ArvidJoung/Plasma_Generator/4_Transformer/20190302_190649.jpg

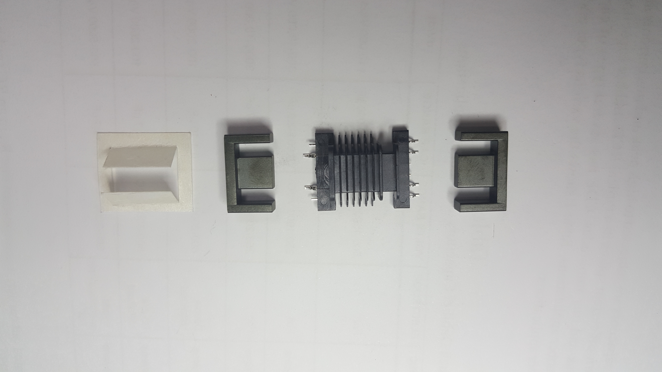
4_Transformer/20190302_190649.jpg
