ArvidJoung/Plasma_Generator/2_Micro_Plasma_Dispenser/0_DOC/20190724_ME Data/mpd_image-v2/asm-total-4.jpg

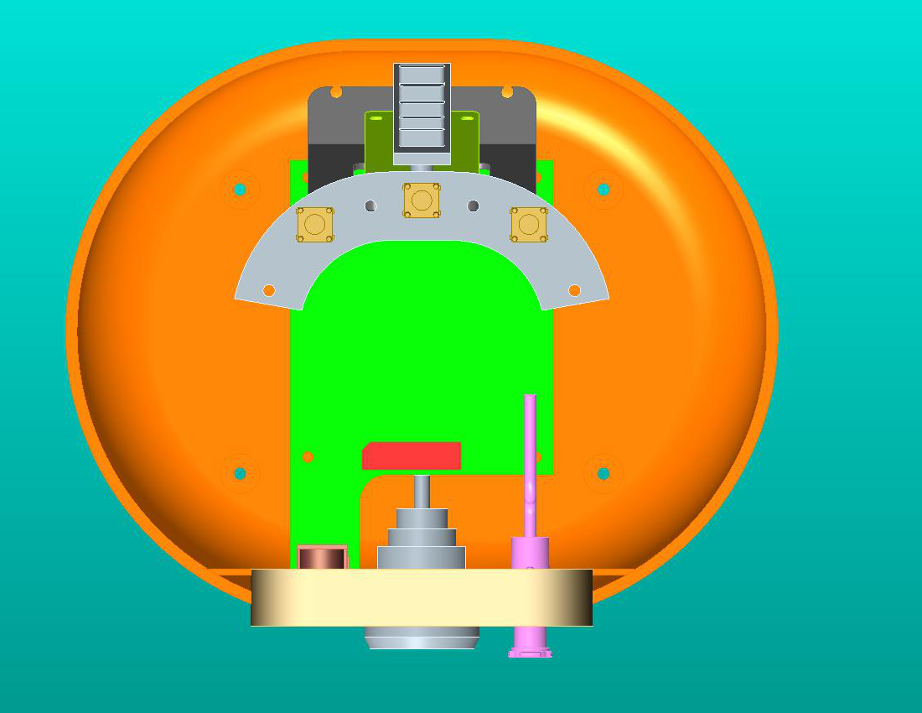
2_Micro_Plasma_Dispenser/0_DOC/20190724_ME Data/mpd_image-v2/asm-total-4.jpg
