ArvidJoung/Plasma_Generator/1_Plasma_Pipette/0_Block Diagram/Plasma_Pipette_Insulation Diagram.pptx

## 전기 절연도

USB 커넥터

+5V

충전 IC

배터리

+3.7V

+3.7V

전원 IC

+3.3V

CPU

Boost IC

+8V

신호발생부

+3.3V 70KHz Pulse

+8V 70KHz Pulse

트랜스

10kVpp

절연 케이스

전극부
