ArvidJoung/Plasma_Generator/1_Plasma_Pipette/4_Review data/ME Data/20180430/spec.pdf

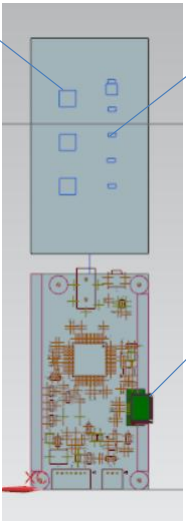
[picture p8: figure]

Dc power 위치 부탁 드립니다

마이크로 usb 위치는 맞나요?

태크 버튼

Led 5개

배터리 사이즈는 어느것으로 하는지요?

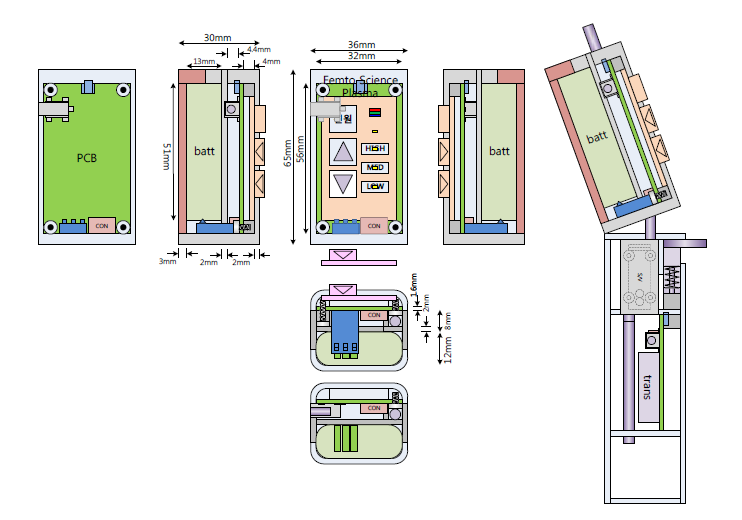
[picture p9: figure]

현 부품 배치 ?
