ArvidJoung/Plasma_Generator/0_DOC/20180206_Femto 요청자료/20180112_meeting agenda.pdf

협의 사항

M/E | Schematic V2.0으로 진행시 M/E part 반영 가능 여부 - Volume / Power key / Plasma key / Reset key
| M/E 구조에 따른 V2.0 수정 요청 사항 여부 - PCB size 및 외곽 모양 - 부품 높이
| Battery 형상 및 CON type 협의 - Battery size : L x W x H - Battery 용량 : size에 맞춰 결정해야 함 - Battery current : 1A 이상 - 사용품 사용시 사용품에 맞춰 CON 결정해야 함
H/W | RS-232 CON type 변경 여부 - D-Sub 9-pin : PCB size가 커짐 - USB Data line : RS-232 통신용 젠더 제작이 필요함
| 양산시 필요한 기능 - H/W version 관리 - D/L나 board test를 위한 Test Pin
F/W | RS-232 Control를 위한 Command list 필요
