ArvidJoung/Plasma_Generator/0_DOC/20180206_Femto 요청자료/Plasma_Gen_PCB 배치도_V2.0_20180107.pdf

## Top

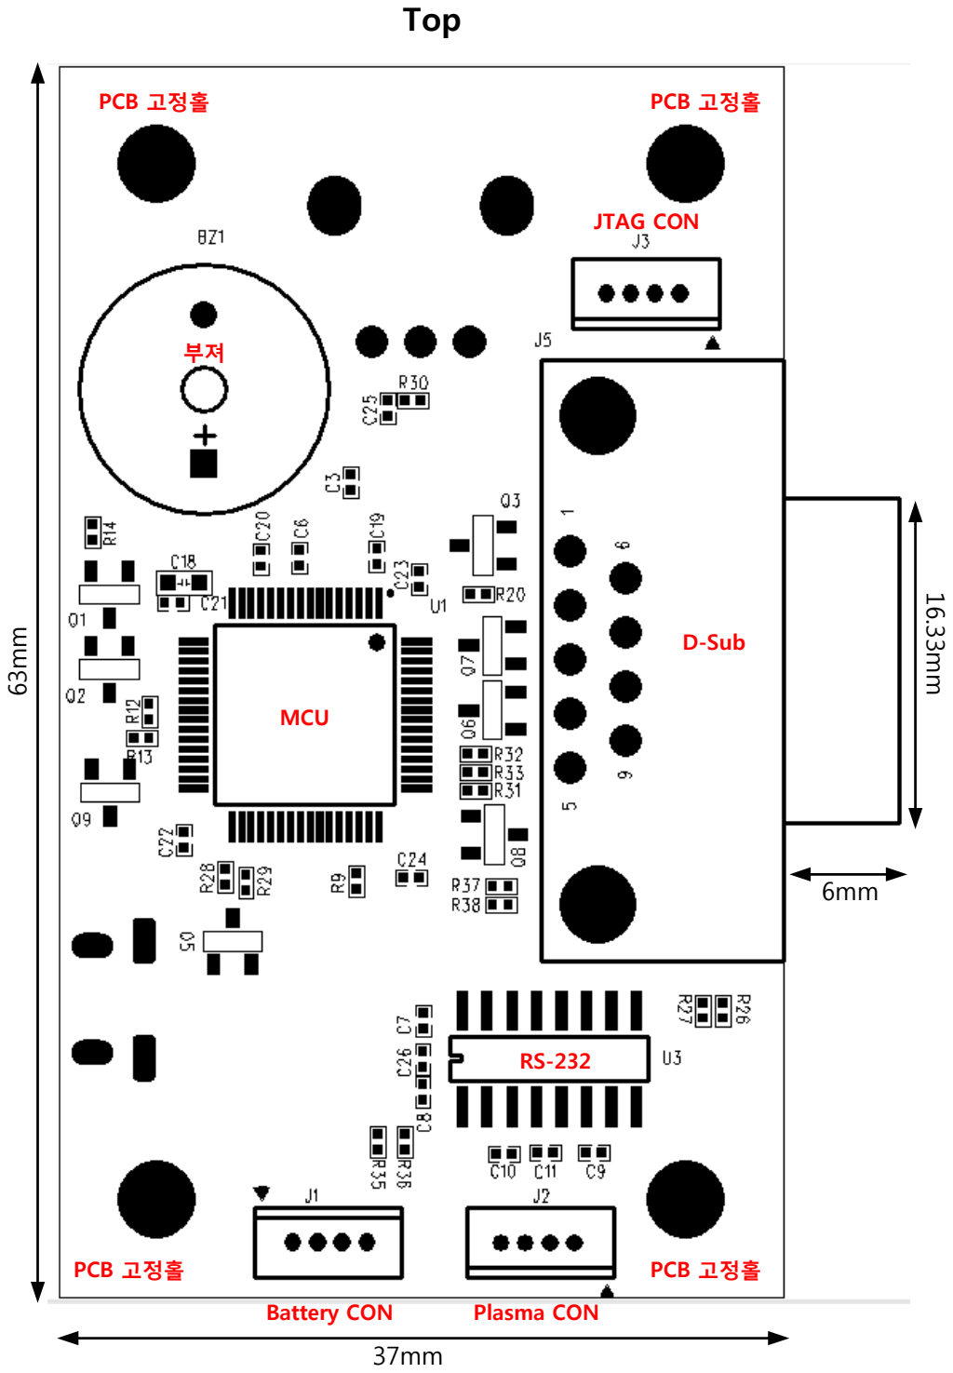
[picture p16: page 1]

MCU

부져

RS-232

D-Sub

Battery CON | Plasma CON

JTAG CON

PCB 고정홀 | PCB 고정홀
PCB 고정홀 | PCB 고정홀

37mm

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
## Bottom

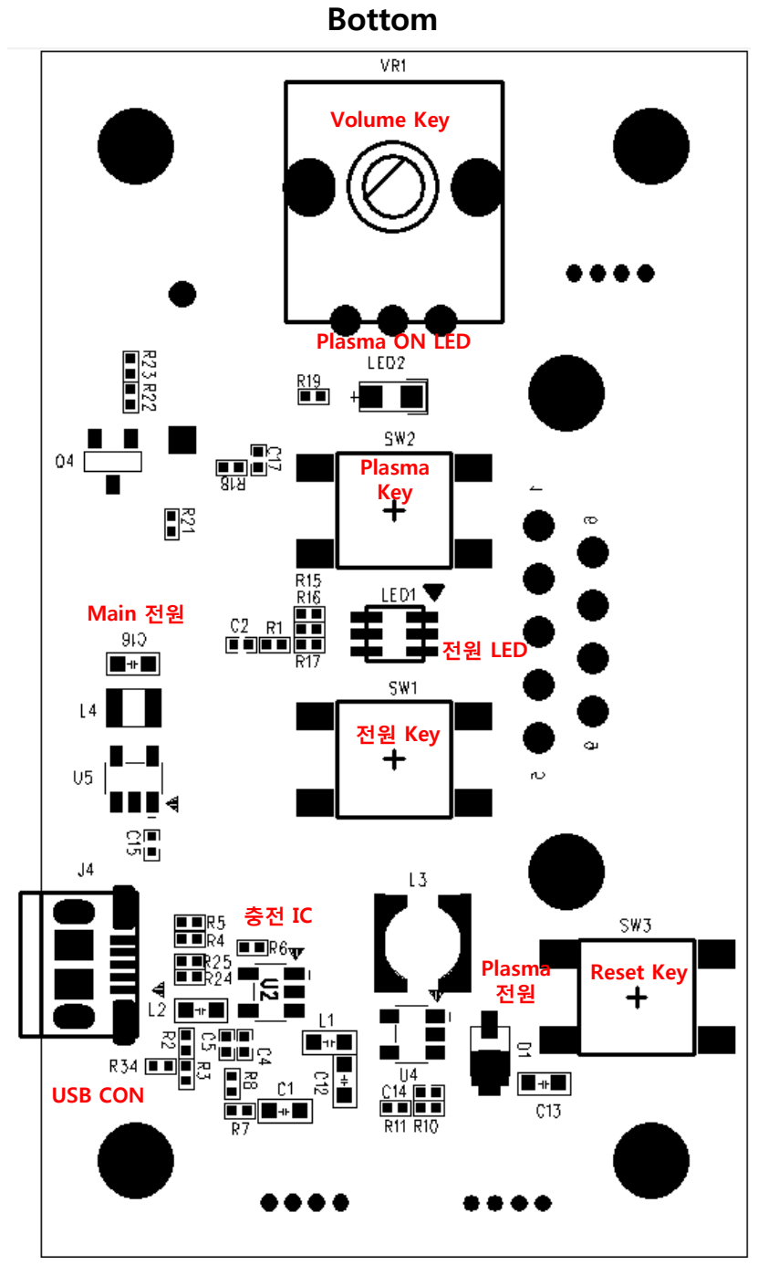
[picture p17: page 2]

Reset Key

전원 Key

전원 LED

Plasma
Key

Plasma ON LED

Volume Key

Main 전원

충전 IC

USB CON

Plasma
전원
