ArvidJoung/Plasma_Generator/0_DOC/20180206_Femto 요청자료/Plasma_Gen_부품 높이_20180111.pdf

# PCB 부품 높이 및 PCB 배치면

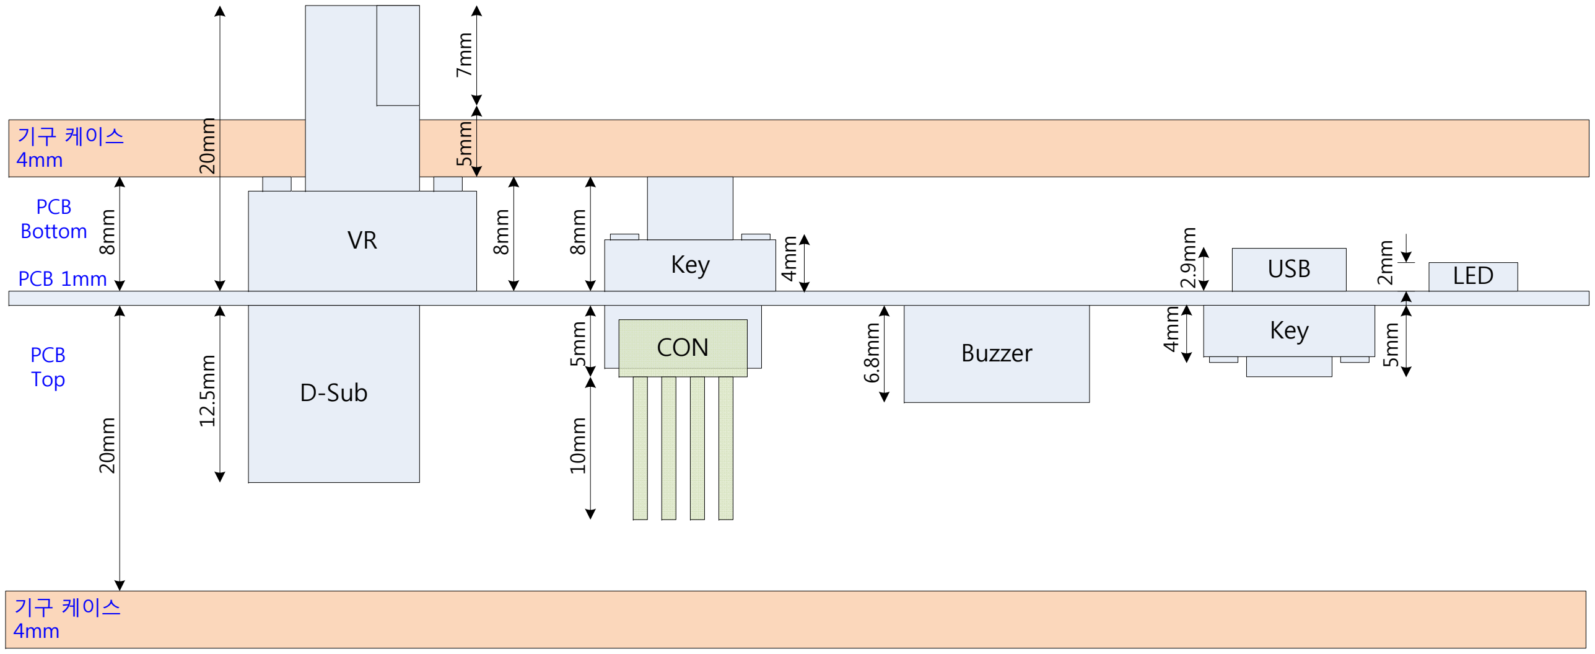
[picture p18: figure]
기구 케이스 4mm; D-Sub; USB; Key; CON; PCB 1mm; Buzzer; 2mm LED; PCB Bottom; PCB Top
