ArvidJoung/Plasma_Generator/0_Proto_type/4_Firmware/Source/doc/Plasma_Gen_배치도_20171207.pdf

## PCB 부품 높이 및 PCB 배치면

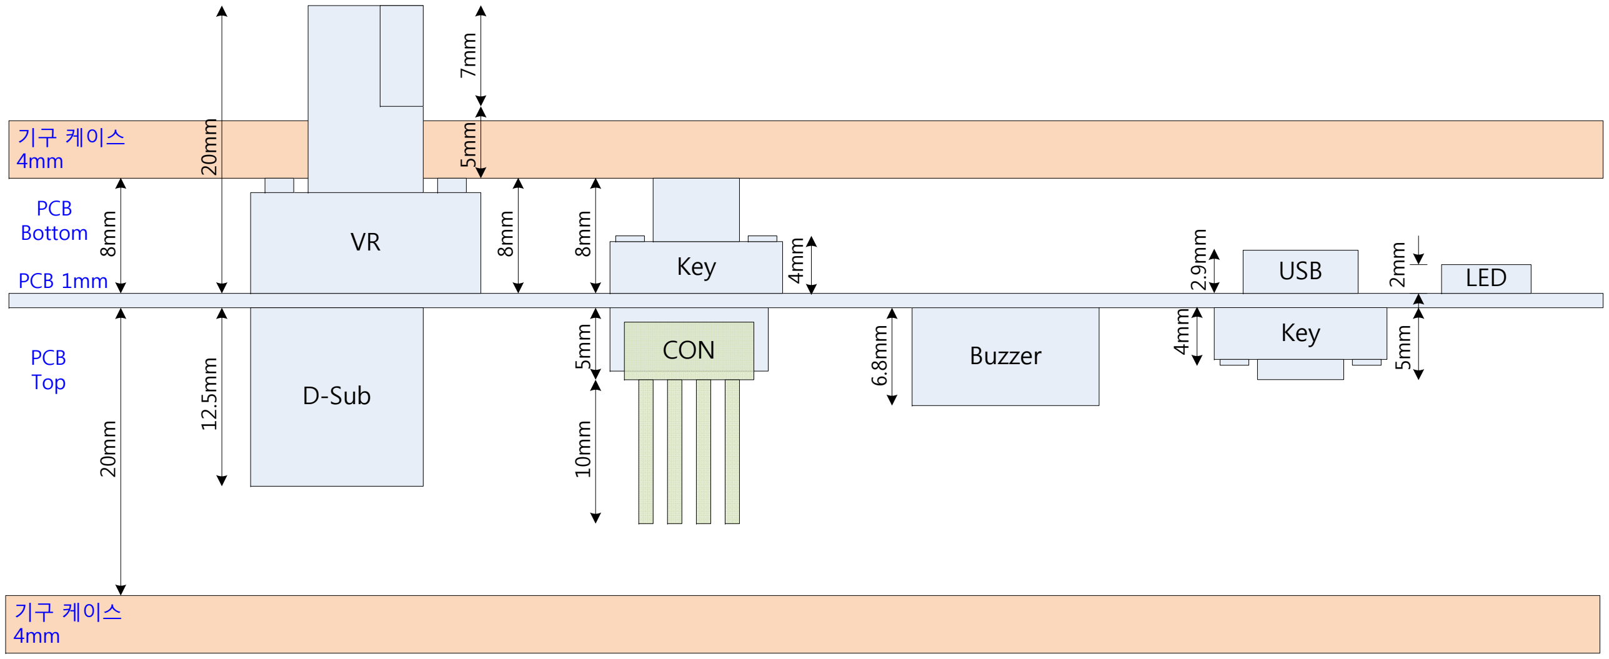
[picture p19: figure]
기구 케이스 4mm; D-Sub; USB; Key; CON; PCB 1mm; Buzzer; 2mm LED; PCB Bottom; PCB Top

## Top

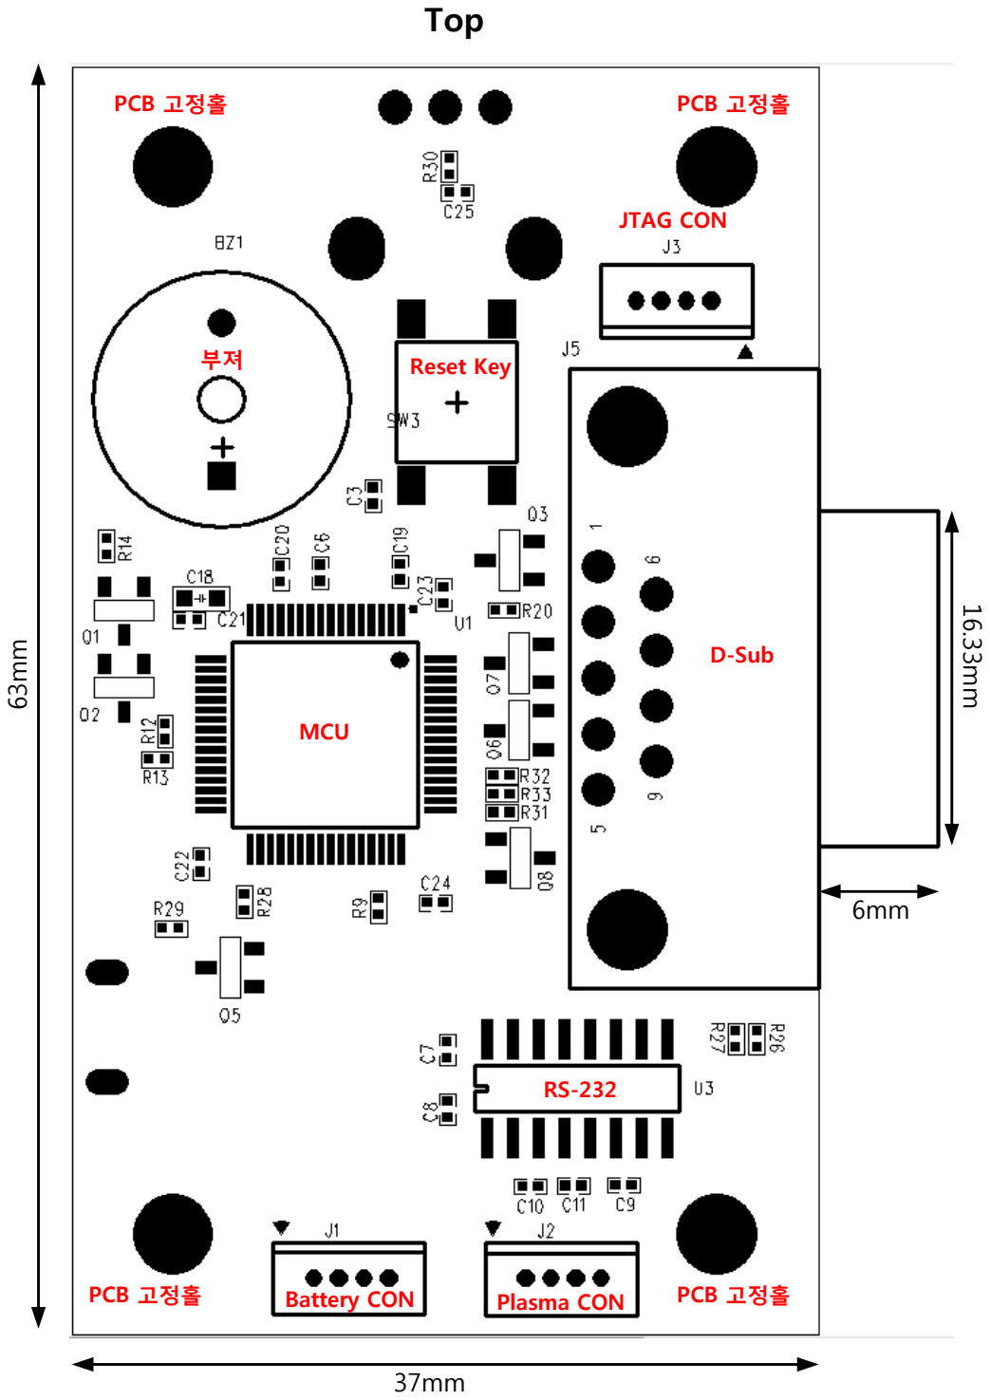
[picture p20: page 2]

MCU

부져

RS-232

D-Sub

Battery CON | Plasma CON

JTAG CON

Reset Key

PCB 고정홀 | PCB 고정홀
PCB 고정홀 | PCB 고정홀

37mm

63mm

6mm

16.33mm

## Bottom

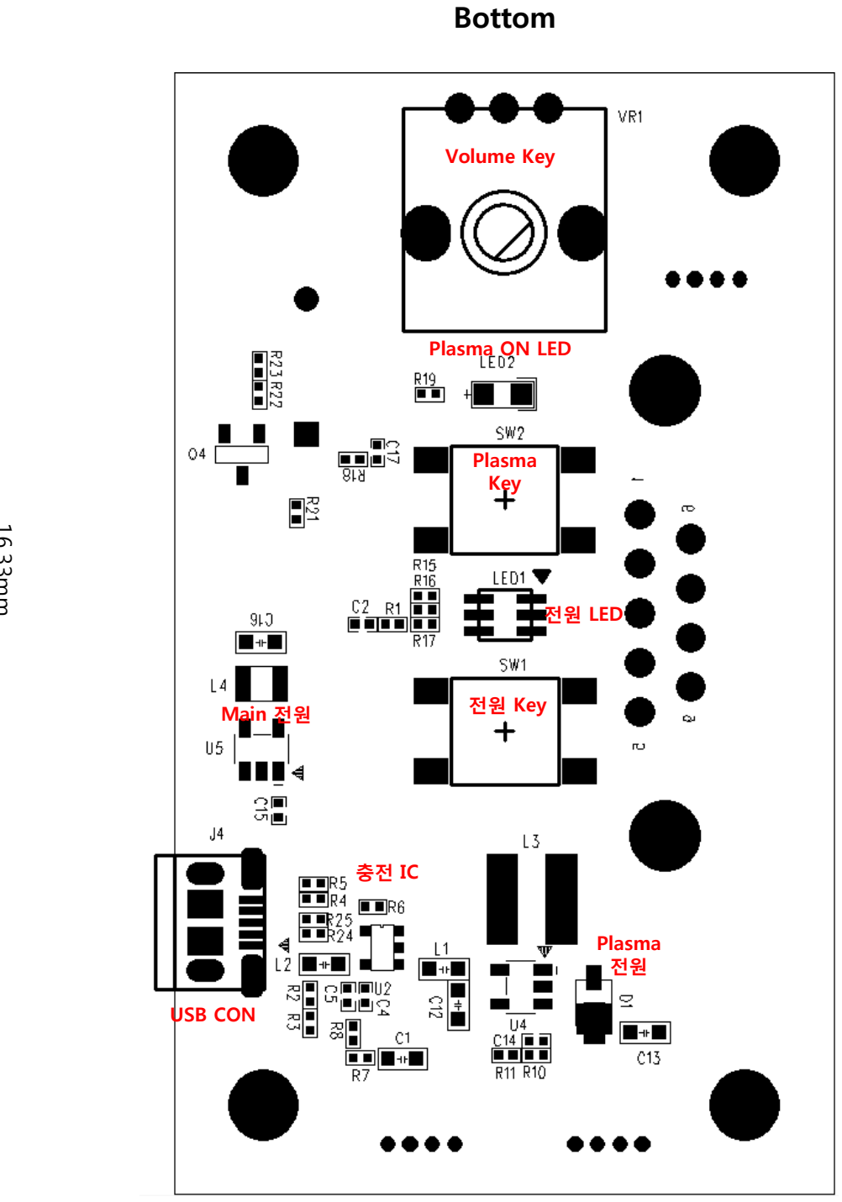
[picture p21: page 3]

전원 Key

전원 LED

Plasma
Key

Plasma ON LED

Volume Key

Main 전원

충전 IC

USB CON

Plasma
전원
