ArvidJoung/Plasma_Generator/2_Micro_Plasma_Dispenser/0_Design data/20190114/MPD design-0114 (디자인 2차 3D 프린팅).pptx

Design proposal
2019.01.14
MPD design

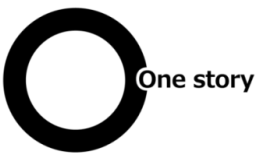
[picture p22: figure]

## Slide 2

MPD design - Q

## Slide 3

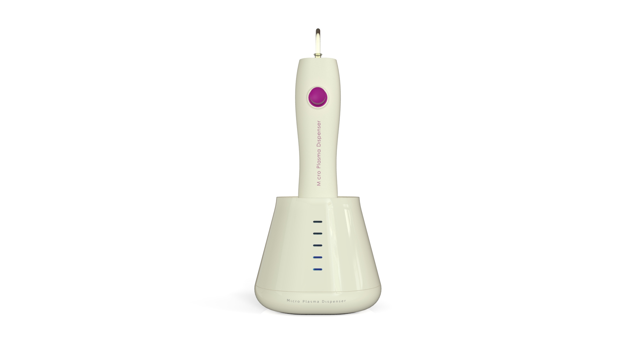
[picture p23: figure]

## Slide 4

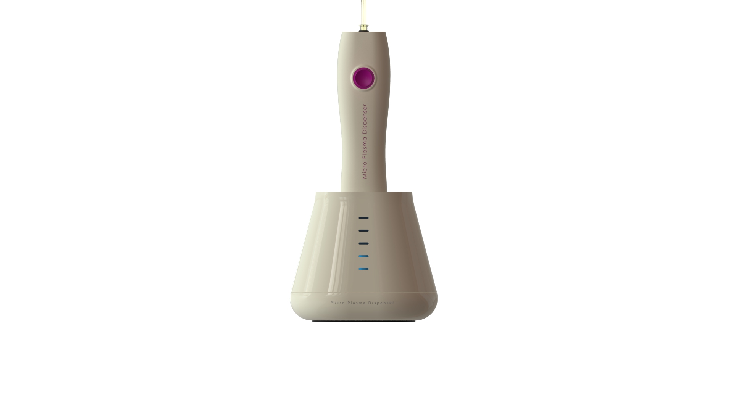
[picture p24: figure]

## Slide 5

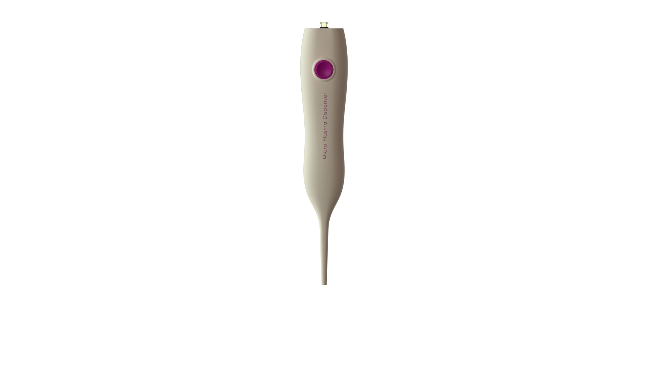
[picture p25: figure]

## Slide 6

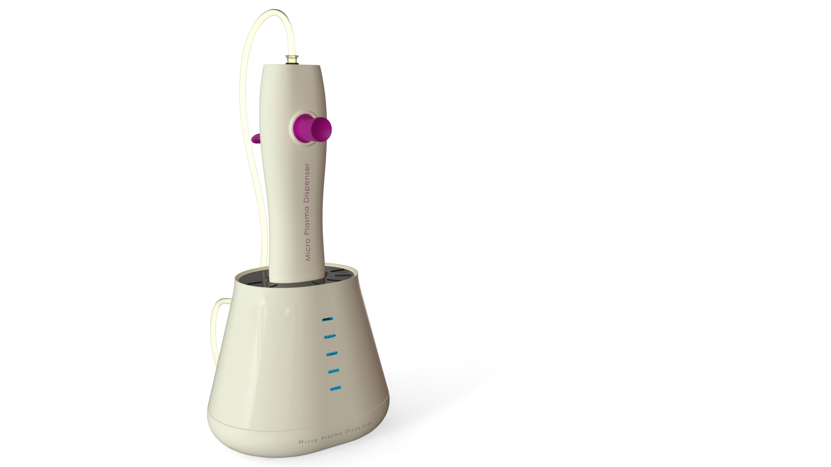
[picture p26: figure]

## Slide 7

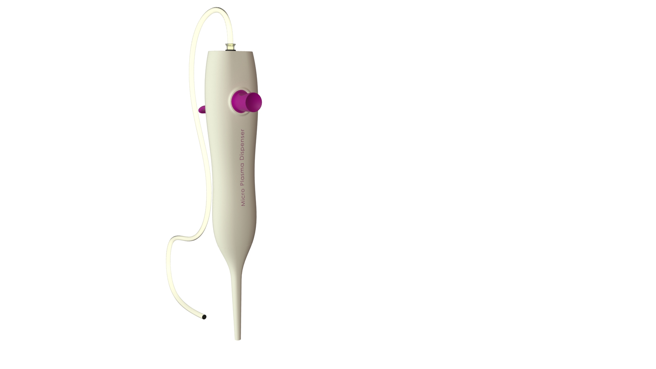
[picture p27: figure]

## Slide 8

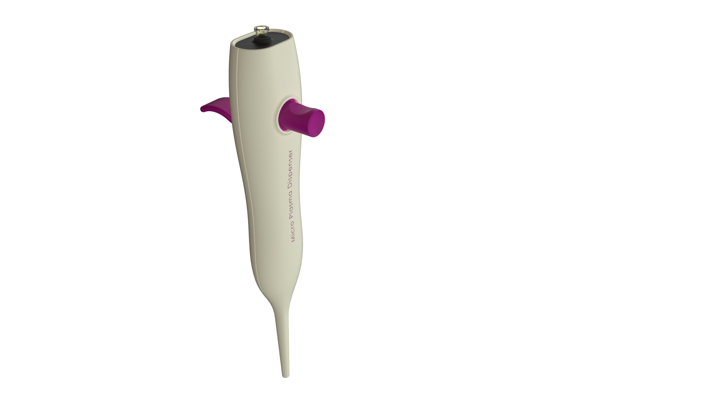
[picture p28: figure]

## Slide 9

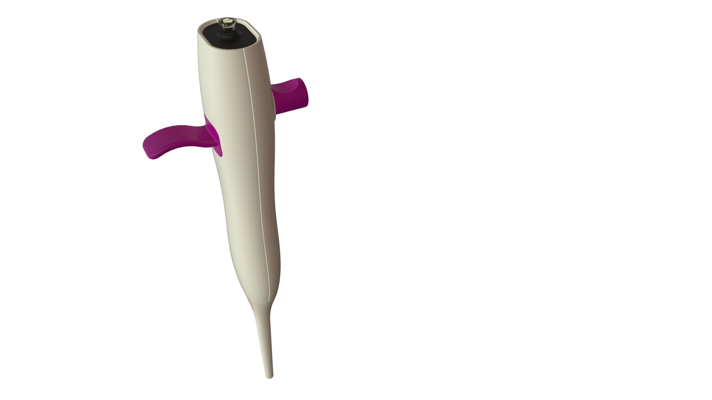
[picture p29: figure]

## Slide 10

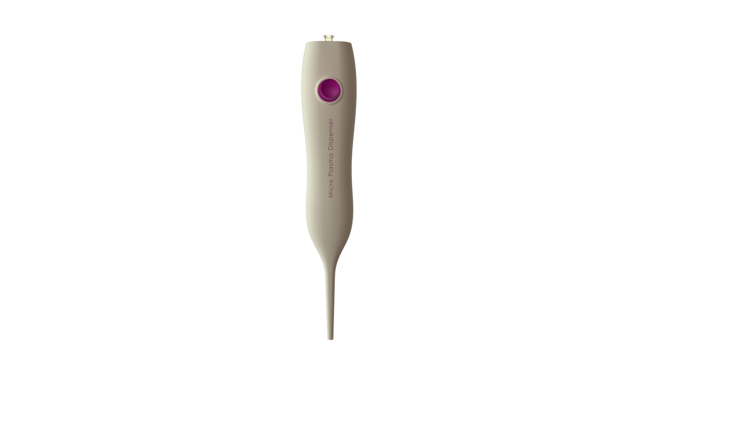
[picture p30: figure]

## Slide 11

T H A N K Y O U
