ArvidJoung/Plasma_Generator/0_Proto_type/4_Firmware/Source/doc/문서1.docx

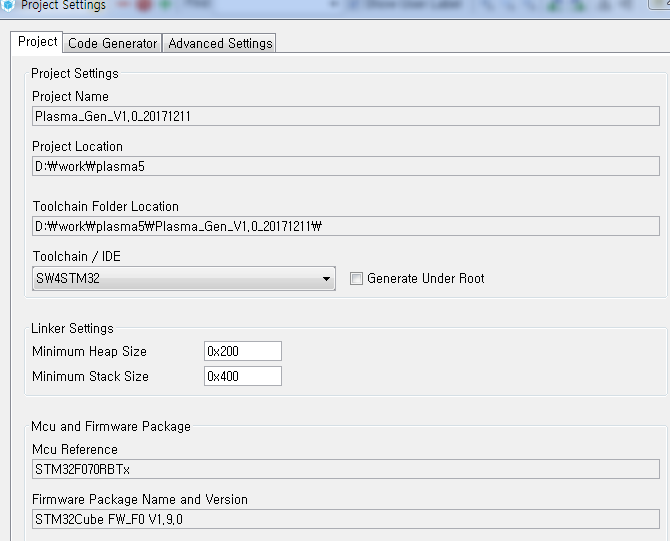
[picture p31: figure]
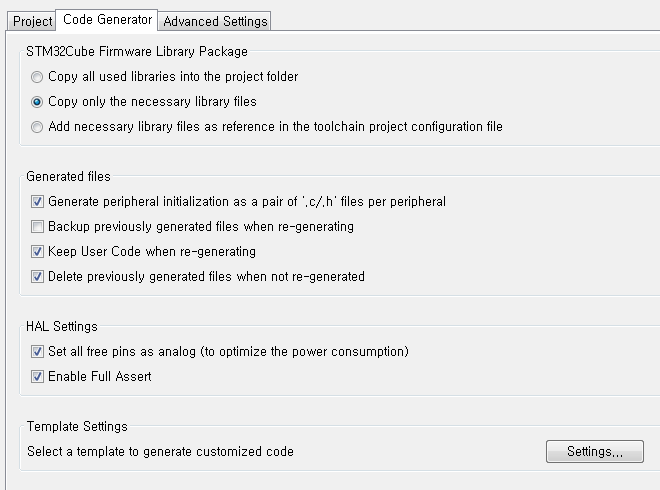
[picture p32: figure]
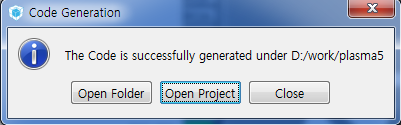
[picture p33: figure]
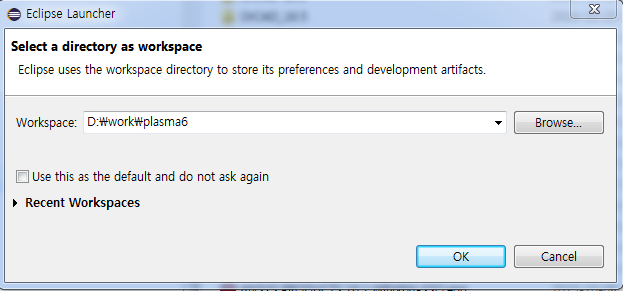
[picture p34: figure]
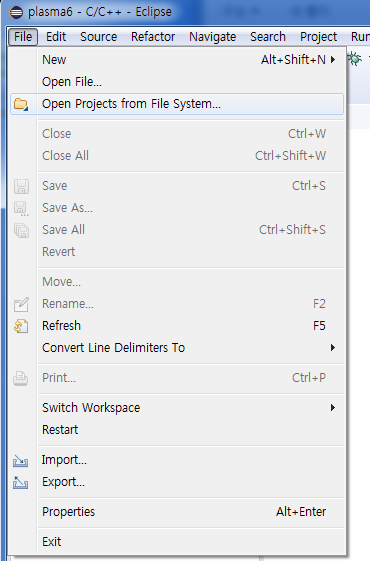
[picture p35: figure]
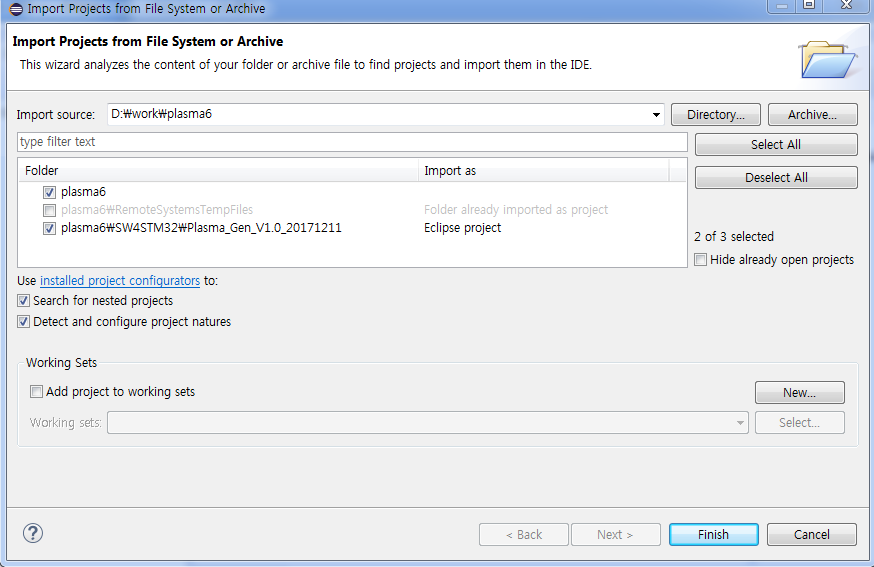
[picture p36: figure]
