ArvidJoung/Plasma_Generator/1_Plasma_Pipette/1_Schematic/V2.0/ME/20180725_Trans PCB 확장/ay_total_plasma.pdf

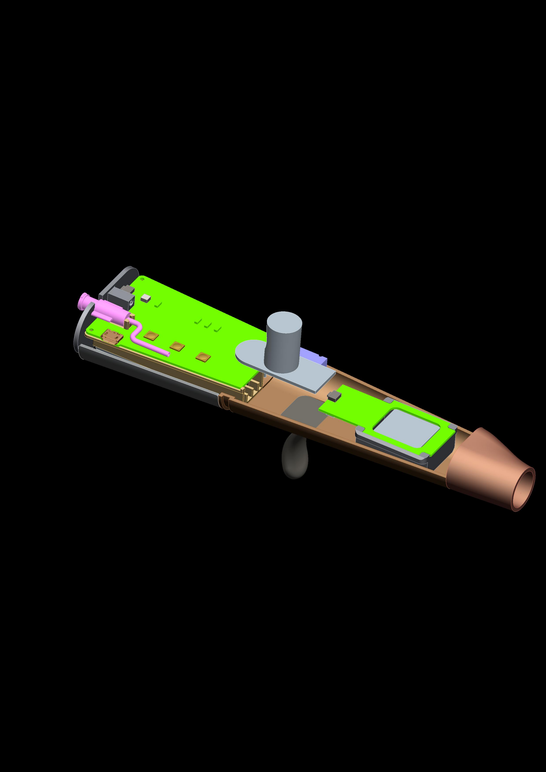
[picture p37: page 1]
