ArvidJoung/Plasma_Generator/0_DOC/0_Femto Data/사업자등록증 _동탄.pdf

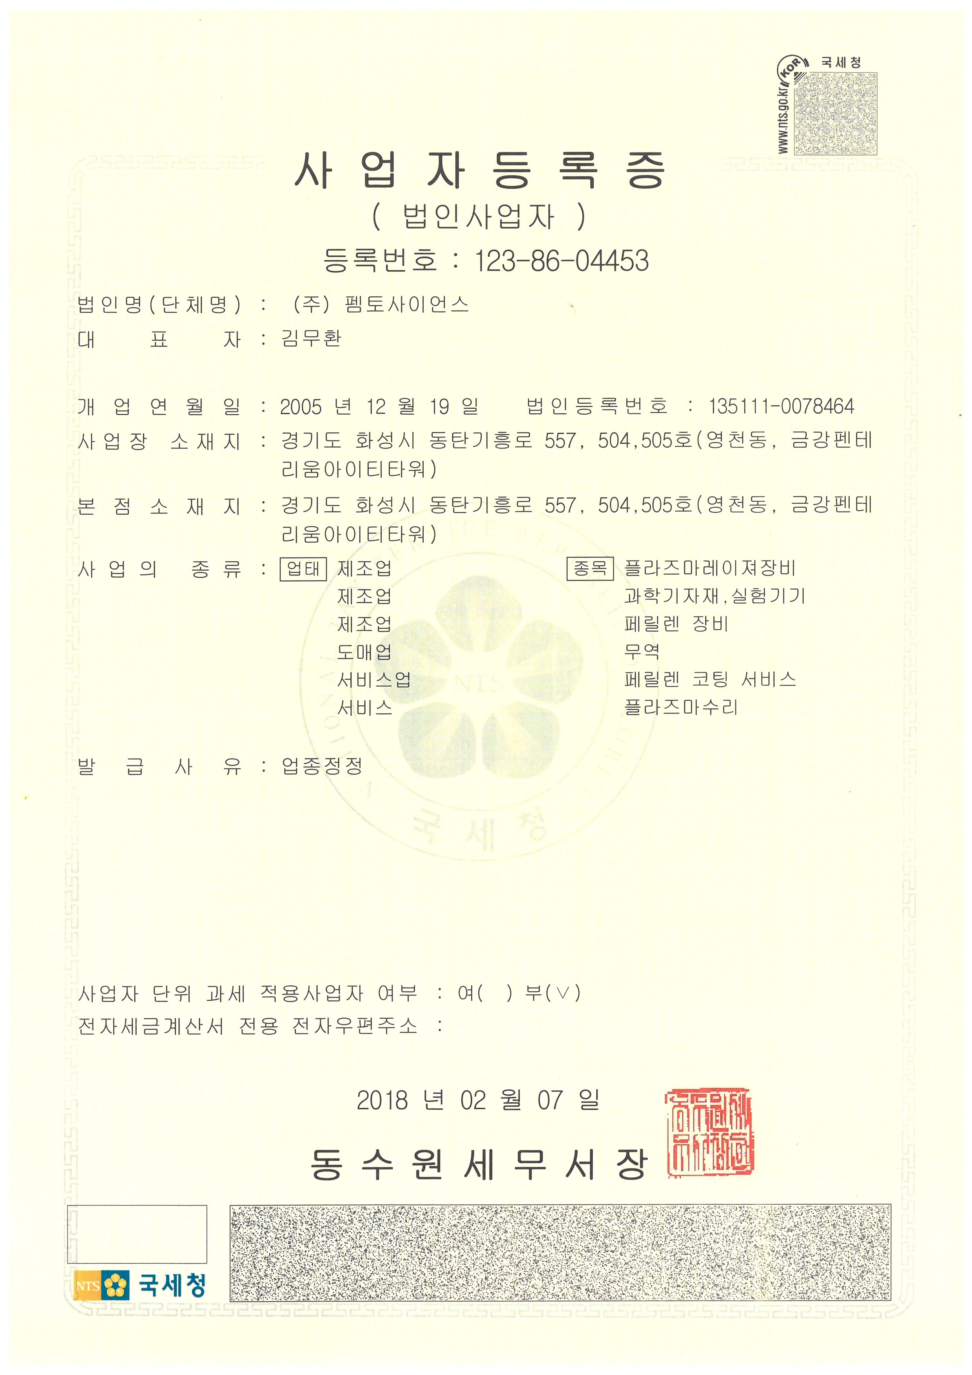
[picture p38: page 1]
