ArvidJoung/Plasma_Generator/1_Plasma_Pipette/1_Schematic/V2.0/ME/20180730_Battery 2D/Pipette Battery 도면 수정.png

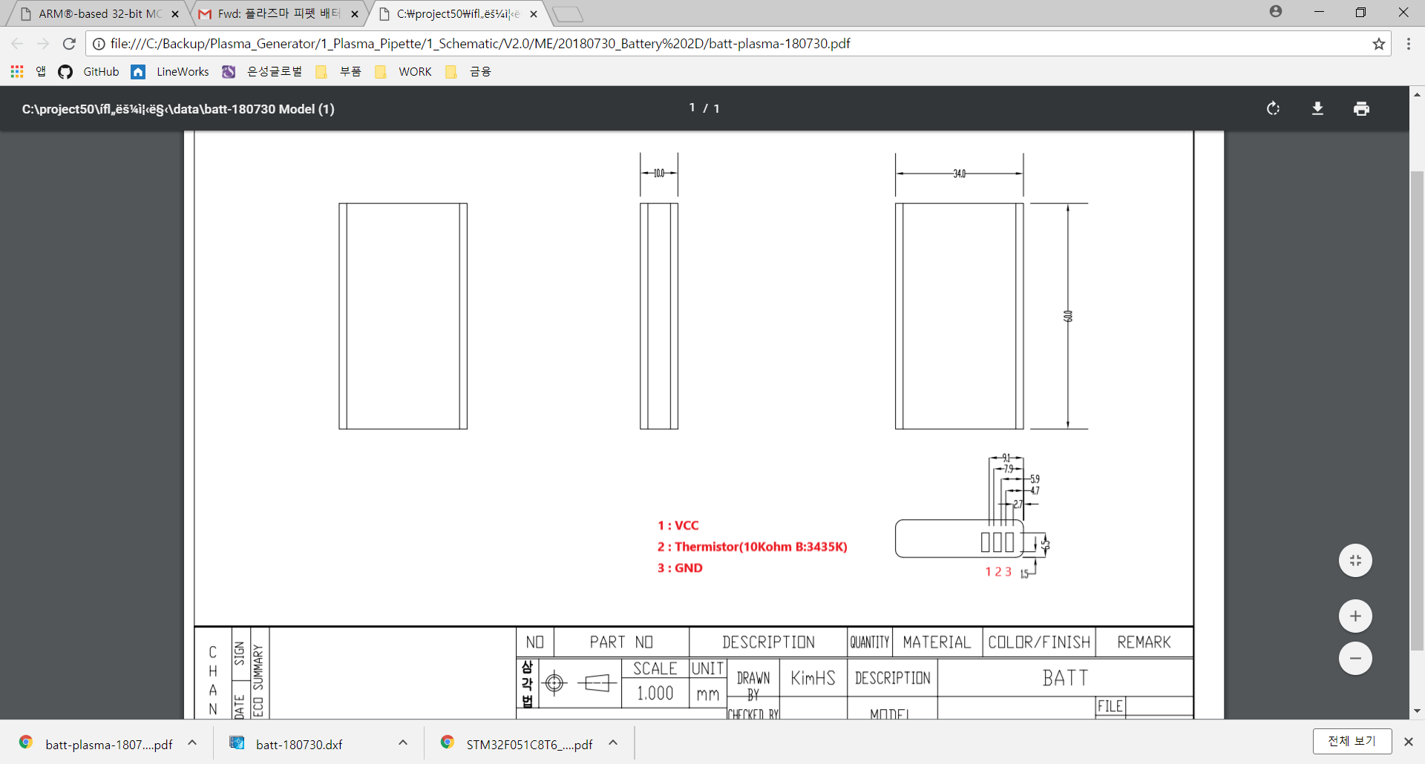
1_Plasma_Pipette/1_Schematic/V2.0/ME/20180730_Battery 2D/Pipette Battery 도면 수정.png
