ArvidJoung/Plasma_Generator/1_Plasma_Pipette/1_Schematic/V2.0_Type2/51021 커넥터.png

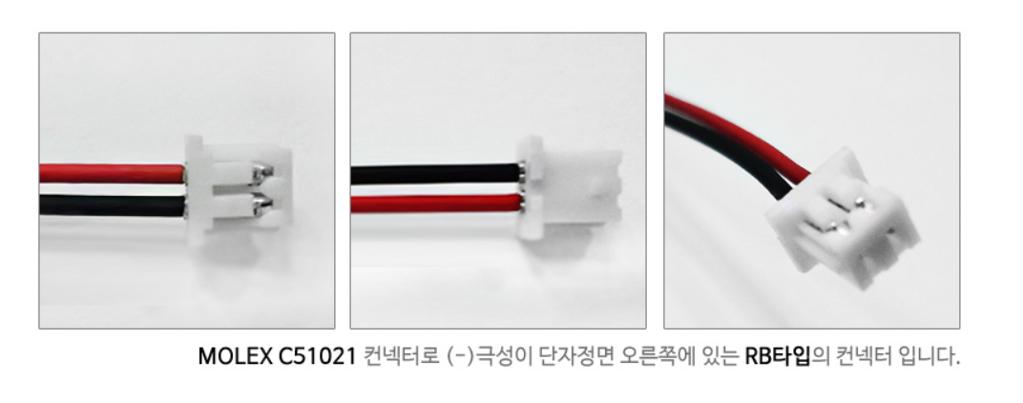
1_Plasma_Pipette/1_Schematic/V2.0_Type2/51021 커넥터.png
