ArvidJoung/Plasma_Generator/1_Plasma_Pipette/2_Datasheet/Battery/배터리 .png

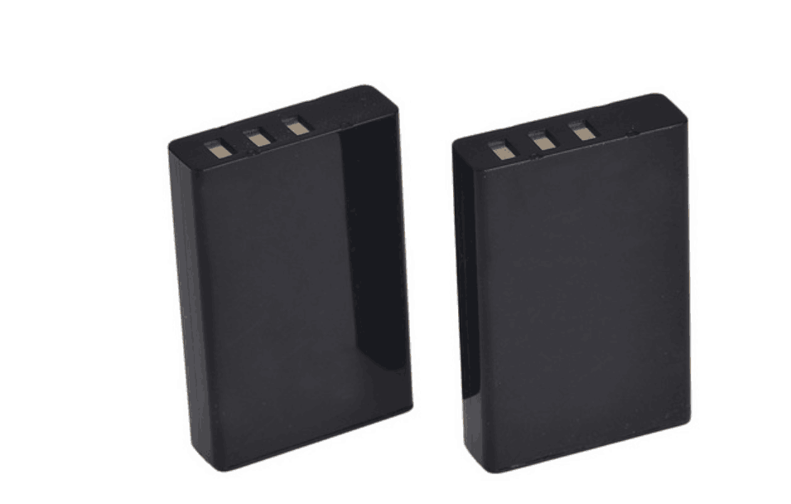
1_Plasma_Pipette/2_Datasheet/Battery/배터리 .png
