ArvidJoung/Plasma_Generator/1_Plasma_Pipette/2_Datasheet/Main V2.0_Type2/DC-011C(SMD)_DC Power Jack.jpg

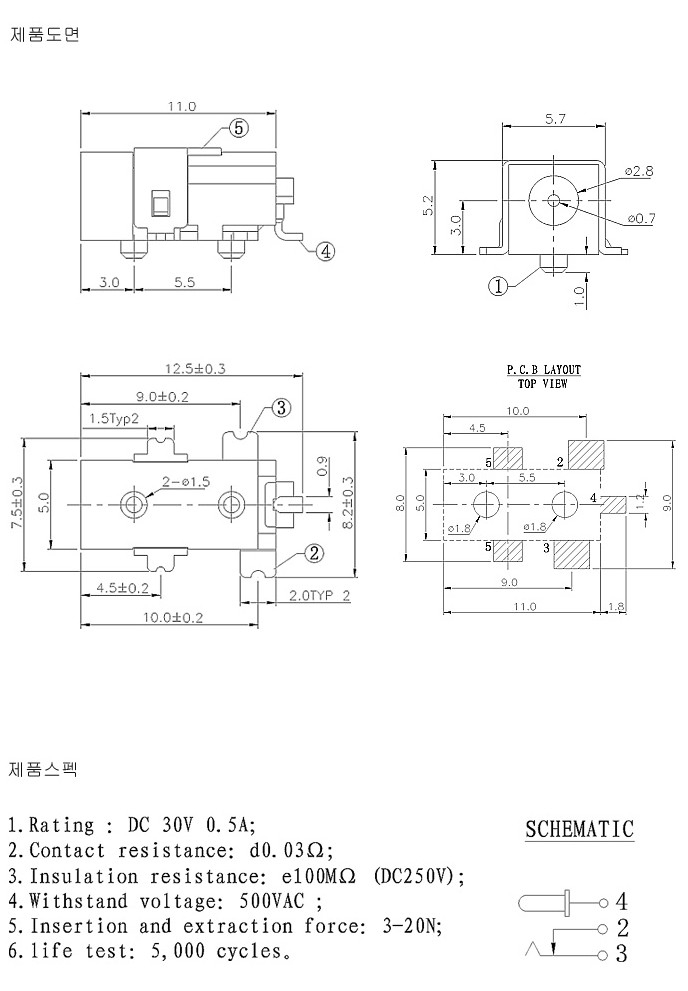
1_Plasma_Pipette/2_Datasheet/Main V2.0_Type2/DC-011C(SMD)_DC Power Jack.jpg
