ArvidJoung/Plasma_Generator/4_Transformer/2_Datasheet/Current/Atest_a1.jpg

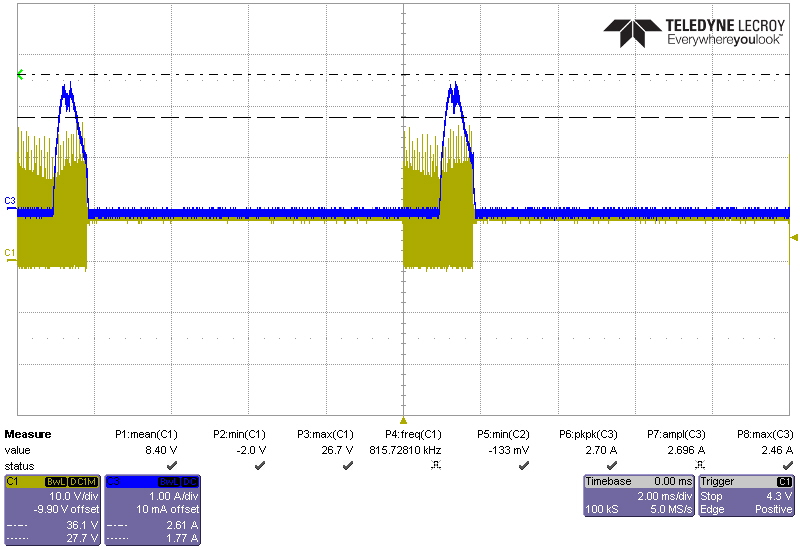
4_Transformer/2_Datasheet/Current/Atest_a1.jpg
