ArvidJoung/Plasma_Generator/4_Transformer/2_Datasheet/Current/Current Probe 역삽/Level 4.jpg

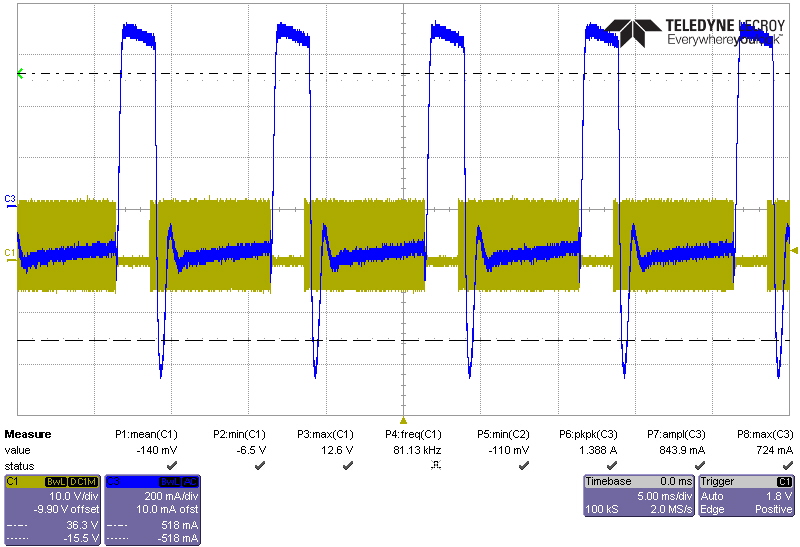
4_Transformer/2_Datasheet/Current/Current Probe 역삽/Level 4.jpg
