ArvidJoung/Plasma_Generator/4_Transformer/2_Datasheet/Current/Level2.jpg

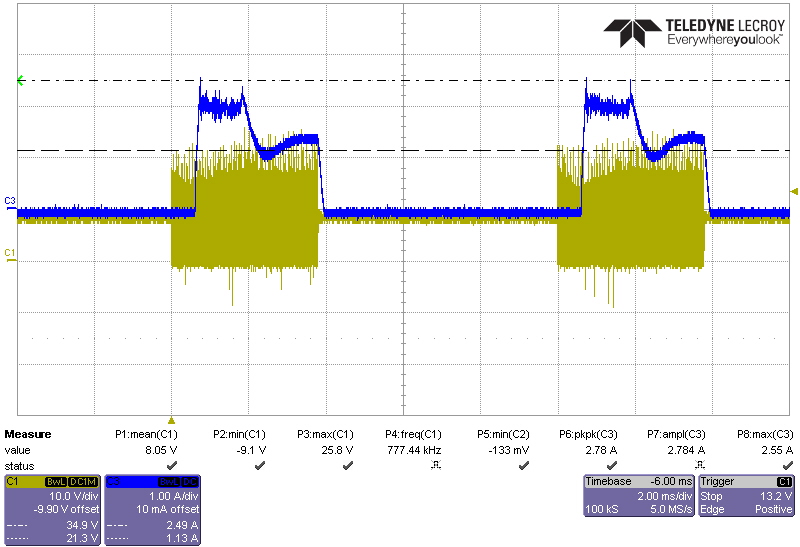
4_Transformer/2_Datasheet/Current/Level2.jpg
