ArvidJoung/Plasma_Generator/4_Transformer/2_Datasheet/Current/Level 1 Trans FER Vdrain.jpg

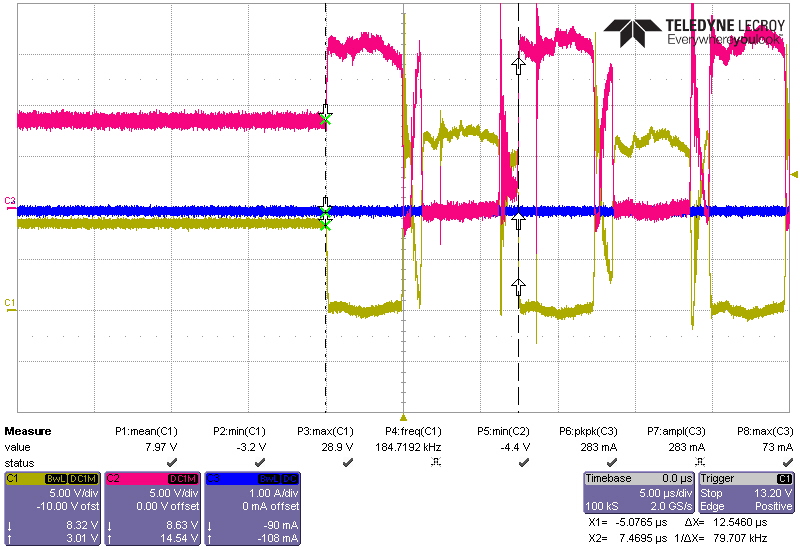
4_Transformer/2_Datasheet/Current/Level 1 Trans FER Vdrain.jpg
