ArvidJoung/Plasma_Generator/4_Transformer/20190302_180247.jpg

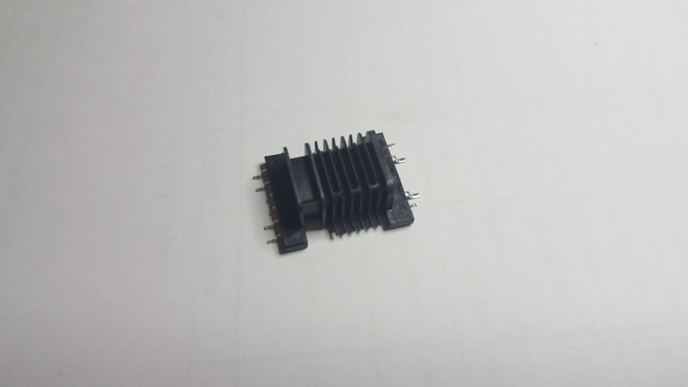
4_Transformer/20190302_180247.jpg
