ArvidJoung/Plasma_Generator/퇴사자/임금체불 진정신고서_화면캡쳐.gif

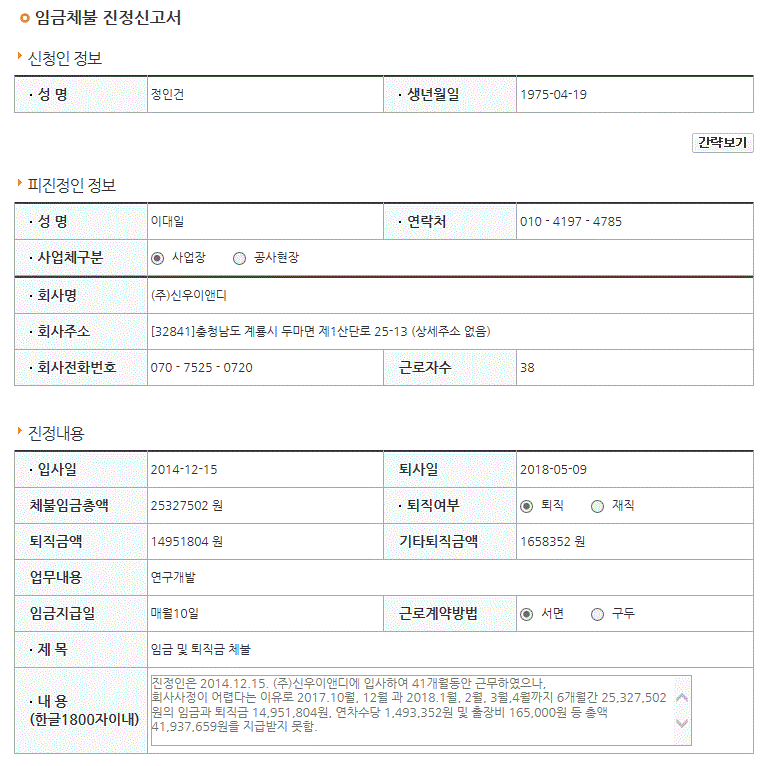
퇴사자/임금체불 진정신고서_화면캡쳐.gif
