ArvidJoung/Plasma_Generator/0_MP4 Data/Plasma Pipette V5.0 Main Part list_20190521.xlsx

Plasma Pipette Main V3.0 Part List
 | Battery Type : w/o thermistor
 | R1, C2 : w/ thermistor type에 사용
No | SMD | Value | Vendor_PN | Desc | Vendor | Q'ty | Reference No. | PCB Decal | 비고
1 | YES | 330pF | GRM155R71H331KA01D | CAP CER 330pF 50V 10% X7R 0402 | MURATA | 1 | C14 | C-1005
2 | YES | 470pF | GRM1555C1H471JA01D | CAP CER 470pF 50V 5% C0G 0402 | MURATA | 1 | C4 | C-1005
3 | YES | 0.1uF | GRM155R71C104KA88D | CAP CER 0.1uF 16V 10% X7R 0402 | MURATA | 10 | C3,C6,C7,C8,C19,C20,C21,C22,C23,C24 | C-1005
4 | YES | 4.7uF | GRM155R61A475KEAAD | CAP CER 4.7uF 10V 10% X5R 0402 | MURATA | 2 | C5,C15 | C-1005
5 | YES | 4.7uF | GRM188R61C475KAAJD | CAP CER 4.7UF 16V 10% X5R 0603 | MURATA | 1 | C9 | C-1608
6 | YES | 10uF | GRM188R61E106MA73D | CAP CER 10uF 25V 20% X5R 0603 | MURATA | 4 | C1,C13,C16,C18 | C-1608
7 | YES | 22uF | GRM188R60J226MEA0 | CAP CER 22uF 6.3V 20% X5R 0603 | MURATA | 1 | C12 | C-1608
8 | YES | 0 | WR04X000PTL | RES SMD 0.0 OHM JUMPER 0402 | WALSIN | 6 | R18,R24,R25,R27,R30,R36 | R-1005
9 |  | 100 | WR04X1000FTL | RES SMD 100 OHM 1% 1/16W 0402 | WALSIN | 1 | R31 | R-1005
10 | YES | 180 | WR04X1800FTL | RES SMD 180 OHM 1% 1/16W 0402 | WALSIN | 3 | R21,R22,R23 | R-1005
11 | YES | 430 | WR04X4300FTL | RES SMD 430 OHM 1% 1/16W 0402 | WALSIN | 4 | R15,R16,R17,R29 | R-1005
12 | YES | 470 | WR04X4700FTL | RES SMD 470 OHM 1% 1/16W 0402 | WALSIN | 1 | R19 | R-1005
13 | YES | 2K | WR04X2001FTL | RES SMD 2K OHM 1% 1/16W 0402 | WALSIN | 1 | R6 | R-1005
14 | YES | 5.1K | WR04X5101FTL | RES SMD 5.1K OHM 1% 1/16W 0402 | WALSIN | 1 | R2 | R-1005
15 | YES | 10K | WR04X1002FTL | RES SMD 10K OHM 1% 1/16W 0402 | WALSIN | 13 | R3,R7,R9,R11,R12,R13,R14,R20,R26,R28, R32,R33,R34 | R-1005
16 | YES | 30K | WR04X3002FTL | RES SMD 30K OHM 1% 1/16W 0402 | WALSIN | 1 | R8 | R-1005
17 | YES | 56K | WR04X5602FTL | RES SMD 56K OHM 1% 1/16W 0402 | WALSIN | 1 | R10 | R-1005
18 | YES | F0603E2R50FSTR | F0603E2R50FSTR | FUSE BOARD MOUNT 2.5A 32VDC 0603 | AVX | 1 | L2 | F-1608
19 | YES | MSS5131-153ML | MSS5131-153ML | INDUCTOR, PWR, 15UH, 1.5A, 20%,32MHZ | Coilcraft | 1 | L3 | MSS5131-153ML
20 | YES | LQM2HPZ2R2MG0 | LQM2HPZ2R2MG0 | FIXED IND 2.2UH 1.3A 80 MOHM SMD, SRF 40MHz | Murata | 1 | L4 | LQM2HPZ2R2MG0
21 | YES | ASMT-YTD2-0BB02 | ASMT-YTD2-0BB02 | 3 color type LED 6-pin, TOP View, R745mcd, G1600mcd, B380mcd | Avago | 1 | LED1 | ASMT-YTD2-0BB02
22 | YES | 17-21/W1D-ANPHY/3T | 17-21/W1D-ANPHY/3T | Backlight LED SMD 2012 White | EVERLIGHT | 1 | LED2 | LED-2012
23 | YES | 19-217/W1D-APQHY/3T | 19-217/W1D-APQHY/3T | Backlight LED SMD 1608 White | EVERLIGHT | 3 | LED3,LED4,LED5 | LED-1608
24 | YES | SS1020 | SS1020 | 1.0 Amp 20 Volt Schottky DIODE | KD | 1 | D1 | SS1020 | 부품 변경
25 | YES | SMBJ12CA | SMBJ12CA | bi-directional Vr=12V 600W TVS_diode | KD | 1 | D2 | SMBJ12CA
26 | YES | BZT52C5V1S | BZT52C5V1S | DIODE, ZENER, 5.1V, 0.2W, SOD-323 | Diodes | 3 | D3,D4,D5 | BZT52C5V1S
27 |  | 1N4148WS | 1N4148WS | Small Signal Fast Switching Diode | VISHAY | 1 | D6 | 1N4148WS
28 | YES | PMBT2222 | PMBT2222 | Bipolar Transistors - BJT NPN SW 600MA 40V | NXP | 4 | Q1,Q2,Q5,Q9 | PMBT2222
29 | YES | FTK2306 | FTK2306 | FET Vgs 2.5V, Rds 50mOhm | First Silicon | 1 | Q3 | SOT23
30 | YES | STM32F070RBT6 | STM32F070RBT6 | ARM Cortex-M0 Value line, 128 Kbytes Flash, 48 MHz CPU, SMD/SMT | STMicroelectronics | 1 | U1 | STM32F070RBT6
31 | YES | MCP73831T-2ACI/OT | MCP73831T-2ACI/OT | Charge management controller | Microchip | 1 | U2 | MCP73831T_2ACIOT
32 | YES | LM2735XSD | LM2735XSD | 1.6-MHz Space-Efficient Boost and SEPIC DC-DC Regulator 24V 2.1A | TI | 1 | U4 | WSON 6-pin
33 | YES | LM3671MF-3.3 | LM3671MF-3.3 | 2-MHz, 600-mA Step-Down DC-DC Converter | TI | 1 | U5 | LM3671MF-3.3
34 | YES | TPS3801L30 | TPS3801L30 | Reset IC Vth=2.64V Delay=200msec | TI | 1 | U6 | TPS3801L30
35 | YES | MOLEX5268-02P | MOLEX5268-02P | 2.5mm Pitch DIP CON, Right Angle 2-Pin | MOLEX | 2 | BATT,J2 | MOLEX5268-02P
36 | YES | 053048-0610 | 053048-0610 | 1.25mm Pitch DIP CON, Right Angle 6-Pin | Molex | 1 | J3 | 053048-0610
37 | YES | HI05-AG0272 | HI05-AG0272 | Micro USB type-B 5PIN SOCKET | HYUP JIN | 1 | J4 | HI05-AG0272
38 | YES | CTT-1139P1 | CTT-1139P1 | Tack S/W | CT Electronics | 1 | SW1 | CTT_1139P1
39 | YES | SKRMABE010 | SKRMABE010 | Tack S/W | ALPS | 3 | DOWN,UP,POWER | SKRMABE010 | Vendor 오기 수정
40 | NO | - | - | PCB Assy Hole |  | 2 | P1,P2 | HOLE3.0
41 | NO | 4.7uF | GRM155R61A475KEAAD | CAP CER 4.7uF 10V 10% X5R 0402 | MURATA | 1 | C2 | C-1005
42 | NO | 10K | WR04X1002FTL | RES SMD 10K OHM 1% 1/16W 0402 | WALSIN | 1 | R1 | R-1005
43 | NO | NC | NC |  | WALSIN | 7 | R4,R5,R35,R40,R41,C10,J1 | R-1005
