ArvidJoung/Plasma_Generator/0_DOC/Femto 구매 list.xlsx

Sheet: 장비
오실로스코프
No | PN | Vendor | BW[MHz] | Sampling[GS/s] | Channel | Vin | Probe | Agency | Tel | Cost |  | 새제품
1 | TDS2012C | 텍트로닉스 | 100 | 2 | 2 | 300V | 2 | 테스트박스 | 070-5089-0948 | 1355000 | Auction | 2441500
2 | TDS2014 | 텍트로닉스 | 100 | 1 | 4 | 300V | P6100 4ea | 테스트박스 | 070-5089-0948 | 1230000 | Auction
3 | TDS3052 | 텍트로닉스 | 500 | 5 | 2 | 150Vrms | P6500 2ea | 한맥하이텍시스템 | 02-2611-7985 | 1950000 | Auction
하네스 공구
 | 압착기 P-707 | HOZAN | P007150257

Sheet: 0312
LF MCU
 |  |  |  |  |  |  |  |  | Set 수량
 |  |  |  |  |  |  | 구매 |  | 5
No | Type | P_value | Vendor | V_Desc | Q'ty | Unit Cost | Cost | Cost | 필요수량 | MOQ | 구매수량 | 구매금액 | ICBanQ
11 | LED-1608 | 19-21/R6C-AP1Q2/3T | EVERLIGHT | Backlight LED SMD 1608 Red | 2 | 20 | 20 | 40 | 10 | 10 | 10 | 200 | P005609821 | Control MCU에서도 사용 : 2배 구매
10 | LED-1608 | 19-217/W1D-APQHY/3T | EVERLIGHT | Backlight LED SMD 1608 White | 2 | 30 | 30 | 60 | 10 | 10 | 10 | 300 | P005609820 | Control MCU에서도 사용 : 2배 구매
12 | LED-1608 | 19-213/G6C-AN1P2 /3T | EVERLIGHT | Backlight LED SMD 1608 Green | 1 | 20 | 20 | 20 | 5 | 10 | 10 | 200 | P005609818 | Control MCU에서도 사용 : 2배 구매
13 | LQM2HPZ2R2MG0 | LQM2HPZ2R2MG0 | Murata | FIXED IND 2.2UH 1.3A 80 MOHM SMD, SRF 40MHz | 1 | 430 | 380 | 380 | 5 | 1 | 5 | 1900 | P008172717 | Control MCU, Pipette에서도 사용 : 4배 구매
14 | STM32F070RBT6 | STM32F070RBT6 | STMicroelectronics | ARM Cortex-M0 Value line, 128 Kbytes Flash, 48 MHz CPU, SMD/SMT | 1 | 2760 | 2340 | 2340 | 5 | 1 | 5 | 11700 | P007475431 | Pipette에서도 사용 : 10ea 추가 구매
15 | LM3671MF-3.3 | LM3671MF-3.3 | TI | 2-MHz, 600-mA Step-Down DC-DC Converter | 1 | 1170 | 1170 | 1170 | 5 | 1 | 5 | 5850 | P002182619 | Pipette에서도 사용 : 10ea 추가 구매
18 | 54102-S08-05 | 54102-S08-05 | FCI | 2.54mm pitch 10-pin(2x5) Header Post=5.84mm Tail=3.05mm | 1 | 890 | 890 | 890 | 5 | 1 | 5 | 4450 | P007602652 | Control MCU에서도 사용 : 2배 구매
16 | 53047-0210 | 53047-0210 | Molex | 1.25mm pitch CON 2-pin, Throgh hole type | 1 | 50 | 50 | 50 | 10 | 100 | 100 | 5000 | P005634306 | Control MCU에서도 사용 : 2배 구매
17 | HEADER_20X2 | 57102-G06-20LF | FCI | 2.00mm pitch 40-pin(20x2) Header Post=4mm Tail=2.5mm | 2 | 4180 | 4180 | 8360 | 10 | 1 | 10 | 41800 | P005013055 | Control MCU에서도 사용 : 2배 구매
19 | YST-1502 | YST-1502 SMD | ???? | TACH Switch 8.0x3.7, T=2.5mm SMD | 1 | 100 | 100 | 100 | 5 | 10 | 5 | 500 | P000096310 | Control MCU에서도 사용 : 2배 구매
20 | ABS07-32.768KHZ | ABS07-120-32.768KHz-T | ABRACON | 32.768KHz Crystal 6pF 20PPM | 1 | 840 | 840 | 840 | 5 | 1 | 5 | 4200 | P005745361
21 | ABM3-8.000MHZ-D2Y-T | ABM3-8.000MHZ-D2Y-T | AVX | CRYSTAL 8.0000MHZ 18PF SMD | 1 | 720 | 590 | 590 | 5 | 1 | 5 | 2950 | P008255995 | Control MCU에서도 사용 : 2배 구매
No | Type | P_value | Vendor | V_Desc | Q'ty | Unit Cost | Cost | Cost | 필요수량 | MOQ | 구매수량 | 구매금액 | ICBanQ
 | 1225-1205 | 1225-1205 | Any | 2.54mm pitch 10-pin(2x5) Header Post=6.0mm Tail=3.0mm | 1 | 30 | 30 | 30 | 5 | 1 | 10 | 300 | P005666489
 | 15134-0201 | 15134-0201 | Molex | POWER CORD, 2P CRIMP SOCKET, 100MM, BLK - Ass'y Cable | 1 | 1670 | 1670 | 1670 | 5 | 1 | 5 | 8350 | P007557469
 | HEADER_20X2 | 1320-1220 | Any | 2.00mm pitch 40-pin(20x2) Header Post=3.9mm Tail=2.8mm | 2 | 290 | 290 | 580 | 10 | 1 | 20 | 5800 | P005675364
 | 2285-2-05 |  | Any | 2.54mm pitch 10-pin(2x5) Header Socket 몰드 중간 돌출 타입 Straight Type |  | 660 | 660 | 0 | 10 | 1 | 4 | 2640 | P005655491
 | 2343-2-20-G0 |  | Any | 2.00mm pitch 40-pin(20x2) Header Socket 몰드높이=4.3MM Straight Type |  | 1200 | 1200 | 0 | 2 | 1 | 2 | 2400 | P005655933
 |  |  |  |  |  |  |  | 14840 |  |  |  | 98540
Design Part Type count: 13 |  |  |  |  |  |  |  | 1484 |  |  |  | 9854
 |  |  |  |  |  |  |  | 16324 |  |  |  | 108394
 |  |  |  |  |  |  |  | 17808 |  |  |  | 118248
 |  |  |  |  |  |  |  |  | Set 수량
 |  |  |  |  |  |  |  |  | 10
No | Type | P_value | Vendor | V_Desc | Q'ty | Unit Cost | Cost | Cost | 필요수량 | MOQ | 구매수량 | 구매금액 | ICBanQ
15 | F-1608 | F0603E2R50FSTR | AVX | FUSE BOARD MOUNT 2.5A 32VDC 0603 | 2 | 420 |  |  | 20
16 | MSS5131-153ML | MSS5131-153ML | Coilcraft | INDUCTOR, PWR, 15UH, 1.5A, 20%,32MHZ | 1 | 2150 |  |  | 10
17 | LQM2HPZ2R2MG0 | LQM2HPZ2R2MG0 | Murata | FIXED IND 2.2UH 1.3A 80 MOHM SMD, SRF 40MHz | 1 | 480 |  |  | 10
18 | ASMT-YTD2-0BB02 | ASMT-YTD2-0BB02 | Avago | 3 color type LED 6-pin, TOP View, R745mcd, G1600mcd, B380mcd | 1 | 720 |  |  | 10
19 | LED-2012 | 17-21/W1D-ANPHY/3T | EVERLIGHT | Backlight LED SMD 2012 White | 1 | 20 |  |  | 10
20 | LED-1608 | 19-21/R6C-AP1Q2/3T | EVERLIGHT | Backlight LED SMD 1608 Red | 1 | 20 |  |  | 10
21 | LED-1608 | 19-217/W1D-APQHY/3T | EVERLIGHT | Backlight LED SMD 1608 White | 1 | 30 |  |  | 10
22 | LED-1608 | 19-213/G6C-AN1P2 /3T | EVERLIGHT | Backlight LED SMD 1608 Green | 1 | 20 |  |  | 10
23 | STPS120M | STPS120M | ST | 1.0 Amp 20 Volt DIODE | 1 | 520 |  |  | 10
24 | SMBJ12CA | SMBJ12CA | KD | bi-directional Vr=12V 600W TVS_diode | 1 | 200 |  |  | 10
25 | PMBT2222 | PMBT2222 | NXP | Bipolar Transistors - BJT NPN SW 600MA 40V | 5 | 180 |  |  | 50
26 | STM32F070RBT6 | STM32F070RBT6 | STMicroelectronics | ARM Cortex-M0 Value line, 128 Kbytes Flash, 48 MHz CPU, SMD/SMT | 1 | 3970 |  |  | 10
27 | MCP73831T_2ACIOT | MCP73831T-2ACI/OT | Microchip | Charge management controller | 1 | 750 |  |  | 10
28 | LM2735XMF | LM2735XMF | TI | 1.6-MHz Space-Efficient Boost and SEPIC DC-DC Regulator 24V 2.1A | 1 | 2850 |  |  | 10
29 | LM3671MF-3.3 | LM3671MF-3.3 | TI | 2-MHz, 600-mA Step-Down DC-DC Converter | 1 | 1750 |  |  | 10
30 | 053048-0310 | 053048-0310 | Molex | 1.25mm Pitch DIP CON, Right Angle 3-Pin | 1 | 110 |  |  | 10
31 | 053048-0810 | 053048-0310 | Molex | 1.25mm Pitch DIP CON, Right Angle 3-Pin | 1 | 110 |  |  | 10
32 | HI05-AG0272 | HI05-AG0272 | HYUP JIN | Micro USB type-B 5PIN SOCKET | 1 | 260 |  |  | 10
33 | CTT_1139P1 | CTT-1139P1 | CT Electronics | Tack S/W | 1 | 160 |  |  | 10
34 | SKRMABE010 | SKRMABE010 | APLS | Tack S/W | 3 | 280 |  |  | 30
35 | R-1005 | NC | WALSIN |  | 4 | 10 |  |  | 40

Sheet: Sheet3
하네스 공구
No | P_value | Vendor | V_Desc | Q'ty | Unit Cost | 필요수량 | MOQ | 구매수량 | 구매금액 | ICBanQ
1 | 압착기 P-707 | HOZAN | 압착기, D-SUB압착기(오픈바렐) | 1 | 123800 | 1 |  |  |  | P007150257
