ArvidJoung/Plasma_Generator/0_MP2 Data/2_BOM/Plasma_Pipette_Transformer_V4.0_Part list_20181104.xlsx

Plasma Pipette Transformer PCB BOM V2.0
No | Type | P_value | Vendor | V_PN | V_Desc | Q'ty | Reference No.
1 | T491D227K016AT | 220uF/16V | KEMET | T491D227K016AT | Tantal Capacitor 220uF/16V Case-D 7343 size | 1 | C1
2 | C-1005 | 0.1uF | MURATA | GRM155R71C104KA88D | CAP CER 0.1uF 16V 10% X7R 0402 | 2 | C2,C3
3 | R-1005 | 100K | WALSIN | WR04X1003FTL | RES SMD 100K OHM 1% 1/16W 0402 | 2 | R1,R2
4 | NVMFS5C450NL | NVMFS5C450NL | ON Semiconductor | NVMFS5C450NL | 40V, 2.8mOhm , 110A, Single N−Channel Power MOSFET | 2 | Q1,Q2
5 | 053398-0671 | 053398-0671 | Molex | 053398-0671 | 1.25mm Pitch SMD CON, Vertical 6-Pin | 1 | J1
8 | CTT_1139P1 | CTT-1139P1 | CT Electronics | CTT-1139P1 | Tack S/W | 1 | SW1
9 | EFD1820G | EFD1820G | CKT | EFD1820G | TRANSFORMER CCFL 6W | 1 | TX1
6 | PAD_4X4 | - | - | - | PCB Solder PAD 5x5 | 2 | P1,P6
