ArvidJoung/Plasma_Generator/5_JTAG PCB/1_Schematic/Plasma_Pipette_JTAG_BOM_V1.0.xlsx

Part Type Report1 for Plasma_Pipette_JTAG_SCH_V1.0.sch on 2018-05-02 오전 11:10:01
 |  |  |  |  |  |  |  |  |  |  |  |  |  |  | Set 수량
 |  |  |  |  |  |  |  |  |  |  |  |  |  |  | 5
USEINPARTSLIST | No | Type | P_value | Vendor | V_PN | V_Desc | Q'ty | Reference No. | P_size | Height | PCB Decal | Unit Cost | Cost | 구매 Cost | 필요수량 | MOQ | 구매수량 | 구매금액 | ICBanQ
YES | 1 | C-1005 | 4.7uF | MURATA | GRM155R61A475KEAAD | CAP CER 4.7uF 10V 10% X5R 0402 | 1 | C1 | 1.0x0.5 | 0.55mm | C-1005 | 10 | 10 |  | 5
YES | 2 | C-1608 | 10uF | MURATA | GRM188R61E106MA73D | CAP CER 10uF 25V 20% X5R 0603 | 1 | C2 | 1.6x0.8 | 0.95mm | C-1608 | 210 | 210 |  | 5
YES | 3 | R-1005 | 470 | WALSIN | WR04X4700FTL | RES SMD 470 OHM 1% 1/16W 0402 | 2 | R1,R4 | 1.0x0.5 | 0.40mm | R-1005 | 10 | 20 |  | 10
YES | 4 | R-1005 | 10K | WALSIN | WR04X1002FTL | RES SMD 10K OHM 1% 1/16W 0402 | 1 | R2 | 1.0x0.5 | 0.40mm | R-1005 | 10 | 10 |  | 5
YES | 5 | LQM2HPZ2R2MG0 | LQM2HPZ2R2MG0 | Murata | LQM2HPZ2R2MG0 | FIXED IND 2.2UH 1.3A 80 MOHM SMD, SRF 40MHz | 1 | L1 | 2.5X2.0 | 1.00mm | LQM2HPZ2R2MG0 | 430 | 430 |  | 5 | 1 | 재고
YES | 6 | LED-1608 | 19-21/R6C-AP1Q2/3T | EVERLIGHT | 19-21/R6C-AP1Q2/3T | Backlight LED SMD 1608 Red | 2 | LED1,LED2 | 1.6x0.8 | 1.0mm | LED-1608 | 20 | 40 |  | 10 | 10 | 재고
YES | 7 | BZT52C5V1S | BZT52C5V1S | Diodes | BZT52C5V1S | DIODE, ZENER, 5.1V, 0.2W, SOD-323 | 1 | D1 | 2.5x1.3 | 1.05mm | BZT52C5V1S | 60 | 60 |  | 5 | 1 | 재고
YES | 8 | LM3671MF-3.3 | LM3671MF-3.3 | TI | LM3671MF-3.3 | 2-MHz, 600-mA Step-Down DC-DC Converter | 1 | U2 | 3.05x3.0 | 1.45mm | LM3671MF-3.3 | 1170 | 1170 |  | 5 | 1 | 재고
YES | 9 | HEADER_2.54MM_2X5 | HEADER_2.54mm_2x5 | Anyvendor | HEADER_2.54mm_2x5 | 2.54mm pitch 10-pin(2x5) Header L=11.5mm(1-molding) | 1 | J1 | 12.7x4.83 | 5.84mm | HEADER_2.54MM_2X5 | 30 | 30 | 30 | 5 | 1 | 10 | 300 | P005666489
YES | 10 | HI05-AG0272 | HI05-AG0272 | HYUP JIN | HI05-AG0272 | Micro USB type-B 5PIN SOCKET | 1 | J2 | 8.0x5.6 | 2.45mm | HI05-AG0272 | 260 | 260 |  | 5 |  | 재고
YES | 11 | 53047-0210 | 53047-0210 | Molex | 53047-0210 | 1.25mm pitch CON 2-pin, Throgh hole type | 1 | J3 | 4.25x3.2 | 4.2mm | 53047-0210 | 50 | 50 |  | 5 |  | 재고
YES | 12 | USB-A-4P-FEMALE | KJCAF042-x1113 | KUK | KJCAF042-x1113 | USB A Type 4P Female RA through | 1 | J4 | 14.2x13.8 | 6.9mm | USB-A-4P-FEMALE | 160 | 160 | 160 | 5 |  | 5 | 800 | P007112027
NO | 13 | R-1005 | NC | WALSIN | WR04X1002FTL | RES SMD 10K OHM 1% 1/16W 0402 | 1 | R3 | 1.0x0.5 | 0.40mm | R-1005 | 10
NO | 14 | HOLE2.0 |  |  |  | Ass'y Hole | 4 | P1,P2,P3,P4 |  |  | HOLE2.0
 |  |  |  |  |  |  |  |  |  |  |  |  | 2450
