ArvidJoung/Plasma_Generator/4_Transformer/1_Schematic/V3.0/Plasma_Pipette_Transformer_V3.0_Part list_20181104.xlsx

Plasma Pipette Transformer PCB BOM V2.0
No | Type | P_value | Vendor | V_PN | V_Desc | Q'ty | Reference No. | P_size | Height | Unit Cost | Cost
1 | T491D227K016AT | 220uF/16V | KEMET | T491D227K016AT | Tantal Capacitor 220uF/16V Case-D 7343 size | 1 | C1 | 7.3x4.3 | 2.8mm | 2280 | 2280
2 | C-1005 | 0.1uF | MURATA | GRM155R71C104KA88D | CAP CER 0.1uF 16V 10% X7R 0402 | 2 | C2,C3 | 1.0x0.5 | 0.55mm | 10 | 20
3 | R-1005 | 100K | WALSIN | WR04X1003FTL | RES SMD 100K OHM 1% 1/16W 0402 | 2 | R1,R2 | 1.0x0.5 | 0.40mm | 10 | 20
4 | NVMFS5C450NL | NVMFS5C450NL | ON Semiconductor | NVMFS5C450NL | 40V, 2.8mOhm , 110A, Single N−Channel Power MOSFET | 2 | Q1,Q2 | 6.73x6.22 | 2.38mm | 940 | 1880
5 | 053398-0671 | 053398-0671 | Molex | 053398-0671 | 1.25mm Pitch SMD CON, Vertical 6-Pin | 1 | J1 | 12.25x4.2 | 4.7mm | 130 | 130
8 | CTT_1139P1 | CTT-1139P1 | CT Electronics | CTT-1139P1 | Tack S/W | 1 | SW1 | 6.4x4.5 | 1.6mm | 160 | 160
9 | EFD1820G | EFD1820G | CKT | EFD1820G | TRANSFORMER CCFL 6W | 1 | TX1 | 26.5x17.8 | 8.2mm | 10000 | 10000
6 | PAD_4X4 | - | - | - | PCB Solder PAD 5x5 | 2 | P1,P6 | 5.0x5.0 |  | 0 | 0
 |  |  |  |  |  |  |  |  |  |  | 14490
