ArvidJoung/Plasma_Generator/0_Proto_type/1_Schematic/1_V1.0/Plasma Generator_Part List_V2.0_20171222.xlsx

Sheet: Main Board
Main PCB
 | Part Type Report1 for Plasma_Gen_Main Board_Portable_SCH_V2.0_20180120.sch on 2018-01-21 오전 10:31:17 |  |  |  |  | Total |  |  |  |  |  |  |  |  |  |  |  | 제작 수량
 |  |  |  |  |  | 4 |  |  |  |  |  |  |  |  |  |  |  | 4 | ea |  | ICbanQ | ic114
No | P_value | Vendor | V_PN | V_Desc | Q'ty | Total | 재고 | Reference No. | P_size | Height | Unit Cost | Cost | MOQ | Cost | Type | PCB Decal | Agency | Total Q'ty | 주문 | 단가 | 총가격 | 총가격
1 | 330pF | MURATA | GRM155R71H331KA01D | CAP CER 330pF 50V 10% X7R 0402 | 1 | 4 |  | C14 | 1.0x0.5 | 0.55mm | 10 | 10 | 10 | 100 | C-1005 | C-1005 | ICbanQ | 4 | -
2 | 470pF | MURATA | GRM1555C1H471JA01D | CAP CER 470pF 50V 5% C0G 0402 | 1 | 4 |  | C4 | 1.0x0.5 | 0.55mm | 10 | 10 | 10 | 100 | C-1005 | C-1005 | ICbanQ | 4 | -
3 | 0.1uF | MURATA | GRM155R71C104KA88D | CAP CER 0.1uF 16V 10% X7R 0402 | 15 | 60 |  | C3, C6, C7, C8, C9, C10, C11, C17, C19, C20, C21, C22, C23, C24, C25 | 1.0x0.5 | 0.55mm | 10 | 150 | 10 | 150 | C-1005 | C-1005 | ICbanQ | 60 | -
4 | 4.7uF | MURATA | GRM155R61A475KEAAD | CAP CER 4.7uF 10V 10% X5R 0402 | 3 | 12 |  | C2, C5, C15 | 1.0x0.5 | 0.55mm | 10 | 30 | 10 | 100 | C-1005 | C-1005 |  | 12 | -
5 | 10uF | MURATA | GRM188R61E106MA73D | CAP CER 10uF 25V 20% X5R 0603 | 4 | 16 |  | C1, C13, C16, C18 | 1.6x0.8 | 0.95mm | 210 | 840 | 25 | 5250 | C-1608 | C-1608 | ICbanQ | 16 | -
6 | 22uF | MURATA | GRM188R60J226MEA0 | CAP CER 22uF 6.3V 20% X5R 0603 | 1 | 4 |  | C12 | 1.6x0.8 | 0.95mm | 240 | 240 | 25 | 6000 | C-1608 | C-1608 | ICbanQ | 4 | -
7 | 0 | WALSIN | WR04X000PTL | RES SMD 0.0 OHM JUMPER 0402 | 7 | 28 |  | R26, R27, R30, R35, R36, R37, R38 | 1.0x0.5 | 0.40mm | 10 | 70 | 100 | 1000 | R-1005 | R-1005 | ICbanQ | 28 | -
8 | 330 | WALSIN | WR04X3300FTL | RES SMD 330 OHM 1% 1/16W 0402 | 2 | 8 |  | R22, R23 | 1.0x0.5 | 0.40mm | 10 | 20 | 100 | 1000 | R-1005 | R-1005 | ICbanQ | 8 | -
9 | 430 | WALSIN | WR04X4300FTL | RES SMD 430 OHM 1% 1/16W 0402 | 4 | 16 |  | R15, R16, R17, R29 | 1.0x0.5 | 0.40mm | 10 | 40 | 100 | 1000 | R-1005 | R-1005 | ICbanQ | 16 | -
10 | 470 | WALSIN | WR04X4700FTL | RES SMD 470 OHM 1% 1/16W 0402 | 1 | 4 |  | R19 | 1.0x0.5 | 0.40mm | 10 | 10 | 100 | 1000 | R-1005 | R-1005 | ICbanQ | 4 | -
11 | 2K | WALSIN | WR04X2001FTL | RES SMD 2K OHM 1% 1/16W 0402 | 1 | 4 |  | R6 | 1.0x0.5 | 0.40mm | 10 | 10 | 100 | 1000 | R-1005 | R-1005 | ICbanQ | 4 | -
12 | 5.1K | WALSIN | WR04X5101FTL | RES SMD 5.1K OHM 1% 1/16W 0402 | 1 | 4 |  | R2 | 1.0x0.5 | 0.40mm | 10 | 10 | 100 | 1000 | R-1005 | R-1005 | ICbanQ | 4 | -
13 | 10K | WALSIN | WR04X1002FTL | RES SMD 10K OHM 1% 1/16W 0402 | 17 | 68 |  | R1, R3, R7, R9, R11, R12, R13, R14, R18, R20, R21, R28, R31, R32, R33, R34, R42 | 1.0x0.5 | 0.40mm | 10 | 170 | 100 | 1000 | R-1005 | R-1005 | ICbanQ | 68 | -
14 | 30K | WALSIN | WR04X3002FTL | RES SMD 30K OHM 1% 1/16W 0402 | 1 | 4 |  | R8 | 1.0x0.5 | 0.40mm | 10 | 10 | 100 | 1000 | R-1005 | R-1005 | ICbanQ | 4 | -
15 | 56K | WALSIN | WR04X5602FTL | RES SMD 56K OHM 1% 1/16W 0402 | 1 | 4 |  | R10 | 1.0x0.5 | 0.40mm | 10 | 10 | 100 | 1000 | R-1005 | R-1005 |  | 4 | -
16 | F0603E2R50FSTR | AVX | F0603E2R50FSTR | FUSE BOARD MOUNT 2.5A 32VDC 0603 | 2 | 8 | 6 | L1,L2 | 1.6x0.8 | 0.95mm | 390 | 780 | 10 | 3900 | F-1608 | C-1608 | ICbanQ | 8 | 10 | 390 | 3900
17 | MSS5131-153ML | Coilcraft | MSS5131-153ML | INDUCTOR, PWR, 15UH, 1.5A, 20%,32MHZ | 1 | 4 |  | L3 | 5.1x5.1 | 3.10mm | 2150 | 2150 | 1 | 2150 | MSS5131-153ML | MSS5131-153ML | ICbanQ | 4 | 4 | 2150 | 8600
18 | LQM2HPZ2R2MG0 | Murata | LQM2HPZ2R2MG0 | FIXED IND 2.2UH 1.3A 80 MOHM SMD, SRF 40MHz | 1 | 4 | 6 | L4 | 2.5X2.0 | 1.00mm | 480 | 480 | 1 | 480 | LQM2HPZ2R2MG0 | LQM2HPZ2R2MG0 | ICbanQ | 4 | 4 | 480 | 1920
19 | ASMT-YTD2-0BB02 | Avago | ASMT-YTD2-0BB02 | 3 color type LED 6-pin, TOP View, R745mcd, G1600mcd, B380mcd | 1 | 4 |  | LED1 | 3.4x2.8 | 2.00mm | 1990 | 1990 | 1 | 1990 | ASMT-YTD2-0BB02 | ASMT-YTD2-0BB02 | ICbanQ | 4 | 4 | 1990 | 7960
20 | 17-21/W1D-ANPHY/3T | EVERLIGHT | 17-21/W1D-ANPHY/3T | Backlight LED SMD 2012 White | 1 | 4 | 10 | LED2 | 2.0x1.2 | 1.10mm | 20 | 20 | 10 | 200 | LED-2012 | LED-2012 | ICbanQ | 4 |  |  | 0
21 | STPS120M | ST | STPS120M | 1.0 Amp 20 Volt DIODE | 1 | 4 |  | D1 | 3.75x1.9 | 1.00mm | 520 | 520 | 1 | 520 | STPS120M | STPS120M | ICbanQ | 4 | 4 | 520 | 2080
22 | PMBT2222 | NXP | PMBT2222 | Bipolar Transistors - BJT NPN SW 600MA 40V | 9 | 36 | 10 | Q1,Q2,Q3,Q4,Q5,Q6,Q7,Q8,Q9 | 3.0x2.5 | 1.10mm | 180 | 1620 | 1 | 1620 | PMBT2222 | PMBT2222 | ICbanQ | 36 |  |  | 0
23 | STM32F070RBT6 | STMicroelectronics | STM32F070RBT6 | ARM Cortex-M0 Value line, 128 Kbytes Flash, 48 MHz CPU, SMD/SMT | 1 | 4 | 1 | U1 | 10x10 | 1.60mm | 3060 | 3060 | 1 | 3060 | STM32F070RBT6 | STM32F070RBT6 | ICbanQ | 4 | 5 | 3060 | 15300
24 | MCP73831T-2ACI/OT | Microchip | MCP73831T-2ACI/OT | Charge management controller | 1 | 4 |  | U2 | 3.1x1.6 | 1.30mm | 750 | 750 | 1 | 750 | MCP73831T_2ACIOT | MCP73831T_2ACIOT | ICbanQ | 4 |  |  | 0
25 | MAX3232CSE | MAXIM | MAX3232CSE | 3.0V to 5.5V, Low-Power, up to 1Mbps, True RS-232 Transceivers Using Four 0.1uF External Capacitors | 1 | 4 |  | U3 | 10x6.2 | 1.75mm | 1500 | 1500 | 1 | 1500 | MAX3232ESE | MAX3232ESE | ICbanQ | 4 | 4 | 1500 |  | 6000
26 | LM2735XMF | TI | LM2735XMF | 1.6-MHz Space-Efficient Boost and SEPIC DC-DC Regulator 24V 2.1A | 1 | 4 |  | U4 | 3.05x3.0 | 1.45mm | 2450 | 2450 | 1 | 2450 | LM2735XMF | LM2735XMF | ICbanQ | 4 | 4 | 2450 | 9800
27 | LM3671MF-3.3 | TI | LM3671MF-3.3 | 2-MHz, 600-mA Step-Down DC-DC Converter | 1 | 4 |  | U5 | 3.05x3.0 | 1.45mm | 1750 | 1750 | 1 | 1750 | LM3671MF-3.3 | LM3671MF-3.3 | ICbanQ | 4 |  |  | 0
28 | BPE-1407P-40 | EL3 | BPE-1407P-40 | Pin type, Piezo Buzzer 40(4.0KHz), 5V | 1 | 4 |  | BZ1 | 13.8pi | 6.8mm | 260 | 260 | 1 | 260 | BUZZER | BPE-1407P-40 | ICbanQ | 4 | 4 | 260 | 1040
29 | 12512WS-04B | YEONHO | 12512WS-04B | CON 4-pin, Throgh hole type | 3 | 12 | 10 | J1,J2,J3 | 7.5x3.6 | 4.2mm | 120 | 360 | 20 | 2400 | 12512WS-04B | 12512WS-04B | ic114 | 12 | 20 | 120 |  | 2400
30 | HI05-AG0272 | HYUP JIN | HI05-AG0272 | Micro USB type-B 5PIN SOCKET | 1 | 4 |  | J4 | 8.0x5.6 | 2.45mm | 320 | 320 | 1 | 320 | HI05-AG0272 | HI05-AG0272 | ICbanQ | 4 | 4 | 320 | 1280
31 | DSBU-9PIN-R/A | MOLEX | DSBU-9PIN-R/A | D-SUB PCB 2-row 9-pin Female Right angle | 1 | 4 |  | J5 | 30.8x18.2 | 12.5mm | 250 | 250 | 1 | 250 | DSBU-9PIN-R/A | DSBU-9PIN-R/A | ICbanQ | 4 | 4 | 250 | 1000
 | 12512WS-02B | YEONHO | 12512WS-02B | CON 2-pin, Throgh hole type | 1 | 4 |  | J7 | 5.0x3.6 | 4.2mm | 100 | 100 | 20 | 2000 |  |  | ic114 | 4
32 | YST-1102SF | 영성정공 | YST-1102SF | TACH Switch 6.0x6.0, 8.0MM SMD | 2 | 8 | 2 | SW1,SW2 | 10x6.0 | 8.0mm | 100 | 200 | 10 | 1000 | YST-1102SF | YST-1102S-SMD | ic114 | 8 | 10 | 100 |  | 1000
33 | YST-1102SA | 영성정공 | YST-1102SA | TACH Switch 6.0x6.0, 5.0MM SMD | 1 | 4 | 6 | SW3 | 10x6.0 | 5.0mm | 80 | 80 | 10 | 800 | YST-1102SA | YST-1102S-SMD | ic114 | 4 | 10 | 80 |  | 800
34 | PTV09A-4020U-B103 | BOURNS | PTV09A-4015U-B103 | Bourns Panel Mount Potentiometers 10K LINEAR 20% T=20mm | 1 | 4 |  | VR1 | 12.5x11.4 | 20.00mm | 910 | 910 | 1 | 910 | PTV09A-4015U | PTV09A-4015U-B103 | ICbanQ | 4 | 4 | 910 | 3640
35 | NC | WALSIN | NC | R-1005 | 6 | 24 |  | R4,R5,R24,R25,R40,R41 | 1.0x0.5 | 0.40mm |  | 0 |  | 0 | R-1005 | R-1005
36 | NC | WALSIN | NC | R-1608 | 1 | 4 |  | R39 | 1.6x0.8 | 0.95mm |  | 0 |  | 0 | R-1608 | R-1608
37 | NC | MURATA | NC | C-1005 | 1 | 4 |  | C26 | 1.0x0.5 | 0.40mm |  | 0 |  | 0 | C-1005 | C-1005
38 | HOLE3.0 | - | - | PCB screw Hole | 4 | 16 |  | P1,P2,P3,P4 | 3pi | - |  | 0 |  | 0 | HOLE3.0 | HOLE3.0
 | 12505HS-04 | YEONHO | 12505HS-04 | 1.25mm Pitch Housing 4Pin - 12512WS application | 3 | 12 | 10 |  |  |  | 35 | 105 | 20 | 700 |  |  |  | 12 | 20 | 35 |  | 700
 | 12505TS | YEONHO | 12505TS | 1.25mm Pitch Terminal 1A, AWG#28~#32 | 24 | 96 | 60 |  |  |  | 20 | 480 | 100 | 2000 |  |  |  | 96 | 100 | 20 |  | 2000
 |  |  |  |  |  |  |  |  |  |  |  | 21180 |  | 49010 |  |  |  |  |  |  | 56520 | 12900
 |  |  |  |  |  |  |  |  |  |  |  |  |  |  |  |  |  |  |  |  | 5652 | 1290
 |  |  |  |  |  |  |  |  |  |  |  |  |  |  |  |  |  |  |  |  | 62172 | 14190

Sheet: ETC
No |  |  | P_value | Vendor | 수량 | 단가 | 총가격
1 | Battery | CON | 12505HS-04 | YEONHO | 20 | 35 | 700 | 1.25mm Pitch Housing 4Pin - 12512WS application
 |  | Pin | 12505TS | YEONHO |  |  |  | AWG#28~#32 | ICbanQ
 |  | Wire |  |  |  |  |  |  |  | gun.joung@gmail.com
2 | Transformer | CON |  | YEONHO |  |  |  |  |  | ilovehwa0311
 |  | Pin |  | YEONHO
3 | JTAG Cable | CON |  | YEONHO |  |  |  |  | ic114
 |  | Pin |  | YEONHO |  |  |  |  |  | ingunj
 |  | Wire |  |  |  |  |  |  |  | ilovehwa0311
4
