ArvidJoung/Plasma_Generator/0_Proto_type/1_Schematic/1_V1.0/Plasma Generator_Part List_20171201.xlsx

Sheet: Main Board
Main PCB
 | Part Type Report1 for Plasma_Gen_Main Board_V1.0_20171130.sch on 2017-11-30 오후 2:32:11 |  |  |  |  |  |  |  |  |  |  | 제작 수량
 |  |  |  |  |  |  |  |  |  |  |  | 3 | ea |  | ICbanQ | ic114
No | P_value | Vendor | V_PN | Datasheet | P_size | Height | Unit Cost | Cost | MOQ | Cost | Agency | Total Q'ty | 주문 | 단가 | 총가격
15 | F0603E2R50FSTR | AVX | F0603E2R50FSTR | OK | 1.6x0.8 | 0.95mm | 420 | 840 | 1 | 840 | ICbanQ | 6 | 10 | 390 | 3900
16 | MSS5131-153ML | Coilcraft | MSS5131-153ML | OK | 5.1x5.1 | 3.10mm | 2150 | 2150 | 1 | 2150 | ICbanQ | 3 | 4 | 2150 | 8600
17 | LQM2HPZ2R2MG0 | Murata | LQM2HPZ2R2MG0 | OK | 2.5X2.0 | 1.00mm | 480 | 480 | 1 | 480 | ICbanQ | 3 | 4 | 480 | 1920
18 | ASMT-YTD2-0BB02 | Avago | ASMT-YTD2-0BB02 | OK | 3.4x2.8 | 2.00mm | 1990 | 1990 | 1 | 1990 | ICbanQ | 3 | 4 | 1990 | 7960
19 | 17-21/W1D-ANPHY/3T | EVERLIGHT | 17-21/W1D-ANPHY/3T | OK | 2.0x1.2 | 1.10mm | 20 | 20 | 10 | 200 | ICbanQ | 3 |  |  | 0
20 | STPS120M | ST | STPS120M | OK | 3.75x1.9 | 1.00mm | 520 | 520 | 1 | 520 | ICbanQ | 3 | 4 | 520 | 2080
21 | PMBT2222 | NXP | PMBT2222 | OK | 3.0x2.5 | 1.10mm | 180 | 900 | 1 | 900 | ICbanQ | 15 |  |  | 0
22 | STM32F070RBT6 | STMicroelectronics | STM32F070RBT6 | OK | 10x10 | 1.60mm | 3970 | 3970 | 1 | 3970 | ICbanQ | 3 | 5 | 3060 | 15300
23 | MCP73831T-2ACI/OT | Microchip | MCP73831T-2ACI/OT | OK | 3.1x1.6 | 1.30mm | 750 | 750 | 1 | 750 | ICbanQ | 3 |  |  | 0
24 | MAX3232CSE | MAXIM | MAX3232ESE | OK | 10x6.2 | 1.75mm | 5100 | 5100 | 1 | 5100 | ICbanQ | 3 | 4 | 1500 |  | 6000
25 | LM2735XMF | TI | LM2735XMF | OK | 3.05x3.0 | 1.45mm | 2850 | 2850 | 1 | 2850 | ICbanQ | 3 | 4 | 2450 | 9800
26 | LM3671MF-3.3 | TI | LM3671MF-3.3 | OK | 3.05x3.0 | 1.45mm | 1750 | 1750 | 1 | 1750 | ICbanQ | 3 |  |  | 0
27 | BPE-1407P-40 | EL3 | BPE-1407P-40 | OK | 13.8pi | 6.8mm | 260 | 260 | 1 | 260 | ICbanQ | 3 | 4 | 260 | 1040
28 | 12512WS-04B | YEONHO | 12512WS-04B | OK | 7.5x3.6 | 4.2mm | 120 | 360 | 20 | 2400 | ic114 | 9 | 20 | 120 |  | 2400
29 | HI05-AG0272 | 협진 | MCUD-U52105 | OK | 7.9x5.7 | 2.90mm | 260 | 260 | 1 | 260 | ICbanQ | 3 | 4 | 320 | 1280
30 | DSBU-9PIN-R/A | MOLEX | DSBU-9PIN-R/A | OK | 30.8x18.2 | 12.5mm | 250 | 250 | 1 | 250 | ICbanQ | 3 | 4 | 250 | 1000
31 | YST-1102SF | 영성정공 | YST-1102SF | OK | 10x6.0 | 8.0mm | 100 | 200 | 10 | 1000 | ic114 | 6 | 10 | 100 |  | 1000
32 | YST-1102SA | 영성정공 | YST-1102SA | OK | 10x6.0 | 5.0mm | 80 | 80 | 10 | 800 | ic114 | 3 | 10 | 80 |  | 800
33 | PTV09A-4020U-B103 | BOURNS | PTV09A-4015U-B103 | OK | 12.5x11.4 | 20.00mm | 910 | 910 | 1 | 910 | ICbanQ | 3 | 4 | 910 | 3640
34 | NC | WALSIN | NC | - | 1.0x0.5 | 0.40mm |  | 0 |  | 0
35 | TP_CIR0.8 | - | - | - | 0 | - |  | 0 |  | 0
 | 12505HS-04 | YEONHO | 12505HS-04 |  |  |  | 35 | 105 | 20 | 700 |  | 9 | 20 | 35 |  | 700
 | 12505TS | YEONHO | 12505TS |  |  |  | 20 | 480 | 100 | 2000 |  | 72 | 100 | 20 |  | 2000
 |  |  |  |  |  |  |  | 25180 |  | 47080 |  |  |  |  | 56520 | 12900
 |  |  |  |  |  |  |  |  |  |  |  |  |  |  | 5652 | 1290
 |  |  |  |  |  |  |  |  |  |  |  |  |  |  | 62172 | 14190
 |  |  |  |  |  |  |  | 2.77
 |  |  |  |  |  |  |  | 13.85
 |  |  |  |  |  |  |  | 30.8 |  | 8.08
 |  |  |  |  |  |  |  | 24.99 | 24.99 | 2.84
 |  |  |  |  |  |  |  | 5.81 | 2.77 | 5.9
 |  |  |  |  |  |  |  | 2.905 | 11.08 | 16.82
 |  |  |  |  |  |  |  |  | 13.91 | 18.33
 |  |  |  |  |  |  |  |  | 6.955 | 1.51
 |  |  |  |  |  |  |  |  |  | 12.43
 |  |  |  |  |  |  |  | 9.86
 |  |  |  |  |  |  |  | 20.94
 |  |  |  |  |  |  |  |  |  | 12.43
 |  |  |  |  |  |  |  |  | 5.08
 |  |  |  |  |  |  |  |  | 200
 |  |  |  |  |  |  |  |  | -194.92
 |  |  |  |  |  |  |  |  | -94.92

Sheet: ETC
No |  |  | P_value | Vendor | 수량 | 단가 | 총가격
1 | Battery | CON | 12505HS-04 | YEONHO | 20 | 35 | 700 | 1.25mm Pitch Housing 4Pin - 12512WS application
 |  | Pin | 12505TS | YEONHO |  |  |  | AWG#28~#32 | ICbanQ
 |  | Wire |  |  |  |  |  |  |  | gun.joung@gmail.com
2 | Transformer | CON |  | YEONHO |  |  |  |  |  | ilovehwa0311
 |  | Pin |  | YEONHO
3 | JTAG Cable | CON |  | YEONHO |  |  |  |  | ic114
 |  | Pin |  | YEONHO |  |  |  |  |  | ingunj
 |  | Wire |  |  |  |  |  |  |  | ilovehwa0311
4
