ArvidJoung/Plasma_Generator/Plasma_Pipette_Issue and ECO list.xlsx

Sheet: Issue list_Proto
Plasma Generator V1.0 Issue list
No | Date | Item | Status | Closed | Description | Solution | Commant
1 | 2017-12-17 | PCB | CLOSED | 2018-01-02 | U2의 PAD가 작아 실장이 어려움 | PCB Library 수정 Plasma_Gen_Main Board_PCB_V1.0_20180102.pcb
2 | 2017-12-18 | SCH | CLOSED | 2018-01-02 | PULSE_OUT1,2의 Sync를 맞추기 위해 TIMER를 PWM Gen CH1 CH1N를 사용해야 하는데 CH1,CH4로 사용하도록 설계되어 있음 | CH1 : PA8 CH1N : PA7 =>정상 동작으로 CH1,CH4 그대로 사용 | CH1, CH4로 사용하고 dead time이 발생하는 경우 수정
3 | 2017-12-21 | SW | CLOSED | 2017-12-21 | USB가 연결되면, PW_CTRL이 Low로 떨어짐 - BATT_THERM ADC가 upper limit를 넘어감 - 모든 ADC가 항상 230이상이 들어옴 | adc.c / adc_operation.c 수정 - ADC 설정 방법이 수면안대와 틀림
4 | 2017-12-21 | SW | CLOSED | 2017-12-22 | Status LED 상태 update 안됨 - 충전 : RED 표시 안됨 | Buzzer 블록의 문제로 인한 halt 현상 - Buzzer code 수정 후 fixed
5 | 2017-12-22 | SCH | CLOSED | 2017-12-22 | Booster 8V 출력 안됨 | R10, R11 value가 exchange되어 있음 - R10 : 10K -> 56K - R11 : 56K -> 10K | 저항 value가 서로 바뀌어서 Vfb가 3V를 넘어가면서 Boost가 동작을 안함
6 | 2017-12-22 | SW | CLOSED | 2017-12-22 | PULSE_OUT1이 출력이 안됨 | Plasma_state.c 수정 HAL_TIM_PWM_Start/HAL_TIM_PWM_Stop에 한라인으로 CH1,4 실행시키던 부분을 2줄로 수정
7 | 2017-12-29 | SW | CLOSED | 2017-12-30 | Vol으로 Pulse On time 조절시 allways On시 동작하지 않음 - Halt 발생 : OP_LED control이 안됨 - 12/30 S/W : Max에서 allways Off 상태가 됨 | getPlasmaVolLevel()에서 if(ontime < PLASMA_SPAN_TIME_PWM_MSEC) 조건에 따른 변수값 설정 부분 추가
8 | 2017-12-30 | SW | CLOSED | 2017-12-30 | 전원 ON시 buzzer 동작하지 않음 - 기능 미구현 상태 | mc.c mctask_init() 함수에 sendtoBuzzerOnCmd(2); 추가 - Power On시 buzzer2 On 시킴
9 | 2017-12-30 | SW | CLOSED | 2018-01-03 | 전원 OFF시 buzzer 동작하지 않음 - 기능 미구현 상태 | 기능 구현
10 | 2017-12-30 | SW | CLOSED | 2017-12-30 | Plasma On시 buzzer는 동작하나 동작중 Key Off시 buzzer가 Off되지 않고 끝까지 동작함 - Key interrupt 발생시 바로 Off되도록 구현 필요 | Buzzer 동작중 KEY_OP_Pin interrupt 발생시 Buzzer OFF되도록 수정 mc.c에 sendtoBuzzerOffCmd(); 추가
11 | 2017-12-30 | SW | CLOSED | 2017-12-30 | USB 연결 및 제거시 buzzer 동작함 - USB 연결시에는 buzzer 동작이 없음 | mc.c의 MC_EXTPWR_IN_EVT/ MC_EXTPWR_OUT_EVT case의 sendtoBuzzerOnCmd(2); 주석 처리
12 | 2017-12-30 | SW | CLOSED | 2017-12-31 | PWM1 pulse off 상태에서 전압이 불안정함 - 정확히 0V가 아니라 0V 상태에서 흔들림 | PULSE_OUT1_Pin|PULSE_OUT2_Pin - GPIO_PULLDOWN으로 설정
13 | 2017-12-30 | HW | OPEN |  | Transformer 연결시 Pulse On 상태에서 Booster 전압이 흔들림 - Battery 두개 연결시 Battery 전압 drop은 개선이 되나 Booster 전압 흔들림은 그대로임 - Dummy 사용시 더 심함 | Transformer 회로 tune or Booster 부품 변경(3A 이상)
14 | 2017-12-30 | SW | CLOSED | 2018-01-02 | Pulse Off 구간 시작 부분에서 Booster 전압이 흔들림 더 심함 - PWM이 off될때 High상태에서 천천히 떨어지기 때문에 생기는 문제임 - GPIO_PULLDOWN으로 설정후 개선 - Plasma_Pause에 HAL_TIM_PWM_Stop 사용시 CH4(Polarity LOW)는 개선되나 CH1이 변화가 없음 | TIM1 center-aligned PWM으로 변경
15 | 2017-12-30 | HW | CLOSED | 2018-01-02 | Transformer 연결시 Pulse Always on 상태에서 Battery 전압이 OFF 됨 - current 증가로 인한 short로 인식하는것으로 보임 - Battery를 제거 후 다시 연결해야 함 | TIM1 center-aligned PWM으로 변경
16 | 2017-12-31 | SW | CLOSED | 2018-01-02 | Pulse Always On 상태에서도 Off 구간이 발생 - Off 구간 : 31.56usec | 1/2 Jsyoon - Always on시 Off되지 않도록 수정
17 | 2017-12-31 | SW | CLOSED | 2018-01-06 | Low Battery시 LED_R Blink 동작하지 않음 | Chargetask_lowbatt.c / Chargetask_state.h 수정
18 | 2018-01-05 | HW | CLOSED | 2018-01-07 | RS-232 동작 안됨 - RX interrupt 인식을 못함 - USART1_RX date의 Low level이 2.17V 까지밖에 안떨어짐(정상 0V) - MAX3232의 ChargePump의 파형이 점검치구 board와 틀림 | MCU의 Pin할당 miss - PA9 : USART1_RX -> USART1_TX - PA10 : USART1_TX -> USART1_RX | SCH,PCB 수정 필요
19 | 2018-01-14 | HW | CLOSED | 2018-01-20 | Battery / External Power model 구별을 위한 ID pin 추가 필요 | HW_ID0 : PA1, HW_ID1 : PA2 Pin 할당 R40,R41 Pull-up 추가 | V2.0 수정 사항
20 | 2018-01-14 | HW | CLOSED | 2018-01-14 | External Power model에서 Charging IC NC 처리를 위한 0 Ohm 추가 | R39 추가 | V2.0 수정 사항
21 | 2018-01-15 | HW | OPEN |  | Battery Type 결정에 따라 CON pin-map 및 부품 변경
22 | 2018-01-20 | HW | OPEN |  | MP시 Battery 없는 상태에서도 Booting 및 DL 가능하도록 지원 1. Test Pin 추가 2. 하나의 CON로 DL 가능하도록 지원 여부 검토(External Power Pin 할당)
23 | 2018-01-21 | HW | OPEN | 2018-01-21 | Gas 주입 인식을 위한 신호 추가 - GPIO 1ea, GND 1ea, CON 2pin 1ea - GPIO 신호 type : Gas Off : Open Gas On : GND | 12512WS-02B CON 추가 GAS_IN Pin 추가 : PC0 Pull-up Res 10K 추가 | V2.0 수정 사항
24
25
26
27
28

Sheet: Issue list_Pipette
Plasma Pipette V1.0 Issue list
No | Date | Item | Status | Closed | Description | Solution | Commant
1 | 2018-05-10 | SCH | Closed | 2018-05-11 | LED의 밝기가 약함 - LED current를 7mA -> 18mA로 변경 | R21, R22, R23 ECO : 470Ω -> 180Ω
2 | 2018-05-10 | PCB | OPEN |  | Tack S/W SKRMABE010 PAD 확장 검토
3 | 2018-05-16 | SCH/PCB | OPEN |  | J3 053048-0710 Pin-map이 역순으로 되어 있음 -> Transformer PCB는 정상임
4 | 2018-05-16 | SCH/PCB | OPEN |  | BATT 053048-0310 Pin-map이 역순으로 되어 있음
5 | 2018-05-16 | Review | OPEN |  | 하네스의 Current check - AWG28 기준 | 난연성, 실리콘 사용
6 | 2018-05-16 | SCH/PCB | OPEN |  | debugging용 RS-232 지원
7 | 2018-05-31 | Solder | Closed | 2018-05-31 | #2, #5 sample booting 불량 - #2 : booting 후 10초정도 후 Off됨 - #5 : Booting 후 바로 Off됨 | #2 : R7 solder 불량 - Battery ADC line #5 : R1 solder 불량 - Battery Temp line
8
9
10
11
12
13
14
15
16
17
18
19
20
21
22
23
24
25
26
27
28

Sheet: Issue list_JTAG
Plasma Pipette JTAG V1.0 Issue list
No | Date | Item | Status | Closed | Description | Solution | Commant
1 | 2018-05-24 | SCH/PCB | OPEN |  | debugging용 RS-232 지원 | 추후 양산을 고려하여 외부 전원 CON에 JTAG 및 RS-232 Pin 할당
2 | 2018-05-24 | SCH/PCB | OPEN |  | J4의 Pin이 역순으로 되어 있음 | V1.0에서는 Bottom에 soldering V2.0 회로 수정 필요
3 | 2018-05-24 | SCH/PCB | OPEN |  | 3.3V만 인가된 상태에서 5V LED도 On됨. | Diode 추가 필요
4
5
6
7
8
9
10
11
12
13
14
15
16
17
18
19
20
21
22
23
24
25
26
27
28

Sheet: ECO list_Pipette V1.0
Plasma Pipette Main V1.0 ECO list
No | Date | Reference | Pin-Map | Before | After | Description | Comment
1 | 2018-05-10 | R21, R22, R23 |  | 470 | 180 | Plasma Level LED 밝기 조절
2 |  | R10 |  | 68K | 56K | Booster Voltage 원복 9.8V -> 8V | Transformer에서 Voltage tune
3 |  | R19 |  | 470 | 430 | Power On LED와 bias-R 통일
4 |  | LED5 |  | 19-213/G6C-AN1P2 /3T | 19-21/R6C-AP1Q2/3T | High : Green -> RED 으로 color 변경
5 |  | LED3 |  | 19-21/R6C-AP1Q2/3T | 19-213/G6C-AN1P2 /3T | Low : RED -> Green 으로 color 변경
6
7
8
9
10
11
12
13
14
15
16
17
18
19
20
21
22
23
24
25

Sheet: ECO list_Transformer V2.0
Plasma Pipette Transformer V2.0 ECO list
No | Date | Reference | Pin-Map | Before | After | Description | Comment
1
2
3
4
5
6
7
8
9
10
11
12
13
14
15
16
17
18
19
20
21
22
23
24
25
