ArvidJoung/Plasma_Generator/2_Micro_Plasma_Dispenser/1_Schematic/Build V2.0/MPD Issue and Change list_V1.0.xlsx

Sheet: SET
MAIN | F/W | R7 | R30 | S/V | C9 | C15
#01 | V1.0 | 30K | NC | 3.3V |  |  | booting 후 바로 Off됨
#02 | V1.0 | 30K | NC | 3.3V | 0.1uF | 0.1uF | PWR KEY를 오래 누르면 booting 후 바로 Off됨
#03
#04
#05 |  | 30K |  |  |  |  | 6V 인가 후 short

Sheet: Issue
No | Date | PCB | Status | Issue | description | COMMENT
1 | 2019-09-09 | LED | Closed | LED3,4,5 역삽 | RED LED가 모두 역삽되어 있음 | SMT 문제
2 | 2019-09-09 | F/W | Closed | V_EXT를 5.5V 이상으로 올리면 전류가 증가하다 5.7V 이상에서 Board dead | D7(5.1V TVS Diode) 특성 5.5V롤 Upper limit 조정
3 | 2019-09-16 | F/W |  | PWR KEY로 booting시 오래 누르면 전원이 OFF됨. | PWR KEY가 눌린 상태에서 5V ADC가 떨어져 Low battery로 인식 | VBAT ADC monitor disable
4 | 2019-09-22 | SCH |  | S/V 3.3V 사용
 |  |  |  | Key path에 저항 추가 : 100
 |  |  |  | PWM Pulse path에 저항 변경 : 0 -> 100 | Noise 개선

Sheet: MAIN V2.0
No | Date | Sheet | Ref | Before | After | COMMENT
1 | 2019-09-15 | 2 | R7 | 10K | 30K | External 5V 기준으로 수정 - F/W update 필요
2 | 2019-09-22 | 3 | R30 | +5V | +3.3V
2019.11.11 Femto에 V2.0으로 release
3 | 2020-04-06 | 2 | R2 | - | 100 | Key Noise 대책 추가
4 |  | 2 | R18,R27 | 0 | 100 | Plasma Noise 대책

Sheet: Sheet1
3.3 | 3.3 | 3.3
430 | 330 | 200
7.7 | 10.0 | 16.5
