ArvidJoung/Plasma_Generator/3_Plasma_Pipette_C/1_Schematic/Plasma Pipette_C-Change list_20200304.xlsx

Sheet: Issue list
PLASMA PIPETTE-C Issue list
No | Date | PCB | Version | Status | Issue | Description | 기존 회로 | 수정 사항
1 | 2020-03-05 | MAIN

Sheet: CPU V1.0
PLASMA PIPETTE - CPU-001
 | Plasma_Pipette_V5.0_Main_PCB_20190521.pcb
 | Plasma_Pipette_V5.1_Main_SCH_20190610.sch
No | Date | Sheet | Reference | Before | After | Description | SCH | PCB | BOM | Applied Date
1 | 2020-03-05 | 2 | U2 | MCP73831T-2ACI/OT | 삭제 | Battery 제거 및 DC Adaptor 사용으로 인한 회로 변경
2 |  | 2 | R6 | 2K | 삭제
3 |  | 2 | R29 | 430 | 삭제
4 |  | 2 | R28 | 10K | 삭제
5 |  | 2 | Q5 | PMBT2222 | 삭제
6 |  | 2 | R1 | 10K/NO | 삭제
7 |  | 2 | C2 | 4.7uF/NO | 삭제
8 |  | 2 | R2 | 5.1K | 삭제
9 |  | 2 | R3 | 10K | 삭제
10 |  | 2 |  | V_BATT | +5V | Net name 수정
11 |  | 2 | R30 Pin-2 | V_BATT | +3.3V | S/V 3.3V로 변경
12 |  | 1 | Q9 | PMBT2222 | 삭제
13
14
15
16
17
18
19
20
21
22
