ArvidJoung/Plasma_Generator/0_DOC/견적서/20180512_Pipette_Main_V1.0_Layout and manual Solder 비용.xlsx

Model | PCB | Version | 작업 내용 | 일수 or 수량 | 단가 | 금액 | 비고
Pipette | Main | V1.0 | Layout | 5 | 250000 | 1250000 | Reference model 변경에 의해 2번 작업
Pipette | Main | V1.0 | 제작 | 6 | 50000 | 300000 | 수량 변경 : 3 -> 6ea
Pipette | JTAG | V1.0 | Layout | 1 | 250000 | 250000 | Pipette S/W Download용 PCB
Pipette | JTAG | V1.0 | 제작 | 5 | 18000 | 90000
Pipette | Transformer | V2.0 | Layout | 1.5 | 250000 | 375000 | Transformer 변경에 의해 2번 작업
Pipette | Transformer | V2.0 | 제작 | 10 | 13500 | 135000
 |  |  |  |  | Total | 2400000
