ArvidJoung/Plasma_Generator/2_Micro_Plasma_Dispenser/0_DOC/20200406_Build V1.0 Data/MPD MAIN PCB PL V2.1_20191124.xlsx

MPD MAIN-PCB Part List V2.0
 | 2019.09.16
No | Type | Value | Vendor | Description | Q'ty | Reference No.
1 | C-1608 | 100pF |  | CAP CER 100pF 50V 10% X7R 1608 | 2 | C12,C13
2 | C-1608 | 330pF |  | CAP CER 330pF 50V 10% X7R 1608 | 1 | C14
3 | C-1608 | 470pF |  | CAP CER 470pF 50V 10% X7R 1608 | 1 | C4
4 | C-1608 | 0.01uF |  | CAP CER 0.01uF 50V 10% X7R 1608 | 1 | C9
5 | C-1608 | 0.1uF |  | CAP CER 0.1uF 16V 10% X7R 1608 | 15 | C3,C6,C7,C10,C16,C17,C18,C19,BC1,BC2, BC3,BC4,BC5,BC6,BC8
6 | C-1608 | 4.7uF |  | CAP CER 4.7uF 16V 10% X7R 1608 | 2 | C1,C5
7 | C-1608 | 10uF |  | CAP CER 10uF 16V 10% X7R 1608 | 4 | C2,C8,C11,BC7
8 | TC-3216 | 1uF/16V |  | Tantal Capacitor 1uF/16V 3216 size | 4 | TC1,TC2,TC3,TC4
9 | R-1608 | 0 |  | RES SMD 0 OHM 1% 1/10W 1608 | 8 | R17,R18,R19,R24,R25,R27,R30,R36
10 | R-1608 | 100 |  | RES SMD 100 OHM 1% 1/10W 1608 | 3 | R15,R16,R31
11 | R-1608 | 1K |  | RES SMD 1K OHM 1% 1/10W 1608 | 1 | R4
12 | R-1608 | 2K |  | RES SMD 2K OHM 1% 1/10W 1608 | 6 | R6,R9,R29,R33,R37,R38
13 | R-1608 | 4.7K |  | RES SMD 4.7K OHM 1% 1/10W 1608 | 3 | R5,R39,R42
14 | R-1608 | 10K |  | RES SMD 10K OHM 1% 1/10W 1608 | 14 | R1, R11, R12, R13, R14, R20, R21, R22, R23, R26, R28, R32, R34, R35
15 | R-1608 | 30K |  | RES SMD 30K OHM 1% 1/10W 1608 | 2 | R7, R8
16 | R-1608 | 56K |  | RES SMD 56K OHM 1% 1/10W 1608 | 1 | R10
17 | F-3216 | CB3216GA600 |  | Ferrite Bead, 60 Ohm, 600mA | 1 | L2
18 | MSS5131-153ML | MSS5131-153ML | Coilcraft | INDUCTOR, PWR, 15UH, 1.5A, 20%,32MHZ | 1 | L3
19 | LQM2HPZ2R2MG0 | LQM2HPZ2R2MG0 | Murata | FIXED IND 2.2UH 1.3A 80 MOHM SMD, SRF 40MHz | 1 | L4
20 | SS1020 | SS1020 | KD | 1.0 Amp 20 Volt Schottky DIODE | 1 | D1
21 | SMBJ12CA | SMBJ12CA | KD | bi-directional Vr=12V 600W TVS_diode | 1 | D2
22 | BZT52C5V1S | BZT52C5V1S | Diodes | DIODE, ZENER, 5.1V, 0.2W, SOD-323 | 4 | D3,D4,D5,D7
23 | 1N4148WS | 1N4148WS | VISHAY | Small Signal Fast Switching Diode | 1 | D6
24 | DC-005 | DC-005 | Any Vendor | DC Power Jack, 0.7 Pie, DC Plug, DIP | 1 | DC1 | 11/24:PN과 Value 통일
25 | PMBT2222 | PMBT2222 | NXP | Bipolar Transistors - BJT NPN SW 600MA 40V | 7 | Q1,Q2,Q4,Q5,Q6,Q7,Q8
26 | FTK2306 | FTK2306 | First Silicom | FET Vgs 2.5V, Rds 50mOhm | 1 | Q3
27 | STM32F070RBT6 | STM32F070RBT6 | STMicroelectronics | ARM Cortex-M0 Value line, 128 Kbytes Flash, 48 MHz CPU, SMD/SMT | 1 | U1
28 | 74LVC1G07GV | 74LVC1G07GV | NXP | Non-Inverting Buffer SOT753 | 1 | U2
29 | MAX3232CSE | MAX3232CSE | MAXIM | 3.0V to 5.5V, Low-Power, up to 1Mbps, True RS-232 Transceivers Using Four 0.1?iF External Capacitors | 1 | U3
30 | LM2735XSD | LM2735XSD | TI | 1.6-MHz Space-Efficient Boost and SEPIC DC-DC Regulator 24V 2.1A | 1 | U4 | 11/24:PN과 Value 통일
31 | LM3671MF-3.3 | LM3671MF-3.3 | TI | 2-MHz, 600-mA Step-Down DC-DC Converter | 1 | U5
32 | KIA7025 | KIA7025 | KEC | 2.5V Reset IC SOT-89 | 1 | U6
33 | KA358AD | KA358AD | FAIRCHILD | Dual OPAMP 8-SOIC | 1 | U7
34 | 74HCT2G08DP | 74HCT2G08 | NXP | Dual 2-input AND Gate TSSOP8 | 1 | U8
35 | MOLEX-5267-2P | MOLEX-5267-2P | MOLEX | 2.5mm Pitch DIP CON, Vertical 2-Pin | 2 | CN101,CN105
36 | MOLEX-5267-3P | MOLEX-5267-3P | MOLEX | 2.5mm Pitch DIP CON, Vertical 3-Pin | 1 | COM1
37 | MOLEX-5267-4P | MOLEX-5267-4P | MOLEX | 2.5mm Pitch DIP CON, Vertical 4-Pin | 1 | JTAG1
38 | MOLEX-5267-5P | MOLEX-5267-5P | Molex | 2.5mm Pitch DIP CON, Vertical 5-Pin | 1 | CN103
39 | MOLEX-5267-6P | MOLEX-5267-6P | Molex | 2.5mm Pitch DIP CON, Vertical 6-Pin | 2 | CN102,CN104
40 | YST-1502 | YST-1502 SMD | ???? | TACH Switch 8.0x3.7, T=2.5mm SMD | 1 | SW1
41 | C-1608 | NC |  |  | 1 | C15
42 | R-1608 | NC |  |  | 2 | R40,R41
