ArvidJoung/Plasma_Generator/1_Plasma_Pipette/1_Schematic/V2.0/Plasma Pipette V2.0 하네스_20180724.xlsx

하네스 Pin-map
 | Main V2.0 |  |  | Transformer V3.0 |  |  |  |  | No | Part Number
 | J3 | 1 | GND | J1 | 1 | GND | Main V2.0 |  | 1 | 053048-0610
 |  | 2 | KEY_OP |  | 2 | KEY_OP | 하네스 | Connector | 1 | 51021-0600
 |  | 3 | GND |  | 3 | GND |  | Crimp Terminal | 6 | 50058
 |  | 4 | PULSE_OUT1 |  | 4 | PULSE_IN2 |  | Wire | 6 | AWG28 100mm
 |  | 5 | PULSE_OUT2 |  | 5 | PULSE_IN1 |  | Crimp Terminal | 6 | 50058
 |  | 6 | +8.0V |  | 6 | +8.0V |  | Connector | 1 | 51021-0600
 |  |  |  |  |  |  | Transformer V3.0 |  | 1 | 053398-0671
