ArvidJoung/Plasma_Generator/2_Micro_Plasma_Dispenser/1_Schematic/Build V2.0/02_MPD_LED PCB V2.0/MPD LED_PCB PL_V1.0_20190807.xlsx

MPD LED-PCB Part List V1.0
 | 2019.08.07
No | Type | Value | Vendor | Description | Q'ty | Reference No.
1 | R-2012 | 180 |  | RES SMD 180 OHM 1% 1/8W 0805 | 3 | R21,R22,R23
2 | R-2012 | 430 |  | RES SMD 430 OHM 1% 1/18W 0805 | 1 | R15
3 | R-2012 | 470 |  | RES SMD 470 OHM 1% 1/18W 0805 | 1 | R19
4 | LED-2012 | WR148UG/W |  | LED SMD 2012 GREEN | 1 | LED1
5 | LED-2012 | WR148UB/W |  | LED SMD 2012 BLUE | 1 | LED2
6 | LED-2012 | WR148UE/W |  | LED SMD 2012 RED | 3 | LED3,LED4,LED5
7 | MOLEX-5267-6P | MOLEX-5267-6P | MOLEX | 2.5mm Pitch DIP CON, Vertical 6-Pin | 1 | CN300
