ArvidJoung/Plasma_Generator/2_Micro_Plasma_Dispenser/1_Schematic/Build V2.0/03_MPD_KEY PCB V2.0/MPD-KEY_PCB PL V1.0_20190807.xlsx

MPD MAIN-PCB Part List V1.0
 | 2019.08.07
No | Type | Value | Vendor | Description | Q'ty | Reference No.
1 | MX-53047-0510 | 053048-0610 | Molex | 1.25mm Pitch DIP CON, Vertical 5-Pin | 1 | CN200
2 | ITS-1105-5.0MM-SMD | ITS-1105-5.0MM-SMD | 영성정공 | TACH Switch, 5.0MM SMD | 3 | DOWN,UP,POWER
