ArvidJoung/Plasma_Generator/Femto_자료 전달 List.xlsx

Sheet: Pipette
Model | Date | 구분 | 전달 Data List | 원본 설계 자료 | Comment
Pipette | 2020-04-01 | SCH | Plasma_Pipette_V5.1_Main_SCH_20190610.pdf | Plasma_Pipette_V5.1_Main_SCH_20190610.sch | 재요청에 의해 재송부
 |  | PCB | Plasma_Pipette_V5.0_Main_PCB_TOP.pdf | Plasma_Pipette_V5.0_Main_PCB_20190521.pcb
 |  |  | Plasma_Pipette_V5.0_Main_PCB_BOTTOM.pdf
 |  | Gerber | Plasma_Pipette_V5.0_Main_PCB_Gerber_20190521.zip
 |  | PL | Plasma Pipette V5.1 Main Part list_20190610.xlsx
 |  | F/W | Source_20191024.zip
 |  | Binary | Plasma_Pipette_V2.1_0.5sec.bin
 |  |  | Plasma_Pipette_V2.1_1.0sec.bin
 | 2020-04-05 | Binary | Plasma_Pipette_V2.1_0.5sec_2,3,4msec.bin |  | Plasma On time 수정 요청에 의한 F/W release
 |  |  | Plasma_Pipette_V2.1_0.5sec_3,4,5msec.bin
 |  |  | Plasma_Pipette_V2.1_1.0sec_2,3,4msec.bin
 |  |  | Plasma_Pipette_V2.1_1.0sec_3,4,5msec.bin
 | 2020-04-15 | Binary | Plasma_Pipette_V2.1_1.0sec_5,6,7msec.bin |  | Test용 Binary 요청 대응
 |  |  | Plasma_Pipette_V2.1_1.0sec_6,7,8msec.bin
 |  |  | Plasma_Pipette_V2.1_1.0sec_7,8,9msec.bin
 |  |  | Plasma_Pipette_V2.1_1.0sec_5,7,9msec.bin

Sheet: MPD
Model | Date | 구분 | 전달 Data List | 원본 설계 자료 | Comment
MPD | 2020-04-06 | MAIN | MPD-MAIN_SCH_V1.0_20190807.pdf | MPD-MAIN_SCH_V1.0_20190807.sch | 재요청에 의해 재송부
 |  |  | MPD-MAIN_PCB_V1.0_20190807_Gerber.zip | MPD-MAIN_PCB_V1.0_20190807.pcb
 |  |  | MPD MAIN PCB PL V1.0_20190807.xlsx
 |  | LED | MPD-LED_SCH_V1.0_20190807.pdf | MPD-LED_SCH_V1.0_20190807.sch
 |  |  | MPD-LED_PCB_V1.0_20190807_Gerber.zip | MPD-LED_PCB_V1.0_20190807.pcb
 |  |  | MPD LED_PCB PL_V1.0_20190807.xlsx
 |  | KEY | MPD-KEY_SCH_V1.0_20190807.pdf | MPD-KEY_SCH_V1.0_20190807.sch
 |  |  | MPD-KEY_PCB_V1.0_20190807_Gerber.zip | MPD-KEY_PCB_V1.0_20190807.pcb
 |  |  | MPD-KEY_PCB PL V1.0_20190807.xlsx
 |  | F/W | plasma_pt.zip
 |  | Binary | MPD SW_V1.0.bin | 30,40,50msec
 |  | 수정 사항 | MPD V1.0 수정 사항_20190922.xlsx
 | 2020-04-15 | Binary | MPD SW_V1.0_1sec_5,6,7msec.bin |  | Test용 Binary 요청 대응
 |  |  | MPD SW_V1.0_1sec_6,7,8msec.bin
 |  |  | MPD SW_V1.0_1sec_7,8,9msec.bin
 |  |  | MPD SW_V1.0_1sec_5,7,9msec.bin

Sheet: Sheet2
V5.0 Issue
1 | Battery 오동작
 | 간헐적으로 Power off 후 전원이 안켜짐
 | Battery 탈부착 or charger 탈부착 후 정상 동작
2 | Plasma Off 안됨
 | MPD는 정상 동작
