ArvidJoung/Plasma_Generator/Plasma_Gen_Review Data_20180203.xlsx

Sheet: 시제품_Pulse
각 mode 별 Pulse 출력
 | 1. BS mode |  |  |  |  | 2. WS mode |  |  | 3. RS mode
 |  | 1) CH1 기본파 |  |  |  |  | 1) CH1 기본파 |  |  | 1) CH1 기본파
 |  | 2) CH1, CH2 delay time
 |  | 3) 1'st 구간 On time |  |  |  |  | 3) 1'st 구간 On time |  |  | 3) 1'st 구간 On time
 | 2. Frequency
 |  | Mode | 기본파 [KHz] | 1'st 구간 On time [usec] | 1차 구간 Time gap [msec] | 2차 구간 Time gap [msec] |  | 3차 구간 Time gap [msec]
 |  | BS | 80 | 829.5 | 20 | 40
 |  | WS | 80 | 829.5 | 10 | 20
 |  | RS | 80 | 829.5 | 10
 |  |  | 0.0125 | msec
 |  |  | 12.5 | usec
 |  |  | 66.36 | pulse
Buzzer
 |  | On
 |  | 1000 | Hz
 |  | 400 | Hz

Sheet: V1.0_Check list
No | Date | Item | Status | Description | Commant
1 | 2017-11-24 | MCU | CLOSED | Time max Clock 확인 및 변경 가능여부 확인 | 24MHz
2 | 2017-11-24 | Function | CLOSED | Battery ADC check 추가
3 | 2017-11-24 | 부품 | OPEN | Transformer 부품 search
4 | 2017-12-11 | Function | CLOSED | USB 연결시 Auto Power ON시킬지 여부 판단 필요 | USB 연결시 Power On
5
6
7
8
9
10
11
12
13
14
15
16
17
18
19
20
21
22
23
24
25
26
27
28

Sheet: Pin-map
STM32F070RBT6 |  |  |  |  |  |  | TIM Clock
Flash |  | 128 | Kbytes |  |  |  | SystemCoreClock | 48000000 | HCLK
SRAM |  | 16 | Kbytes |  |  |  | PCLK1 | 12000000 | HCLK / 4
Frequency |  | 48 | MHz | max |  |  | TIM clock | 24000000 | PCLK1 x 2
Operating Voltage |  | 2.4 ~ 3.6 | V |  |  |  | TIM counter clock | 28000000
Package |  | LQFP64 |  |  |  |  | Prescaler | -0.1428571429 | ((SystemCoreClock /2) /28 MHz) - 1
 |  |  |  |  |  |  | TIM output clock | 4000
 |  |  |  |  |  |  | period (ARR) | 6999.0 | (TIM3 counter clock / TIM3 output clock) - 1
 |  |  |  |  |  |  | Duty | 100
 |  |  |  |  |  |  | Pulse | 6999.0
 |  |  |  |  |  |  | TIM output Clock T | 0.00025
PIN No |  | PIN name | Pin Function |  | Cube |  | Cube |  | Plasma V1.0
LQFP64 | LQFP48 |  | Alternate | Additional | Function | GPIO | Function | GPIO | Off-page | Function | Active | Other
1 | 1 | VDD | Digital power supply
2 | 2 | PC13 | - | WKUP2 | GPIO_OUT | No-PULL | - | - | - | - | -
3 | 3 | PC14 | - | OSC32_IN |  |  | - | - | - | - | -
4 | 4 | PC15 | - | OSC32_OUT |  |  | - | - | - | - | -
5 | 5 | PF0 | I2C1_SDA | OSC_IN |  |  | - | - | - | - | -
6 | 6 | PF1 | I2C1_SCL | OSC_OUT |  |  | - | - | - | - | -
7 | 7 | NRST | Device reset(active low) |  |  |  | NRST | - | NRST | Device Reset | LOW
8 | - | PC0 | - | ADC_IN10 | GPIO_OUT | No-PULL | - | - | - | - | -
9 | - | PC1 | - | ADC_IN11 | GPIO_OUT | No-PULL | ADC_IN11 | No-PULL | BAT_ADC | Battery | -
10 | - | PC2 | SPI2_MISO | ADC_IN12 | GPIO_OUT | No-PULL | ADC_IN12 | No-PULL | BATT_THERM | Battery | -
11 | - | PC3 | SPI2_MOSI | ADC_IN13 |  |  | ADC_IN13 | No-PULL | PLA_CTRL | Plasma Duty Control | -
12 | 8 | VSSA | Analog ground
13 | 9 | VDDA | Analog power supply
14 | 10 | PA0 | USART2_CTS, USART4_TX | ADC_IN0 |  |  | - | - | - | - | -
15 | 11 | PA1 | USART2_RTS, TIM15_CH1N, USART4_RX, | ADC_IN1 |  |  | - | - | - | - | -
16 | 12 | PA2 | USART2_TX, TIM15_CH1 | ADC_IN2 |  |  | - | - | - | - | -
17 | 13 | PA3 | USART2_RX, TIM15_CH2 | ADC_IN3 |  |  | - | - | - | - | -
18 | - | VSS | Ground
19 | - | VDD | Digital power supply
20 | 14 | PA4 | SPI1_NSS, TIM14_CH1, USART2_CK,USB_NOE | ADC_IN4 | GPIO_OUT | No-PULL | - | - | - | - | -
21 | 15 | PA5 | SPI1_SCK | ADC_IN5 | GPIO_OUT | No-PULL | - | - | - | - | -
22 | 16 | PA6 | SPI1_MISO, TIM3_CH1, TIM1_BKIN, TIM16_CH1, EVENTOUT, USART3_CTS | ADC_IN6 | TIM3_CH1 | No-PULL | TIM3_CH1 | No-PULL | BUZZER | Buzzer enable | HIGH
23 | 17 | PA7 | SPI1_MOSI, TIM3_CH2, TIM14_CH1, TIM1_CH1N, TIM17_CH1, EVENTOUT | ADC_IN7 | GPIO_OUT | No-PULL | - | - | - | - | -
24 | - | PC4 | EVENTOUT, USART3_TX | ADC_IN14 | GPIO_OUT | No-PULL | - | - | - | - | -
25 | - | PC5 | USART3_RX | ADC_IN15, WKUP5 | GPIO_EXTI5_Falling | PULL-UP | GPIO_EXTI5_Rising | No-PULL | KEY_PWR | Powe On key | HIGH |  | Floating 상태에서 High input시 동작
26 | 18 | PB0 | TIM3_CH3, TIM1_CH2N, EVENTOUT, USART3_CK | ADC_IN8 | GPIO_OUT | No-PULL | GPIO_OUT | No-PULL | PW_CTRL | PS_HOLD | HIGH
27 | 19 | PB1 | TIM3_CH4, USART3_RTS, TIM14_CH1, TIM1_CH3N | ADC_IN9 | GPIO_OUT | No-PULL | GPIO_IN | No-PULL | CHG_STA | Charger |  | ADC
28 | 20 | PB2 | - | - | GPIO_OUT | No-PULL | - | - | - | - | -
29 | 21 | PB10 | SPI2_SCK, USART3_TX | - | GPIO_OUT | No-PULL | - | - | - | - | -
30 | 22 | PB11 | USART3_RX, EVENTOUT, I2C2_SDA | - | GPIO_OUT | No-PULL | - | - | - | - | -
31 | 23 | VSS | Ground
32 | 24 | VDD | Digital power supply
33 | 25 | PB12 | TIM1_BKIN, TIM15_BKIN, SPI2_NSS, EVENTOUT, USART3_CK | - |  |  | GPIO_OUT | PULL-DOWN | CHG_CTRL | Charger | HIGH |  | Battery Temp over시 High
34 | 26 | PB13 | SPI2_SCK, I2C2_SCL, TIM1_CH1N, USART3_CTS | - |  |  | - | - | - | - | -
35 | 27 | PB14 | SPI2_MISO, I2C2_SDA, TIM1_CH2N, TIM15_CH1, USART3_RTS | - |  |  | - | - | - | - | -
36 | 28 | PB15 | SPI2_MOSI, TIM1_CH3N, TIM15_CH1N, TIM15_CH2 | WKUP7, RTC_REFIN | GPIO_EXTI15_Falling | PULL-UP | GPIO_IN | No-PULL | USB_ID | USB | HIGH | GPIO_EXTI15_Falling | RS-232를 USB CON으로 사용시 기능 지원 예정
37 | - | PC6 | TIM3_CH1 | - | GPIO_EXTI6_Falling | PULL-UP | - | - | - | - | -
38 | - | PC7 | TIM3_CH2 | - | GPIO_EXTI7_Falling | PULL-UP | GPIO_IN | No-PULL | USB_DET | USB | HIGH |  | Floating 상태에서 High input시 동작
39 | - | PC8 | TIM3_CH3 | - | GPIO_EXTI8_Falling | PULL-UP | - | - | - | - | -
40 | - | PC9 | TIM3_CH4 | - | GPIO_EXTI9_Falling | PULL-UP | - | - | - | - | -
41 | 29 | PA8 | USART1_CK, TIM1_CH1, EVENTOUT, MCO | - |  |  | TIM1_CH1 | n/a | PULSE_OUT1 | Plasma | HIGH
42 | 30 | PA9 | USART1_TX, TIM1_CH2, TIM15_BKIN, I2C1_SCL | - | GPIO_IN | PULL-UP | USART1_TX | n/a | USART1_TX | RS-232 external interface | DATA
43 | 31 | PA10 | USART1_RX, TIM1_CH3, TIM17_BKIN, I2C1_SDA | - | GPIO_OUT | No-PULL | USART1_RX | n/a | USART1_RX | RS-232 external interface | DATA
44 | 32 | PA11 | USART1_CTS, TIM1_CH4, EVENTOUT | USB_DM | GPIO_OUT | No-PULL | TIM1_CH4 | n/a | PULSE_OUT2 | Plasma | HIGH
45 | 33 | PA12 | USART1_RTS, TIM1_ETR, EVENTOUT | USB_DP | GPIO_EXTI12_Rising/Falling | PULL-UP | GPIO_OUT | PULL-DOWN | EN_+8V | Boost | HIGH
46 | 34 | PA13 | IR_OUT, SWDIO, USB_NOE | - | SYS_SWDIO | n/a | SYS_SWDIO | n/a | SYS_SWDIO | SW Download | DATA
47 | 35 | VSS | Ground
48 | 36 | VDD | Digital power supply
49 | 37 | PA14 | USART2_TX, SWCLK | - | SYS_SWCLK | n/a | SYS_SWCLK | n/a | SYS_SWCLK | SW Download | CLK
50 | 38 | PA15 | SPI1_NSS, USART2_RX, USART4_RTS, EVENTOUT | - | SPI1 | No-PULL | - | - | - | - | -
51 | - | PC10 | USART3_TX, USART4_TX | - | GPIO_OUT | No-PULL | GPIO_OUT | PULL-DOWN | STA_LED_B | POWER LED-Blue | LOW
52 | - | PC11 | USART3_RX, USART4_RX | - | GPIO_OUT | No-PULL | GPIO_OUT | PULL-DOWN | STA_LED_R | POWER LED-RED | LOW
53 | - | PC12 | USART3_CK, USART4_CK | - | GPIO_OUT | No-PULL | GPIO_OUT | PULL-DOWN | STA_LED_G | POWER LED-Green | LOW
54 | - | PD2 | TIM3_ETR, USART3_RTS | - | GPIO_OUT | No-PULL | - | - | - | - | -
55 | 39 | PB3 | SPI1_SCK, EVENTOUT | - | SPI1 | No-PULL | - | - | - | - | -
56 | 40 | PB4 | SPI1_MISO, TIM17_BKIN, TIM3_CH1, EVENTOUT | - | SPI1 | No-PULL | - | - | - | - | -
57 | 41 | PB5 | SPI1_MOSI, I2C1_SMBA, TIM16_BKIN, TIM3_CH2 | WKUP6 | GPIO_OUT | PULL-Down | - | - | - | - | -
58 | 42 | PB6 | I2C1_SCL, USART1_TX, TIM16_CH1N | - | I2C1 | PULL-UP | - | - | - | - | -
59 | 43 | PB7 | I2C1_SDA, USART1_RX, USART4_CTS, TIM17_CH1N | - | I2C1 | PULL-UP | - | - | - | - | -
60 | 44 | BOOT0 | Boot memory selection |  |  |  | GND |  | GND
61 | 45 | PB8 | I2C1_SCL, TIM16_CH1 | - | GPIO_OUT | No-PULL | GPIO_OUT | PULL-DOWN | OP_LED | Plasma On | HIGH | TIM16_CH1 | KEY_OP Input시 상태 변경
62 | 46 | PB9 | SPI2_NSS, I2C1_SDA, IR_OUT, TIM17_CH1, EVENTOUT | - | GPIO_OUT | No-PULL | GPIO_EXTI9_Falling | PULL-UP | KEY_OP | Plasma On | LOW |  | Normal High에서 Key input시 Low Active
63 | 47 | VSS | Ground
64 | 48 | VDD | Digital power supply

Sheet: Device review
 |  |  |  | 환율 |  | 1100
Function | PN | Vendor | Description | Cost[$] | MOQ | Cost[\] | Agency
DC/DC 3.6V | S-882136AMH-M2LTFG | SII Semiconductor Corporation | Fixed BOOST CHARGE PUMP DC-DC CONVERTER Vout=3.6V Iout=25mA SOT-23-6W | 0.62 |  | 682 | Digikey
 | CAT3200HU2 | Onsemi | ADJ BOOST CHARGE PUMP DC-DC CONVERTER Vout=3.6V Iout=100mA UDFN−8 |  |  | 2300 | ICbanQ
 | MCP1252/3-ADJ | Microchip | ADJ Positive-Regulated Charge Pump DC-DC CONVERTER Vout=3.6V Iout=120mA MSOP−8 |  |  | 1720 | ICbanQ
Charging IC | MCP73831/2-2ACIOT | Microchip | Linear Li-Ion / Li-Polymer Charge Management Controller - 수면안대 |  |  | 750 | ICbanQ
 | MCP73833/4 | Microchip | Linear Li-Ion / Li-Polymer Charge Management Controller w/ temp detect |  |  | 1070 | ICbanQ
MCU | MC96F6332L | ABOV | 8-BIT MICROCONTROLLERS FLASH=32kbytes, XRAM=768bytes, IRAM=256bytes, ADC 12CH, IO 30 Port 32LQFP |  |  |  | ?
 | STM32F070RBT6 | STMicroelectronics | ARM Cortex-M0 Value line, 128 Kbytes Flash, 48 MHz CPU, SMD/SMT |  |  | 3970 | ICbanQ
Boost | TLV61046ADBVR | TI | TLV61046A 28-V Output Voltage Boost Converter with Power Diode and Isolation Switch |  |  | 1300 | Mouser
 | LM27313 | TI | 1.6-MHz Boost Converter With 30-V Internal FET Switch in SOT-23 |  |  | 2190 | ICbanQ
 | LM2735XMF | TI | 1.6-MHz Space-Efficient Boost and SEPIC DC-DC Regulator 24V 2.1A |  |  | 2850 | ICbanQ
Tr | BCW60B | NXP | NPN general purpose transistor |  |  | 210 | ICbanQ
 | PMBT2222 | NXP | NPN general purpose transistor |  |  | 180 | ICbanQ
TACK S/W | ITS-1105-12.5MM | 중국 | TACH Switch, 12.5MM Dip-type |  |  | 600 | INTERPARK
 | ITS-1105-8.0MM-SMD | 중국 | TACH Switch, 8.0MM SMD |  | 10 | 100 | 디바이스마트
 | YST-1102SF | 영성정공 | TACH Switch 6.0x6.0, 8.0MM SMD |  |  | 100 | ic114
 | YST-1102SA | 영성정공 | TACH Switch 6.0x6.0, 5.0MM SMD |  |  | 80 | ic114
RGB LED | LTST-C19HE1WT | LITE-ON | 3 color type LED 4-pin, TOP View, R180mcd, G450mcd, B180mcd |  |  | 720 | ICbanQ
 | ASMT-YTD2-0BB02 | Avago | 3 color type LED 6-pin, TOP View, R745mcd, G1600mcd, B380mcd |  |  | 1990 | ICbanQ
RS-232 | MAX3232ESE | MAXIM | 3.0V to 5.5V, Low-Power, up to 1Mbps, True RS-232 Transceivers Using Four 0.1μF External Capacitors |  |  | 5100 | ICbanQ
 | D-Sub |  | D-SUB PCB용 2-row 9-pin Female Right angle |  |  | 250 | ICbanQ | P005649295
CON | 12512WS-04B | 연호 | 1.25mm pitch Straight CON |  |  | 120 | ic114
DIODE | STPS120M | ST | 1.0 Amp 20 Volt |  |  | 520 | ICbanQ
INDUCTOR | MSS5131-153ML | Coilcraft | INDUCTOR, PWR, 15UH, 1.5A, 20%,32MHZ |  |  | 2150 | ICbanQ
Fuse | F0603E2R50FSTR | AVX |  |  |  | 420 | ICbanQ
LED | 17-21UYC/S530-A3/TR8 | EVERLIGHT | 0805 Package Chip LED Yellow |  |  | 20 | ICbanQ | P005609816
 | 17-21/GHC-YR1S2/3T | EVERLIGHT | 0805 Package Chip LED Green |  |  | 20 | ICbanQ | P005609817
 | 17-21/W1D-ANPHY/3T | EVERLIGHT | 0805 Package Chip LED White |  |  | 40 | ICbanQ | P005609815
Volume | PTV09A-4015U-B103 | BOURNS | Bourns Panel Mount Potentiometers 10K LINEAR 20% |  | 1 | 910 | ICbanQ
Transformer | CTX210605-R | Eaton Corporation | TRANSFORMER CCFL 6W 20V 11MA SMD - packageType=Bulk
 | CTX210607-R | Eaton Corporation | TRANSFORMER CCFL 6W 15V 11MA SMD - packageType=Bulk
 | CTX210411-R | Eaton Corporation | TRANSFORMER CCFL 4W 10V 7MA SMD - packageType=Bulk
 | CTX110607-R | Eaton Corporation | TRANSFORMER CCFL 6W 15V 11MA SMD - packageType=Bulk
MOSFET | IRFS4410PbF | INFINEON | MOSFET, N-CH, 100V, 97A, TO-263 |  | 1 | 3500 | ICbanQ
 | NTD5802N | ON Semiconductor | Power MOSFET 40V, Single N−Channel, 101A DPAK |  | 1 | 1450 | ICbanQ
CAP

Sheet: Boost
Boost
 |  |  | Vin |  | Vout |  | Iout[mA] |  | Iout=100mA | Efficiency[%] |  | Protection |  |  | Package | Size
 |  |  | Min | Max | Min | Max | Min | typ | Vin=3.3V | Min | Max | Short Circuit | Over-Voltage | Thermal Shutdown
 | TLV61046ADBVR | TI | 1.8 | 5.5 | 3.3 | 28 | - | 980 | 82 |  | 85 | OK | OK | OK | SOT23-6 | 2.9x1.6
 | LM27313 | TI | 2.7 | 14 | - | 30 | 800 | 1250 | 78 |  |  | OK | - | OK | SOT23-5 | 2.9x1.6
 | LM2735XMF | TI | 2.7 | 5.5 | 3 | 24 | 2100 | 3000 | 86 |  |  | OK | - | OK | SOT23-5 | 2.9x1.6
TLV61046ADBVR
 | The TLV61046A has an internal default 12-V output voltage setting by connecting the FB pin to the VIN pin.
LM27313
LM2735XMF
 |  |  |  |  |  |  |  | Vout | 8 | V
 |  |  |  |  |  |  |  | Vref | 1.255 | V
 |  |  |  |  |  |  |  | R1 | 1 | KΩ
 |  |  |  |  |  |  |  | R2 | 5.374501992 | KΩ
 |  |  |  |  |  |  |  | Fzero | 5 | KHz
 |  |  |  |  |  |  |  | C3 | 5.925597163 | nF
 | switching frequency : 520 kHz or 1.6 MHz
 | current-mode control
 | Control Logic이 High 인경우, Device shotdown됨 : EN=Low, Thermal=High, Vin<2.3V, I_limit=High
 | Vin | 5 | 5 | 3.3 | 3.3 | 3.3 | 3.3 | 3.3 | 3.3 | LM2735Y (520 kHz)
 | Vout | 12 | 12 | 12 | 12 | 5 | 5 | 20 | 20 | LM2735X (1.6 MHz)
 | Iout | 350 | 350 | 350 | 350 | 500 | 750 | 100 | 100
 | LM2735 Type | X | Y | X | Y | X | Y | X | Y
 | C1, Input Capacitor | 22 | 22 | 22 | 22 | 10 | 22 | 22 | 22 | uF, 6.3V, X5R
 | C2 Output Capacitor | 10 | 10 | 10 | 10 | 10 | 22 | 4.7 | 10 | uF, 25V, X5R
 | C3 Comp Capacitor | 330 | 330 | 330 | 330 | 1000 | 1000 | 470 | 470 | pF
 | D1, Catch Diode | STPS120M | STPS120M | STPS120M | STPS120M | STPS120M | STPS120M | STPS120M | STPS120M | 0.4 Vf Schottky 1 A, 20 VR
 | L1 | 15 | 33 | 6.8 | 15 | 10 | 22 | 10 | 33 | μH 1.5 A
 | R1 | 10.2 | 10.2 | 10.2 | 10.2 | 10 | 10 | 10 | 10 | kΩ, 1%
 | R2 | 86.6 | 86.6 | 86.6 | 86.6 | 30.1 | 30.1 | 150 | 150 | kΩ, 1%
 | R3 | 100 | 100 | 100 | 100 | 100 | 100 | 100 | 100 | kΩ, 1%
 |  |  |  |  |  |  |  |  |  |  | Vout Calculation
 |  |  |  |  |  |  |  |  |  |  | Vout | 8 | 8 | 12 | 8.283 | 8.032 | V
 |  |  |  |  |  |  |  |  |  |  | Vref | 1.255 | 1.255 | 1.255 | 1.255 | 1.255 | V
 |  |  |  |  |  |  |  |  |  |  | R1 | 11 | 10 | 10.2 | 10 | 10 | KΩ
 |  |  |  |  |  |  |  |  |  |  | R2 | 59.12 | 53.75 | 87.33 | 56.00 | 54.00 | KΩ
 |  |  |  |  |  |  |  |  |  |  | Fzero | 5 | 5 | 5 | KHz
 |  |  |  |  |  |  |  |  |  |  | C3 | 0.5386906512 | 0.5925597163 | 0.3646762549 | nF
 | Function | PN | Vendor | Description | Cost[$] | Cost[\] | Agency
 | Boost | LM2735XMF | TI | 1.6-MHz Space-Efficient Boost and SEPIC DC-DC Regulator 24V 2.1A |  | 2850 | ICbanQ
 |  | STPS120M | ST | 1.0 Amp 20 Volt |  | 520 | ICbanQ
 |  | MSS5131-153ML | Coilcraft | INDUCTOR, PWR, 15UH, 1.5A, 20%,32MHZ |  | 2150 | ICbanQ

Sheet: RS-232
MAX3232ESE
 | 3.0V to 5.5V, Low-Power, up to 1Mbps, True RS-232 Transceivers Using Four 0.1μF External Capacitors

Sheet: Volume
V | 3.3
Rvar | R | Vadc
1 | 10 | 0.165
2 | 10 | 0.33
3 | 10 | 0.495
4 | 10 | 0.66
5 | 10 | 0.825
6 | 10 | 0.99
7 | 10 | 1.155
8 | 10 | 1.32
9 | 10 | 1.485
10 | 10 | 1.65

Sheet: Current
LED Current
 | V | 3.3 | 3.3 | V
 | R | 470 | 410 | Ω
 | I | 7.02 | 8.05 | mA | DVM 측정치
 |  |  |  |  | OFF | 0.31 | mA
 |  |  |  |  | ON | 18.16 | mA
 |  |  |  |  | Plasma On |  |  | 760 | 1200 | 1500 | 4V Power | 8V current
 |  |  |  |  | 1 | 320 | mA | 2.38 | 3.75 | 4.69 | 1280 | 160
 |  |  |  |  | 2 | 640 | mA | 1.19 | 1.88 | 2.34 | 2560 | 320
 |  |  |  |  | 3 | 960 | mA | 0.79 | 1.25 | 1.56 | 3840 | 480
 |  |  |  |  | 4 | 1280 | mA | 0.59 | 0.94 | 1.17 | 5120 | 640
 |  |  |  |  | 5 | 1600 | mA | 0.47 | 0.75 | 0.94 | 6400 | 800
 |  |  |  |  | Vcc | 4 | V
 |  |  |  |  | I_load | 2 | A
 |  |  |  |  | R_load | 2 | Ohm

Sheet: Transformer
Transformer
PN | Vendor | Description | W | Turn | Sch type | PCB type | ME tyep | ICbanQ | 레오콤 | 재고
CTX210411-R | COOPER BUSSMANN | TRANSFORMER CCFL 4W 10V 7MA SMD | 4 | 125 | C | C | C
CTX110607-R | COOPER BUSSMANN | TRANSFORMER CCFL 6W 15V 11MA SMD | 6 | 86 | C | E | E
CTX210605-R | COOPER BUSSMANN | TRANSFORMER CCFL 6W 20V 11MA SMD Turn-R:67 | 6 | 67 | C | C | F | 7960
CTX210607-R | COOPER BUSSMANN | TRANSFORMER CCFL 6W 15V 11MA SMD Turn-R:86 | 6 | 86 | C | C | F | 11100
CTX210609-R | COOPER BUSSMANN | TRANSFORMER CCFL 6W 13V 11MA SMD Turn-R:100 | 6 | 100 | C | C | F |  | 13148 | 68
CTX210611-R | COOPER BUSSMANN | TRANSFORMER CCFL 6W 11V 11MA SMD Turn-R:125 | 6 | 125 | C | C | F |  | 13596 | 품절
CTX210611 | COOPER BUSSMANN | TRANSFORMER CCFL 6W 11V 11MA SMD Turn-R:125 | 6 | 125 | C | C | F |  | 13112 | 119
