ArvidJoung/Plasma_Generator/2_Micro_Plasma_Dispenser/MPD_Review Data_20190117.xlsx

Sheet: Function
 |  | 결정 사항 | Question
Plasma On Key | HP Switch
 | foot Switch | 외부 Case에 미포함 Main PCB에 하네스 연결용 CON만 구현
통신 | RS-232 | 외부 Case에 미포함 Main PCB에 하네스 연결용 CON만 구현
전원 | 외부 USB adaptor | DC Jack adaptor 사용
 | USB CON 실장 위치 | Main PCB | Main PCB or 별도의 PCB
구성 요소 | 본체, Cable, HP body | 일체형 | 일체형 or 분리형
 | S/V | 5V S/V 사용
1. HP:와 본체간 하네스 연결이 되어야 합니다. 이미지 상으로는 보이지 않네요.
2. 외부 젅원 연결하는 부분이 보이지 않습니다. USB port 있어야 합니다.
3. RS-232 지원 방법 - 추후 하네스로 Case의 CON와 연결되도록 설계하도록 하겠습니다.
현재 디자인으로는 RS-232 CON를 PCB에 실장이 안됩니다.
4. Foot S/W DC Jack type으로 설계?

Sheet: Block Diagram
DC1 |  | CN102 |  | CN102
DC-005 |  | MOLEX5267-6P |  | MOLEX-53398-0671
1 | +5V | 1 | +8.0V | 1 | +8.0V
2 | GND | 2 | PULSE_OUT1 | 2 | PULSE_IN1
3 | GND | 3 | PULSE_OUT2 | 3 | PULSE_IN2
 |  | 4 | GND | 4 | GND
 |  | 5 | SHOT_SW_IN | 5 | KEY_OP
CN101 |  | 6 | GND | 6 | GND
MOLEX5267-2P
1 | +5V | CN103 |  | CN200
2 | GAS_EN | MOLEX5267-5P |  | MX-53047-0510
 |  | 1 | +5V | 1 | +5V
 |  | 2 | KEY_PWR | 2 | KEY_PWR
COM1 |  | 3 | KEY_UP | 3 | KEY_UP
MOLEX5267-3P |  | 4 | KEY_DOWN | 4 | KEY_DOWN
1 | RS232_RX | 5 | GND | 5 | GND
2 | RS232_TX
3 | GND | CN104 |  | CN300
 |  | MOLEX5267-6P |  | MOLEX5267-6P
 |  | 1 | +3.3V | 1 | +3.3V
CN105 |  | 2 | STA_LED_G | 2 | STA_LED_G
MOLEX5267-2P |  | 3 | OP_LED | 3 | OP_LED
1 | SHOT_SW_IN | 4 | LED_HIGH | 4 | LED_HIGH
2 | GND | 5 | LED_MED | 5 | LED_MED
 |  | 6 | LED_LOW | 6 | LED_LOW

Sheet: Issue
No | Date | PCB | Status | Issue | Description
1 | 2019-09-08 | CPU | OPEN | S/V VCC 전압 결정 | - Pipette은 3VDC 사용 - MPD : 5VDC 사용으로 설계
2 | 2019-09-08 | TRANS | OPEN | HP Cable이 HP에서 고정이 안되는 경우, Cable과 연결되는 CON는 hook가 있는 type으로 변경 필요 | Cable이 당겨지는 경우, CON가 빠진다.

Sheet: ADC
 | R7 | 10 | R7 | 30 | R7 | 10 | KΩ
 | R8 | 30 | R8 | 30 | R8 | 30 | KΩ
VCC
6.0 | 4.50 | 347.7272727 | 3.00 | 231.8181818 | V_Batt | V_ADC | ADC
5.9 | 4.42 | 341.9318182 | 2.95 | 227.9545455 | 4.2 | 3.15 | 243.4090909
5.8 | 4.35 | 336.1363636 | 2.90 | 224.0909091 | 4.1 | 3.07 | 237.6136364
5.7 | 4.28 | 330.3409091 | 2.85 | 220.2272727 | 4.0 | 3.00 | 231.8181818
5.6 | 4.20 | 324.5454545 | 2.80 | 216.3636364 | 3.9 | 2.92 | 226.0227273
5.5 | 4.12 | 318.75 | 2.75 | 212.5 | 3.8 | 2.85 | 220.2272727
5.4 | 4.05 | 312.9545455 | 2.70 | 208.6363636 | 3.7 | 2.77 | 214.4318182
5.3 | 3.98 | 307.1590909 | 2.65 | 204.7727273 | 3.6 | 2.70 | 208.6363636
5.2 | 3.90 | 301.3636364 | 2.60 | 200.9090909 | 3.5 | 2.62 | 202.8409091
5.1 | 3.83 | 295.5681818 | 2.55 | 197.0454545 | 3.4 | 2.55 | 197.0454545
5.0 | 3.75 | 289.7727273 | 2.50 | 193.1818182 | 3.3 | 2.48 | 191.25
4.9 | 3.67 | 283.9772727 | 2.45 | 189.3181818
4.8 | 3.60 | 278.1818182 | 2.40 | 185.4545455
4.7 | 3.52 | 272.3863636 | 2.35 | 181.5909091
4.6 | 3.45 | 266.5909091 | 2.30 | 177.7272727
4.5 | 3.38 | 260.7954545 | 2.25 | 173.8636364
4.4 | 3.30 | 255 | 2.20 | 170
4.3 | 3.23 | 249.2045455 | 2.15 | 166.1363636
4.2 | 3.15 | 243.4090909 | 2.10 | 162.2727273
4.1 | 3.08 | 237.6136364 | 2.05 | 158.4090909
4.0 | 3.00 | 231.8181818 | 2.00 | 154.5454545
3.9 | 2.93 | 226.0227273 | 1.95 | 150.6818182
3.8 | 2.85 | 220.2272727 | 1.90 | 146.8181818

Sheet: LM2735
Vout에 대한 R2 계산
 | Vout | 8 | 5
 | R1 | 10 | 10
 | R2 | 53.7 | 29.8
R1,R2에 대한 Vout 계산
 | R1 | 10 | 10
 | R2 | 56 | 30
 | Vout | 8.283 | 5.02
