ArvidJoung/Plasma_Generator/0_MP4 Data/Pipette Change list MP4.xlsx

Sheet: Main MP2
No | Date | Category | Reference | Before | After | BOM | COMMENT
1 | 2018-12-26 | PCB | J3 | GND PAD에 VIA 4ea | PAD Side로 이동 | - | SMT 개선
2 |  | PCB | J1 | GND PAD에 VIA | PAD Side로 이동 | -
3 |  | PCB | SW1 | GND PAD에 VIA | PAD Side로 이동 | -
4 |  | PCB | C18 | +3.3V PAD에 VIA | PAD Side로 이동 | -
5 |  | PCB | U4 | V_BATT PAD에 VIA | PAD Side로 이동 | -
6 |  | PCB | D2 | GND PAD에 VIA | PAD Side로 이동 | -
7 |  | SCH | Q3 | PMBT2222 | FTK2306 | OK | S/V Not operation 개선
8 | 2019-01-13 | SCH&PCB | C9 | - | 4.7uF/25V 1608 | OK | Plasma Off 안되는 문제 개선
9 |  | SCH&PCB | D5 | - | BZT52C5V1S | OK
10 |  | SCH&PCB | D6 | - | S1M | - | Reset시 S/V On 상태 유지하는 문제 개선
11 | 2019-01-15 | SCH&PCB | D6 | S1M | 1N4148WS | OK | S/V Not operation 개선
12 |  | SCH | R31 | 10K | 100 | OK
13 |  | SCH&PCB | R34 | - | 10K | OK
14 | 2019-02-26 | SCH&PCB | BATT | 053048-0210 | MOLEX5268-02P | OK | 3A 지원 CON로 변경
15 |  | SCH&PCB | U4 | LM2735XMF | LM2735XSD | OK | CHIP 발열 개선을 위해 Package 변경
16 |  | SCH&PCB | R35 | - | NC | OK | Buck Enable Pin에 Pull-Down R 추가
17 | 2019-03-02 | SCH&PCB | J2 | X605SF | MOLEX5268-02P | OK | S/V CON 추가
18 |  | SCH&PCB | R36 | - | 0 | OK | KEY_OP RC filter 추가 Key 인식 문제시 tune
19 |  | SCH&PCB | C10 | - | NC | OK
20 | 2019-03-16 | PCB |  | - | 3/14 기구 도면 반영 | - | 외곽 형상 및 CON 위치 변경
21 |  | SCH | J1 | DC-011C_SMD | NC | OK
22 |  | PCB | - | - | Battery Silk line 추가 | -

Sheet: Main MP3
No | Date | Category | Reference | Before | After | BOM | COMMENT
1 | 2019-04-11 | SCH&PCB | BATT | Pin-1 : GND, Pin-2 : VCC | Pin-1 : VCC, Pin-2 : GND | - | Femto 요청
2 |  | PCB | BATT | 상단 결합 | 하단 결합 - 180도 회전 | - | Femto 요청
3 |  | PCB | J2 | 상단 결합 | 하단 결합 - 180도 회전 | - | Femto 요청
4 |  | PCB | D6 |  | PAD 간격 축소 | - | 업체 요청
5 |  | PCB | POWER, UP, DOWN |  | PAD Size 확대 | - | 업체 요청
6
7
8
9
10
11
12
13
14
15
16
17
18
19
20
21
22

Sheet: Main MP4
No | Date | Category | Reference | Before | After | BOM | COMMENT
1 | 2019-05-21 | SCH&PCB | D1 | STPS120M | SS1020 |  | 5/10 Femto 요청
2 |  | PCB | D3, D4, D5 | - | Diode silk 표시 추가
3 |  | PCB | D6 | - | Diode silk 표시 추가
4 |  | PCB |  | - | Femto Science Inc. silk 추가
5 | 2019-06-10 | SCH | R18,R27,R36 | 0 | 100 |  | RF Noise로 인한 Key 인식 오류 개선
6 |  |  | C10 | NC | 0.1uF
7
8
9
10
11
12
13
14
15
16
17
18
19
20
21
22

Sheet: Trans MP2
No | Date | Category | Reference | Before | After | COMMENT
1 | 2018-12-26 | PCB | J1 | GND PAD에 VIA | PAD Side로 이동 | SMT 개선
2 |  | PCB | SW1 | GND PAD에 VIA | PAD Side로 이동
3 |  | PCB | C1 | GND PAD에 VIA | PAD Side로 이동
4 |  | PCB | Q1,Q2 | GND PAD에 VIA | PAD Side로 이동
5 |  | PCB | TX1 | - | Board Cut out 추가
6 |  | SCH | TX1 | - | Gate Decal 수정 및 Pin re-assign
7 | 2019-03-06 | PCB |  |  | Board Cut out 영역 축소-Bobbin에 맞춰 조정
8 |  | PCB |  |  | Cutting line 표시
9
