ArvidJoung/Plasma_Generator/0_DOC/Plasma_Gen_Transformer_비용_20180212.xlsx

전체 소모비용
Item | Description | 수량 | 단가 | 전체비용 | Comment
PCB Layout | MCU board Layout 설계비 | 3 | 250000 | 750000 | 3일 x 250,000(일비)
SMT 비용 | Manual 납땜으로 작업(시험용) | 8 | 10000 | 80000 | 8set 제작
전체 비용 |  |  |  | 830000
