ArvidJoung/Plasma_Generator/0_DOC/Plasma_Gen_Functioin List_20180104.xlsx

Sheet: Function List
Function List V1.0
No | Function | 수량 | External Only | Description | MCU Interface |  | Device
1 | MCU | 1 |  | Main Control | - | - | STM32F070RBT6
2 | 전원 Key | 1 | NC | 전원 On/Off Control | GPIO_EXTI_Rising | INPUT | YST-1102SF
3 | 전원 LED | 1 |  | 전원 상태 표시 RGB LED Low battery 상태 표시 - 완충(Green) / normal(Blue) / 충전(RED) / low battery(Red Blink) | GPIO_OUT 3ea | OUTPUT | ASMT-YTD2-0BB02
4 | Plasma Key | 1 | NC | Plasma On/Off control | GPIO_EXTI_Rising | INPUT | YST-1102SF
5 | Plasma ON LED | 1 |  | Plasma 동작 상태 표시 LED | GPIO_OUT | OUTPUT | 17-21/W1D-ANPHY/3T
6 | Volume Key | 1 | NC | Plasma On time 조정 | ADC_IN | INPUT | PTV09A-4020U-B103
7 | Buzzer | 1 | NC | 알람 사운드용 부져 - Power On/Off - Plasma On | TIMER | OUTPUT | BPE-1407P-40
8 | Main 전원 | 1 |  | Board Main 전원용 DC/DC Converter 3.3V의 고정 전압 사용 | GPIO_OUT | OUTPUT | LM3671MF-3.3
9 | 충전 IC | 1 | NC | Battery 4.2V까지 충전을 위한 IC - 충전 Status Pin | GPIO_IN | INPUT | MCP73831T-2ACI/OT
10 | USB CON | 1 |  | Battery 충전용 | - | - | HI05-AG0272
11 | RS-232 Interface | 1 |  | Board Control를 위한 Interface - 9-pin D-Sub CON - option으로 USB D+/D-도 사용가능하도록 설계 | USART1 | IN/OUT | MAX3232CSE
12 | D-Sub CON | 1 |  | RS-232용 커넥터 | - | - | DSBU-9PIN-R/A
13 | Plasma 전원 | 1 |  | 플라즈마 생성을 위한 승압용 Boost Converter Transformer 전압용 - 8V , 1A 이상 | GPIO_OUT | OUTPUT | LM2735XMF
14 | Plasma CON | 1 |  | Transformer 연결을 위한 커넥터 | TIMER 2ea | OUTPUT | 12512WS-04B
15 | Battery CON | 1 | NC | Normal 3.7V 670mAh 충전지 연결용 커넥터 - Battery thermistor Pin ( Battery temp check ) |  | INPUT | 12512WS-04B
16 | Battery ADC check | 1 | NC | Battery voltage 상태 check - Battery Voltage monitor Pin | GPIO_IN | INPUT | -
17 | Battery temp ADC | 1 | NC | Battery temp check | ADC_IN | INPUT | -
18 | JTAG CON | 1 |  | F/W download용 커넥터 | SWDIO SWCLK | IN/OUT CLOCK | 12512WS-04B
19 | Reset Key | 1 |  | System halt시 사용 | NRST | INPUT | CTT-1139P1

Sheet: Function Description
Function List V1.0 |  |  |  | 기능검사
No | Function | Description | Operation | H/W | S/W | Comment
1 | 전원 Key | 전원 On/Off Control | Off 상태에서 KEY를 3sec 이상 누른 경우 Power On | OK | OK
 |  |  | On 상태에서 KEY를 3sec 이상 누른 경우 Power Off | OK | OK
2 | 전원 LED | 전원 On/Off 상태 표시 충전 및 충전지 상태 표시 | Normal 상태 - BLUE LED | OK | OK
 |  |  | 완충 상태 - Green LED | OK | OK
 |  |  | 충전 상태 - RED LED | OK | OK
 |  |  | Low battery - Red Blink | OK | OK
3 | Reset Key | System halt시 사용 | H/W reset | OK | OK
4 | Plasma Key | Plasma On/Off control | +8V On / Off control | OK | OK
 |  |  | PWM Pulse 1,2 (80KHz) On/Off control | OK | OK
5 | Plasma ON LED | Plasma 동작 상태 표시 LED | Plasma On시 LED ON | OK | OK
6 | Volume Key | Plasma On time을 5단계로 조정 | Level-1 : 2msec On / 8msec Off | OK | OK
 |  |  | Level-2 : 4msec On / 6msec Off | OK | OK
 |  |  | Level-3 : 6msec On / 4msec Off | OK | OK
 |  |  | Level-4 : 8msec On / 2msec Off | OK | OK
 |  |  | Level-5 : 항상 On ( 10msec On / 0msec Off ) | OK | OK
7 | Buzzer | 알람 사운드용 Buzzer - Power On/Off 상태 알람 - Plasma On 상태 알람 | Power On : Sound 1 | OK | OK
 |  |  | Power Off : Sound 2 | OK | OK
 |  |  | Plasma On : Sound 3 | OK | OK
8 | Battery | 4.2V 1A 이상 사용 | Battery CON 지원 | OK | OK
 |  |  | Battery voltage 상태 check를 위한 ADC monitor - 완충 : 4.2V - Low battery : 3.4V | On going | On going | ADC optimize 필요
 |  | thermistor Pin 지원 | Battery 온도 monitor를 위한 ADC monitor | On going | On going | ADC optimize 필요
9 | 충전 IC | Battery 4.2V까지 충전을 위한 IC | USB CON을 통해 충전 | OK | OK
 |  |  | 충전/완충 상태 monitor | OK | OK
 |  |  | 충전중 Battery 온도 Over시 충전 차단 - operating temperature range : -10℃ ~ 60℃ | On going | On going | ADC optimize 필요
10 | DC/DC Converter | Main 전원 | 3.3V의 고정 전압 사용 | OK | OK
 |  | Plasma 전원 - Transformer 전압용 | Transformer 연결을 위한 커넥터 | OK | OK
 |  |  | 플라즈마 생성을 위한 승압용 Boost Converter - 8V , 1A 이상 | On going | OK | H/W optimize 필요
11 | RS-232 Interface | Board Control를 위한 Interface | 9-pin D-Sub CON | OK | OK
 |  |  | Option : USB D+/D-도 사용가능하도록 설계 | On going | On going | 기능 구현 필요
12 | JTAG CON | F/W download용 커넥터 | 4-Pin CON 지원 ( w/o RESET-Pin ) | OK | OK

Sheet: Flow chart
Plasma Generator flow chart

Sheet: Sheet1
Plasma Gen
 | V1.0 | Transformer Output check후 마무리
 | V2.0 | Battery type 과 External Only type 2개 model로 진행
 |  | F/W는 하나의 version으로 진행
 |  | H/W model 구별을 위한 ID pin 추가
 |  | Gas 주입 인식을 위한 GPIO 신호 추가 - 외부에서 입력됨
 |  | M/E data 입수 후 진행 1) PCB 외곽 모양 2) Volume 및 Key 위치 3) Top / Bottom 부품 높이 정보 4) Battery CON 변경 여부 ( 변경시 CON PN 정보 필요)
 |  | PCB 설계 및 제작 : 4주 ( 각 1ea )
Plasma LF
 | V1.0 | MCU PCB 제작
 |  | 요청 자료 - RS-232 통신 : R/Tx data 정보 - ADC : 기능 및 data 처리 방법 - G17 : 기능 및 처리 방법
 |  | TMS320F2808 Board 입수 - CON type : 2.00mm pitch

Sheet: Function Description (2)
Function List V1.0 |  |  |  |  | 기능검사
No | Function | External Only | Description | Operation | H/W | S/W | Comment
1 | 전원 Key | NC | 전원 On/Off Control | Off 상태에서 KEY를 3sec 이상 누른 경우 Power On | OK | OK
 |  |  |  | On 상태에서 KEY를 3sec 이상 누른 경우 Power Off | OK | OK
2 | 전원 LED | - | 전원 On/Off 상태 표시 충전 및 충전지 상태 표시 | Normal 상태 - BLUE LED | OK | OK
 |  |  |  | 완충 상태 - Green LED | OK | OK
 |  |  |  | 충전 상태 - RED LED | OK | OK
 |  |  |  | Low battery - Red Blink | OK | OK
3 | Reset Key | - | System halt시 사용 | H/W reset | OK | OK
4 | Plasma Key | NC | Plasma On/Off control | +8V On / Off control | OK | OK
 |  |  |  | PWM Pulse 1,2 (80KHz) On/Off control | OK | OK
5 | Plasma ON LED | - | Plasma 동작 상태 표시 LED | Plasma On시 LED ON | OK | OK
6 | Volume Key | NC | Plasma On time을 5단계로 조정 | Level-1 : 2msec On / 8msec Off | OK | OK
 |  |  |  | Level-2 : 4msec On / 6msec Off | OK | OK
 |  |  |  | Level-3 : 6msec On / 4msec Off | OK | OK
 |  |  |  | Level-4 : 8msec On / 2msec Off | OK | OK
 |  |  |  | Level-5 : 항상 On ( 10msec On / 0msec Off ) | OK | OK
7 | Buzzer | NC | 알람 사운드용 Buzzer - Power On/Off 상태 알람 - Plasma On 상태 알람 | Power On : Sound 1 | OK | OK
 |  |  |  | Power Off : Sound 2 | OK | OK
 |  |  |  | Plasma On : Sound 3 | OK | OK
8 | Battery | NC | 4.2V 1A 이상 사용 | Battery CON 지원 | OK | OK
 |  |  |  | Battery voltage 상태 check를 위한 ADC monitor - 완충 : 4.2V - Low battery : 3.4V | On going | On going | ADC optimize 필요
 |  |  | thermistor Pin 지원 | Battery 온도 monitor를 위한 ADC monitor | On going | On going | ADC optimize 필요
9 | 충전 IC | NC | Battery 4.2V까지 충전을 위한 IC | USB CON을 통해 충전 | OK | OK
 |  |  |  | 충전/완충 상태 monitor | OK | OK
 |  |  |  | 충전중 Battery 온도 Over시 충전 차단 - operating temperature range : -10℃ ~ 60℃ | On going | On going | ADC optimize 필요
10 | DC/DC Converter | - | Main 전원 | 3.3V의 고정 전압 사용 | OK | OK
 |  |  | Plasma 전원 - Transformer 전압용 | Transformer 연결을 위한 커넥터 | OK | OK
 |  |  |  | 플라즈마 생성을 위한 승압용 Boost Converter - 8V , 1A 이상 | On going | OK | H/W optimize 필요
11 | RS-232 Interface | - | Board Control를 위한 Interface | 9-pin D-Sub CON | OK | OK
 |  |  |  | Option : USB D+/D-도 사용가능하도록 설계 | On going | On going | 기능 구현 필요
12 | JTAG CON | - | F/W download용 커넥터 | 4-Pin CON 지원 ( w/o RESET-Pin ) | OK | OK
