ArvidJoung/Plasma_Generator/0_DOC/Plasma_Gen_Q&A_list_20180202.xlsx

Sheet: 1월12일 meeting
1/12 meeting 협의 사항
1. Plasma Generator V2.0
 | M/E | Schematic V2.0으로 진행시 M/E part 반영 가능 여부 - Volume / Power key / Plasma key / Reset key | Femto Science에서 전달 예정 "Plasma_Gen" sheet에 list-up
 |  | M/E 구조에 따른 V2.0 수정 요청 사항 여부 - PCB size 및 외곽 모양 - 부품 높이 | Femto Science에서 전달 예정 "Plasma_Gen" sheet에 list-up
 |  | Battery 형상 및 CON type 협의 - Battery size : L x W x H - Battery 용량 : size에 맞춰 결정해야 함 - Battery current : 1A 이상 - 사용품 사용시 사용품에 맞춰 CON 결정해야 함 | Femto Science에서 사용품 사용 여부 판단 "Plasma_Gen" sheet에 list-up
 | H/W | RS-232 CON type 변경 여부 - D-Sub 9-pin : PCB size가 커짐 - USB Data line : RS-232 통신용 젠더 제작이 필요함 | Femto Science에서 전달 예정 "Plasma_Gen" sheet에 list-up
 |  | 양산시 필요한 기능 - H/W version 관리 - D/L나 board test를 위한 Test Pin | model 구별을 위한 ID Pin 추가 나머지 항목은 "Plasma_Gen" sheet에 list-up
 | F/W | RS-232 Control를 위한 Command list 필요 | Femto Science에서 전달 예정 "Plasma_Gen" sheet에 list-up
 | 추가 협의 사항
 |  | 1. Battery type 과 External Power Only type 2개 model로 진행
 |  | 2. F/W : 하나의 version으로 진행하며, H/W ID로 구별함
 |  | 3. Gas 주입 인식을 위한 GPIO 신호 추가 - 외부에서 입력됨
1. Plasma LF V1.0
 | MCU PCB 제작
 | 요청 자료
 |  | - RS-232 통신 : R/Tx data 정보
 |  | - ADC : 기능 및 data 처리 방법
 |  | - G17 : 기능 및 처리 방법

Sheet: 2월1일 meeting
2/1 meeting 협의 사항
1. Plasma Generator V2.0 Pipette type
 | M/E | Volume, Power Key를 4pole slide key로 변경 Right angle type 좌측 side에 배치
 |  | LED : Status 및 Plasma On 표시 Top 위쪽에 배치
 |  | Plasma On Key - Top 위쪽에 배치
 |  | USB CON - Top 위쪽에 배치
 | H/W | PCB를 Pipette sample size에 조립 가능하도록 폭을 줄임
 |  | Buzzer, RS-232 CON 제거
 |  | Solenoid valve Spec 검토 - 3V S/V의 압력 Spec이 상대값인지 절대값인지 확인 | 상대 value로 3V 사용 가능
 |  | Battery 용량 및 견적 조사하여 Femto에 전달
 |  | Transformer 회로 설계 진행 | PCB artwork에 대한 추가 작업 비용 필요
 |  | 소모전류 검토 - 시제품 transformer base로 검토 - S/V 사용시 소모전류 검토 : S/V 입고 후 진행
 |  | DC/DC Converter의 전압 조정으로 50W까지 Power 조정 가능 여부 검토
1. Plasma Generator V2.0 Normal type
 | H/W | 외부 통신을 USB로 변경
 |  | Header에 대한 분리 검토 1. transformer + probe 2. probe only
2. Plasma LF V1.0
 | H/W | Pulse generaion용 MCU의 통신 및 기능은 기존 시제품에 대한 실험을 통해 진행
 |  | Control board 수정 검토 - SMD type으로 부품 변경 | PCB artwork에 대한 추가 작업 비용 필요
 |  | Short 상태에 대한 prtection 기능 검토 - current over시 Pulse Off 기능 추가
 | F/W | PC Program upgrade 가능 여부 확인 | 수정시 S/W 작업 비용 추가
 |  | Control board의 MCU 변경 검토 | 수정시 S/W 작업 비용 추가 Pulse generaion용 MCU에 비해 기능이 많아 비용 상승 고려해야 함

Sheet: Plasma_Gen
Plasma Generator V2.0
No | Date | Item | Status | Question | Answer | Comment
1 | 2018-01-12 | M/E | CLOSED | PCB 외곽 모양 및 조립용 Hole 위치 및 size 정보 - 2D CAD data | 2/1 - 1차적으로 Pipette sample에 맞춰 배치
2 | 2018-01-12 | M/E | CLOSED | Volume 및 Key(전원, Plasma, Reset) 위치 정보 - 2D CAD data | 2/1 - 1차적으로 Pipette sample에 맞춰 배치 - Volume 및 전원 Key를 Slide type의 Key로 변경 - Level 1 : Off - Level 2 : Plasma Low Power - Level 3 : Plasma Med Power - Level 4 : Plasma High Power
3 | 2018-01-12 | M/E | CLOSED | LED(전원, Plasma) 위치 정보 - 2D CAD data | 2/1 - 1차적으로 Pipette sample에 맞춰 배치
4 | 2018-01-12 | M/E | CLOSED | Top / Bottom 부품 높이 정보 | 2/1 - 1차적으로 Pipette sample에 맞춰 배치
5 | 2018-01-12 | M/E | CLOSED | Connector(USB, RS232, Battery, Transformer) 위치 정보 - 2D CAD data | 2/1 - 1차적으로 Pipette sample에 맞춰 배치
6 | 2018-01-12 | M/E | CLOSED | Battery 상용품 사용 여부 판단 - 사용품 사용시 : CON 정보 필요 - 사용품 미사용시 : Battery 제작업체에 PCB에서 사용하는 CON 정보 전달 필요 | - | 2/1 - 1차적으로 Pipette sample에 맞춰 견적 및 용량 확인
7 | 2018-01-12 | H/W | CLOSED | RS-232 통신용 CON type 결정 필요 - Case 1 : 기존 USB CON를 이용하여 전원 공급 및 RS-232 통신 지원 - Case 2 : RS-232 통신용 소형 CON 사용, USB는 External 전원 공급용으로 사용 | 2/1 - USB 통신으로 변경 | 제안 : USB CON 하나로 RS-232 통신과 External 전원 공급 지원
8 | 2018-01-12 | H/W | Closed | 양산시 필요한 기능 - H/W version 관리 | model 구별을 위한 ID pin 추가 | Battery 사용 model과 External Power model 구별
9 | 2018-01-12 | H/W | OPEN | 양산시 필요한 기능 - D/L나 board test를 위한 Test Pin |  | 생산라인에서 F/W download와 Board test를 위해 필요한 Pin들에 대한 정보가 필요함.
10 | 2018-01-12 | F/W | CLOSED | RS-232 Control를 위한 Command list 필요 R/Tx data에 필요한 정보 list table | 2/1 - USB 통신으로 변경 | HMI나 control program과 통신을 위한 S/W interface 정보
11 | 2018-01-14 | H/W | CLOSED | Gas 주입 인식을 위한 신호 추가 - 2개의 wire 필요 - GPIO 신호 type : Gas Off : Open Gas On : GND | 2/1 - MCU에서 Gas control용 S/V control | Main PCB에서 GND와 GPIO Pull-up line이 외부 Gas 주입 장비와 연결이 되어야 하며, 두 선이 Gas 주입 전에는 Open 상태를 유지하다 Gas 주입시 연결(Short)되어야 함
12 | 2018-01-14 | H/W | CLOSED | External Power model에서 불필요한 기능 확인 - 전원 Key, Plasma Key, Volume Key - Buzzer - 충전 IC, Battery, Battery CON | 2/1 - Pipette 설계 이후 진행 Pipette과 별개의 설계로 진행
13 | 2018-01-14 | H/W | CLOSED | Battery model에서 RS-232 통신 지원 여부 | 2/1 - 지원 안함
14 | 2018-02-01 | H/W | CLOSED | Certification을 받아야 하는 인증 목록 확인 필요 Battery를 사용하는 경우 추가 인증이 있을 수 있음 | 2/1 - 필요 인증 모두 진행 기존 : CE 인증만 진행 | 보통 국가마다 제품 인증이 필요하며, 아래는 전자제품의 경우 받는 인증들임. 장비의 경우는 제가 잘 모릅니다. 국내 : KC 인증 유럽 : EC 인증 미국 : FCC 인증 등등..
15
16
17
18
19
20
21
22
23
24
25
26
27
28

Sheet: Plasma_LF
Plasma LF MCU Board V1.0
No | Date | Item | Status | Question | Answer | Comment
1 | 2018-01-12 | F/W | OPEN | RS-232 통신 : R/Tx data 정보 외부 control box와 통신시 data format에 대한 정보 | 2/1 - PC Program와 기존 SW Download된 MCU board 제공 | - PC의 program와 기존 MCU code를 분석하여 적용 - 추후 debugging을 통해 작업 진행
2 | 2018-01-14 | F/W | OPEN | Main PCB에서 받은 ADC에 대한 기능 설명 및 ADC value에 따른 data 처리 방법 LF Main board의 CAS_6-NP와 연결이 되며, Current에 비례하여 전압이 출력됨 전압 범위에 따라 MCU에서 처리하는 부분이 있을것으로 생각됨 CAS_6-NP의 전압값에 따라 어떤 동작을 해야 되는지 확인 필요함 | 2/1 - Power 값을 PC로 전달 | - PC의 program와 기존 MCU code를 분석하여 적용 - 추후 debugging을 통해 작업 진행
3 | 2018-01-14 | F/W | CLOSED | Main PCB에서 G17(OP-AMP 출력)의 기능 및 처리 방법 CAS_6-NP의 전압값 특정값 이상이면 +5V를 출력하는데, 이때 MCU에서 어떤 동작을 해야하는지 확인이 필요함 | 2/1 - 사용안함
4 | 2018-01-14 | F/W | CLOSED | Main PCB P3, P4 CON에 연결되는 ADC와 GPIO 구현 여부 CON를 통해 외부와 연결되는 부분으로 사용 여부 확인 필요함 ADC 사용시 : 어떤값이 들어오는지와 그 값에 따라 어떤 동작을 해야 되는지 확인 필요함 사용시 GPIO(G27, G15) 사용시 : 외부에서 신호가 입력되는 경우 어떤 동작을 해야 되는지 / MCU에서 신호가 출력되는 경우 어떤 상태에서 High or Low를 출력해야 되는지 확인 필요함 | 2/1 - 사용안함
5 | 2018-01-29 | F/W | CLOSED | J9의 Pin-23,Pin-27에 연결된 Pull-up 저항의 역할 확인 필요함 LF main board에서 4.7K Pull-up 저항과 연결이되며, 이 두개의 Pin으로 확인을 하는 사항이 무엇인지 확인 필요함 | 2/1 - 사용안함
6 | 2018-01-30 | F/W | OPEN | 추가적으로 동작여부 확인이 필요한 기능에 대한 LED 추가 여부 확인 - 현재 +5V, +3.3V(MCU On), Plasma On, RS-232 R/Tx 에 대한 상태에 대해서 LED로 정상 동작여부 확인하도록 했으며, 이외에 추가적으로 필요한 부분 확인 바랍니다.
7 | 2018-02-01 | F/W | CLOSED | Current over시 Pulse Off 기능 추가 | 2/1 - 적용
8
9
10
11
12
13
14
15
16
17
18
19
20
21
22
23
24
25
26
27
28
