ArvidJoung/Plasma_Generator/0_DOC/Plasma_Gen_예상소모비용_20171129.xlsx

Sheet: 전체 비용
전체 소모비용
Item | Description | 수량 | 단가 | 전체비용 | Comment
부품 | MCU board 부품 | 10 | 45000 | 450000
PCB Layout | MCU board Layout 설계비 | 3 | 250000 | 750000 | 3일 x 250,000(일비)
PCB 제작비 | MCU board PCB 제작비(SMT 비용 별도) | 1 | 140000 | 140000 | 2층 높이 1mm(기본 10ea)
SMT 비용 | Manual 납땜으로 작업(시험용) | 3 | 50000 | 150000 | 3set 제작
전체 비용 |  |  |  | 1490000
부품 - 예상 단가이며, 회로작업 완료 후 최종 단가 전달 예정
PCB Layout - 직접 작업 예정이며, 업체 일비 기준이 300,000원임.
PCB 제작비 - 업체에 맡겨야 할 항목으로, PCB layout 완료 후 Gerber를 전달해야 정확한 견적 알 수 있음
SMT 비용 - 시험용으로 내부에서 3set 제작 기준

Sheet: 부품
MCU Board 제작 비용 - 예상금액
NO. | PART NO | Q'ty | unit cost(\) | Total cost(\)
1 | MCU | 1 | 30000 | 30000
2 | C-1005 | 20 | 10 | 200
3 | R-1005 | 20 | 10 | 200
4 | 충전IC | 1 | 1000 | 1000
5 | DC/DC Converter | 1 | 700 | 700
6 | TACT Switch | 2 | 100 | 200
7 | Power Inductor | 1 | 5100 | 5100
8 | 고용량 CAP | 4 | 100 | 400
9 | NPN Transistor | 8 | 165 | 1320
10 | Diode | 3 | 500 | 1500
11 | Transformer | 1 | ? | ?
12 | 기타 IC | 3 | ? | ?
전체비용 |  |  |  | 40620
NO. | PART NO | Q'ty | unit cost(\) | Total cost(\)
1 | MCU | 1 | 30000 | 30000
2 | C-1005 | 20 | 10 | 200
3 | R-1005 | 20 | 10 | 200
4 | 충전IC | 1 | 1000 | 1000
5 | DC/DC Converter | 1 | 2300 | 2300
6 | TACT Switch | 2 | 100 | 200
7 | Power Inductor | 1 | 5100 | 5100
8 | 고용량 CAP | 4 | 100 | 400
9 | NPN Transistor | 8 | 165 | 1320
10 | Diode | 3 | 500 | 1500
11 | Transformer | 1 | ? | ?
12 | 기타 IC | 3 | ? | ?
전체비용 |  |  |  | 42220

Sheet: Function
기능별 설명
 | 시제품 |  |  |  |  | V1.0
 | No | Function | 수량 | Description | Position | No | Function | 수량 | Description | Device
 | 1 | MCU | 1 | Main Control | MCU PCB | 1 | MCU | 1 | Main Control | STM32F070RBT6
 | 2 | 전원 Key | 1 | 전원 On/Off Control | MCU PCB | 2 | 전원 Key | 1 | 전원 On/Off Control
 | 3 | 전원 LED | 1 | 전원 상태 표시 LED | MCU PCB | 3 | 전원 LED | 1 | 전원 상태 표시 RGB LED Low battery 상태 표시 - 완충(Green) / normal(Blue) / low battery(Red)
 | 4 | Mode Key | 1 | 모드 선택 Key | MCU PCB | 4 | Volume Key | 1 | Plasma On time 조정
 | 5 | Mode LED | 3 | 모드 선택상태 표시 LED | MCU PCB | 5 | Mode LED | 3 | 모드 선택상태 표시 LED
 | 6 | 부져 | 1 | 알람 사운드용 부져 | MCU PCB | 6 | 부져 | 1 | 알람 사운드용 부져 | BPE-1407P-40
 | 7 | DC/DC converter | 1 | Board Main 전원용 DC/DC Converter 3.6V의 고정 전압 사용 | MCU PCB | 7 | DC/DC converter | 1 | Board Main 전원용 DC/DC Converter 3.3V의 고정 전압 사용 | LM3671MF-3.3
 | 8 | 충전 IC | 1 | Battery 4.2V까지 충전을 위한 IC | MCU PCB | 8 | 충전 IC | 1 | Battery 4.2V까지 충전을 위한 IC | MCP73831T-2ACI/OT
 | 9 | USB CON | 1 | 충전 및 S/W Download용 CON | USB PCB | 9 | USB CON | 1 | 충전 및 S/W Download용 CON
 | 10 | 상태 LED | 4 | Battery 상태및 충전상태 표시를 위한 LED | USB PCB | 10 | 상태 LED | 4 | Battery 상태및 충전상태 표시를 위한 LED
 | 11 | Transformer | 1 | 플라즈마 생성을 위한 승압용 | 기구물 조립 | 11 | Transformer | 1 | 플라즈마 생성을 위한 승압용
 | 12 | Battery | 1 | Normal 3.7V 670mAh 충전지 | 기구물 조립 | 12 | Battery | 1 | Normal 3.7V 670mAh 충전지 - Battery thermistor Pin ( Battery temp check )
 |  |  |  |  |  | 13 | Battery ADC check | 1 | Battery voltage 상태 check | -
 |  |  |  |  |  | 14 | Battery temp ADC | 1 | Battery temp check | -
 |  |  |  |  |  | 15 | Boost Converter | 1 | Transformer 전압용 - 8V , 1A 이상 | LM2735
 |  |  |  |  |  | 16 | RS-232 Interface | 1 | Board Control를 위한 Interface
