ArvidJoung/Plasma_Generator/2_Micro_Plasma_Dispenser/0_Block Diagram/MPD Block Diagram.xlsx

Sheet: Block Diagram
DC1 |  | CN103 |  | CN200
DC-005 |  | MOLEX-5267-5P |  | MOLEX-5267-5P
1 | +5V | 1 | +5V | 1 | +5V
2 | GND | 2 | KEY_PWR | 2 | KEY_PWR
3 | GND | 3 | KEY_UP | 3 | KEY_UP
 |  | 4 | KEY_DOWN | 4 | KEY_DOWN
JTAG1 |  | 5 | GND | 5 | GND
MOLEX-5267-4P
1 | SYS_SWDIO | CN104 |  | CN300
2 | SYS_SWCLK | MOLEX-5267-6P |  | MOLEX-5267-6P
3 | NRST | 1 | +3.3V | 1 | +3.3V
4 | GND | 2 | STA_LED_G | 2 | STA_LED_G
 |  | 3 | OP_LED | 3 | OP_LED
COM1 |  | 4 | LED_HIGH | 4 | LED_HIGH
MOLEX-5267-3P |  | 5 | LED_MED | 5 | LED_MED
1 | RS232_RX | 6 | LED_LOW | 6 | LED_LOW
2 | RS232_TX
3 | GND
CN105
MOLEX-5267-2P
1 | SHOT_SW_IN
2 | GND
CN101
MOLEX-5267-2P |  | CN102 |  | J1
1 | +5V | MOLEX-5267-6P |  | 053398-0671
2 | GAS_EN | 1 | +8.0V | 6 | +8.0V
 |  | 2 | PULSE_OUT1 | 5 | PULSE_OUT1
 |  | 3 | PULSE_OUT2 | 4 | PULSE_OUT2
S/V |  | 4 | GND | 3 | GND
1 | +5V | 5 | SHOT_SW_IN | 2 | SHOT_SW_IN
2 | GAS_EN | 6 | GND | 1 | GND
Gas OUT |  | Gas OUT |  | Gas OUT
Gas IN

Sheet: Harness
내부 하네스 V1.0
PCB | Ref | CON P/N | PIN # | PIN Name | AWG | Length | PIN # | PIN Name | CON P/N | Ref | PCB
CPU PCB | CN104 | MOLEX-5264-6P | 1 | +3.3V | #26 |  | 1 | +3.3V | MOLEX-5264-6P | CN300 | LED PCB
 |  |  | 2 | STA_LED_G |  |  | 2 | STA_LED_G
 |  |  | 3 | OP_LED |  |  | 3 | OP_LED
 |  |  | 4 | LED_HIGH |  |  | 4 | LED_HIGH
 |  |  | 5 | LED_MED |  |  | 5 | LED_MED
 |  |  | 6 | LED_LOW |  |  | 6 | LED_LOW
CPU PCB | CN103 | MOLEX-5264-5P | 1 | +5V | #26 |  | 1 | +5V | MOLEX-5264-5P | CN200 | KEY PCB
 |  |  | 2 | KEY_PWR |  |  | 2 | KEY_PWR
 |  |  | 3 | KEY_UP |  |  | 3 | KEY_UP
 |  |  | 4 | KEY_DOWN |  |  | 4 | KEY_DOWN
 |  |  | 5 | GND |  |  | 5 | GND
CPU PCB | CN101 | MOLEX-5264-2P | 1 | +5V | #26 | 2,000mm | 1 |  |  |  | S/V
 |  |  | 2 | GAS_EN |  |  | 2
CPU PCB | CN105 | MOLEX-5264-2P | 1 | SHOT_SW_IN | #26 |  | 1 |  |  |  | FOOT S/W
 |  |  | 2 | GND |  |  | 2

Sheet: HP Cable
HP Cable V1.0
PCB | Ref | CON P/N | PIN # | PIN Name | AWG | Length | PIN # | PIN Name | CON P/N | Ref | PCB
CPU PCB | CN102 | MOLEX-5264-6P | 1 | +8.0V | #26 |  | 6 | +8.0V | 51021-0600 | J1 | TRANS PCB
 |  |  | 2 | PULSE_OUT1 |  |  | 5 | PULSE_OUT1
 |  |  | 3 | PULSE_OUT2 |  |  | 4 | PULSE_OUT2
 |  |  | 4 | GND |  |  | 3 | GND
 |  |  | 5 | SHOT_SW_IN |  |  | 2 | SHOT_SW_IN
 |  |  | 6 | GND |  |  | 1 | GND
S/V |  |  | Gas OUT |  |  |  | Gas OUT
