ArvidJoung/Plasma_Generator/1_Plasma_Pipette/4_Review data/Plasma_Pipette Review Data.xlsx

Sheet: 하네스
Battery
Pin-map |  |  |  |  |  | Part List
 | Pin No | Function |  | Pin No | Function | PCB | PN | Vendor | Description
Main PCB V1.0 | 1 | GND | Battery | 1 | GND | Main | 053048-0310 | Molex | 1.25mm Pitch DIP CON, Right Angle 3-Pin
 | 2 | Battery Temp ADC |  | 2 | Battery Temp ADC | 하네스 | 051021-0300 | Molex | 1.25mm Pitch Housing, Female, 3-Pin
 | 3 | Battery Vcc |  | 3 | Battery Vcc |  | 050058-8000 | Molex | 1.25mm Pitch Crimp Terminal, Female, 28-32 AWG
 |  |  |  |  |  |  | 케이블 |  | AWG28
 | Pin No | Function |  | Pin No | Function |  | Battery
Main PCB V2.0 | 3 | GND | Battery | 1 | GND
 | 2 | Battery Temp ADC |  | 2 | Battery Temp ADC | Part List
 | 1 | Battery Vcc |  | 3 | Battery Vcc | PCB | PN | Vendor | Description
 |  |  |  |  |  | Main | 053048-0710 | Molex | 1.25mm Pitch DIP CON, Right Angle 7-Pin
 |  |  |  |  |  | 하네스 | 051021-0700 | Molex | 1.25mm Pitch Housing, Female, 7-Pin
Transformer |  |  |  |  |  |  | 050058-8000 | Molex | 1.25mm Pitch Crimp Terminal, Female, 28-32 AWG
Pin-map |  |  |  |  |  |  | 케이블 |  | AWG28
 | Pin No | Function |  | Pin No | Function |  | 050058-8000 | Molex | 1.25mm Pitch Crimp Terminal, Female, 28-32 AWG
Main PCB V1.0 | 1 | Gas S/V Enable | S/V | 1 | Gas S/V Enable |  | 051021-0500 | Molex | 1.25mm Pitch Housing, Female, 5-Pin
 | 2 | GND |  | 2 | GND | Transformer | 053398-0571 | Molex | 1.25mm Pitch SMD CON, Vertical 5-Pin
 | 3 | Plasma On Key | Transformer PCB V2.0 | 1 | Plasma On Key
 | 4 | GND |  | 2 | GND
 | 5 | PULSE_OUT2 |  | 3 | PULSE_OUT2 | Part List
 | 6 | PULSE_OUT1 |  | 4 | PULSE_OUT1 | PCB | PN | Vendor | Description
 | 7 | +8.0V |  | 5 | +8.0V | Main | DC-011C_SMD |  | DC Power Jack, 0.7 Pie, DC Plug, SMD
 |  |  |  |  |  | 하네스 | NA645 | 라이트컴 | Coms 컨넥터-DC파워 2.5Ø x 0.7(각형)
 | Pin No | Function |  | Pin No | Function |  | 케이블 |  | AWG20
Main PCB V2.0 | 7 | Gas S/V Enable | S/V | 1 | Gas S/V Enable |  | 악어클립 |  | 악어클립 대(검정색)
 | 6 | GND |  | 2 | GND
 | 5 | Plasma On Key | Transformer PCB V2.0 | 1 | Plasma On Key
 | 4 | GND |  | 2 | GND
 | 3 | PULSE_OUT2 |  | 3 | PULSE_OUT2
 | 2 | PULSE_OUT1 |  | 4 | PULSE_OUT1
 | 1 | +8.0V |  | 5 | +8.0V
GND 하네스
Pin-map
 | Pin No | Function |  | Pin No | Function
Main PCB | 1 | PAD - GND
 | 2 | DC Jack detect Pin
 | 3 | Case Pin - GND | GND Cable | 1 | Case Pin - GND
 | 4 | Center Pin - GND |  | 2 | Center Pin - GND
 | 5 | PAD - GND
 | 6 | Hole
 | 7 | Hole
JTAG 하네스
Pin-map
 | Pin No | Function |  | Pin No | Function
Main PCB | 1 | USB VBUS | ST-LINK | 1,2 | MCU VDD
 | 2 | SYS_SWDIO |  | 7 | SYS_SWDIO
 | 3 | SYS_SWCLK |  | 9 | SYS_SWCLK
 | 4 | USB_ID |  | 3 | GND
 | 5 | GND |  | 4 | GND

Sheet: ME Size
Battery 용량
 | 용량 | W | L | H | 체적
 | 2000 | 50 | 60 | 6 | 18000 | SPB605060
 | 750 | 48 | 45 | 3 | 6480
 |  | 20 | 90 | 10 | 18000
 |  | 32 | 51 | 13 | 21216
 |  | W | L | H
 | PCB | 24 | 68 | 1
 | Battery | 20 | 90 | 10
ME | Main | 30 | 100 | 30
 | Sub | 30 | 100 | 30
 | 부품 높이 제한
 |  | Top | 4 | mm
 |  | Bottom | 9 | mm

Sheet: Battery CON
 |  | Body | Spring | Total
9155-000 | AVX | 3 | 2.3 | 5.3
K113868632 | Top-Link |  |  | 5.3
 | Tyco |  |  | 6.2
 |  | 3.45 | 1.45 | 4.9
 |  |  |  |  | 0.089
 |  |  |  |  | 0.204 | 0.182
 |  |  |  |  | 0.115 | 0.11
 |  |  |  |  |  | 0.072

Sheet: Power review
각 Stage별 전압/전류/파워 |  |  |  |  |  |  |  | 각 Block별 소모전류
 | Battery | V_batt | 4 | 4 | 4 | V |  |  |  | Current [mA] | Idle |  | Plasma On
 |  | I_Peak | 2 | 2.5 | 2.5 | A |  |  |  |  | Status | Current[mA] | Status | Current[mA]
 |  | Power_in | 8 | 10 | 10 | W |  | MCU |  | 10 | ON | 10 | ON | 10
 | Booster | V_in | 8 | 8 | 8 | V |  | Status LED |  | 7 | ON | 7 | ON | 7
 |  | I_in | 1 | 1.25 | 1.25 | A |  | Plasma ON LED |  | 7 | OFF | 0 | ON | 7
 | Transformer | Turn ratio | 125 | 392 | 350 |  |  | Power Level LED |  | 18 | ON | 18 | ON | 18
 |  | V_out | 1000 | 3136 | 2800 | V |  | Transformer |  | 2500 | OFF | 0 | ON | 2500
 |  | I_out | 0.008 | 0.00318877551 | 0.003571428571 | W |  | S/V |  | 80 | OFF | 0 | ON | 80
 |  |  |  |  |  |  |  |  |  |  | Total | 35 | Total | 2622
Battery 사용 시간 |  |  |  |  |  |  |  | 각 mode별 current
 | Battery 용량 | 1000 | mAh |  |  |  |  | Idle |  | 35 | mA
 | I_Peak | 2 | 2 | 2 | 2 | 2 | A | Plasma On |  | 2622 | mA
 | On Time | 20 | 40 | 60 | 80 | 100 | %
 | I_average | 400 | 800 | 1200 | 1600 | 2000 | mA | Battery 용량에 따른 사용 시간
 | 사용시간 | 2.5 | 1.25 | 0.8333333333 | 0.625 | 0.5 | Hour | Battery 용량 |  | 1500 | 2000 | 2500 | mAh
 |  |  |  |  |  |  |  | Idle |  | 42.86 | 57.14 | 71.43 | Hour
 | Battery 용량 | 2000 | mAh |  |  |  |  | Plasma On | 20.0 % | 171.6 | 228.8 | 286.0 | Minute
 | I_Peak | 2 | 2 | 2 | 2 | 2 | A |  | 40.0 % | 85.8 | 114.4 | 143.0 | Minute
 | On Time | 20 | 40 | 60 | 80 | 100 | % |  | 60.0 % | 57.2 | 76.3 | 95.3 | Minute
 | I_average | 400 | 800 | 1200 | 1600 | 2000 | mA |  | 80.0 % | 42.9 | 57.2 | 71.5 | Minute
 | 사용시간 | 5 | 2.5 | 1.666666667 | 1.25 | 1 | Hour |  | 100.0 % | 34.3 | 45.8 | 57.2 | Minute
 | Battery 용량 | 2000 | mAh
 | I_Peak | 2.622 | 2.622 | 2.622 | 2.622 | 2.622 | A
 | On Time | 20 | 40 | 60 | 80 | 100 | %
 | I_average | 524.4 | 1048.8 | 1573.2 | 2097.6 | 2622 | mA
 | 사용시간 | 3.814 | 1.907 | 1.271 | 0.953 | 0.763 | Hour
 | 사용시간 | 228.8 | 114.4 | 76.3 | 57.2 | 45.8 | Minute

Sheet: LED
 | Status LED | Plasma LED | Plasma Level LED
 | V1.0 | V1.0 | V1.0 | V2.0
VCC | 3.3 | 3.3 | 3.3 | 3.3 | V
R | 430 | 470 | 470 | 180 | Ω
I | 7.67 | 7.02 | 7.02 | 18.33 | mA

Sheet: SV
S/V review data
 | X605SF
 | PN | 912-000007-009
 | Test Data - No bias resistor |  |  |  | Press Test @ Vcc=4V
 | Vcc[V] | Icc[A] | Operation |  | Press[MPa] | Operation | Icc[A]
 | 5.0 | 0.11 | Open |  | 0.01 | Open | 0.09
 | 4.9 | 0.11 | Open |  | 0.02 | Open | 0.09
 | 4.8 | 0.11 | Open |  | 0.03 | Open | 0.09
 | 4.7 | 0.11 | Open |  | 0.04 | Open | 0.09
 | 4.6 | 0.11 | Open |  | 0.05 | Open | 0.09
 | 4.5 | 0.10 | Open |  | 0.06 | Open | 0.09 | Plasma 동작범위
 | 4.4 | 0.10 | Open |  | 0.07 | Open | 0.09 | Plasma 동작범위
 | 4.3 | 0.09 | Open |  | 0.08 | Open | 0.09 | Plasma 동작범위
 | 4.2 | 0.09 | Open |  | 0.09 | Open | 0.09
 | 4.1 | 0.09 | Open |  | 0.10 | Open | 0.09
 | 4.0 | 0.09 | Open |  | 0.11 | Open | 0.09
 | 3.9 | 0.08 | Open |  | 0.12 | Open | 0.09
 | 3.8 | 0.08 | Open |  | 0.13 | Open | 0.09
 | 3.7 | 0.08 | Open |  | 0.14 | Open | 0.09
 | 3.6 | 0.08 | Open |  | 0.15 | Open | 0.09
 | 3.5 | 0.08 | Open |  | 0.16 | Open | 0.09
 | 3.4 | 0.07 | Open |  | 0.17 | Open | 0.09 | Delay 발생
 | 3.3 | 0.07 | Open |  | 0.18 | Closed | 0.09
 | 3.2 | 0.07 | Open |  | 0.19 | Closed | 0.09
 | 3.1 | 0.07 | Open | Delay 발생 | 0.20 | Closed | 0.09
 | 3.0 | 0.06 | Closed

Sheet: Transformer
Transformer Voltage
 |  | Tx1 | Tx2 | Tx3 | Unit | Transformer Resistance
Battery | Voltage | 4 | 4 | 4 | V |  | 2차 - 기본 | R_N1 | R_N2 |  |  | 200
 | Current | 2.5 | 2.5 | 2.5 | A | 1 | 200 | 0.2 | 363.7 |  |  | 2.41
 | Power | 10 | 10 | 10 | W | 2 | 200 | 0.2 | 360.9
Booster | Voltage | 8 | 8 | 8 | V | 3 | 230 | 0.2 | 419
 | Current | 1.25 | 1.25 | 1.25 | A | 5 | 230 | 0.2 | 413.2
Transformer | 1차 | 5 | 5 | 5 | N1 | 6 | 230 | 0.2 | 419
 | 2차 - 기본 | 200 | 230 | 250 |  | 7 | 250 | 0.2 | 461 | 443 | 장시간 Test 후 dead - 출력이 낮게 나옴
 | 2차 total | 1400 | 1610 | 1750 | N2 | 8 | 250 | 0.2 | 458
 | Ratio | 280 | 322 | 350 | N1/N2 | 9 | 250 | 0.2 | 460
Output | Voltage | 2240 | 2576 | 2800 | V
 | Current | 4.46 | 3.88 | 3.57 | mA
Measure | Voltage | 4 | 4
 | Current | 2.41 | 2.41
 |  |  | 2.33

Sheet: Sheet1
AWG Spec
 | 저항 |  | 전압 drop | 허용 전류
AWG | Ω/km | Ω/0.1m | 2.5A | 일반 | 실리콘
23 | 66.79 | 0.006679 | 0.01670 | 2.2
24 | 84.22 | 0.008422 | 0.02106 | 0.588 | 5
25 | 106.2 | 0.01062 | 0.02655 | 0.477
26 | 133.9 | 0.01339 | 0.03348 | 0.347 | 3.3
27 | 168.9 | 0.01689 | 0.04223 | 0.288
28 | 212.9 | 0.02129 | 0.05323 | 0.25

Sheet: BATT
R7 | 10 | KΩ
R8 | 30 | KΩ
V_Batt | V_ADC | ADC | #05 | #04 | #03 | #02
4.2 | 3.15 | 243.4090909
4.1 | 3.07 | 237.6136364
4.0 | 3.00 | 231.8181818 | 2.987 | 2.996 | 2.999 | 2.999
3.9 | 2.92 | 226.0227273
3.8 | 2.85 | 220.2272727
3.7 | 2.77 | 214.4318182
3.6 | 2.70 | 208.6363636
3.5 | 2.62 | 202.8409091
3.4 | 2.55 | 197.0454545
3.3 | 2.48 | 191.25
