ArvidJoung/Plasma_Generator/0_DOC/20180202_Femto_Project 정보/MPD 협의자료 (정 책임과 up-date하면서 정리).xlsx

Sheet: 00. 형식 요약
형식
No. | Item | Type 1 | Type 2 | Type 3
01 | Naming | Plasma Pipette | Micro-Plasma Dispenser | Automatic MPD Station
02 | Power Supply | Battery (Re-chargeable) | 110/ 220VAC | 110/ 220VAC
03 | Operation | Maual | Manual / Auto | Auto
04 | Plasma Power (출력) | W | W | W
05 | 외부통신 (RS-232) | 필요없음 | 필요 | 필요
06 | Charge | 필요 | 필요없음 | 필요없음
07 | Control | Main S/W, Plasma-on S/W | S/W, 간단한 LCD등 | Touch PC
 |  | Plasma출력 조절 (L, M, H?) | free | free
 |  | * Pipette에 모두 integrated | 별도 컨트롤 박스 | 별도 컨트롤 박스
08 | Indicators (포괄적) | Power ready | Power ready
 |  | Gas flow (x) | Gas flow
 |  | Plasma-on | Plasma-on
 |  | Charging
09 | 개스 혼합, 유량조절 | 별매 | 별매 | 포함
10 | 기타 | single head | single head | * multi head

Sheet: 01. 형식 1
Type 1
 | 1 | Functions | Indicators (LED?) | Switch | Remarks
 |  | 시스템 Ready | ON, OFF | Y
 |  | 충전 기능 | 충전 중, 충전완료 | N
 |  | Plasma-ON | 플라즈마 ignition ON | Y | 1 x indicator?
 |  | Plasma-OFF | 플라즈마 ignition OFF
 |  | Power 조절 |  | L / M / H | 1 x switch?
 |  | 기타 | Battery 방전 표시?
 | 2 | Hidden Settings?
 |  | * L, M, H Pre-setting | 30%, 55%, 80%?
 |  | * Max. Plasma-On Time?
 | 3 | Others
 |  | Trans + Head 는 착탈식 (분리 가능하도록) : Head 형식 변경에 따라…..

Sheet: 02. 형식 2
Type 2
 | 1 | Functions | Indicators (LED?) | Switch | Remarks
 |  | 시스템 Ready | ON, OFF | Y
 |  | 충전 기능 | 충전 중, 충전완료 | N
 |  | Plasma-ON | 플라즈마 ignition ON | Y | Indicator (s)와 Switch
 |  | Plasma-OFF | 플라즈마 ignition OFF |  | 위치 및 개수
 |  | Power 조절 |  | L / M / H | 1 x switch?
 |  | Gas FLOW 확인 | Gas Flow | N
 |  | 기타 Timer (plasma-on)
 |  | 기타 에러표시
 | 2 | Hidden Settings?
 |  | * L, M, H Pre-setting | 30%, 55%, 80%?
 |  | * Max. Plasma-On Time?
 | 3 | Others
 |  | Trans + Head 는 원래 분리식입니다.
 |  | 간단한 LCD DISPLAY 가능?
 |  | 최대출력 (Plasma-On power) 상승가능한지?
