ArvidJoung/Plasma_Generator/0_MP1 Data/1_Sch & PCB/Transformer/Plasma_Pipette_Transformer_PCB_V3.0_2D_Top.dxf

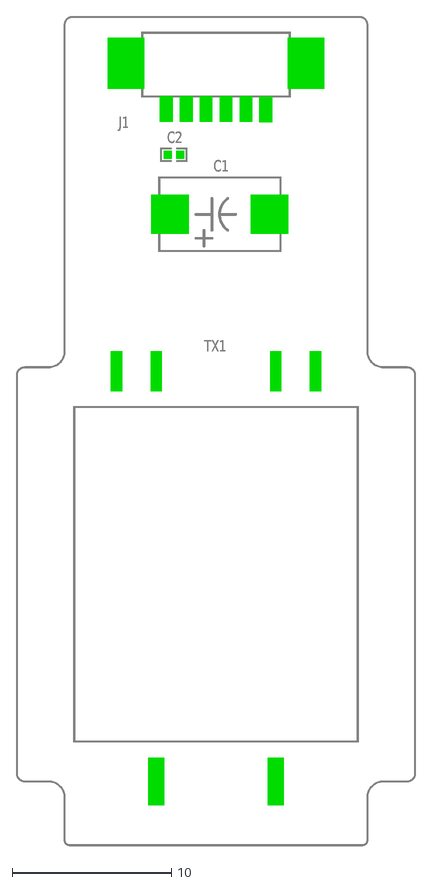
[picture p76: CAD file, 2018-07-31]
0_MP1 Data/1_Sch & PCB/Transformer/Plasma_Pipette_Transformer_PCB_V3.0_2D_Top.dxf
C2
C1
TX1
J1
