ArvidJoung/Plasma_Generator/0_MP3 Data/20190411_ME Data/ay_pcb_plasma-20190411.dxf

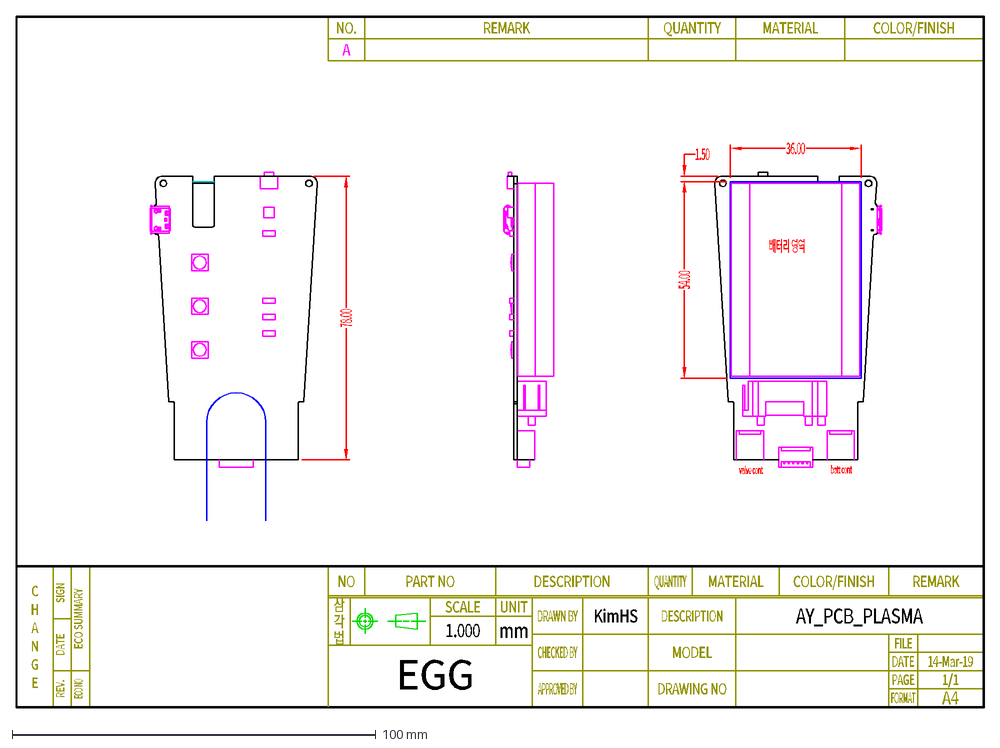
[picture p78: CAD file, 2019-04-11]
0_MP3 Data/20190411_ME Data/ay_pcb_plasma-20190411.dxf
EGG
삼 각 법
SCALE
UNIT
DRAWN BY
KimHS
DESCRIPTION
AY_PCB_PLASMA
1.000
mm
CHECKED BY
MODEL
FILE
DATE
14-Mar-19
APPROVED BY
DRAWING NO
PAGE
1/1
FORMAT
A4
NO.
REMARK
QUANTITY
MATERIAL
COLOR/FINISH
A
C H A N G E
REV.
ECO NO
ECO SUMMARY
SIGN
NO
PART NO
78.00
1.50
54.00
36.00
배터리 영역
batt cont
valve cont
