ArvidJoung/Plasma_Generator/1_Plasma_Pipette/1_Schematic/V2.0/ME/20180717/2d_pcb_plasma.dxf

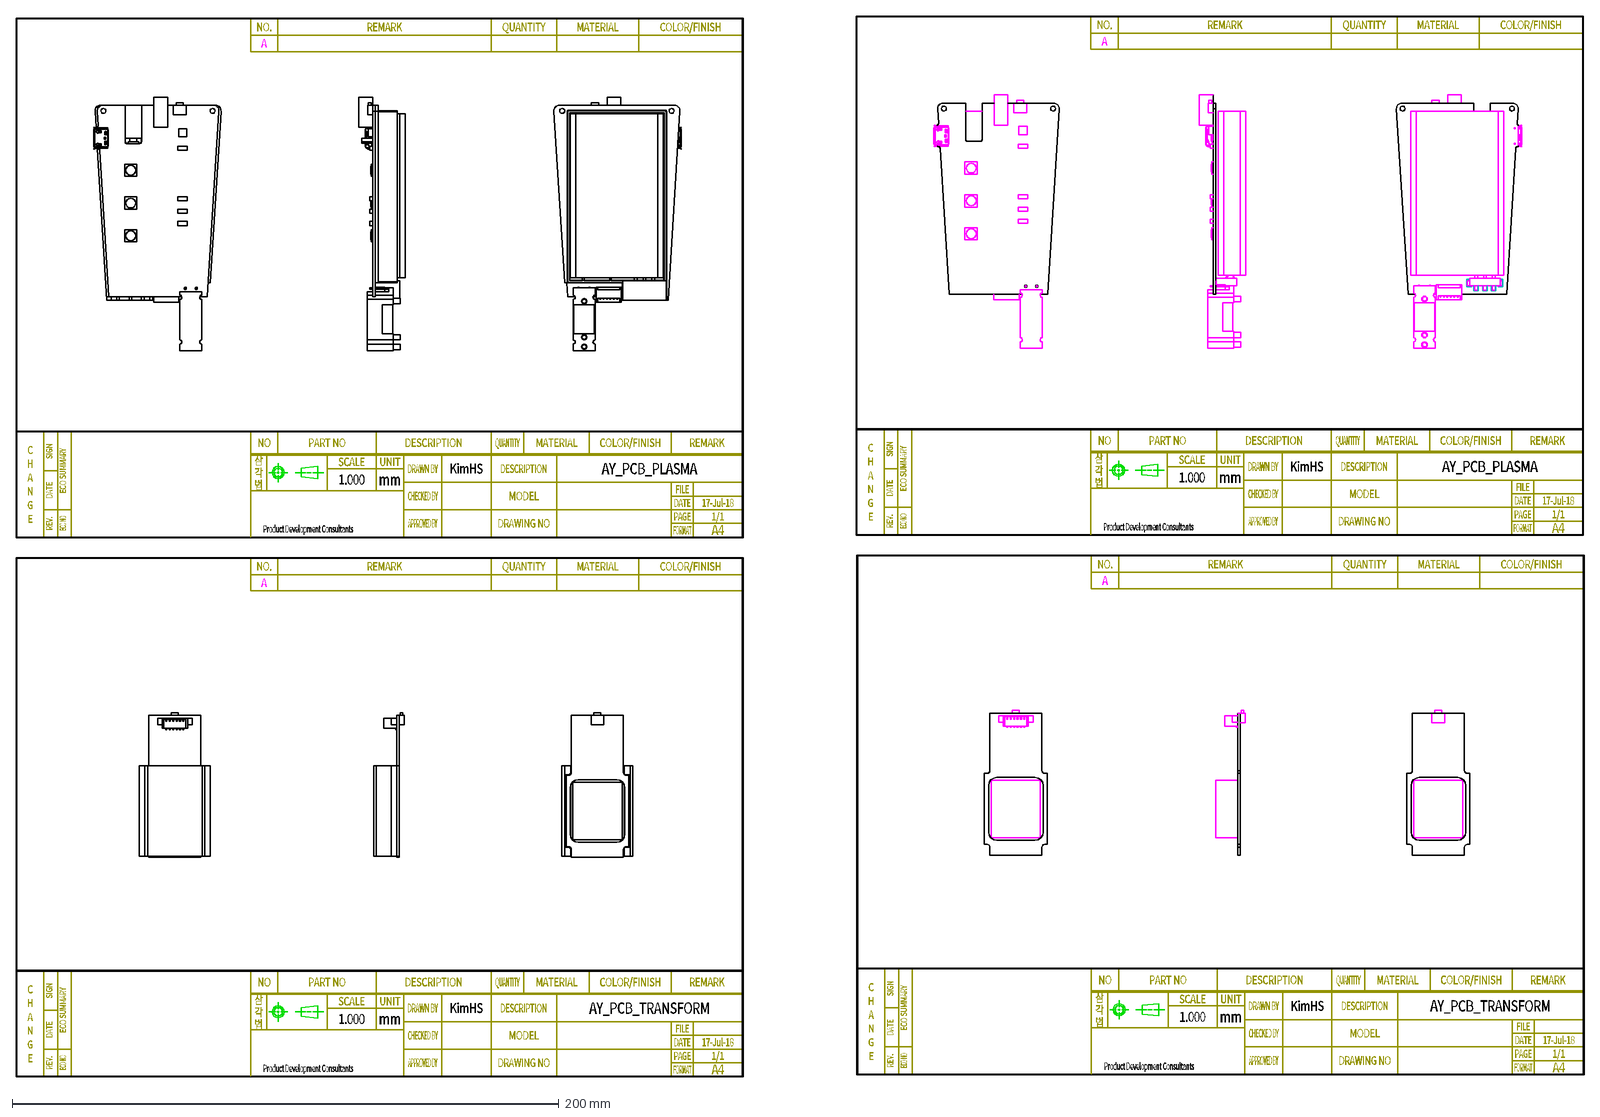
[picture p80: CAD file, 2018-07-21]
1_Plasma_Pipette/1_Schematic/V2.0/ME/20180717/2d_pcb_plasma.dxf
Product Development Consultants
삼 각 법
SCALE
UNIT
DRAWN BY
KimHS
DESCRIPTION
AY_PCB_PLASMA
1.000
mm
CHECKED BY
MODEL
FILE
DATE
17-Jul-18
APPROVED BY
DRAWING NO
PAGE
1/1
FORMAT
A4
NO.
REMARK
QUANTITY
MATERIAL
COLOR/FINISH
A
C H A N G E
REV.
ECO NO
ECO SUMMARY
SIGN
NO
PART NO
AY_PCB_TRANSFORM
