ArvidJoung/Plasma_Generator/1_Plasma_Pipette/1_Schematic/V2.0/ME/20180725_Trans PCB 확장/2d_pcb_plasma-180725_2D.dxf

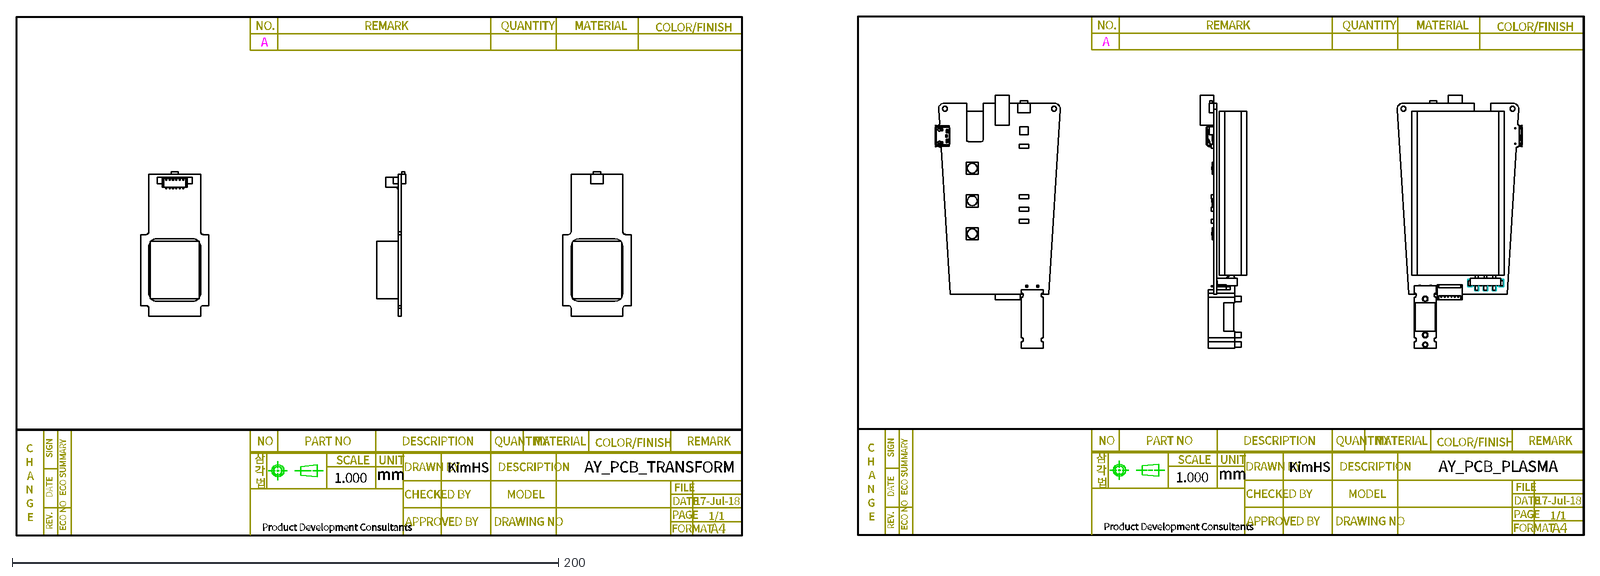
[picture p82: CAD file, 2018-07-29]
1_Plasma_Pipette/1_Schematic/V2.0/ME/20180725_Trans PCB 확장/2d_pcb_plasma-180725_2D.dxf
Product Development Consultants
삼
각
법
SCALE
UNIT
DRAWN BY
KimHS
DESCRIPTION
AY_PCB_TRANSFORM
1.000
mm
CHECKED BY
MODEL
FILE
DATE
17-Jul-18
APPROVED BY
DRAWING NO
PAGE
1/1
FORMAT
A4
NO.
REMARK
QUANTITY
MATERIAL
COLOR/FINISH
A
C
H
N
G
E
REV.
ECO NO
ECO SUMMARY
SIGN
NO
PART NO
AY_PCB_PLASMA
