ArvidJoung/Plasma_Generator/1_Plasma_Pipette/1_Schematic/V2.0/ME/20180730_Main PCB 외곽 수정/2D_PCB_PLASMA-180730_PCB.dxf

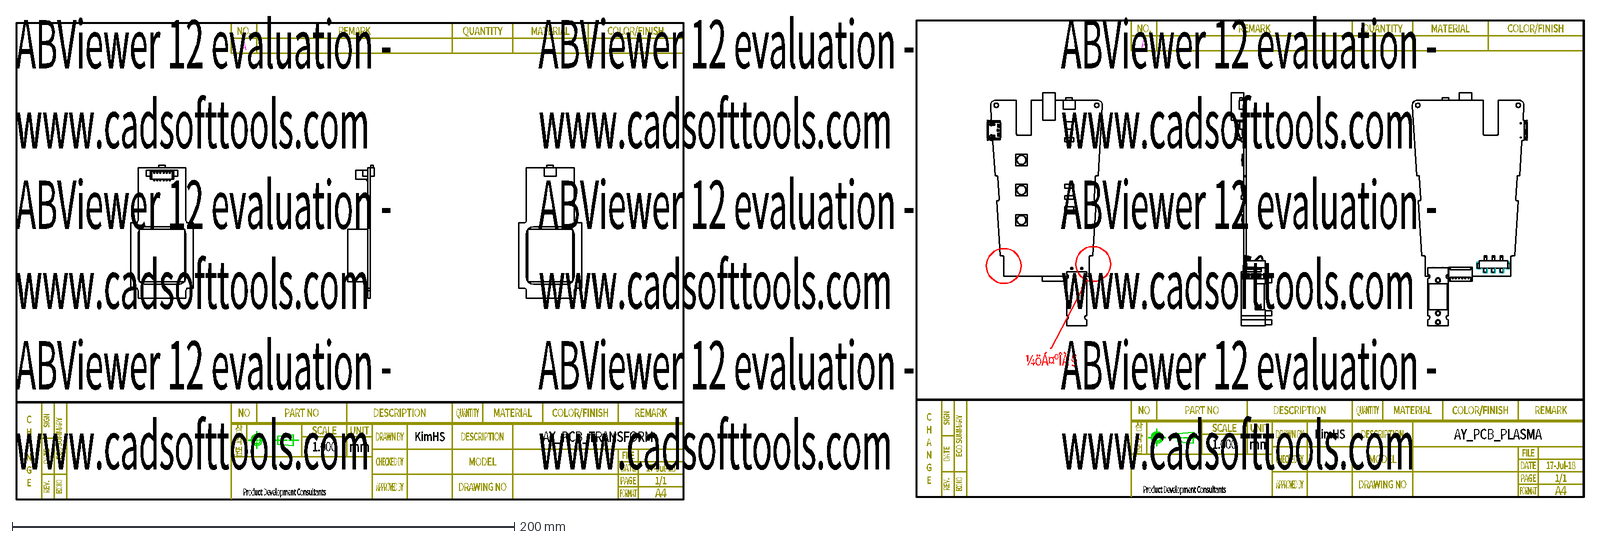
[picture p83: CAD file, 2018-07-31]
1_Plasma_Pipette/1_Schematic/V2.0/ME/20180730_Main PCB 외곽 수정/2D_PCB_PLASMA-180730_PCB.dxf
Product Development Consultants
삼 각 법
SCALE
UNIT
DRAWN BY
KimHS
DESCRIPTION
AY_PCB_TRANSFORM
1.000
mm
CHECKED BY
MODEL
FILE
DATE
17-Jul-18
APPROVED BY
DRAWING NO
PAGE
1/1
FORMAT
A4
NO.
REMARK
QUANTITY
MATERIAL
COLOR/FINISH
A
C H A N G E
REV.
ECO NO
ECO SUMMARY
SIGN
NO
PART NO
AY_PCB_PLASMA
¼öÁ¤ºÎÀ§
ABViewer 12 evaluation - www.cadsofttools.com
