ArvidJoung/Plasma_Generator/1_Plasma_Pipette/1_Schematic/V2.0/Plasma_Pipette_V2.0_Main_PCB_20180731_2D_Top.dxf

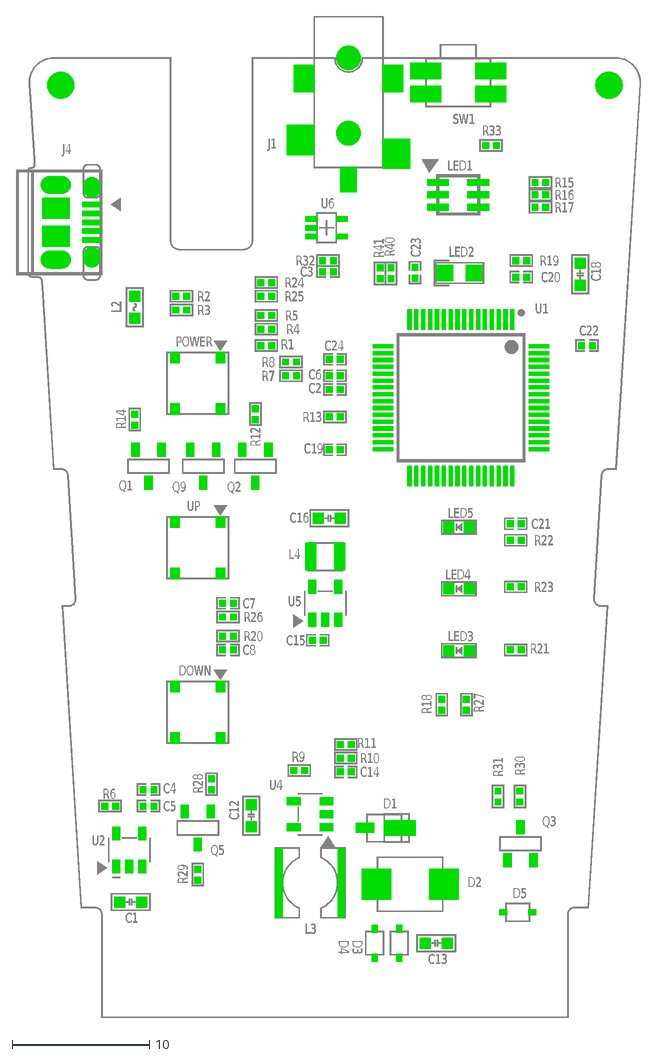
[picture p84: CAD file, 2018-07-31]
1_Plasma_Pipette/1_Schematic/V2.0/Plasma_Pipette_V2.0_Main_PCB_20180731_2D_Top.dxf
C14
C15
C19
C2
C20
C21
C22
C23
C24
C3
C4
C5
C6
C1
C12
C13
C16
C18
U4
U5
Q1
Q2
Q5
R1
R10
R11
R12
R13
R14
R19
R2
R24
R25
R28
R29
R3
R4
R5
R6
R7
R8
R9
U1
LED2
D1
L4
L3
LED1
R15
R16
R17
J4
Q9
U2
R18
R27
L2
R40
R41
R31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
