ArvidJoung/Plasma_Generator/2_Micro_Plasma_Dispenser/1_Schematic/01_MPD_Main PCB V1.0/MPD_V1.0_Main_PCB_20190714B_TOP.dxf

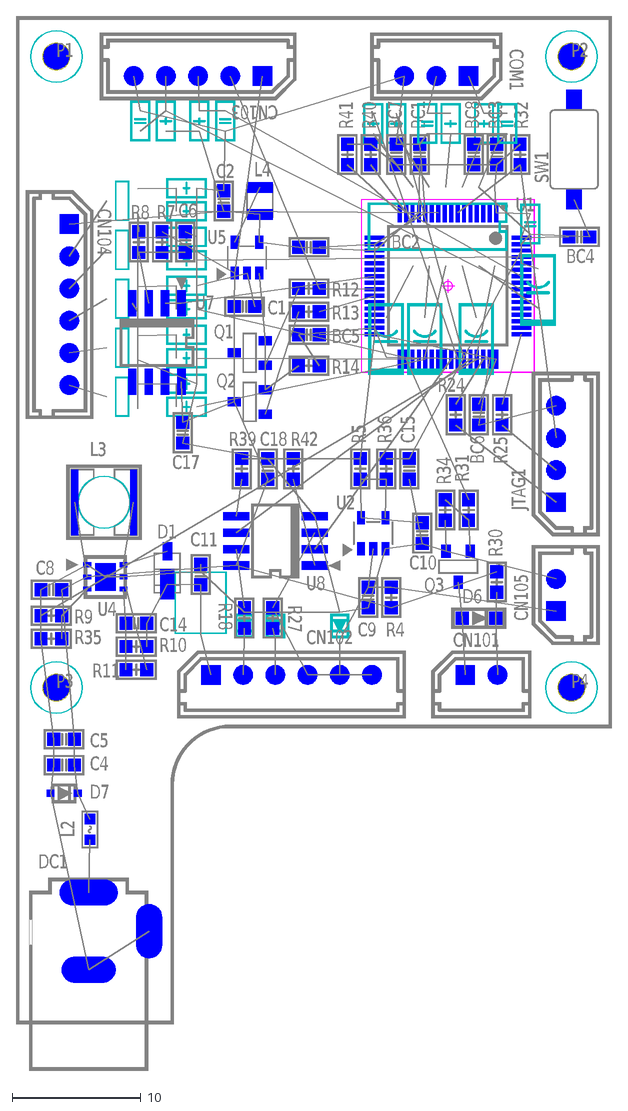
[picture p85: CAD file, 2019-07-18]
2_Micro_Plasma_Dispenser/1_Schematic/01_MPD_Main PCB V1.0/MPD_V1.0_Main_PCB_20190714B_TOP.dxf
D6
L2
Q3
P1
P2
U4
U5
L4
CN104
L3
Q1
Q2
D1
U1
DC1
COM1
P3
P4
CN102
CN101
R10
R11
R12
R13
R14
R18
R24
R25
R27
R30
R31
R32
R34
R35
R36
R40
R41
R7
R8
R9
R4
R5
C6
BC1
BC2
BC3
BC4
BC5
BC6
BC7
BC8
C1
C10
C11
C14
C15
C2
C4
C5
C8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
