ArvidJoung/Plasma_Generator/0_MP1 Data/1_Sch & PCB/Main/Plasma_Pipette_V2.0_Main_PCB_20181009_Bottom.dxf

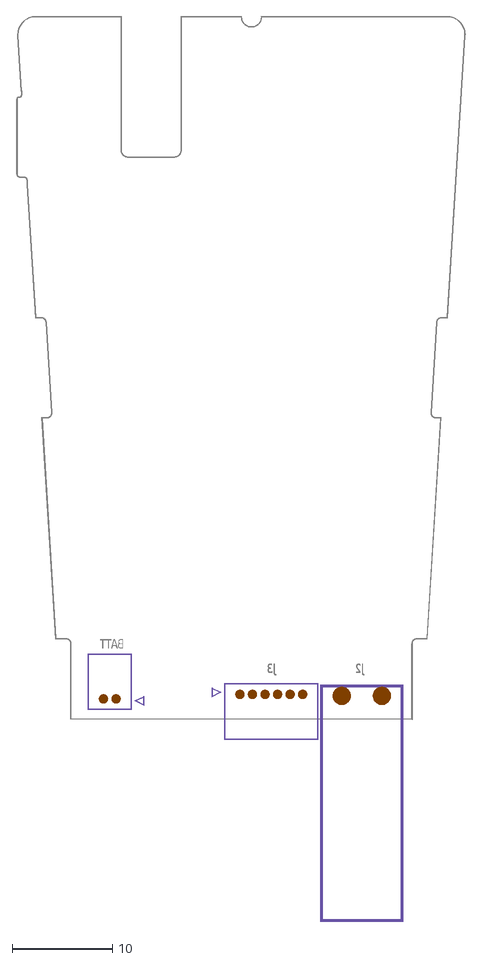
[picture p86: CAD file, 2018-10-09]
0_MP1 Data/1_Sch & PCB/Main/Plasma_Pipette_V2.0_Main_PCB_20181009_Bottom.dxf
J3
J2
BATT
