ArvidJoung/Plasma_Generator/0_MP1 Data/1_Sch & PCB/Transformer/Plasma_Pipette_Transformer_PCB_V3.0_2D_Bottom.dxf

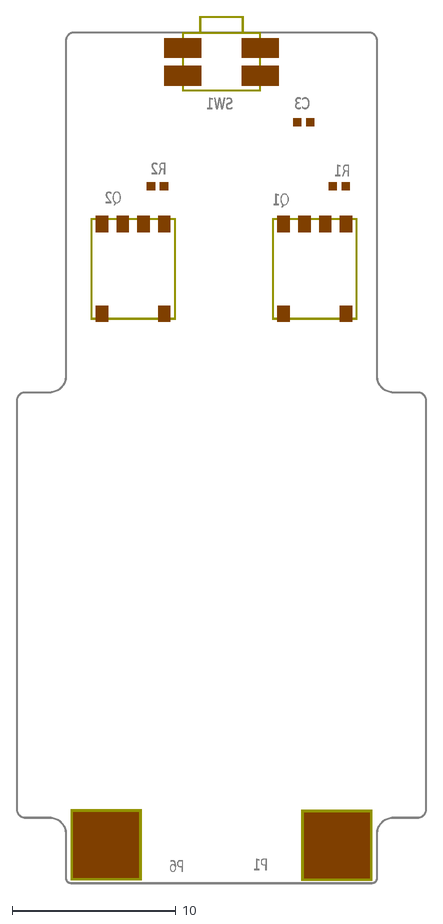
[picture p87: CAD file, 2018-07-31]
0_MP1 Data/1_Sch & PCB/Transformer/Plasma_Pipette_Transformer_PCB_V3.0_2D_Bottom.dxf
C3
SW1
Q1
Q2
R2
R1
P1
P6
