ArvidJoung/Plasma_Generator/1_Plasma_Pipette/1_Schematic/V2.0/Plasma_Pipette_V2.0_Main_PCB_20180731_2D_Bottom.dxf

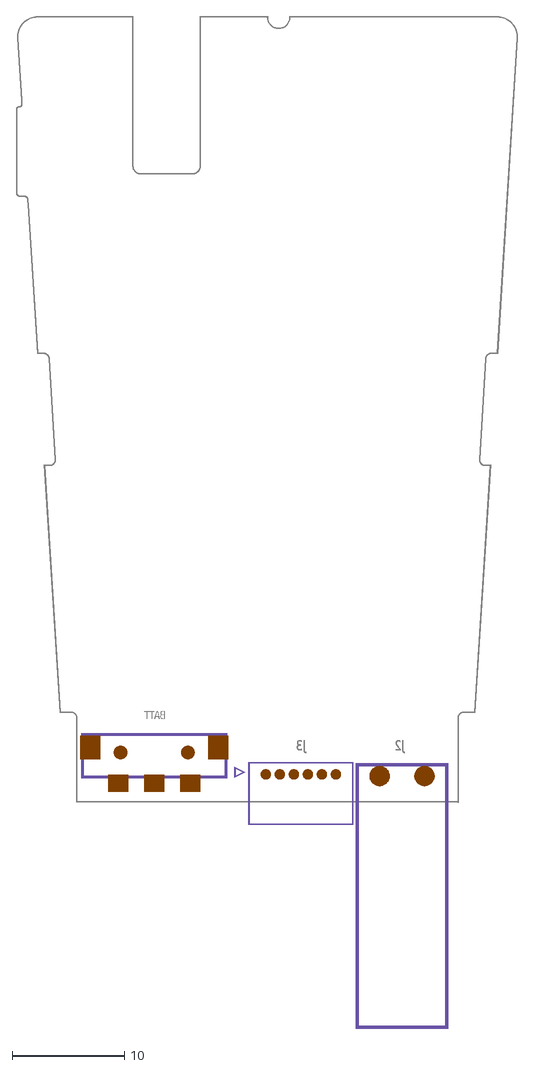
[picture p90: CAD file, 2018-07-31]
1_Plasma_Pipette/1_Schematic/V2.0/Plasma_Pipette_V2.0_Main_PCB_20180731_2D_Bottom.dxf
BATT
J3
J2
