ArvidJoung/Plasma_Generator/1_Plasma_Pipette/1_Schematic/V2.0/Plasma_Pipette_V2.0_Main_PCB_Bottom.dxf

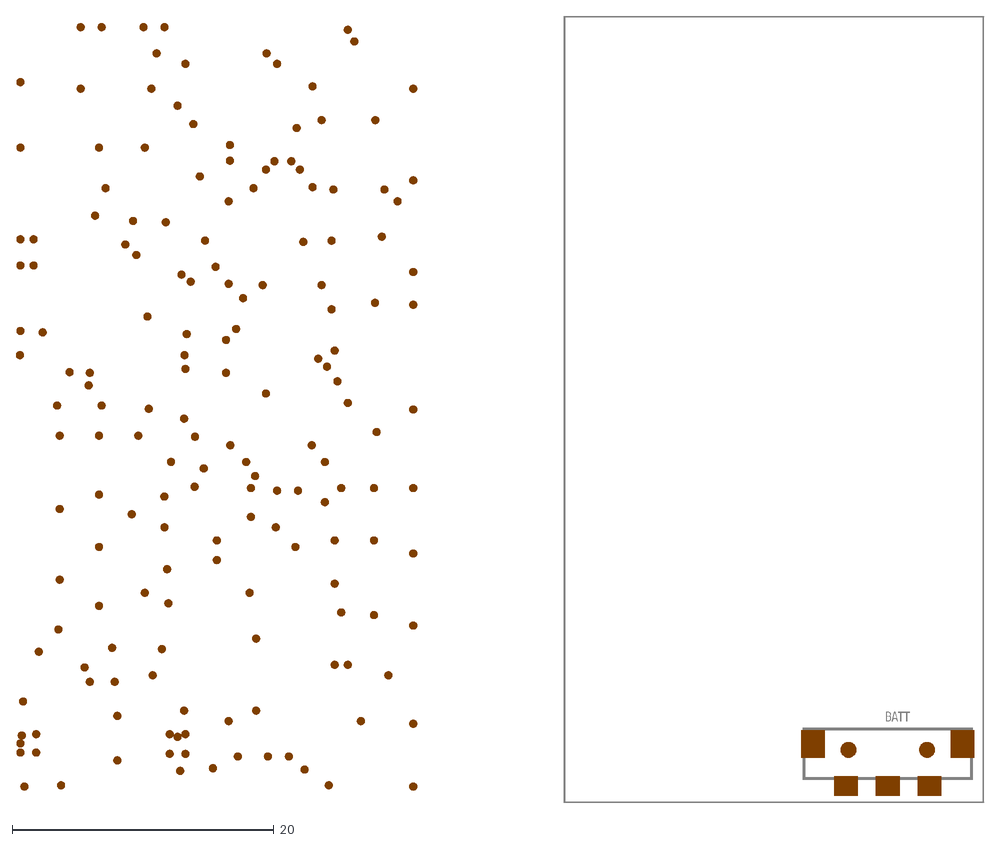
[picture p95: CAD file, 2018-07-14]
1_Plasma_Pipette/1_Schematic/V2.0/Plasma_Pipette_V2.0_Main_PCB_Bottom.dxf
BATT
