ArvidJoung/Plasma_Generator/1_Plasma_Pipette/1_Schematic/V2.0/ME/20180730_Battery 2D/batt-180730.dxf

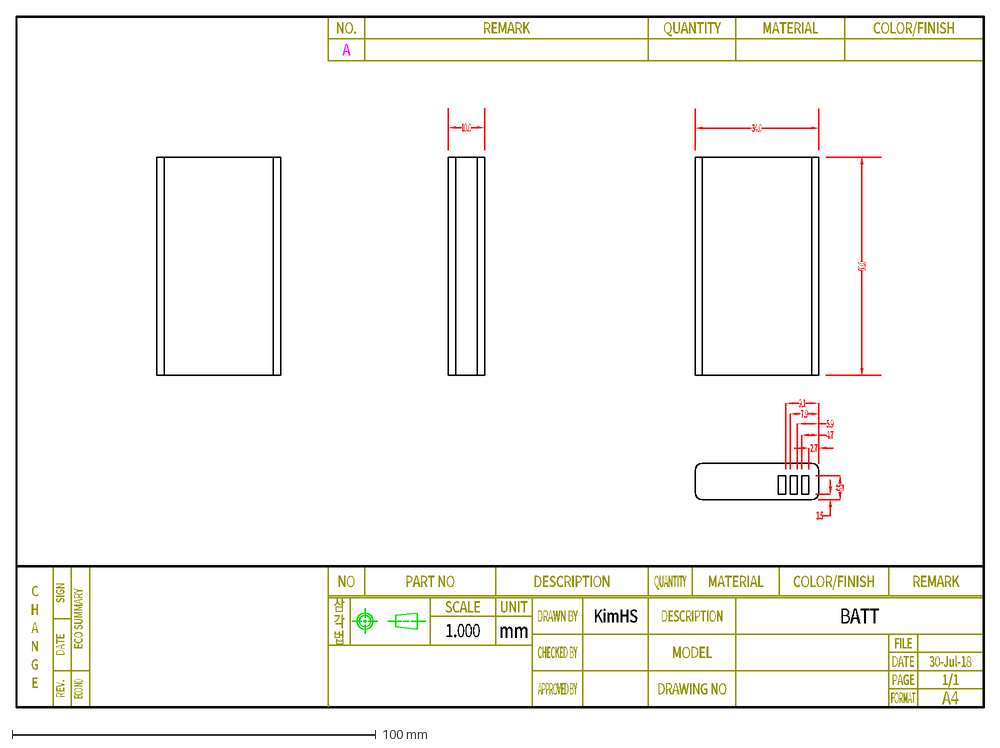
[picture p97: CAD file, 2018-07-30]
1_Plasma_Pipette/1_Schematic/V2.0/ME/20180730_Battery 2D/batt-180730.dxf
삼 각 법
SCALE
UNIT
DRAWN BY
KimHS
DESCRIPTION
BATT
1.000
mm
CHECKED BY
MODEL
FILE
DATE
30-Jul-18
APPROVED BY
DRAWING NO
PAGE
1/1
FORMAT
A4
NO.
REMARK
QUANTITY
MATERIAL
COLOR/FINISH
A
C H A N G E
REV.
ECO NO
ECO SUMMARY
SIGN
NO
PART NO
34.0
60.0
10.0
2.7
4.7
5.9
7.9
9.1
1.5
6.5
