ArvidJoung/Plasma_Generator/2_Micro_Plasma_Dispenser/0_DOC/20190708_ME 2D Data/2D_PCB_MPD-190708_LED.dxf

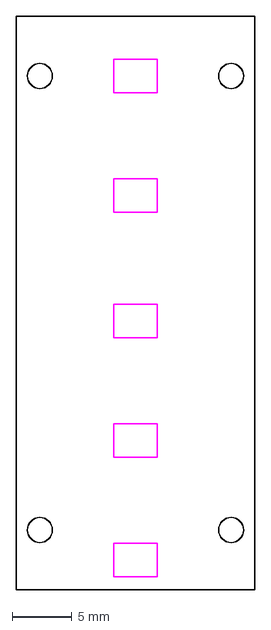
[picture p98: CAD file, 2019-07-08]
2_Micro_Plasma_Dispenser/0_DOC/20190708_ME 2D Data/2D_PCB_MPD-190708_LED.dxf
20.0 x 48.0 mm
