ArvidJoung/Plasma_Generator/2_Micro_Plasma_Dispenser/0_DOC/20190724_ME Data/2D_PCB_MPD-190724_KEY.dxf

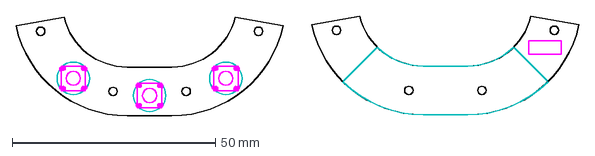
[picture p99: CAD file, 2019-08-07]
2_Micro_Plasma_Dispenser/0_DOC/20190724_ME Data/2D_PCB_MPD-190724_KEY.dxf
138.6 x 24.5 mm
