ArvidJoung/Plasma_Generator/2_Micro_Plasma_Dispenser/1_Schematic/02_MPD_LED PCB V1.0/MPD_V1.0_LED_PCB_20190708_Bottom_투영뷰.dxf

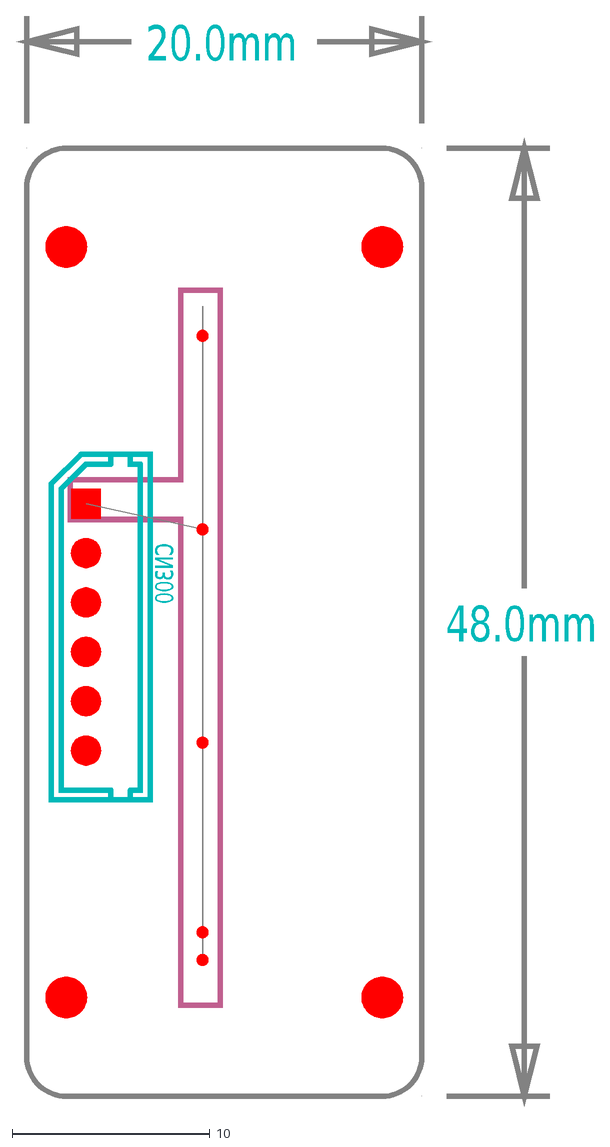
[picture p100: CAD file, 2019-07-24]
2_Micro_Plasma_Dispenser/1_Schematic/02_MPD_LED PCB V1.0/MPD_V1.0_LED_PCB_20190708_Bottom_투영뷰.dxf
48.0mm
20.0mm
CN300
