ArvidJoung/Plasma_Generator/2_Micro_Plasma_Dispenser/1_Schematic/02_MPD_LED PCB V1.0/MPD_V1.0_LED_PCB_20190708_TOP.dxf

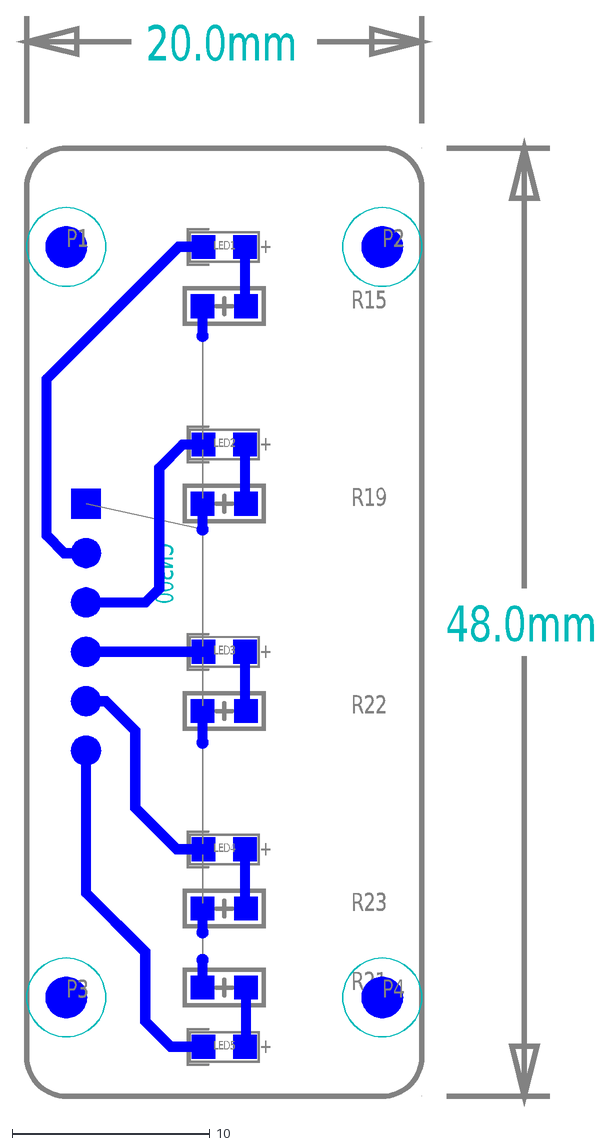
[picture p102: CAD file, 2019-07-24]
2_Micro_Plasma_Dispenser/1_Schematic/02_MPD_LED PCB V1.0/MPD_V1.0_LED_PCB_20190708_TOP.dxf
48.0mm
20.0mm
+
LED1
LED2
LED3
LED4
LED5
R15
R19
R21
R22
R23
CN300
P3
P4
P1
P2
