ArvidJoung/Plasma_Generator/2_Micro_Plasma_Dispenser/1_Schematic/03_MPD_KEY PCB V1.0/MPD_V1.0_KEY_PCB_20190708_TOP.dxf

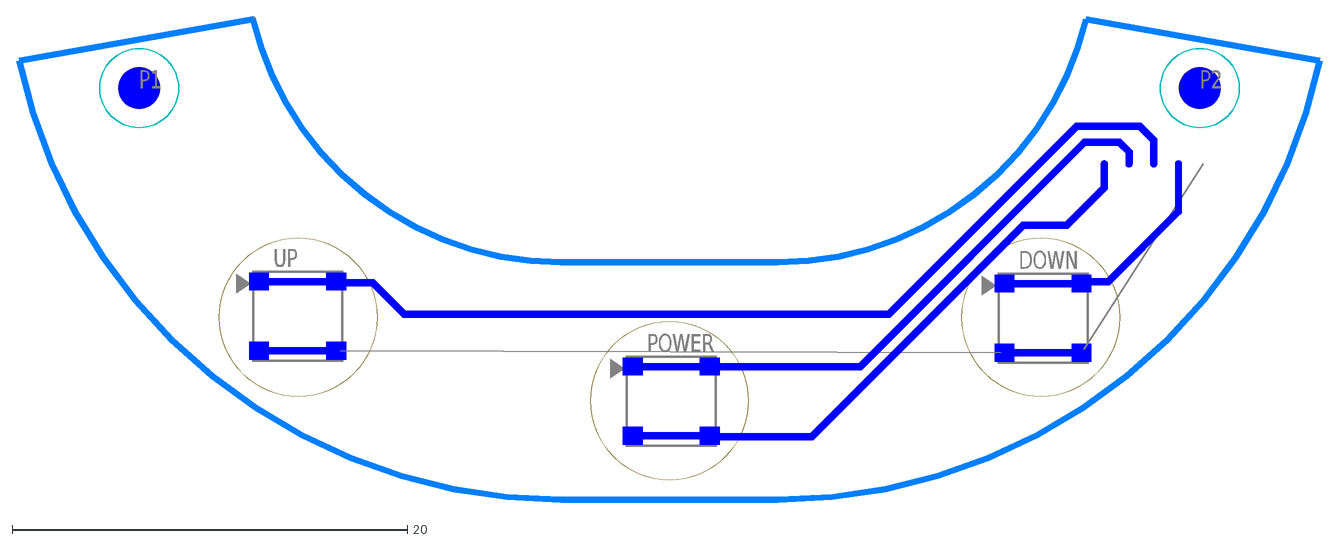
[picture p103: CAD file, 2019-07-24]
2_Micro_Plasma_Dispenser/1_Schematic/03_MPD_KEY PCB V1.0/MPD_V1.0_KEY_PCB_20190708_TOP.dxf
DOWN
POWER
UP
P1
P2
