ArvidJoung/Plasma_Generator/2_Micro_Plasma_Dispenser/0_DOC/20190706_ME 2D Data/2D_PCB_MPD_KEY-190705.dxf

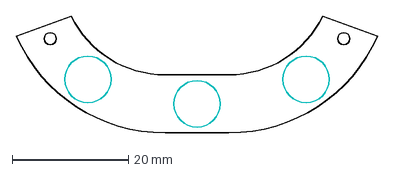
[picture p104: CAD file, 2019-07-08]
2_Micro_Plasma_Dispenser/0_DOC/20190706_ME 2D Data/2D_PCB_MPD_KEY-190705.dxf
62.2 x 20.1 mm
