ArvidJoung/Plasma_Generator/2_Micro_Plasma_Dispenser/0_DOC/20190706_ME 2D Data/2D_PCB_MPD_LED-190705.dxf

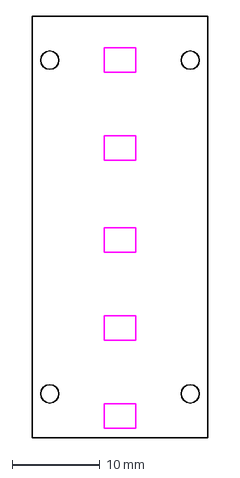
[picture p105: CAD file, 2019-07-08]
2_Micro_Plasma_Dispenser/0_DOC/20190706_ME 2D Data/2D_PCB_MPD_LED-190705.dxf
20.0 x 48.0 mm
