ArvidJoung/Plasma_Generator/2_Micro_Plasma_Dispenser/0_DOC/20190708_ME 2D Data/2D_PCB_MPD-190708_KEY.dxf

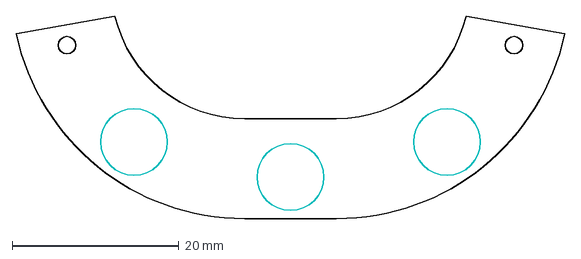
[picture p106: CAD file, 2019-07-08]
2_Micro_Plasma_Dispenser/0_DOC/20190708_ME 2D Data/2D_PCB_MPD-190708_KEY.dxf
65.8 x 24.3 mm
