ArvidJoung/Plasma_Generator/(list of files, cad)

Other CAD files:
0_MP2 Data/0_Data/20190302_Main_PCB/Plasma_Pipette_V3.0_Main_PCB_TOP_20190302.dwg
0_MP2 Data/0_Data/20190302_Main_PCB/Plasma_Pipette_V3.0_Main_PCB_Bottom_20190302.dwg
1_Plasma_Pipette/1_Schematic/V2.0/ME/20180730_Main PCB 외곽 수정/2d_pcb_plasma-180730.dxf
2_Micro_Plasma_Dispenser/0_DOC/20190706_ME 2D Data/2D_PCB_MPD-190705.dxf
2_Micro_Plasma_Dispenser/0_DOC/20190708_ME 2D Data/2D_PCB_MPD-190708.dxf
2_Micro_Plasma_Dispenser/0_DOC/20190724_ME Data/2D_PCB_MPD-190724.dxf
0_MP2 Data/1_Sch & PCB/Main/Backup/Plasma_Pipette_V3.0_Main_PCB_20190228_V9.5.dxf
1_Plasma_Pipette/1_Schematic/Backup/Plasma_Gen_Pipette PCB 형상_top.dxf
1_Plasma_Pipette/1_Schematic/V1.0/ME Data/Plasma_Pipette_V1.0_Main_PCB_bottom.dwg
1_Plasma_Pipette/1_Schematic/V1.0/ME Data/Plasma_Pipette_V1.0_Main_PCB_bottom_2007.dwg
1_Plasma_Pipette/1_Schematic/V1.0/ME Data/Plasma_Pipette_V1.0_Main_PCB_top.dwg
1_Plasma_Pipette/1_Schematic/V1.0/ME Data/Plasma_Pipette_V1.0_Main_PCB_top_2007.dwg
2_Micro_Plasma_Dispenser/0_DOC/20190706_ME 2D Data/2D_PCB_MPD_MAIN-190705.dwg
2_Micro_Plasma_Dispenser/0_DOC/20190708_ME 2D Data/2D_PCB_MPD-190708_MAIN.dwg
2_Micro_Plasma_Dispenser/0_DOC/20190724_ME Data/2D_PCB_MPD-190724_KEY.dwg
2_Micro_Plasma_Dispenser/1_Schematic/Build V1.0/01_MPD_Main PCB V1.0/Backup/MPD_V1.0_Main_PCB_20190727_TOP.dxf
4_Transformer/1_Schematic/V2.0/ME Data/Plasma_Pipette_Transformer_PCB_V2.0_20180324_Top.dwg
4_Transformer/1_Schematic/V2.0/ME Data/Plasma_Pipette_Transformer_PCB_V2.0_20180324_bottom.dwg
