ArvidJoung/Plasma_Generator/0_MP1 Data/4_DOC/Pipette Download manual_20181225.xlsx

Plasma Pipette F/W Download manual |  |  | ◈ Pipette Download를 위한 H/W 구성도
 | 1. STM32 ST-LINK Utility 실행 |  |  | Pipette, JTAG PCB 구성도
 | 2. Target > Setting 선택 |  |  | ST-Link/V2, JTAG PCB 구성도
 | 3. 아래와 같이 설정
 | 4. Connect 버튼을 누르고, PCB의 reset S/W를 누르면 Connection이 된다.
 |  | 초기 Download가 안된 상태에서는 아래와 같이 모든 memory 영역이 F로 채워진다.
 | 5. Full chip erase 버튼을 선택하여 기존 Data를 지운다.
 | 6. Program verify 버튼을 선택하면 아래의 화면이 뜬다.
 | 7. Browse를 선택하여, Download하고자하는 Binary file를 선택하고, Start 버튼을 선택한다.
 | 8. Start 버튼을 선택하면, Download가 진행된다.
 | 9. Download가 완료되면, 아래와 같은 화면이 display 된다.
