ArvidJoung/Plasma_Generator/0_MP2 Data/Pipette MP2 Test Resutls.xlsx

Sheet: Sample
 |  | ECO | LED |  |  | KEY |  |  | Output
No | DL | R8 | PWR | Plasma | Level | PWR | Reset | Level | Pulse | +8V | S/V | F/W
#01 | OK | 30K | OK |  | OK | OK |  | OK
#02 | OK | 30K | OK |  | OK | OK |  | OK
#03 | OK | 30K | OK | OK | OK | OK | OK | OK | OK | OK | OK | V2.00_0.5sec
#04 | OK | 30K | OK |  | OK | OK | OK | OK
#05 | OK | 30K | OK |  | OK | OK |  | OK

Sheet: Issue
No | Issue | 원인 분석
1 | booting 후 바로 Off 됨. | R8 오삽 : 30K 아닌 3K가 실장되어 Low battery로 인식되어 Off됨.
