ArvidJoung/Plasma_Generator/Plasma_Pipette_PP Issue list_C.xlsx

Sheet: Issue
No | Date | Status | PCB | Issue | Solution
1 | 2018-12-22 | Closed | Trans | Trans 위치에 PCB cutting이 안되어 있음. | 일단 Manual로 작업하고, PCB file에 Board Cut out 표시 추가
2 | 2018-12-22 | OPEN | Trans | 로맥스지 추가
3 | 2018-12-22 | OPEN | Trans | Trans 사양서 작성
4 | 2018-12-22 | Closed | Main Trans | PAD의 VIA로 인해 SMT error 발생 위험 있음. | PCB PAD의 VIA hole 제거
5 | 2018-12-23 | Closed | Trans | Trans 2차측 GND가 2차측 Pin에 연결되어 있음. | Trans 2차측 GND는 1차측 GND에 연결되어야 함. -회로 수정 필요
6 | 2018-12-24 | Closed | F/W | Power Off가 안됨. | KEY_PWR_Pin GPIO 설정 변경 NOPULL -> PULLDOWN (Gpio.c)
7 | 2018-12-25 | Closed | F/W | Plasma On Key 동작 안됨. Default Low 유지 | 충전중 Plasma 동작 안하도록 수정하며 생긴 문제임 USB_DET_Pin GPIO 설정 변경 NOPULL -> PULLDOWN (Gpio.c)
8 | 2018-12-25 | Closed | Main | S/V Not operation PMBT222 collector-emitter 간 저항이 높아 collector 전압이 3V까지밖에 안떨어짐. | FET로 부품 변경 FTK2306
9 | 2018-12-26 | Closed | Main | V3.0 Battery Pack 사용 여부 확인 | wire type으로 계속 사용
10 | 2019-01-01 | OPEN | M/E | Trans molding case의 2차측 방향의 screw hole 위치가 전극과 가깝다. | - 조립시 비금속 제질의 screw 사용 - 조립 hole를 GND PAD쪽으로 이동
11 | 2019-01-01 | OPEN | F/W | 완충 인식 안됨
12 | 2019-01-05 | OPEN | Main | Plasma On시 Off됨. - Power supply 사용시 정상 동작 : 2.3A 소모 | Battery에서 Voltage drop 발생 2A 이상 전류를 지원하는 Battery 필요 Trans의 소모 전류 낮춤
13 | 2019-01-05 | Closed | Main | Plasma On후 Off시 Key가 먹지 않음. - Plasma On시 Key로 출력이 유기되어 Key 인식을 못함. | KEY_OP에 shunt Cap 4.7uF/25V 추가
14 | 2019-01-05 | Closed | Main | Plasma On후 board가 Reset되는 경우, S/V는 On 상태를 유지하고 있음. S/V에 current path 추가 - Diode 추가 - 회사에서 다시 재현 | S/V에 current path 추가 - 1N4148WS Q3 Gate에 shunt 10K 추가
15 | 2019-01-05 | OPEN | M/E | Trans molding시 PCB가 case에 밀착이 되지 않아 molding 액이 넘침 trans coil이 완전히 잠기지 않음. | Trans case에 hook 필요
16 | 2019-01-13 | OPEN | Main | Batttery CON 변경 - 전류 3A 이상
17 | 2019-01-13 | OPEN | Trans | GND Copper에서 주변에 Spark 발생 | PCB외곽의 GND 제거
18 | 2019-01-15 | OPEN | Main | L3,U4가 Plasma Max 출력 2분만에 65도 이상 온도가 올라감 - Inductor size up 필요 - Trans Turn ratio 조정 : 현재 전압이 높음(12KV)
19 | 2019-01-15 | OPEN | Trans | Trans 온도가 높음. - Vcc Path에 Inductor 추가 검토
20 | 2019-01-16 | Closed | F/W | Plasma On후 5초후 S/V On 지원 | 1/17 Binary에 적용
21
22
23
24
25

Sheet: 1222 Meeting
Femto | 김무환 고문
장소 | 계룡 삼진아파트
Date | 2018-12-22
1. Pipette
 | 1) PCB 수령
 |  | Main : 4ea
 |  | Trans : 4ea
 | 2) 1set는 M/E 전달용으로 Femto에서 다시 가져감
 | 3) 추후 일정
 |  | 1월 중순에 금형 Start ( 제작 기간 : 40일)
 |  | 제품 판매 : 3/9
2. MPD
 | 1) 3/9일 개발 Start
 | 2) Design 시안 : 1월 말 전달 예정
 | 3) Multi-channel 지원 검토 : H/P를 여러 개 지원 및 control ( PCB Program )
 |  | 1안 : MPD에서 RS-232 통신 지원하여 Multi-Channel시 여러 개의 Board를 사용
 |  | 2안 : New PCB design
 |  | * 1안으로 검토 예정
3. RF Gen
 | 1) 통신 연결 상태 check ( Femto )
 |  | RF Gen에서 matcher control 하는 것으로 생각됨 ( Femto )
 |  |  | RF Gen에서 control하는 경우, RF Gen CPU 추가 검토 필요함
 |  |  | RF Gen CPU에서 matcher motor control 가능
 | 2) RF Gen 상태를 알수 있도록 LCD 지원
 |  | F/W 담당자 결정 후 F/W와 협의 후 진행
 |  | 표시할 정보 List 필요
 | 3) 600W 추가 검토 ( Femto : 2019 말까지 개발 완료 계획 )

Sheet: Sample
Main PCB
No | 출고 | D/L | PWR | Plasma | Q3 ECO | S/V | 충전 | F/W | 4.7uF 10K 1N4148WS | 불량
#01 | Femto | - |  |  | OK |  |  | 20190117 | OK | -
#02 | 입고 | OK | OK | OK | OK | OK |  | 2018225-1 |  | Femto에서 회수 후 DL시 reset 됨
#03 | Femto | OK | OK | OK | OK | OK | OK | 2018225-1 | OK
#04 | Femto | Repair | OK | OK | OK | OK | OK | 2018225-1 | OK | Reset S/W 불량
#05 | Test | OK | OK | OK | OK | OK | OK | 20190122 | OK

Sheet: Trans
Trans PCB
No | 출고 | Inductance-Initial |  |  | Inductance-re-work |  |  | Inductance-molding
 |  | 1차-1[uH] | 1차-2[uH] | 2차[H] | 1차-1[uH] | 1차-2[uH] | 2차[H] | 1차-1[uH] | 1차-2[uH] | 2차[H]
#01 | M/E | - | - | -
#02 |  | 38.33 | 38.26 | 4.03 | 40.3 | 40.6 | 3.8
#03 |  | 34.06 | 34.41 | 3.628 | 32.1 | 32.7 | 3.5
#04 |  | 49.42 | 49.4 | 3.97 |  |  |  | 20.25 | 20.3 | 1.99
#05 |  | 37.94 | 38.15 | 3.96 |  |  |  | 20.27 | 20.3 | 1.99
 |  | 34.4 | 34.5 | 3.3
 |  | 35.2 | 36 | 3.4
Re-work
 | Pin solder 재작업 : 2차측 GND를 1차측 GND pin
 | 로맥스지 추가
 |  |  |  |  | 20.25 | 20.3 | 1.99
 |  |  |  |  | 20.27 | 20.3 | 1.99

Sheet: 1225
Level | Time[msec/10] |  |  |  | Trans
Low | 3.48 |  |  |  |  | Wire | Turn | Layer | Total Turn | Voltage | 측정
Middle | 5.52 |  |  |  | 1차 | 0.25 | 5 | 1 | 5 | 8 | 8
High | 7.48 |  | 8 | 4 | 2차 | 0.06 | 230 | 7 | 1610 | 2576 | 12200
 |  |  | 0.27 | 0.14
 |  |  | 2.16 | 0.56
+8V | 8.36V
Rising time | 2.72msec
Current
Standby | 0.01
S/V On | 0.28
Plasma On | 0.27 | 8V 외부에서 인가
 | 0.14 | 4V 외부에서 인가

Sheet: 0115
 |  |  |  |  |  |  |  | Main #05, Trans #04
Main | Trans |  | Vcc | Current | Power | Vpp[KV] | Iout[mA] | Aging Test |  |  |  | DC/DC | Power Ind | FET
#03 | #04 | LEVEL1 | 4.1 | 0.91 | 3.731 | 11.36 | 0.328 | 9:24:00 | 1.6 | 11.36
 |  | LEVEL2 | 4.1 | 1.36 | 5.576 | 11.36 | 0.491 | 9:25:00 | 1.61 | 11.36 |  | 65도 | 65도
 |  | LEVEL3 | 4.1 | 1.67 | 6.847 | 11.36 | 0.603 | 9:26:00 | 1.46 | 11.36 | 소리 발생
#04 | #04 | LEVEL1 | 4.1 | 0.86 | 3.526 | 11.36 | 0.310 | 9:27:00 | 1.3 | 11.04 | 소리 발생
 |  | LEVEL2 | 4.1 | 1.23 | 5.043 | 11.36 | 0.444 | 9:29:00 | 1.14 | 10.68 | 소리 발생 |  |  | 65도
 |  | LEVEL3 | 4.1 | 1.56 | 6.396 | 11.36 | 0.563
#05 | #04 | LEVEL1 | 4.1 | 0.93 | 3.813 | 11.36 | 0.336
 |  | LEVEL2 | 4.1 | 1.31 | 5.371 | 11.36 | 0.473
 |  | LEVEL3 | 4.1 | 1.65 | 6.765 | 11.36 | 0.596
