ArvidJoung/Plasma_Generator/0_MP3 Data/Plasma Pipette V4.0 SMT issue_20190508.xlsx

현상 | F/W download Fail
원인 | D1 Diode 방향이 반대로 실장되어 있음.
 | Diode가 PL상의 Part와 상이함.
 | V3.0때도 금번과 같은 Diode가 들어가 있음.
확인 요청 | 현재 실장되어 있는 Part 특성 확인 필요함.
 | 사용된 Part Number 및 Datasheet 요청
 | 현재 실장된 Part와 PCB Land pattern이 다름.
