ArvidJoung/Plasma_Generator/1_Plasma_Pipette/3_Firmware/Plasma Pipette FW Issue list.xlsx

Sheet: Issue list
No | Issue Date | Status | Closed Date | Issue | Command
1 | 2018-05-26 | Closed | 2018-05-26 | 초기에 모든 LED가 ON 상태가 된다. - STA_LED_B_Pin|STA_LED_G_Pin|STA_LED_R_Pin|LED_LOW_Pin - LED_HIGH_Pin|LED_MED_Pin|OP_LED_Pin | gpio.c 수정 HAL_GPIO_WritePin(GPIOC, LED_LOW_Pin, GPIO_PIN_SET); HAL_GPIO_WritePin(GPIOB, LED_HIGH_Pin|LED_MED_Pin|OP_LED_Pin, GPIO_PIN_SET);
2 | 2018-05-26 | Pending |  | Low Battery 상태에서 Plasma disable 시킴 - 현재 Low battery에서 Plasma On 됨 | 적용하지 않기로 함 - 추후 필요시 적용 여부 판단
3 | 2018-05-26 | Closed | 2018-06-07 | 충전중 Plasma disable 시킴 | gpio.c 수정 HAL_GPIO_EXTI_Callback()의 Key interrupt에 아래 조건 추가 if( HAL_GPIO_ReadPin(USB_DET_GPIO_Port,USB_DET_Pin) == GPIO_PIN_RESET)
4 | 2018-05-26 | Closed | 2018-06-07 | Plasma On 상태에서는 Level control disabel 시킴 | gpio.c 수정 HAL_GPIO_EXTI_Callback()의 Key interrupt에 아래 조건 추가 if(HAL_GPIO_ReadPin(KEY_OP_GPIO_Port,KEY_OP_Pin) == GPIO_PIN_SET)
5 | 2018-05-26 | Closed | 2018-06-07 | booting 초기에 Plasma Level를 Low로 Setting하고 LOW_LED On 상태를 유지함 - Plasma 동작전에 Level를 Setting함. | Power On LED Cycling 후 동작 시작하도록 수정 Chargetask_init.c OutEventtask_signals.h mc.c
6 | 2018-05-26 | Closed | 2018-06-04 | PWM Pulse frequency 수정 80KHz -> 70KHz | Plasma_state.c 수정 #define TIM1_OUTPUT_CLK (70000) //6/4 Arvid TIM1 output clock = 70KHz
7 | 2018-05-26 | Closed | 2018-06-05 | Plasma Level control 안됨 - Always On으로 동작함 - Plasma On time 계산 수정 : 4msec / 6msec / 8msec | Plasma_state.c 수정 #define PLASMA_STEP_TIME_PWM_MSEC 2 PlasmaOnTime = PLASMA_STEP_TIME_PWM_MSEC*(PlasmaLevel+2); uint32_t getPlasmaVolLevel() 삭제
8 | 2018-05-26 | Closed | 2018-06-07 | Plasma On 상태에서만 Level control Key가 동작함 | InEventtask.c - DOWN/UP Key event에 아래 code 추가 xTimerStop(xkeyCheckTimer,0); xTimerStart(xkeyCheckTimer,0);
9 | 2018-06-07 | Closed | 2018-06-07 | PWM Pulse frequency 낮게 나옴 - 30KHz 정도 | main.c 수정 RCC_ClkInitStruct.APB1CLKDivider = RCC_HCLK_DIV1;
10 | 2018-12-24 | Closed |  | Power Off가 안됨. | KEY_PWR_Pin GPIO 설정 변경 NOPULL -> PULLDOWN (Gpio.c)
11 | 2018-12-25 | Closed |  | Plasma On Key 동작 안됨. Default Low 유지 | 충전중 Plasma 동작 안하도록 수정하며 생긴 문제임 USB_DET_Pin GPIO 설정 변경 NOPULL -> PULLDOWN (Gpio.c)
12 | 2019-01-01 | OPEN |  | 완충 인식 안됨
13 | 2019-01-16 | Closed | 2019-01-17 | Plasma On후 5초후 S/V On 지원 | Plasma_state.c - Line 24 수정 GPIO_ENABLE(GAS_EN); vTaskDelay( 5000); // 2019.01.17 Arvid - Plasma On delay 5sec
14
15
16
17

Sheet: Function
Fucntion |  | 하부 Item | 동작 | P/F | Commant
Power | Battery | normal Status | LED Blue On | OK | 3.6V 이상
 |  | Low battery Status | LED Red blinking On | OK | 3.5V
 |  | Charging | LED Red On | OK
 |  | Full Charge | LED Green On | -
Plasma Level | Initial status | Level | Level = Low | OK | Booting 초기에 무조건 Low level로 Setting 되어야 함
 |  | LED | LED_LOW On | OK
 | UP Key | Level | 현재 상태에서 상위 Level로 Set | OK | High Level에서 UP Key 입력이 들어와도 무시함
 |  | LED | 현재 상태에서 상위 Level의 LED On | OK
 | DOWN Key | Level | 현재 상태에서 하위 Level로 Set | OK | Low Level에서 DOWN Key 입력이 들어와도 무시함
 |  | LED | 현재 상태에서 하위 Level의 LED On | OK
 | 예외처리 | Plasma On 상태에서는 Level control disabel 시킴 |  | OK
Plasma | Normal Status | Key input | Low detect - Push | OK
 |  | LED | Push중 On 상태 유지 | OK
 |  | Pulse | Push중 On 상태 유지 | OK
 |  | S/V | Push중 On 상태 유지 | OK
 | On/Off time | Low level | On : 4msec / Off : 6msec | OK
 |  | Middle Level | On : 6msec / Off : 4msec | OK
 |  | High Level | On : 8msec / Off : 2msec | OK
 | Low Battery | Plasma Function disable
 | Charging Status | Plasma Function disable |  | OK

Sheet: Sheet3
On/Off time | Low level | On : 4msec / Off : 6msec | PLASMA_SPAN_TIME_PWM_MSEC | 10 | msec
 | Middle Level | On : 6msec / Off : 4msec | PLASMA_STEP_TIME_PWM_MSEC | 2 | msec
 | High Level | On : 8msec / Off : 2msec
 |  |  | Level | On Time
 |  |  | 0 | 4
 |  |  | 1 | 6
 |  |  | 2 | 8
