ArvidJoung/Plasma_Generator/1_Plasma_Pipette/3_Firmware/Binary/Pipette SW Revision history.xlsx

Sheet: Revision
Source Path | C:\WORK\Project\3_Source\Test Sourse\V2.0_Source_20190403\plasma_pt
Date | Version | Description
2019-04-03 | V2.00_0.5sec | Plasma On time 조정 : 30%, 40%, 50%
 |  | GAS_EN 후 0.5sec 후 plasma On
2019-04-03 | V2.00_1.0sec | GAS_EN 후 1.0sec 후 plasma On
2019-04-10 | V2.01 | Level LED와 PWR LED 동기 시킴
2019-05-20 | V2.10_1.0sec | GAS_EN 후 1.0sec 후 plasma On, 4.1V 완충(ADC238)
2019-05-20 | V2.10_0.5sec | GAS_EN 후 0.5sec 후 plasma On, 4.1V 완충(ADC238)
2020-04-05 | V2.1_0.5sec_2,3,4msec | GAS_EN 후 0.5sec 후 plasma On, Plasma On time 조정 : 20%, 30%, 40%
 | V2.1_1.0sec_2,3,4msec | GAS_EN 후 1.0sec 후 plasma On, Plasma On time 조정 : 20%, 30%, 40%
 | V2.1_0.5sec_3,4,5msec | GAS_EN 후 0.5sec 후 plasma On, Plasma On time 조정 : 30%, 40%, 50%
 | V2.1_1.0sec_3,4,5msec | GAS_EN 후 1.0sec 후 plasma On, Plasma On time 조정 : 30%, 40%, 50%

Sheet: Plasma On time
PLASMA_SPAN_TIME_PWM_MSEC | 10 |  |  | 10
PLASMA_STEP_TIME_PWM_MSEC | 2 |  |  | 1
Constant | 2 |  |  | 3
PlasmaLevel | 0 | 1 | 2 | 0 | 1 | 2
PlasmaOnTime | 4 | 6 | 8 | 3 | 4 | 5
