ArvidJoung/Plasma_Generator/5_JTAG PCB/1_Schematic/Plasma_Pipette_JTAG_SCH_V1.0.pdf

# FEMTO SCIENCE

# Debug Connector

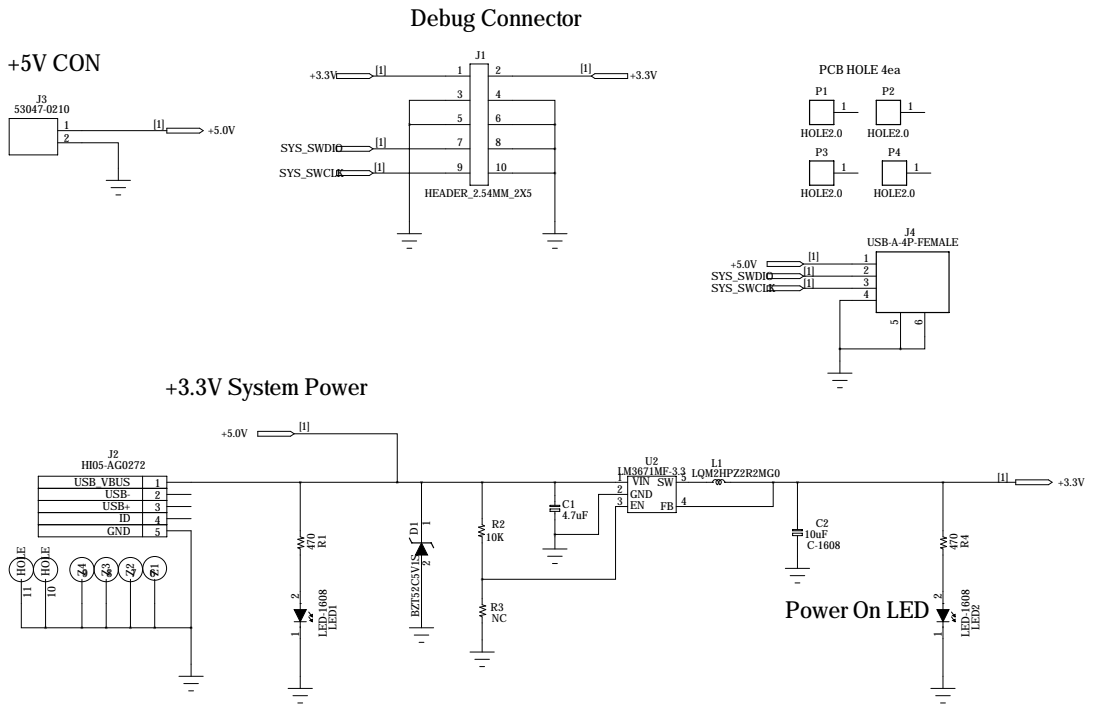
[picture p107: page 1]

USB- | 2
USB+ | 3
ID | 4
GND | 5
