ArvidJoung/Plasma_Generator/1_Plasma_Pipette/1_Schematic/V2.0_Type2/PLASMA_PIPETTE_V2.0_MAIN_PCB_20181009_COMPANY.pdf

# C23C²³x1 C²³x2

# C18C¹⁸x1 C¹⁸x2

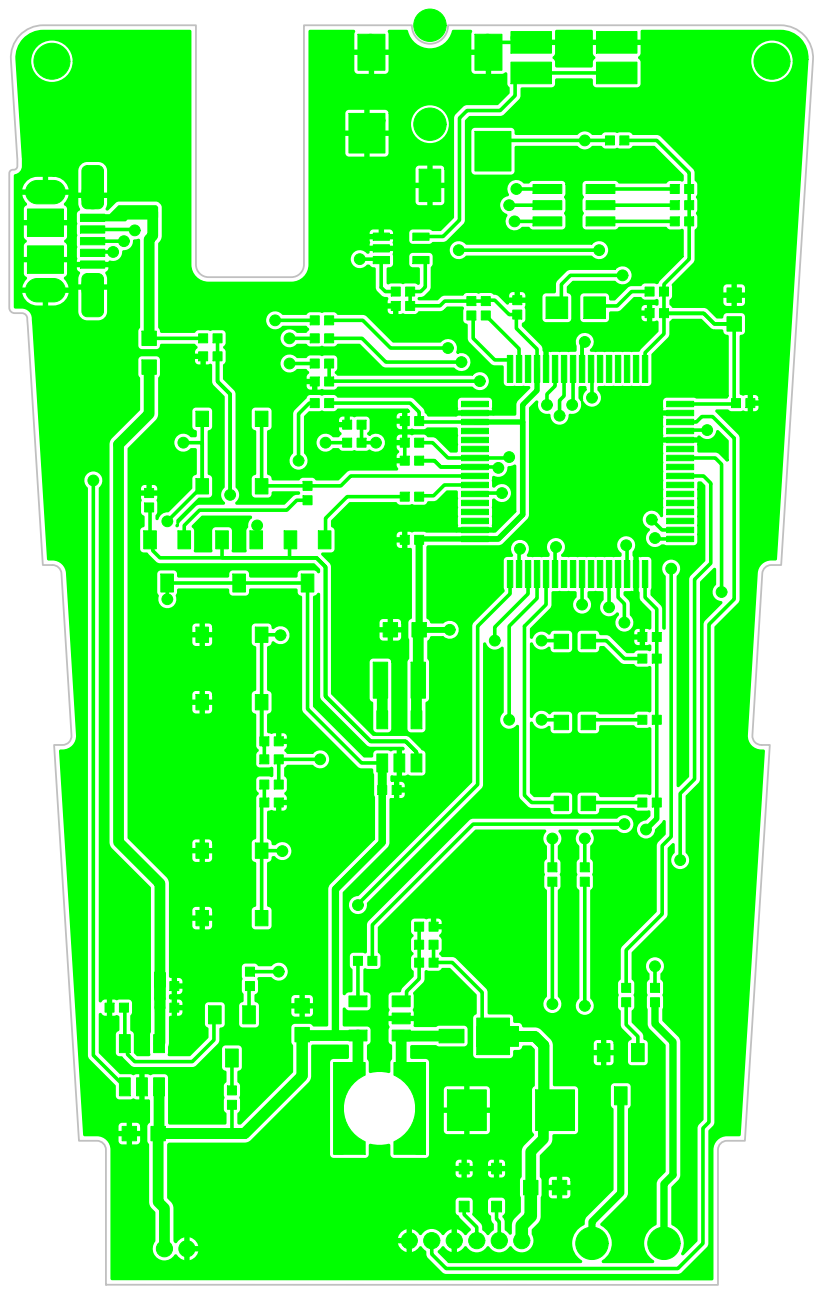
[picture p108: page 1]

# P1P¹x1

# P2P²x1

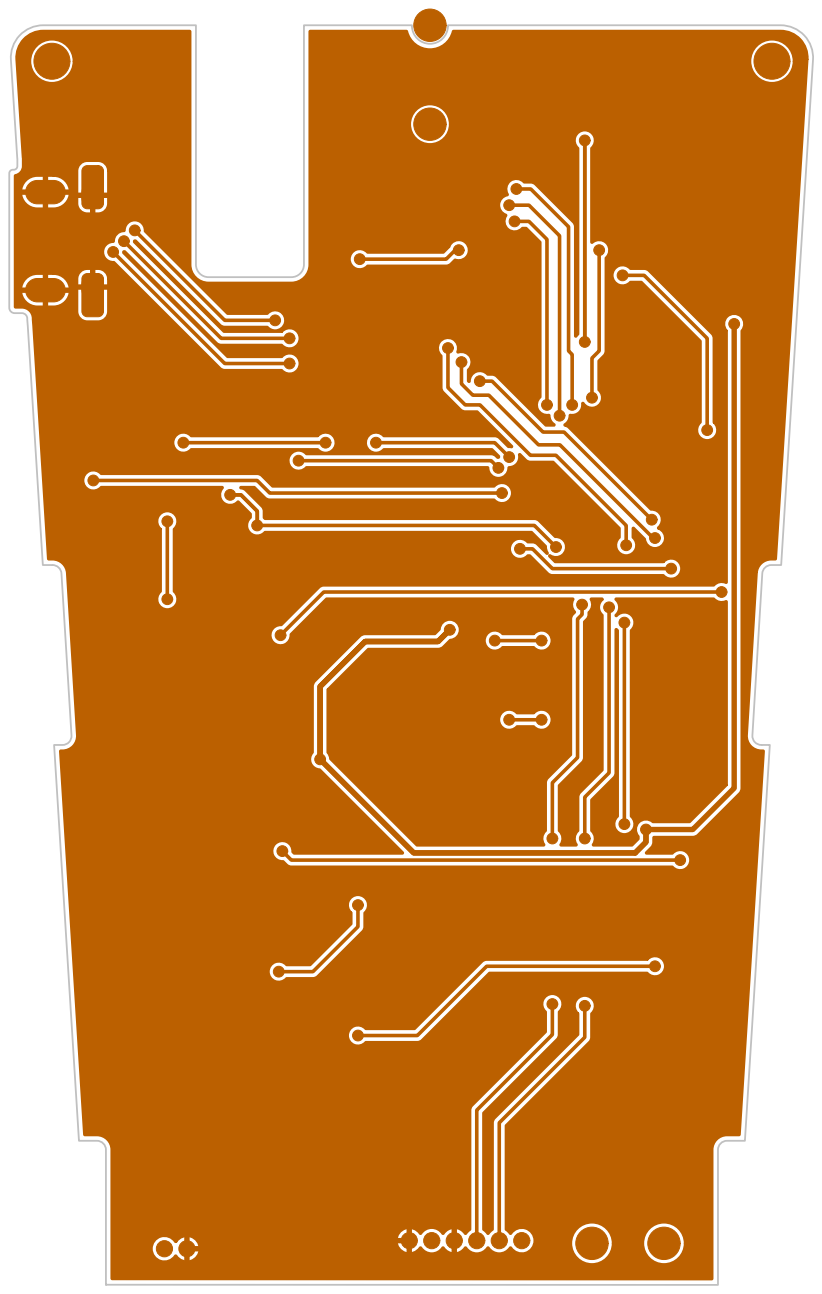
[picture p109: page 2]
BATT BATTx2; BATTx1

C20

C3

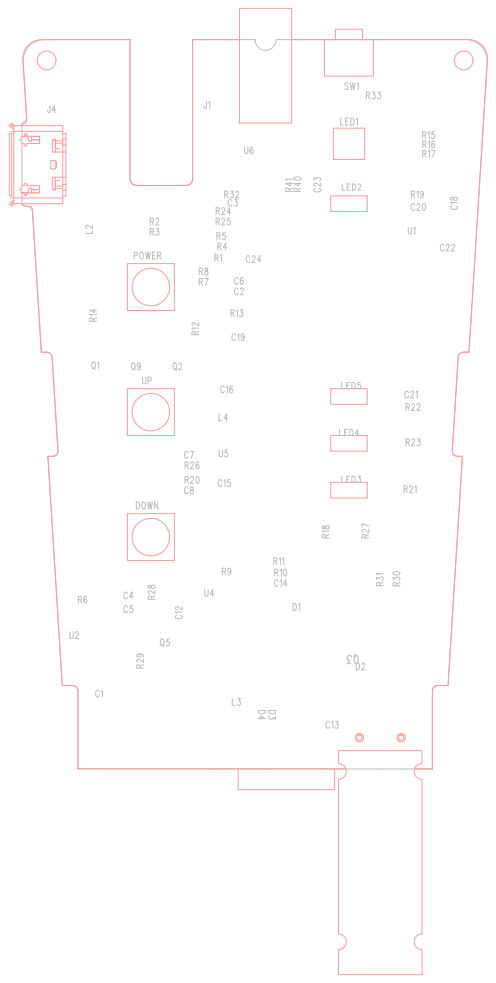
[picture p110: page 3]

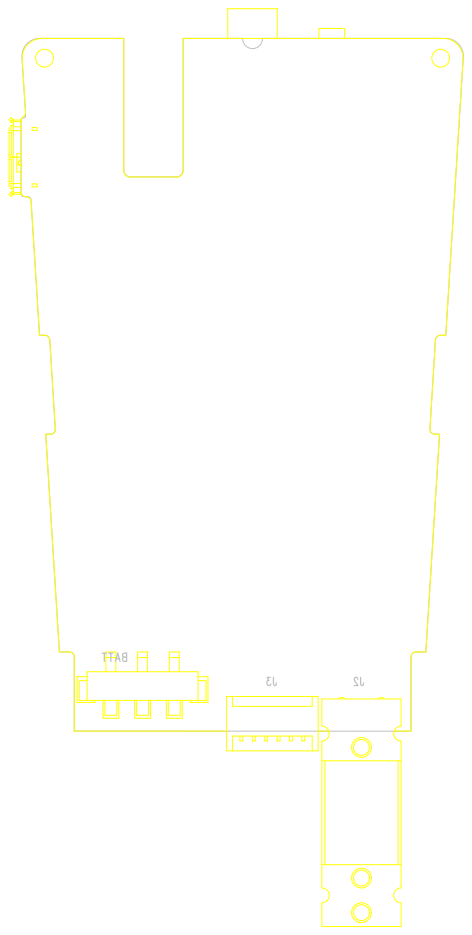
[picture p111: page 4]
BATT

+

10

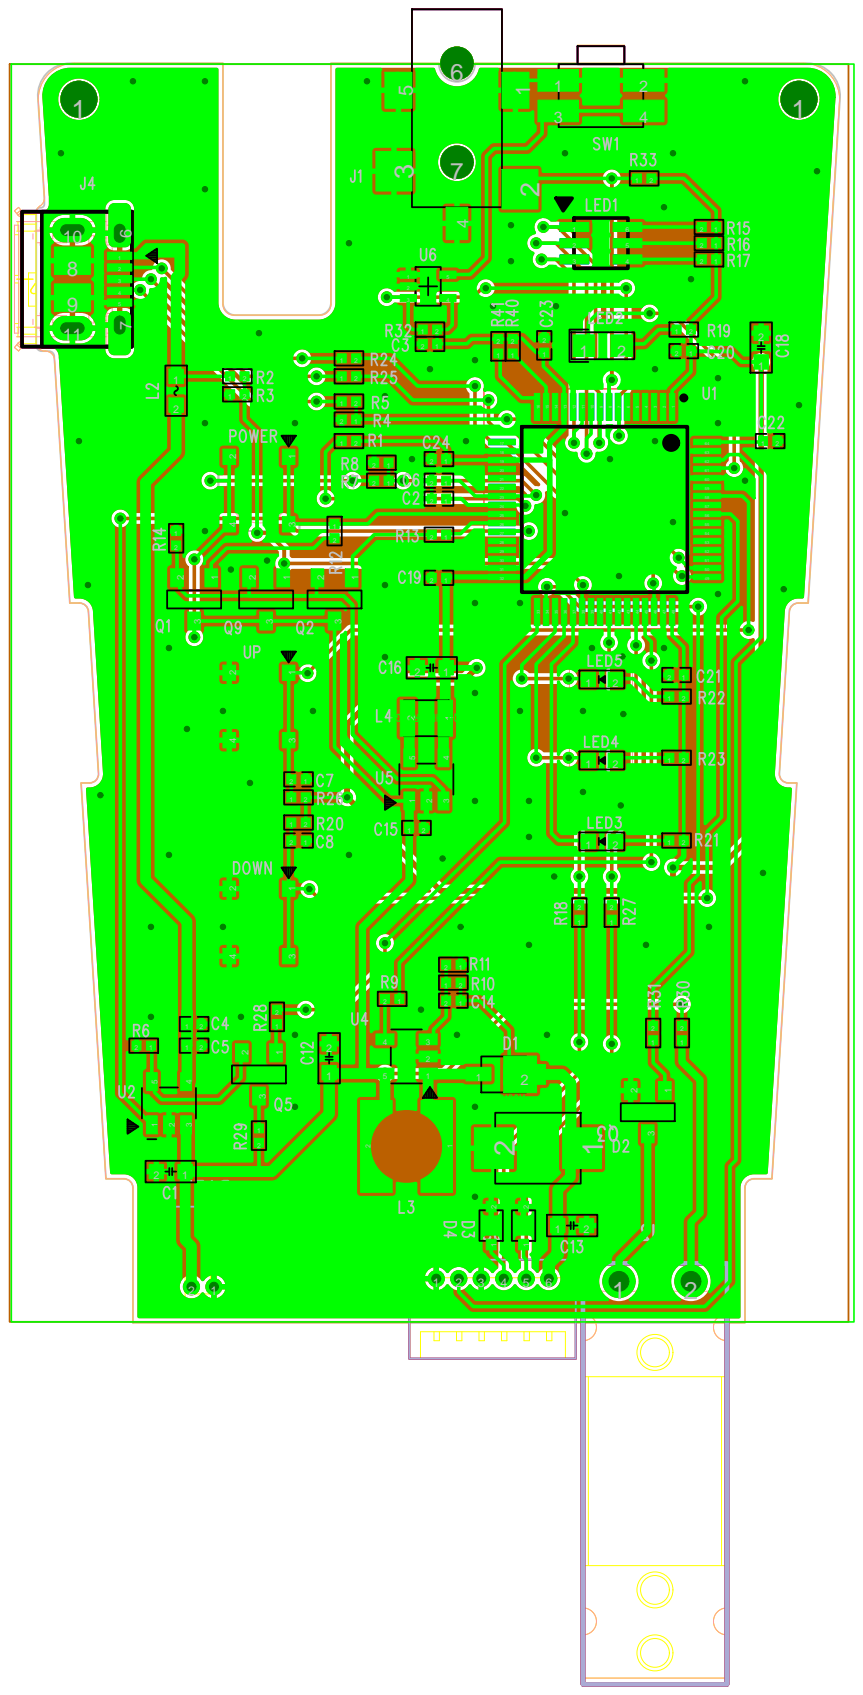
[picture p112: page 5]

LED2 LED²x1 1 | LED²x2 2
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
