ArvidJoung/Plasma_Generator/1_Plasma_Pipette/1_Schematic/V2.0/Plasma_Pipette_V2.0_Main_SCH_20180805.pdf

# FIVE FINGER

# MCU Schematic

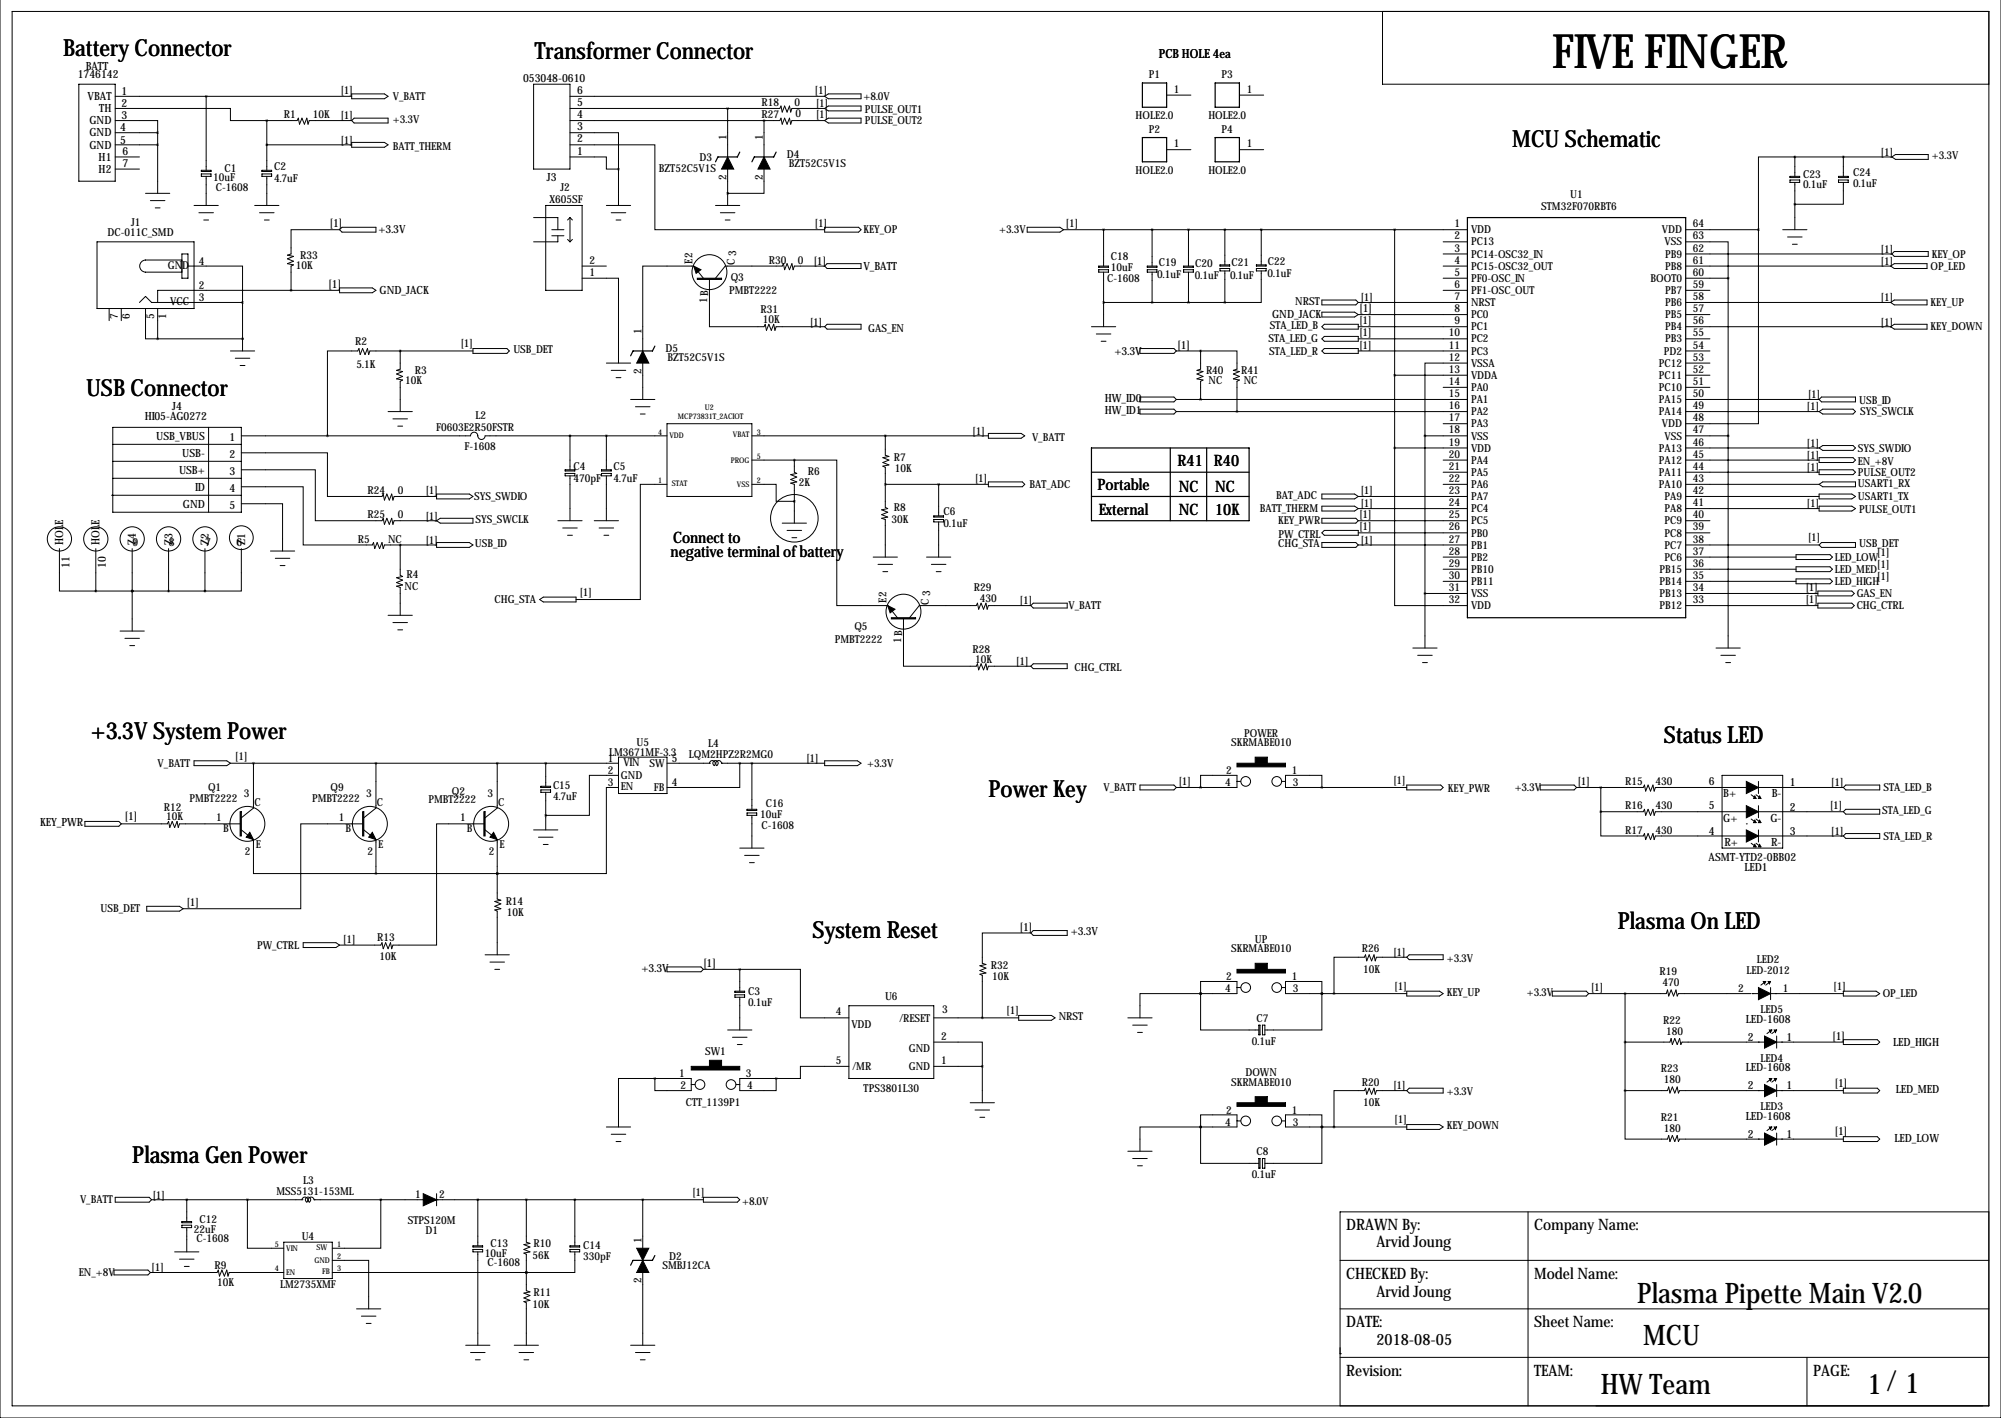
[picture p113: page 1]

USB+ | 3
ID | 4

Portable | NC NC | NC NC

Connect to
negative terminal of battery
