ArvidJoung/Plasma_Generator/0_MP4 Data/Plasma_Pipette_V5.1_Main_SCH_20190610.pdf

# MCU Schematic

# System Reset

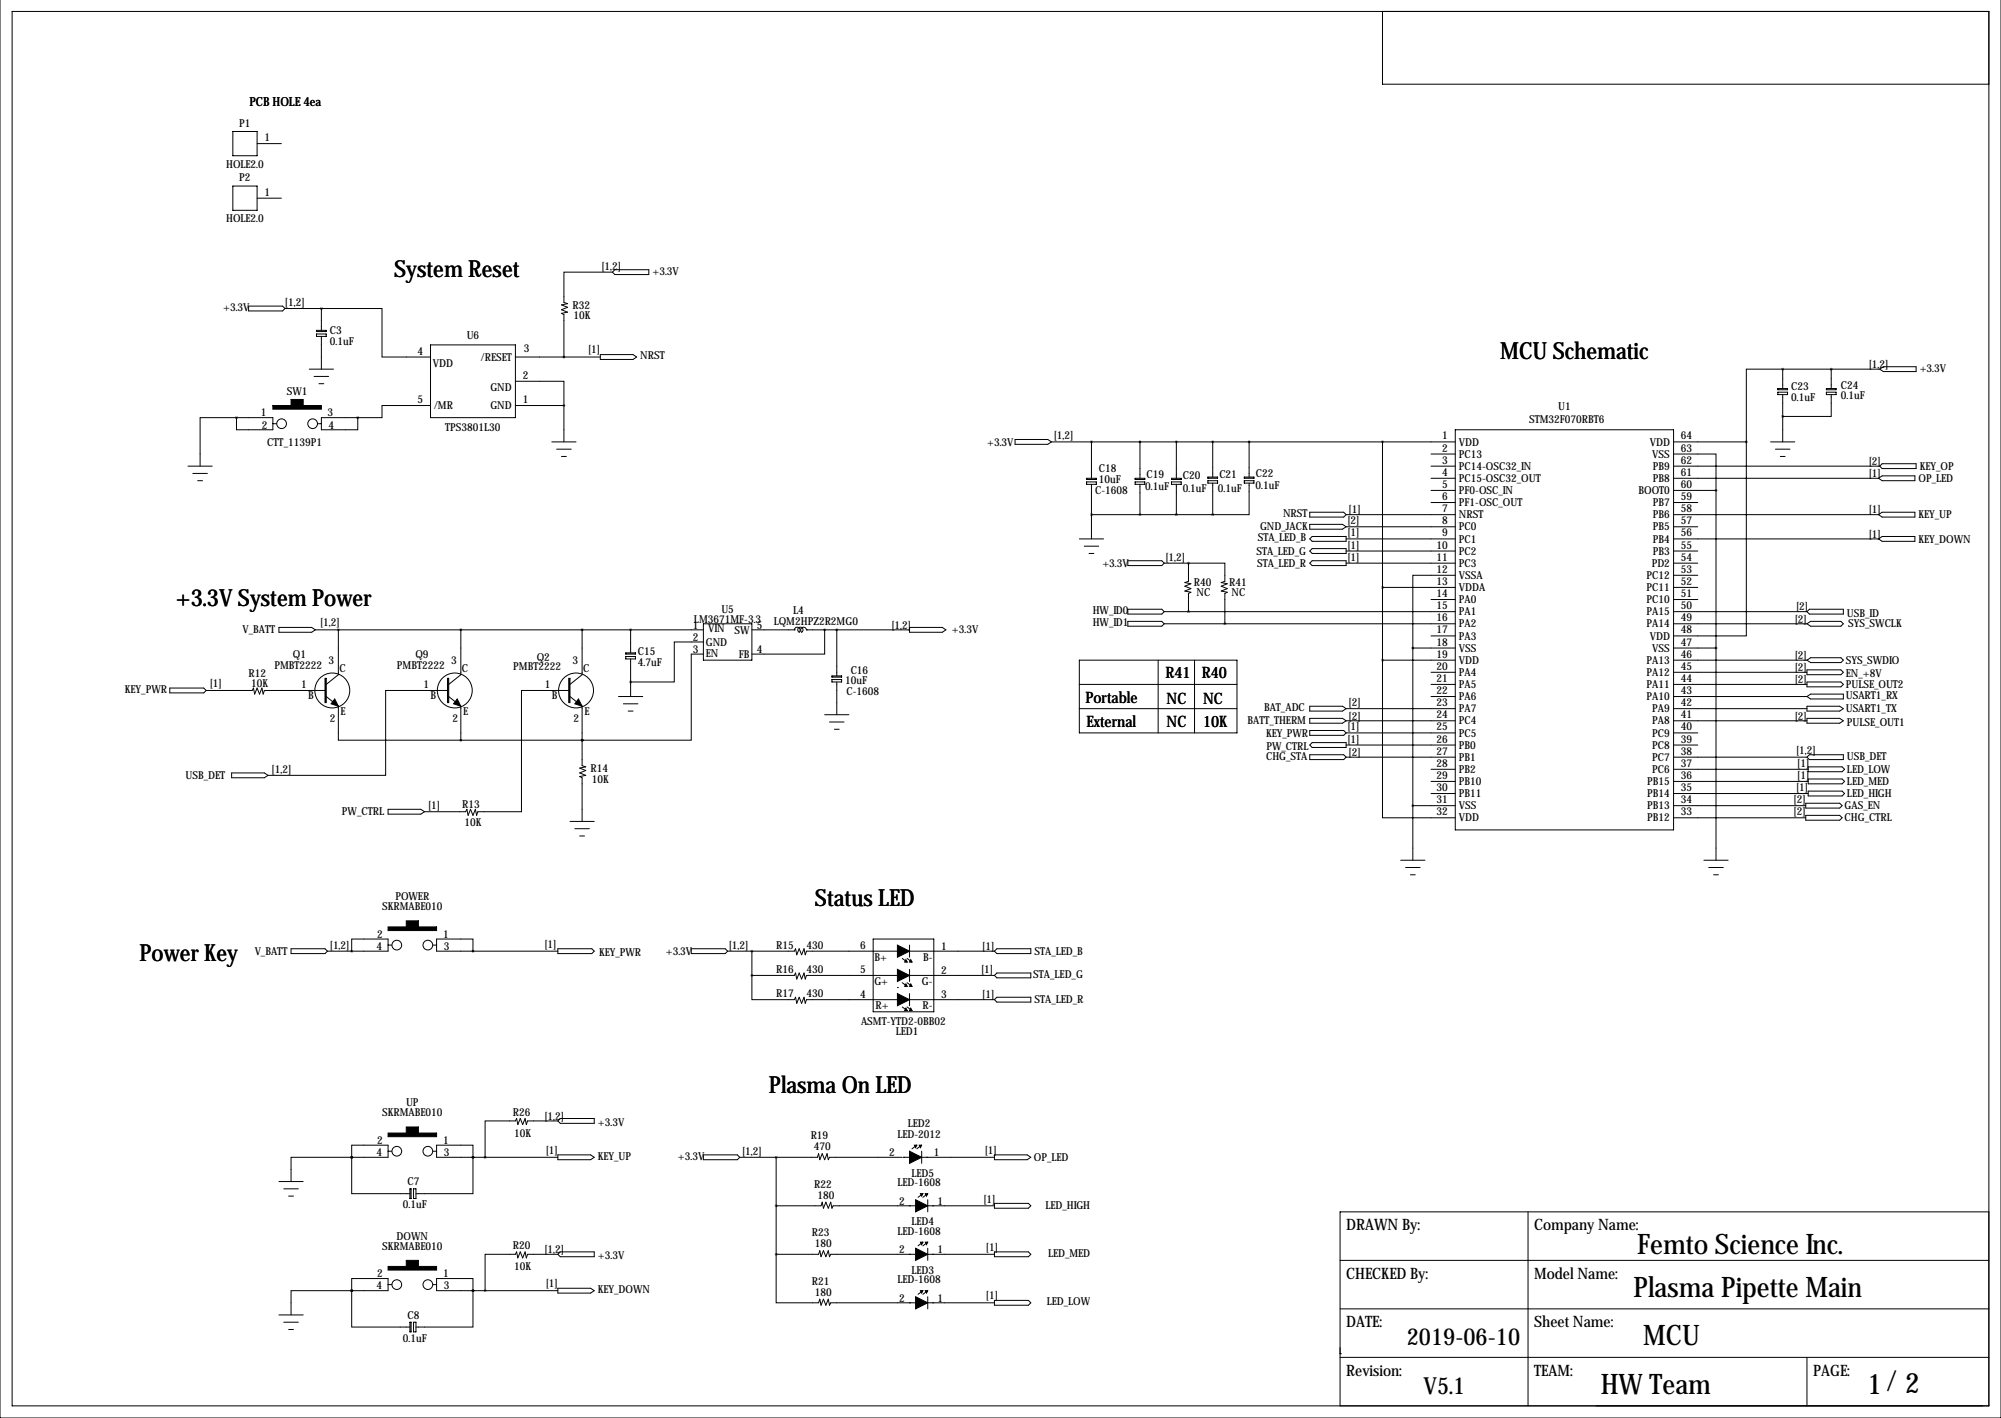
[picture p114: page 1]

Battery Connector | Transformer Connector

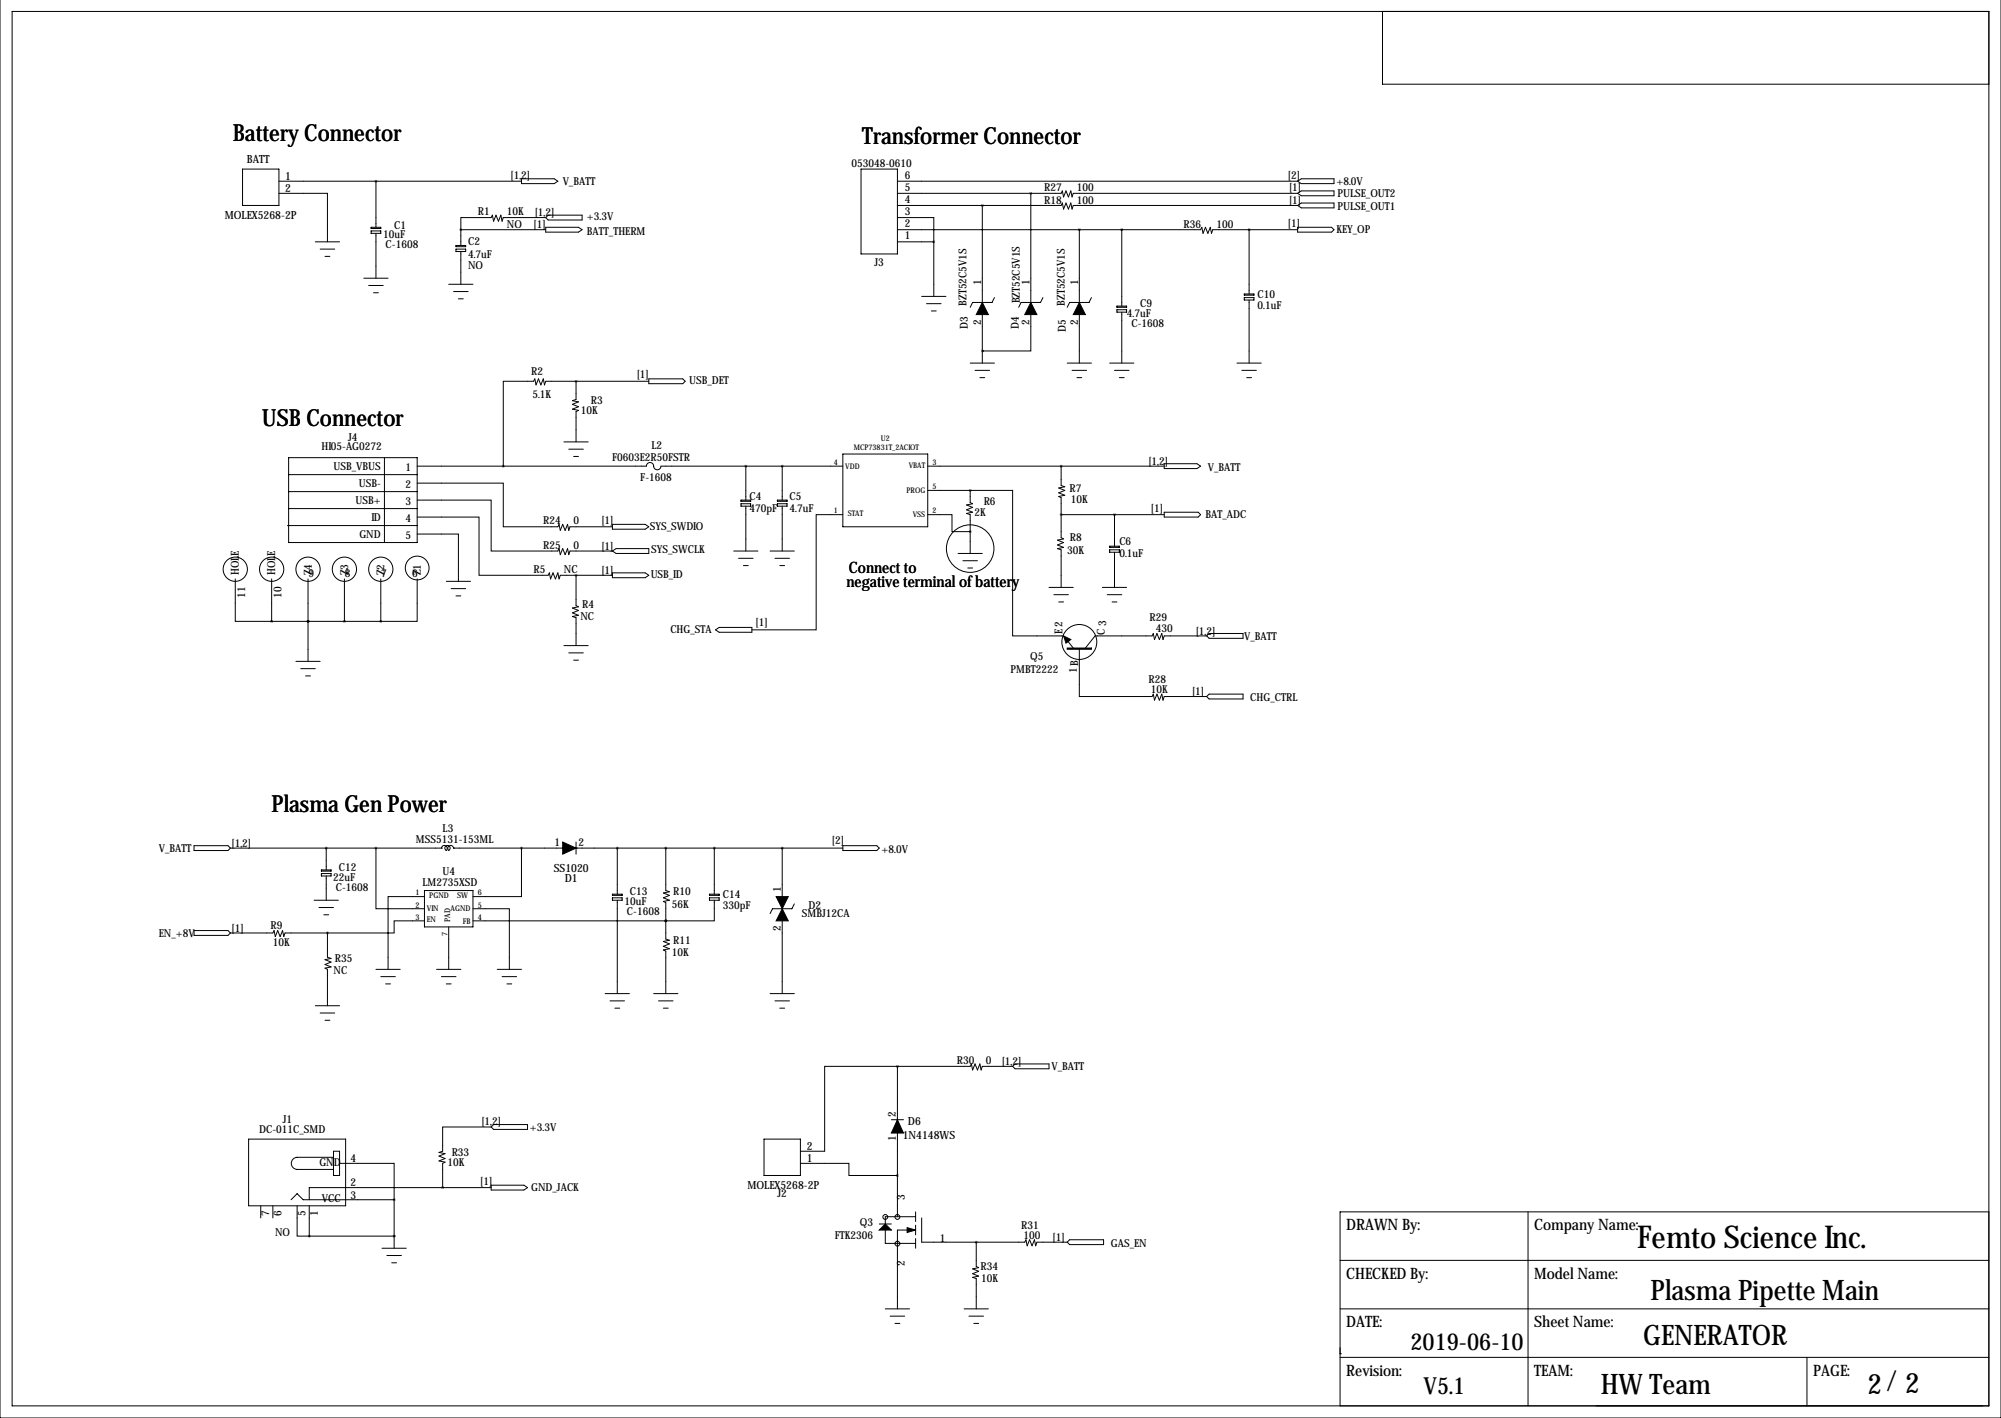
[picture p115: page 2]

USB- | 2
USB+ | 3
ID | 4
GND | 5

Connect to
negative terminal of battery
