ArvidJoung/Plasma_Generator/0_MP4 Data/Plasma_Pipette_V5.0_Main_SCH_20190521.pdf

# MCU Schematic

# System Reset

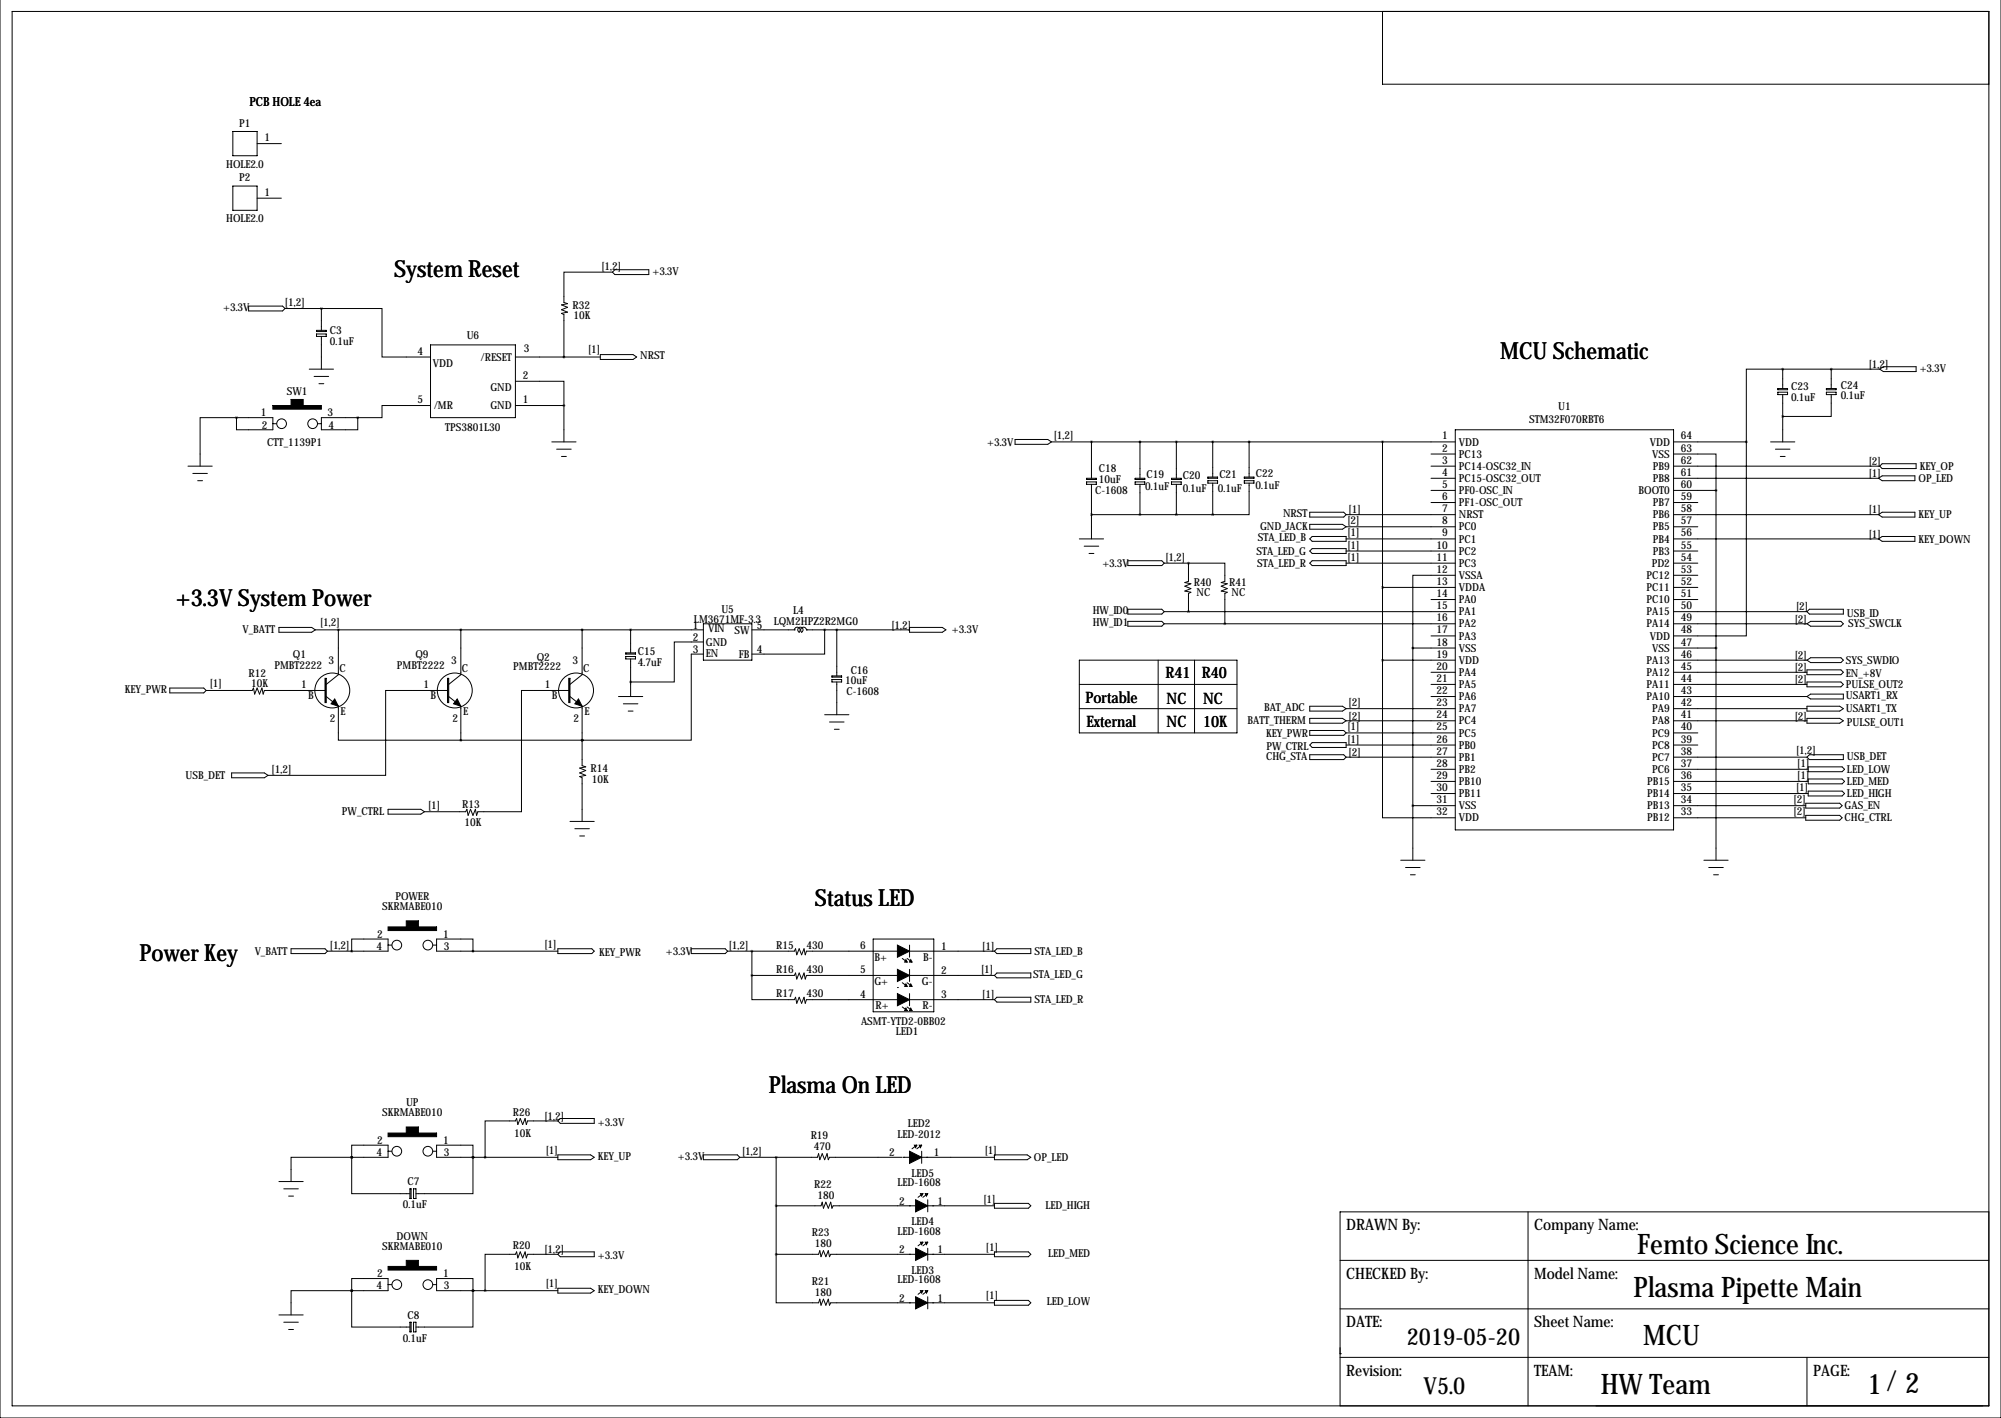
[picture p116: page 1]

Battery Connector | Transformer Connector

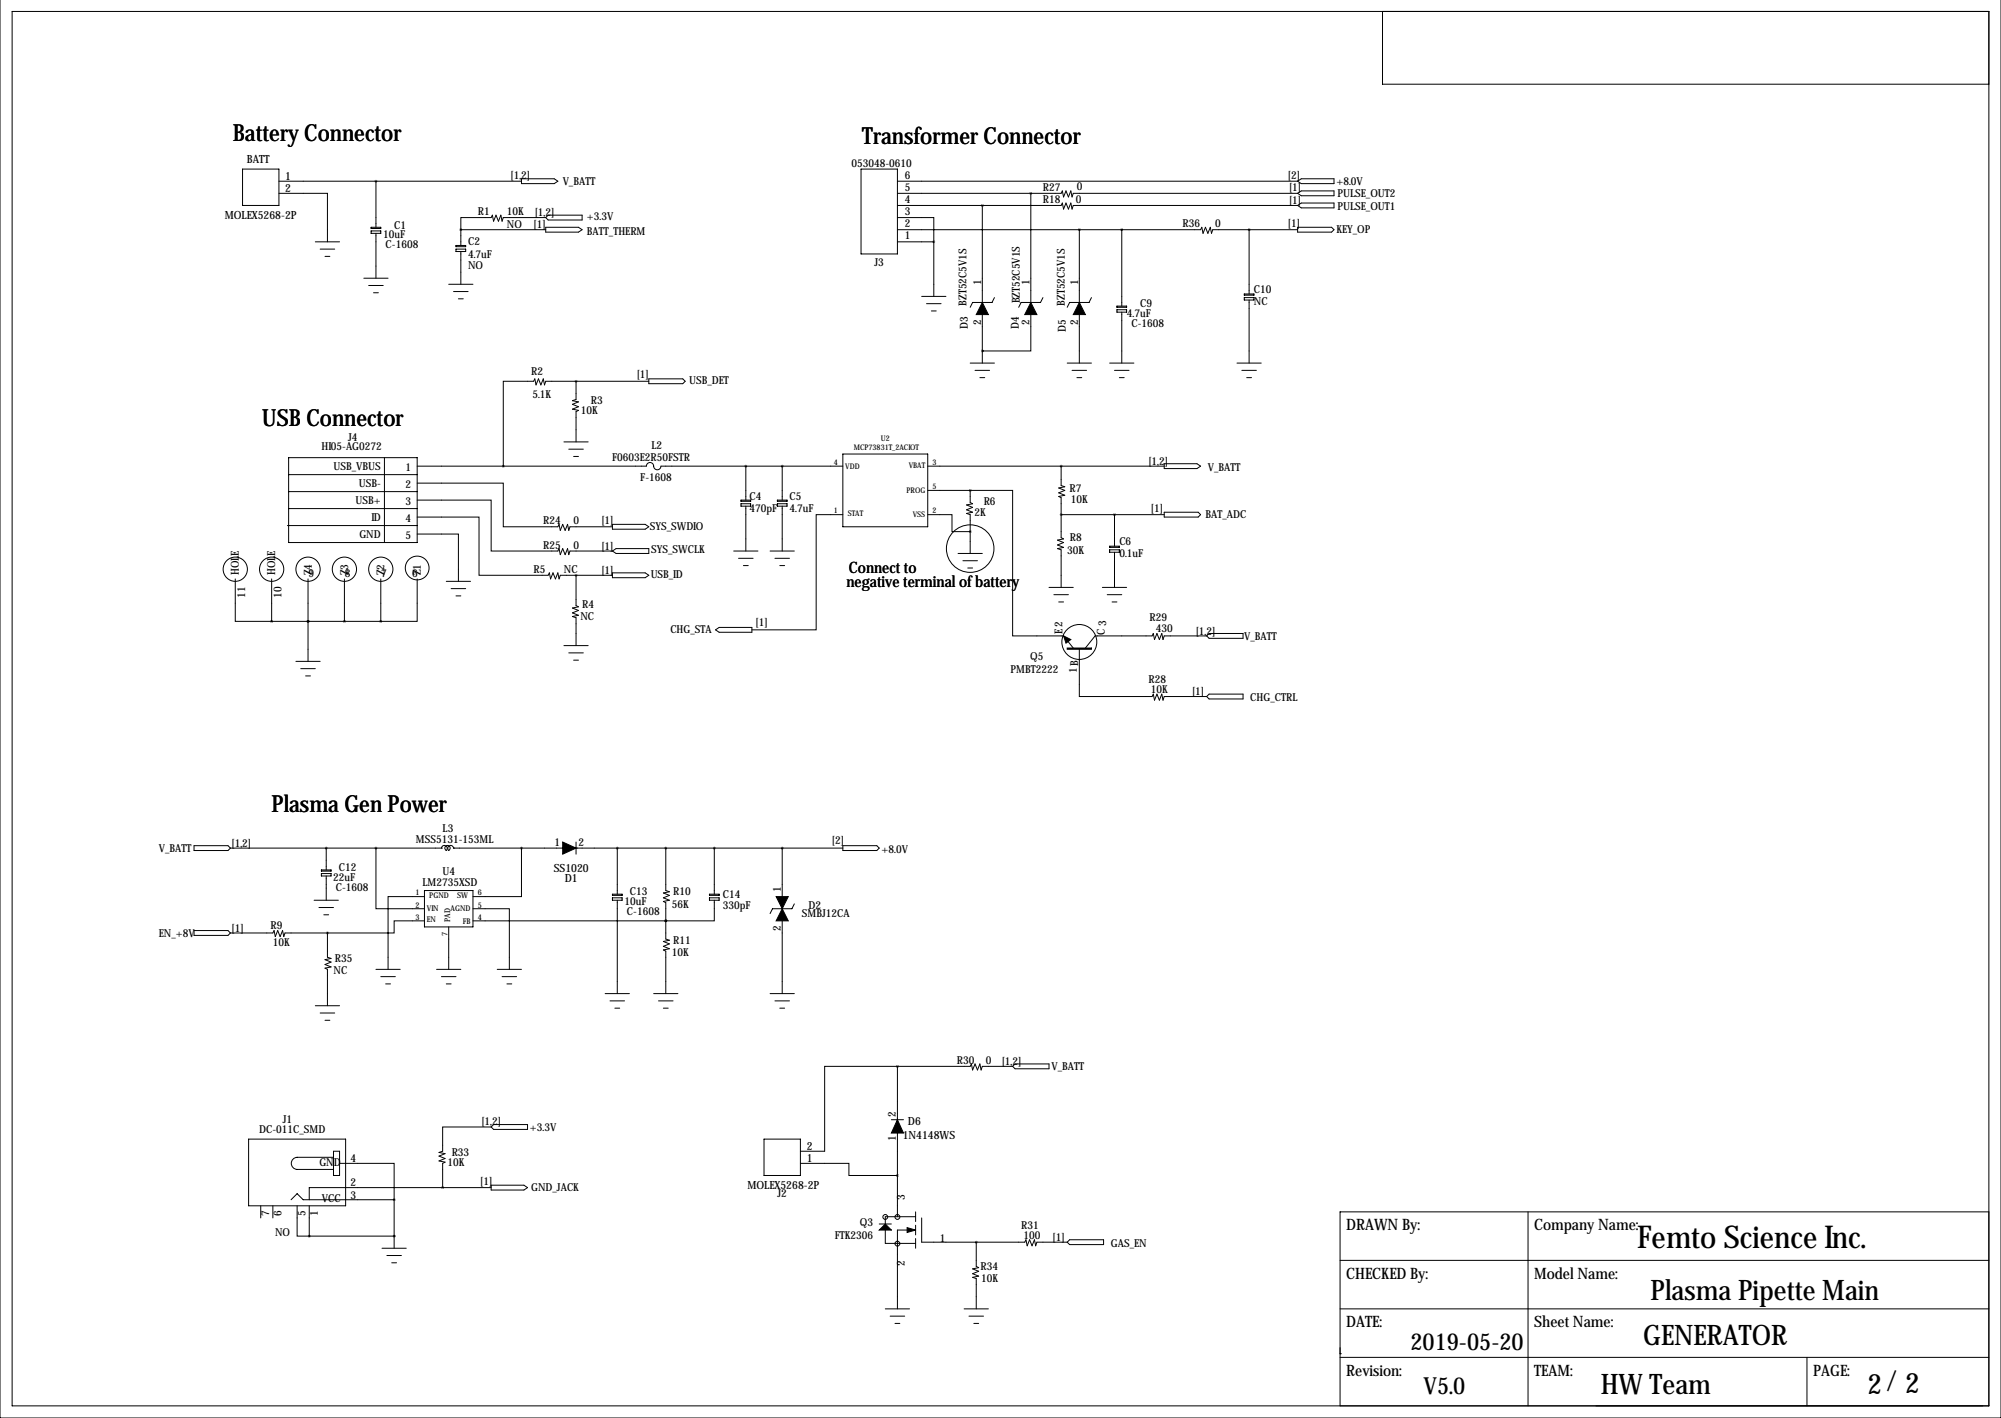
[picture p117: page 2]

USB- | 2
USB+ | 3
ID | 4
GND | 5

Connect to
negative terminal of battery
