ArvidJoung/Plasma_Generator/0_DOC/20190224_Femto 과제용 자료/Plasma_Pipette_Transformer_SCH_V3.0_20190224.pdf

# Main PCB CON

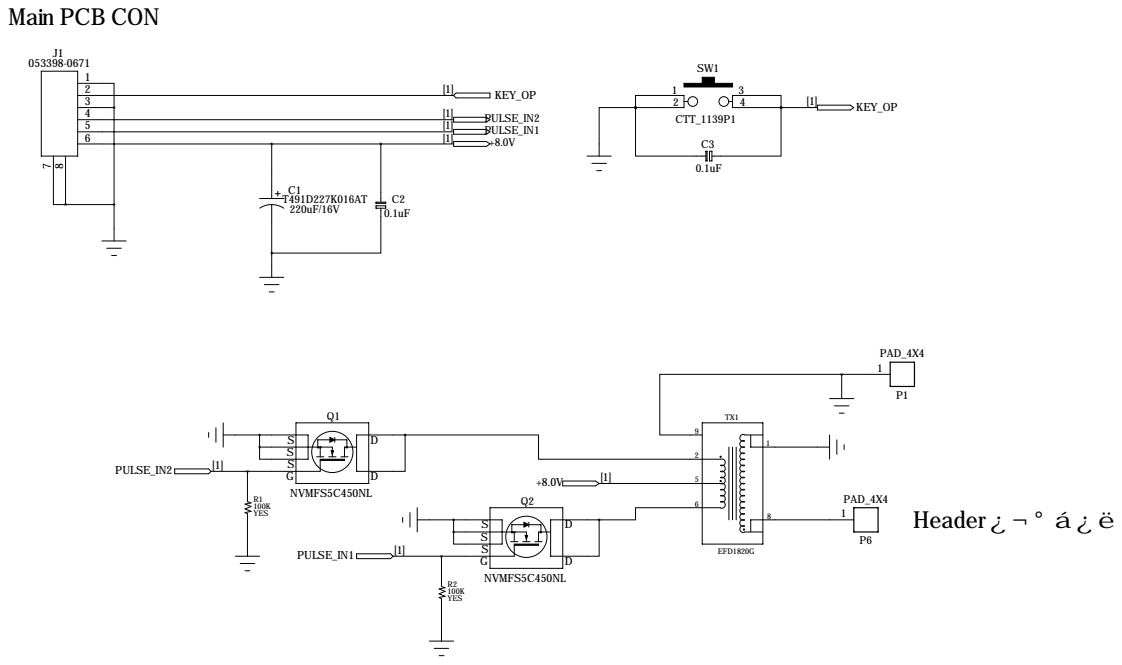
[picture p118: page 1]
