ArvidJoung/Plasma_Generator/0_DOC/20190224_Femto 과제용 자료/Plasma_Pipette_V2.0_Main_SCH_20181104_VX2.3_과제.pdf

# MCU Schematic

# MCU Schematic

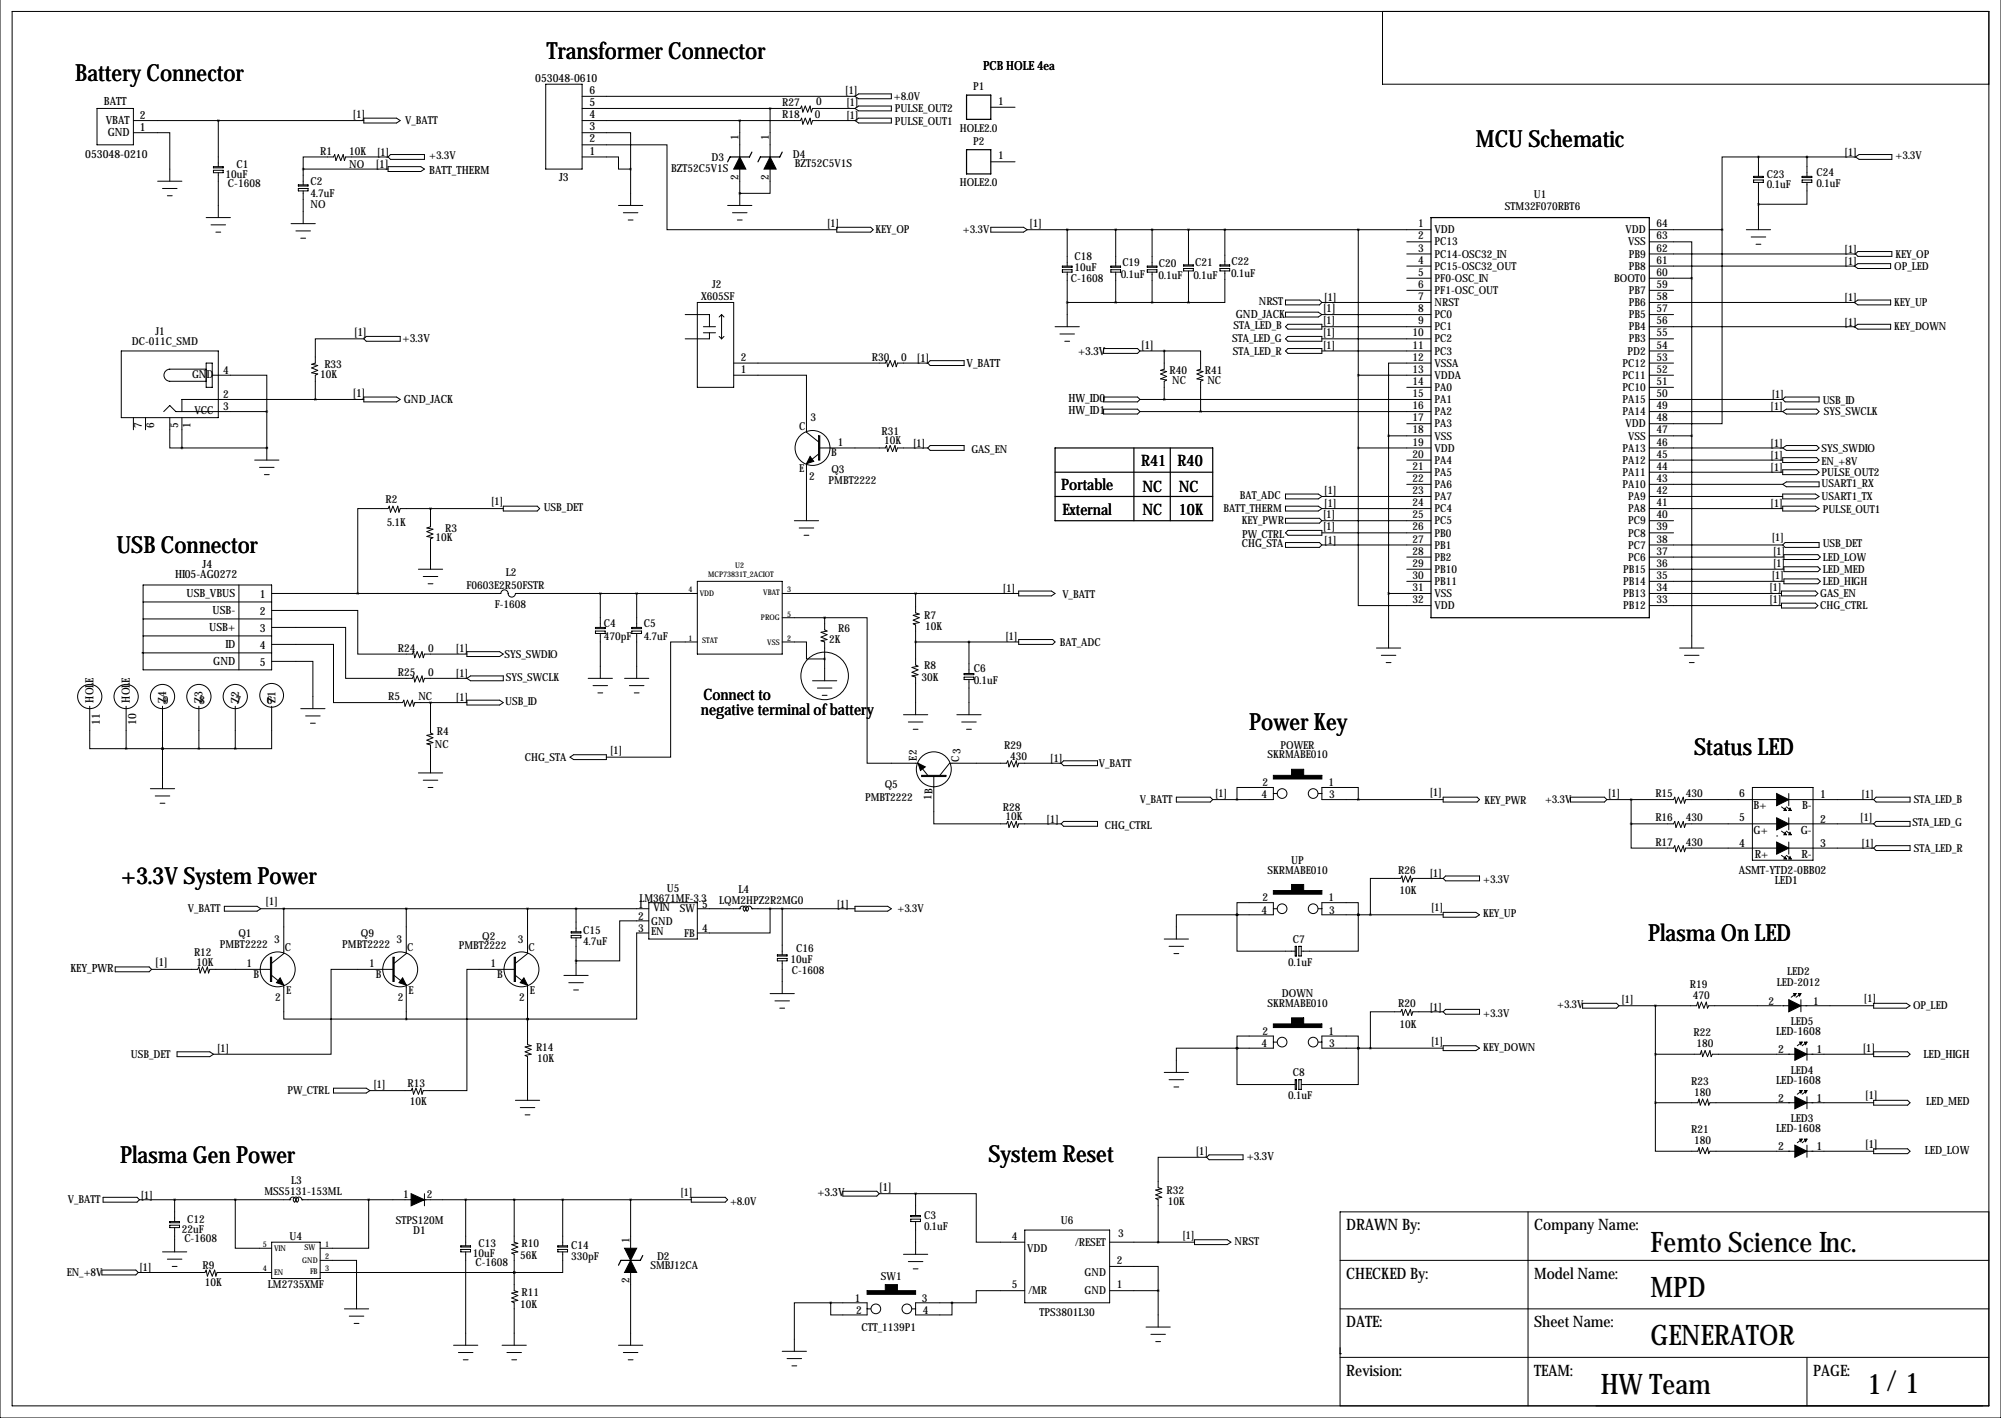
[picture p119: page 1]

Portable | NC NC | NC NC
External | NC NC | 10K

USB- | 2
USB+ | 3
ID | 4
GND | 5

Connect to
negative terminal of battery
