ArvidJoung/Plasma_Generator/1_Plasma_Pipette/0_Block Diagram/Plasma_Gen_Block Diagram_V1.0.pdf

# Plasma Pipette V1.0

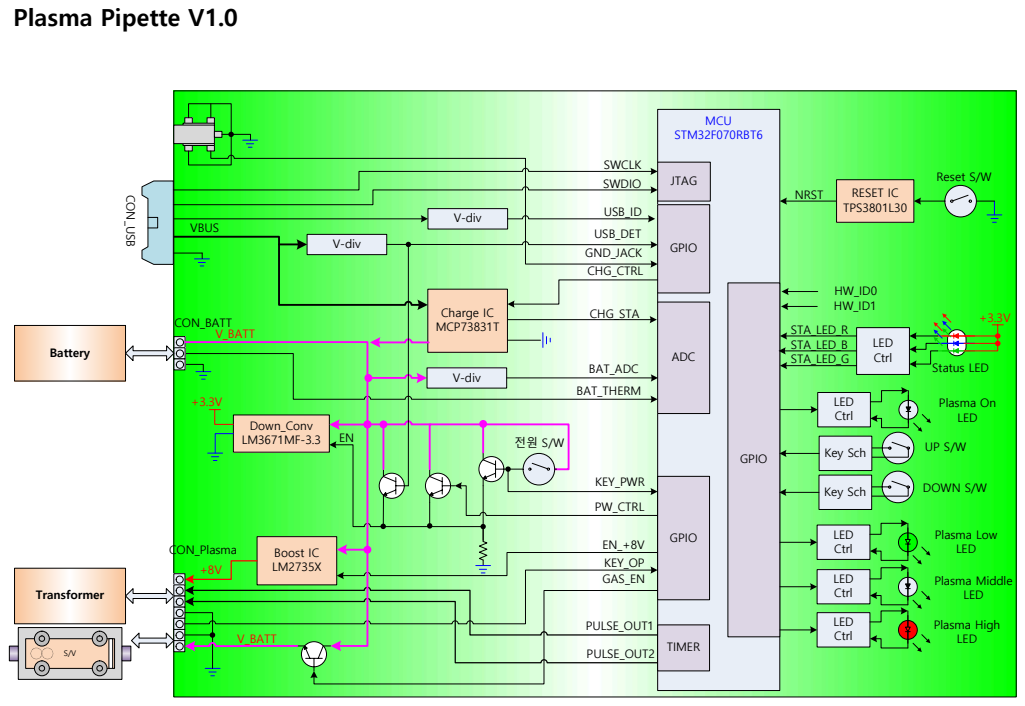
[picture p120: page 1]
MCU STM32F070RBT6; Down_Conv LM3671MF-3.3; V_BATT; KEY_PWR; PW_CTRL; Charge IC MCP73831T; USB_ID; VBUS; CHG_STA; BAT_THERM; ADC; CON_BATT; NRST; JTAG; Reset S/W; V-div; USB_DET; BAT_ADC; C O N_USB; GPIO; LED Ctrl; Plasma On LED; Boost IC LM2735X; EN_+8V CON_Plasma; TIMER; PULSE_OUT1; PULSE_OUT2; Transformer; Battery; CHG_CTRL; Status LED; STA_LED_G; STA_LED_R; STA_LED_B; LED; Ctrl; Key Sch; DOWN S/W; Plasma Low LED; Plasma Middle LED; Plasma High LED; SWCLK; SWDIO; GAS_EN; KEY_OP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

UP S/W Key Sch
