ArvidJoung/Plasma_Generator/0_DOC/20180206_Femto 요청자료/Plasma_Gen_Block Diagram_V2.0_20180107.pdf

# Plasma Generator V2.0

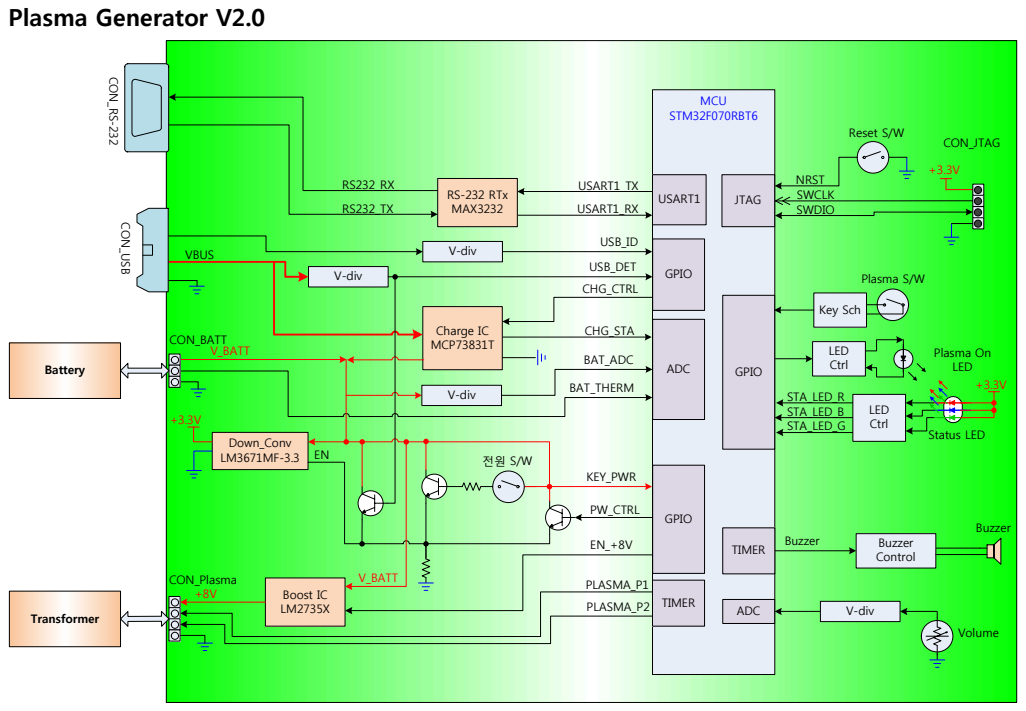
[picture p121: page 1]
MCU STM32F070RBT6; Down_Conv LM3671MF-3.3; V_BATT; KEY_PWR; PW_CTRL; Charge IC MCP73831T; USART1; USART1_TX; USART1_RX; USB_ID; VBUS; CHG_STA; BAT_THERM; ADC; CON_BATT; SWCLK SWDIO; NRST; JTAG; CON_JTAG; Reset S/W; RS-232 RTx MAX3232; V-div; USB_DET; BAT_ADC; C O N_USB; Status LED; STA_LED_G; STA_LED_R STA_LED_B; GPIO; Buzzer Control; Buzzer; TIMER; Plasma S/W; Key Sch; LED Ctrl; Plasma On LED; Boost IC LM2735X; CON_Plasma TIMER +8V; PLASMA_P1; PLASMA_P2; Transformer; Battery; Volume; CHG_CTRL
