ArvidJoung/Plasma_Generator/0_DOC/20180206_Femto 요청자료/Plasma_Gen_Main Board_SCH_V2.0_20180107.pdf

# FIVE FINGER

# MCU Schematic

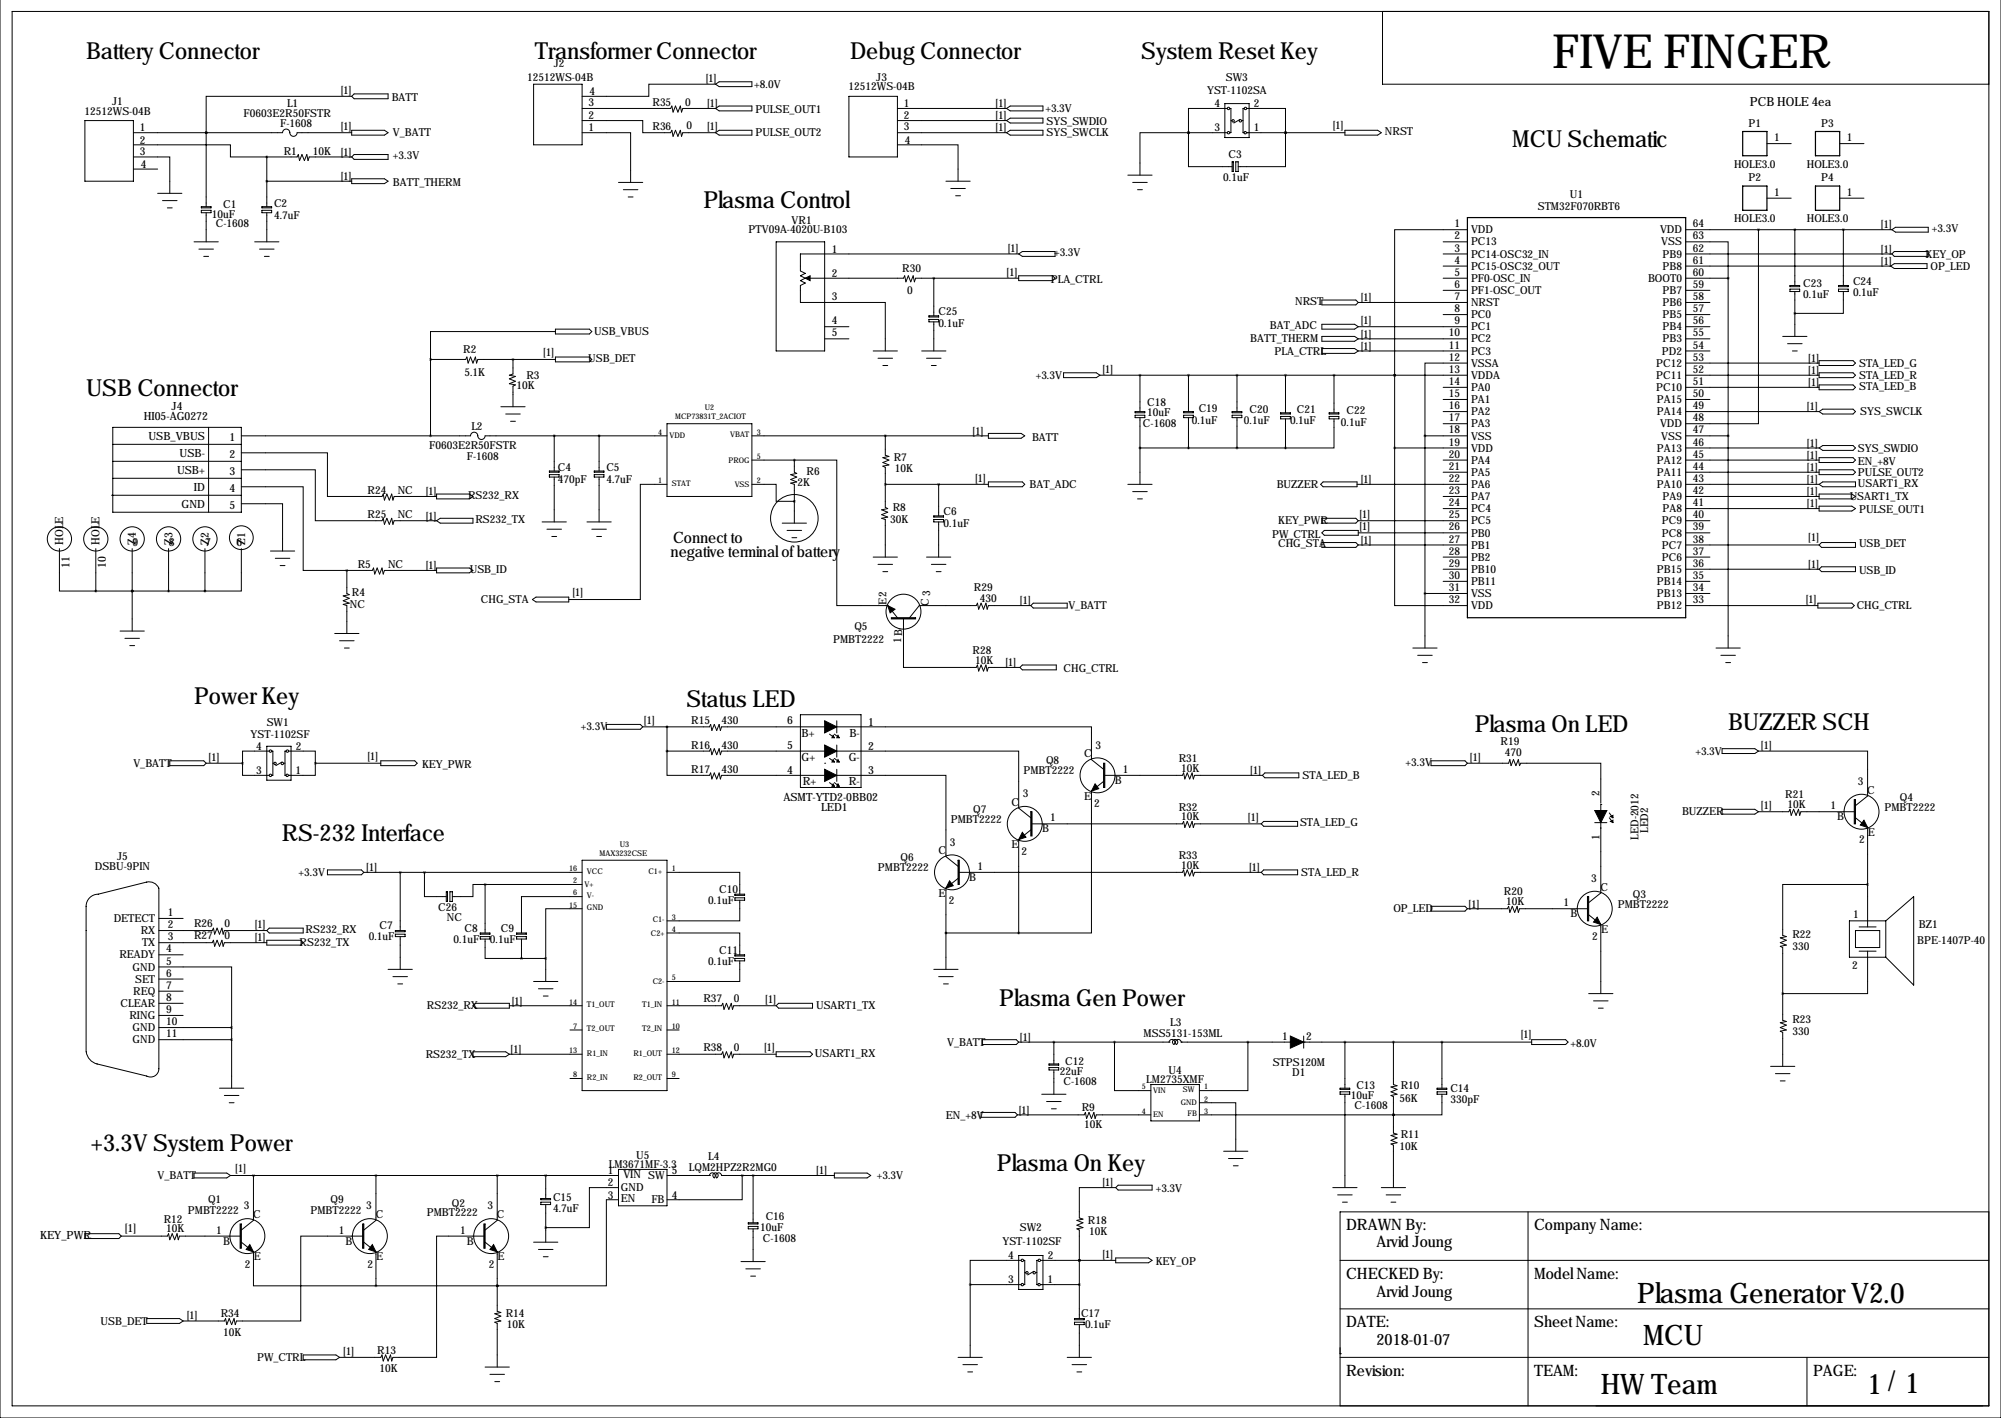
[picture p122: page 1]

USB- | 2
USB+ | 3
ID | 4
GND | 5

Connect to
negative terminal of battery
