ArvidJoung/Plasma_Generator/0_DOC/20180206_Femto 요청자료/Plasma_Gen_Project schedule_20180104.pdf

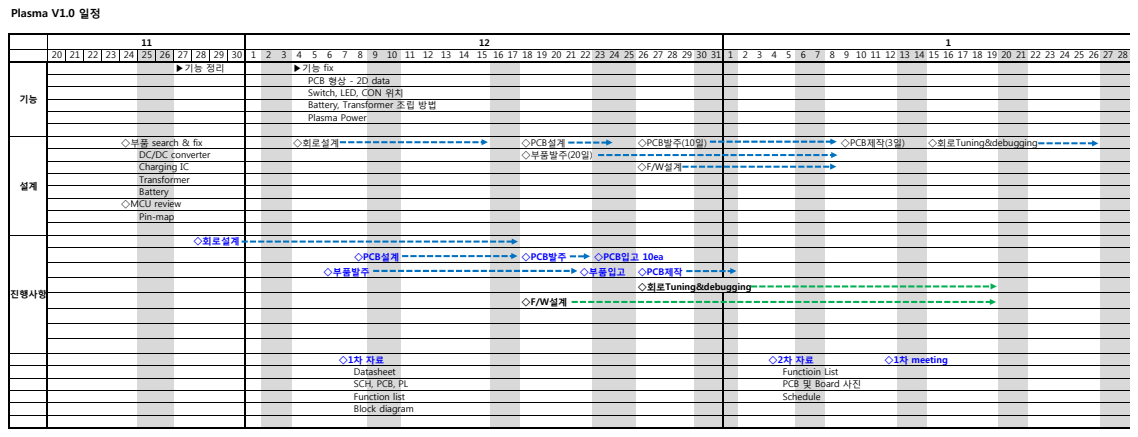
[picture p123: page 1]
Plasma V1.0 일정; ▶기능 fix; ◇부품 search & fix; ◇회로설계; ◇PCB설계; ◇PCB발주(10일); ◇PCB제작(3일); ◇회로Tuning&debugging; DC/DC converter; ◇부품발주(20일); Charging IC; ◇F/W설계; Transformer Battery ◇MCU review Pin-map; ◇PCB발주; ◇PCB입고 10ea; ◇부품발주; ◇부품입고 ◇PCB제작; ◇1차 meeting; Datasheet; Functioin List; SCH, PCB, PL; PCB 및 Board 사진; Function list; Schedule; Block diagram; 진행사항

PCB 형상 - 2D data
Switch, LED, CON 위치
Battery, Transformer 조립 방법
Plasma Power
