ArvidJoung/Plasma_Generator/2_Micro_Plasma_Dispenser/0_DOC/20191111_MAIN V2.0/MPD-MAIN_SCH_V2.0_20190922.pdf

# MCU Schematic

# System Reset

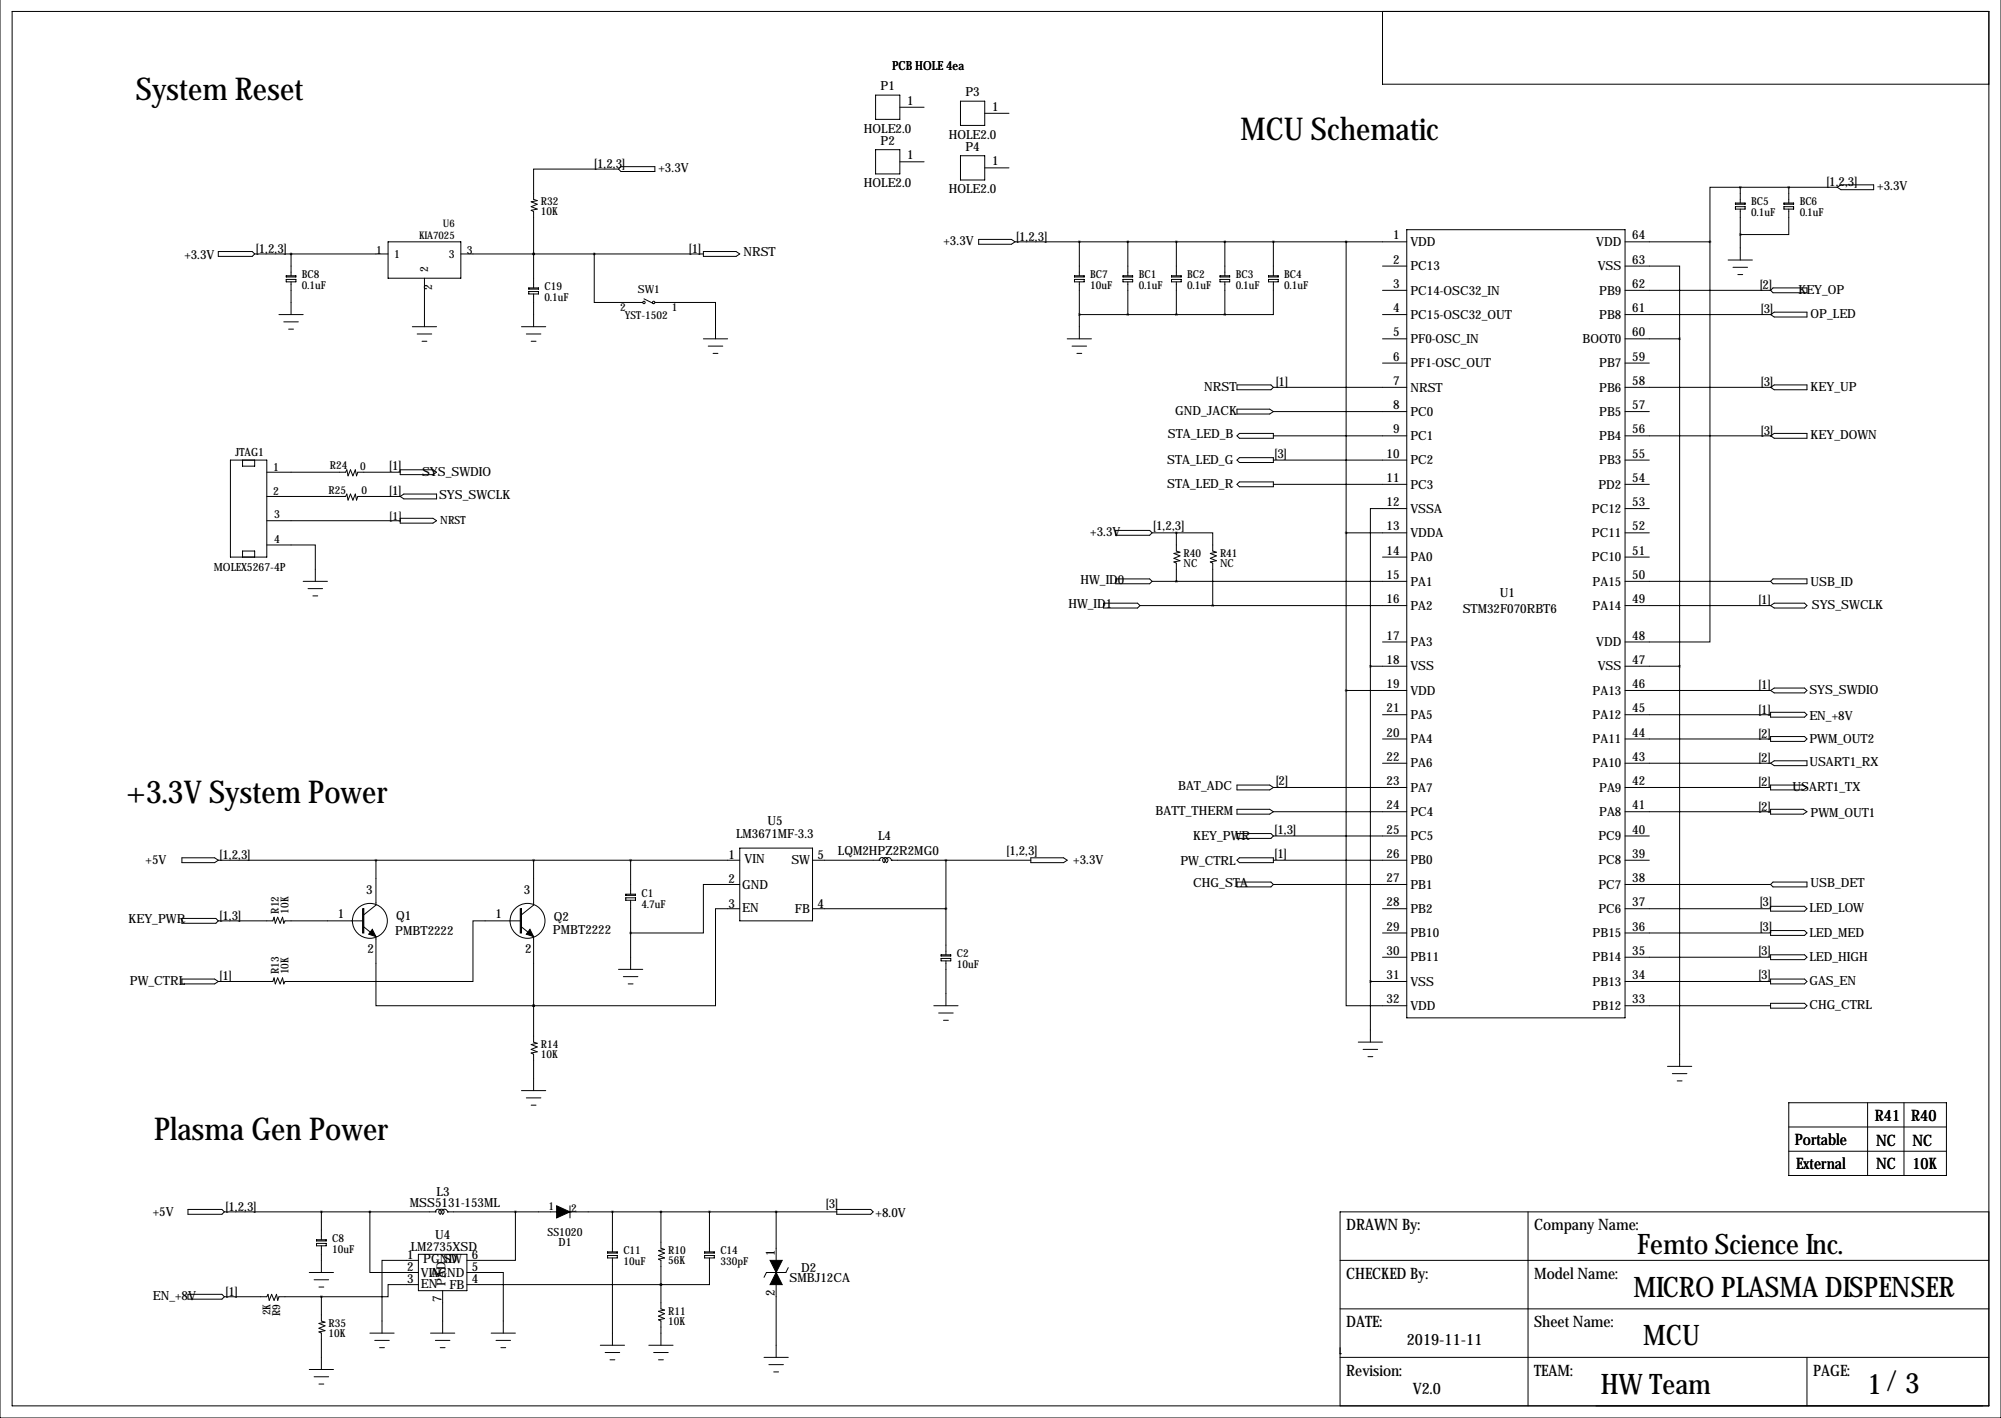
[picture p124: page 1]

Portable | NC NC | NC NC
External | NC NC | 10K

# RS-232 Interface

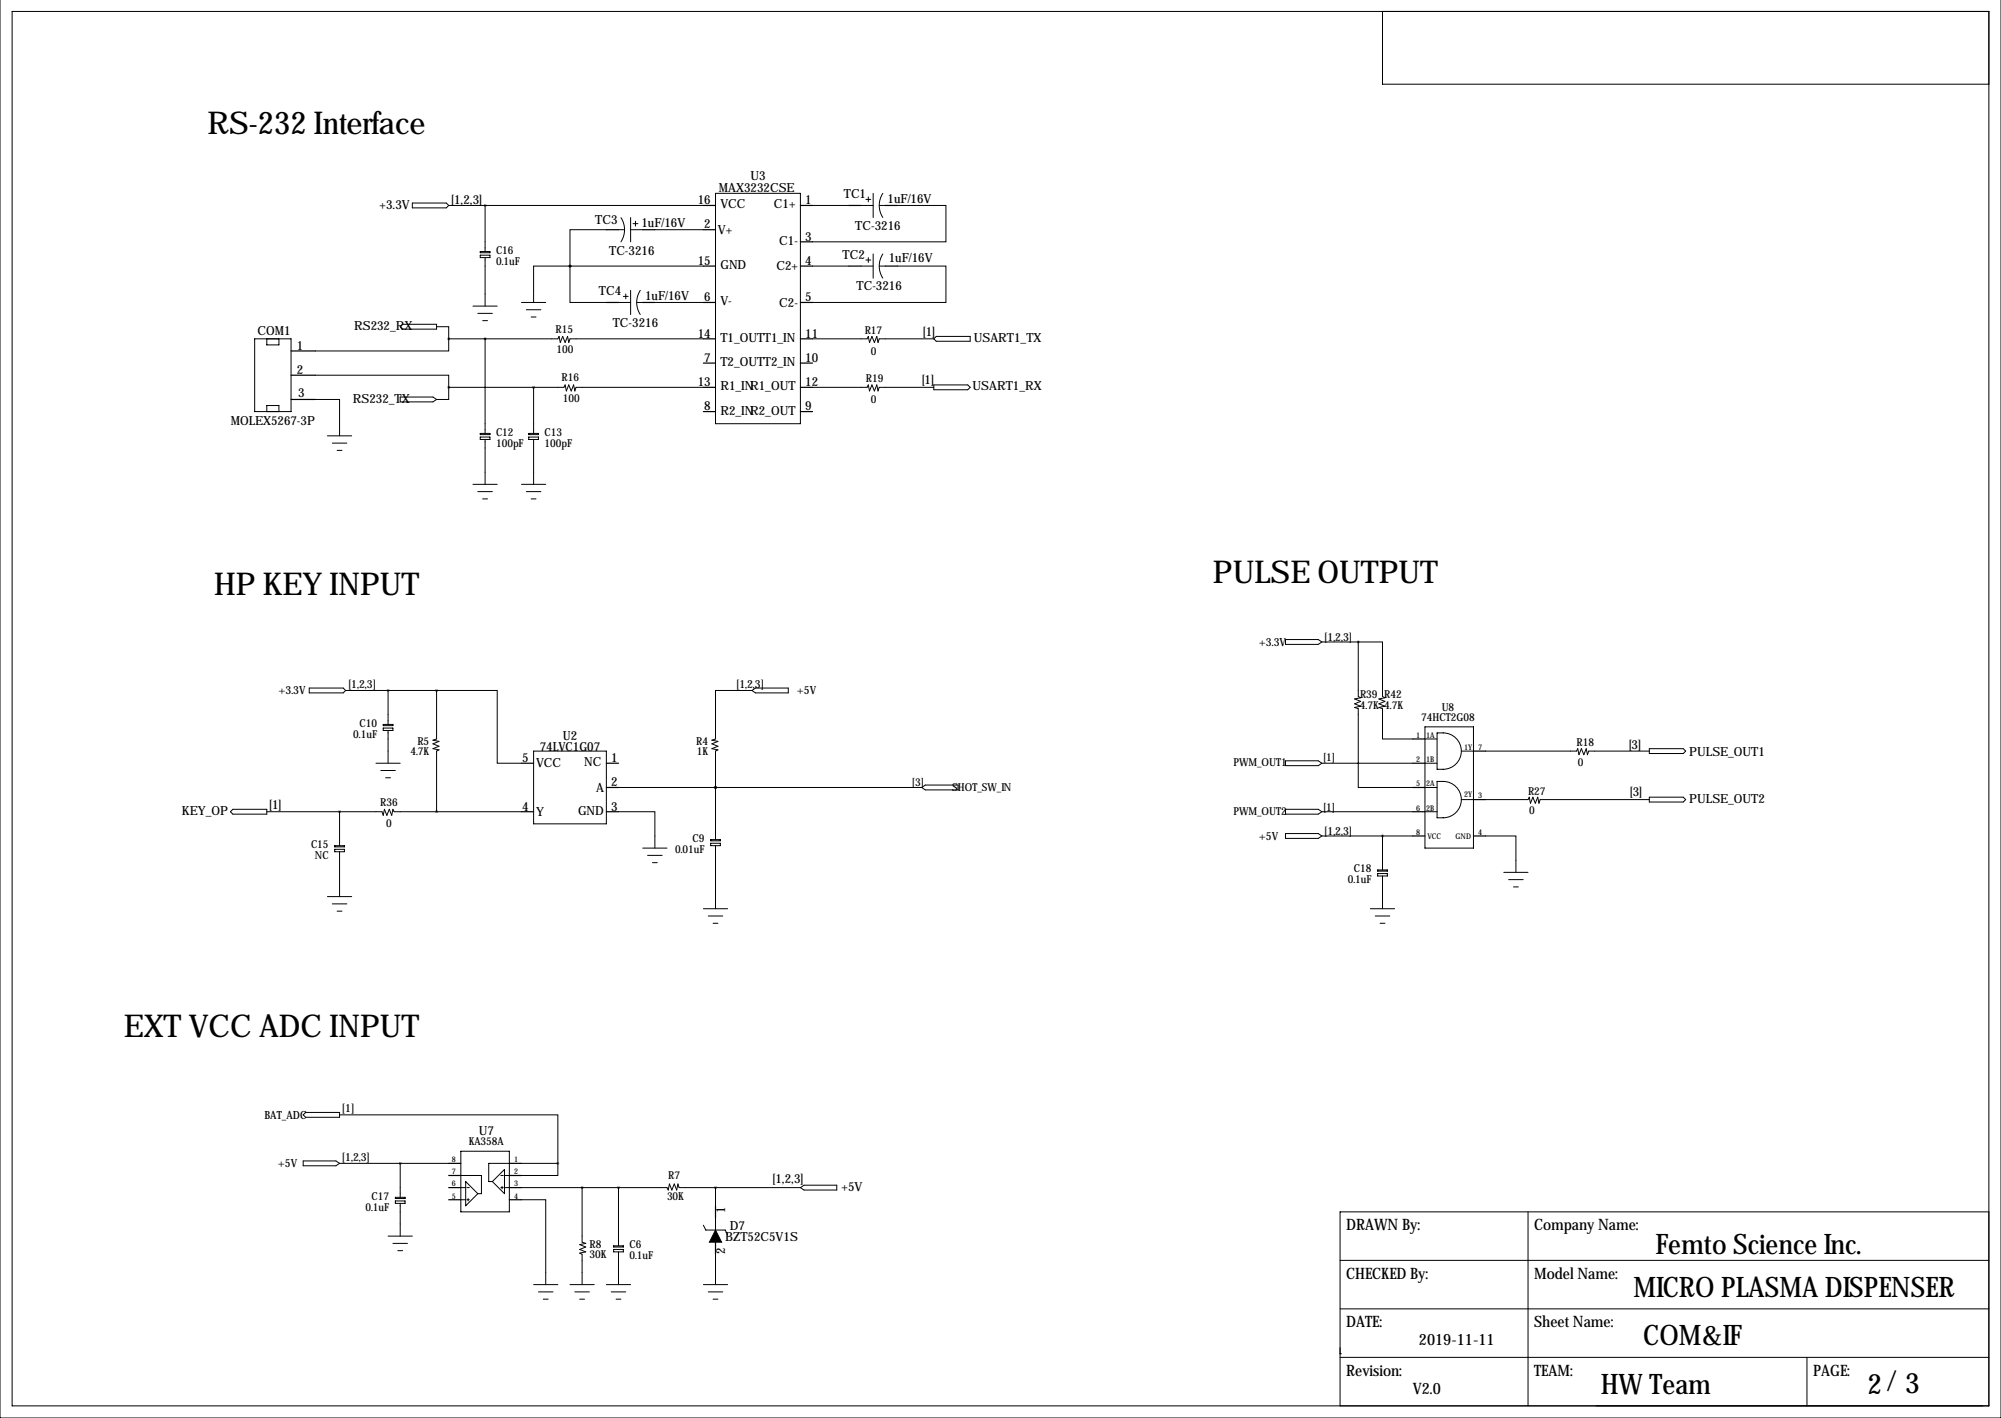
[picture p125: page 2]

EXT VCC ADC INPUT

+5V DC Adaptor | Transformer CON

# FOOT S/W CON

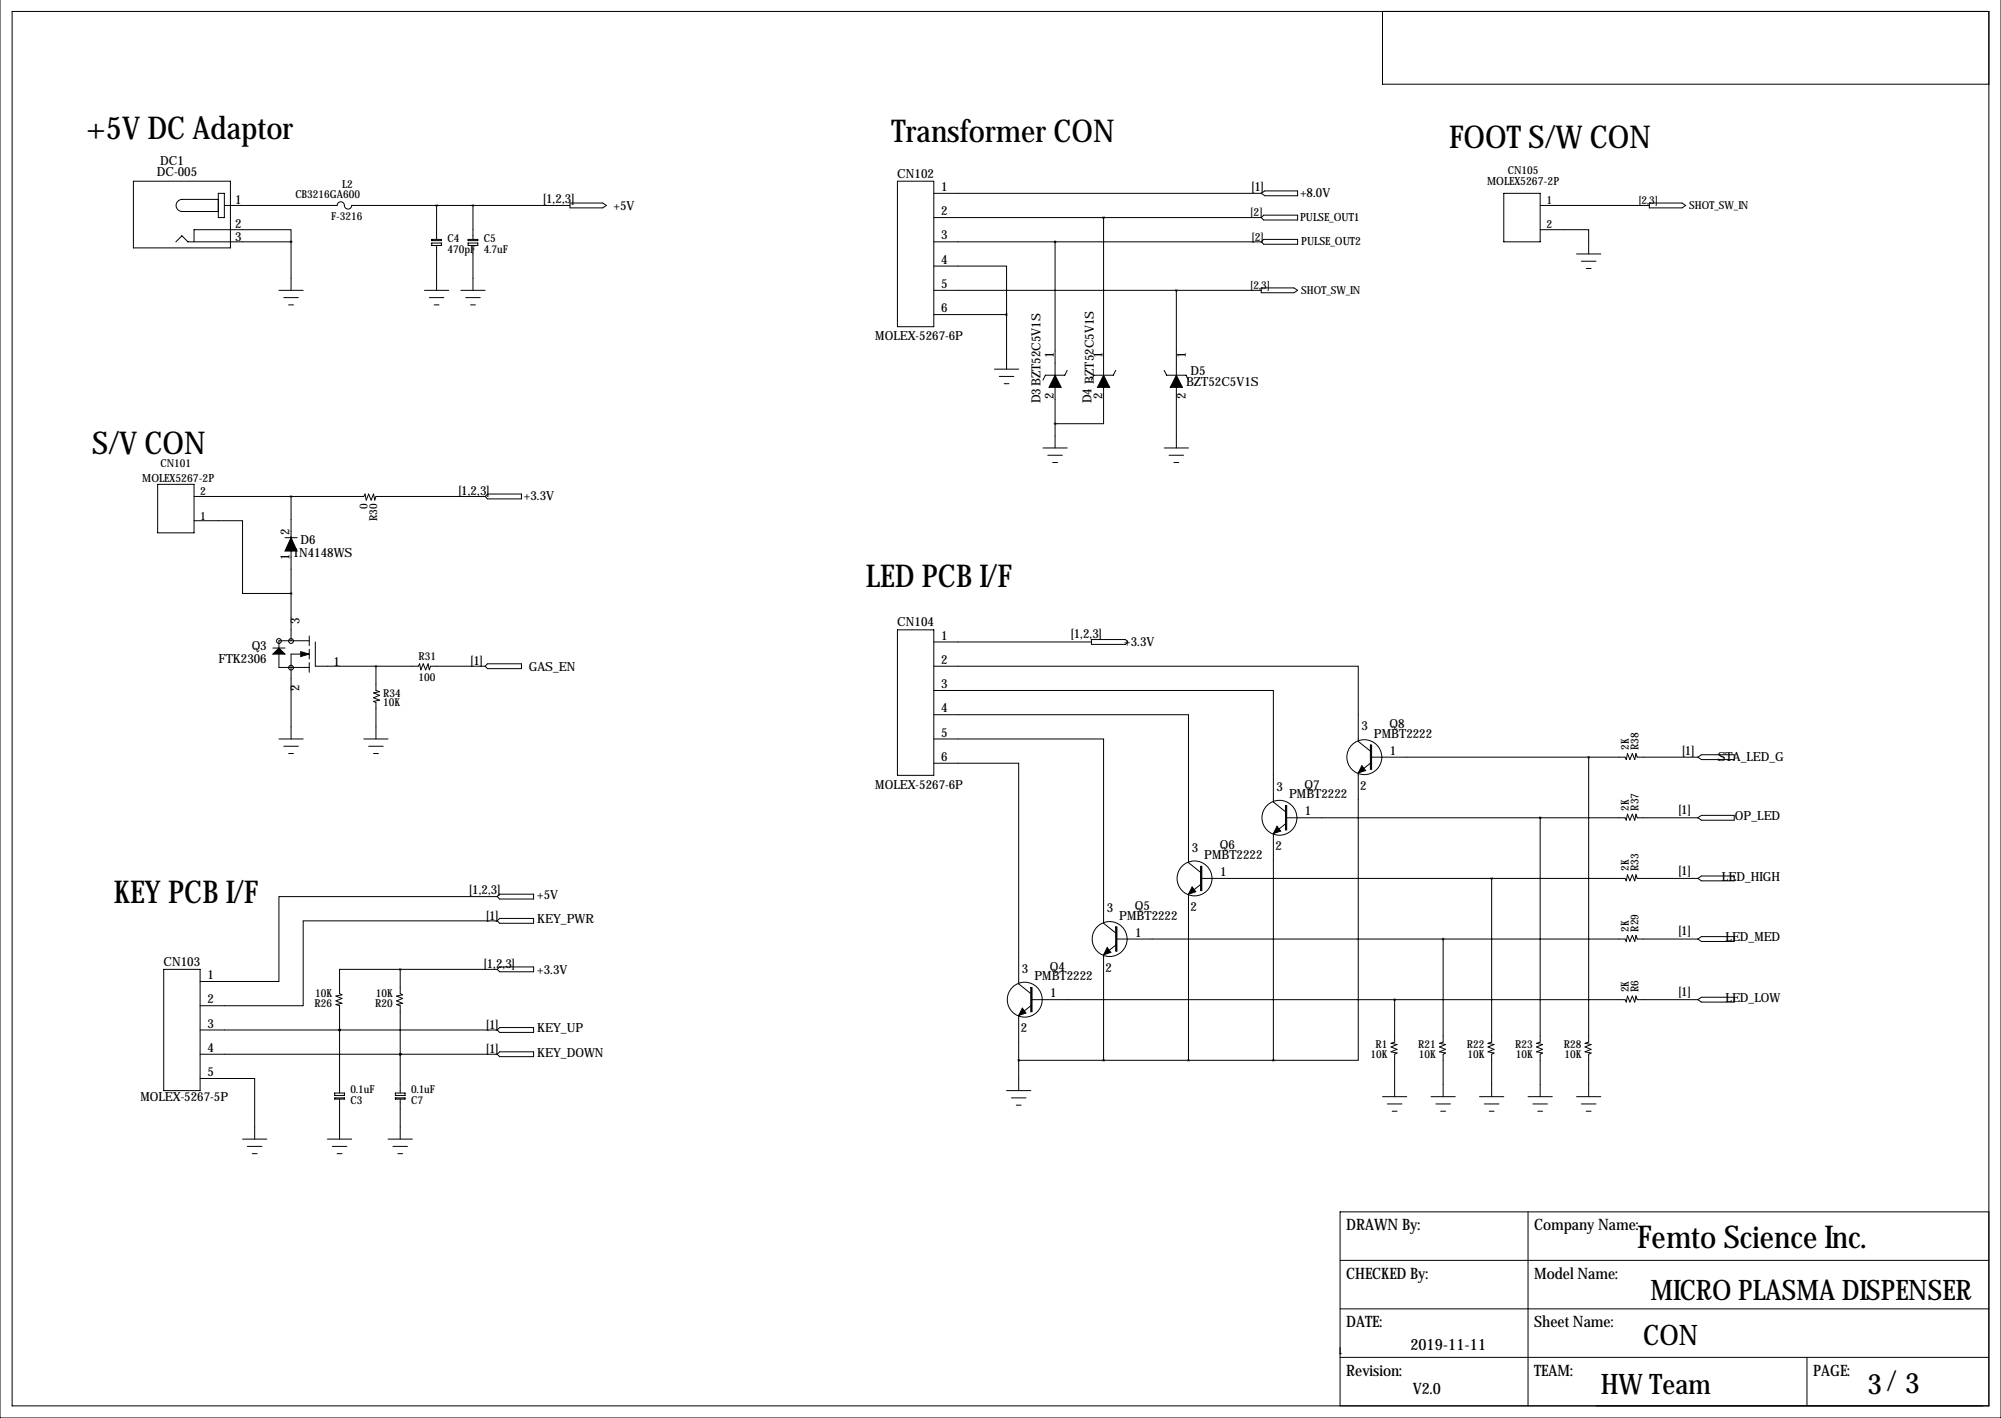
[picture p126: page 3]
