ArvidJoung/Plasma_Generator/0_MP2 Data/0_Data/20190316_Main_PCB/Plasma_Pipette_V3.0_Main_SCH_20190316.pdf

# MCU Schematic

# System Reset

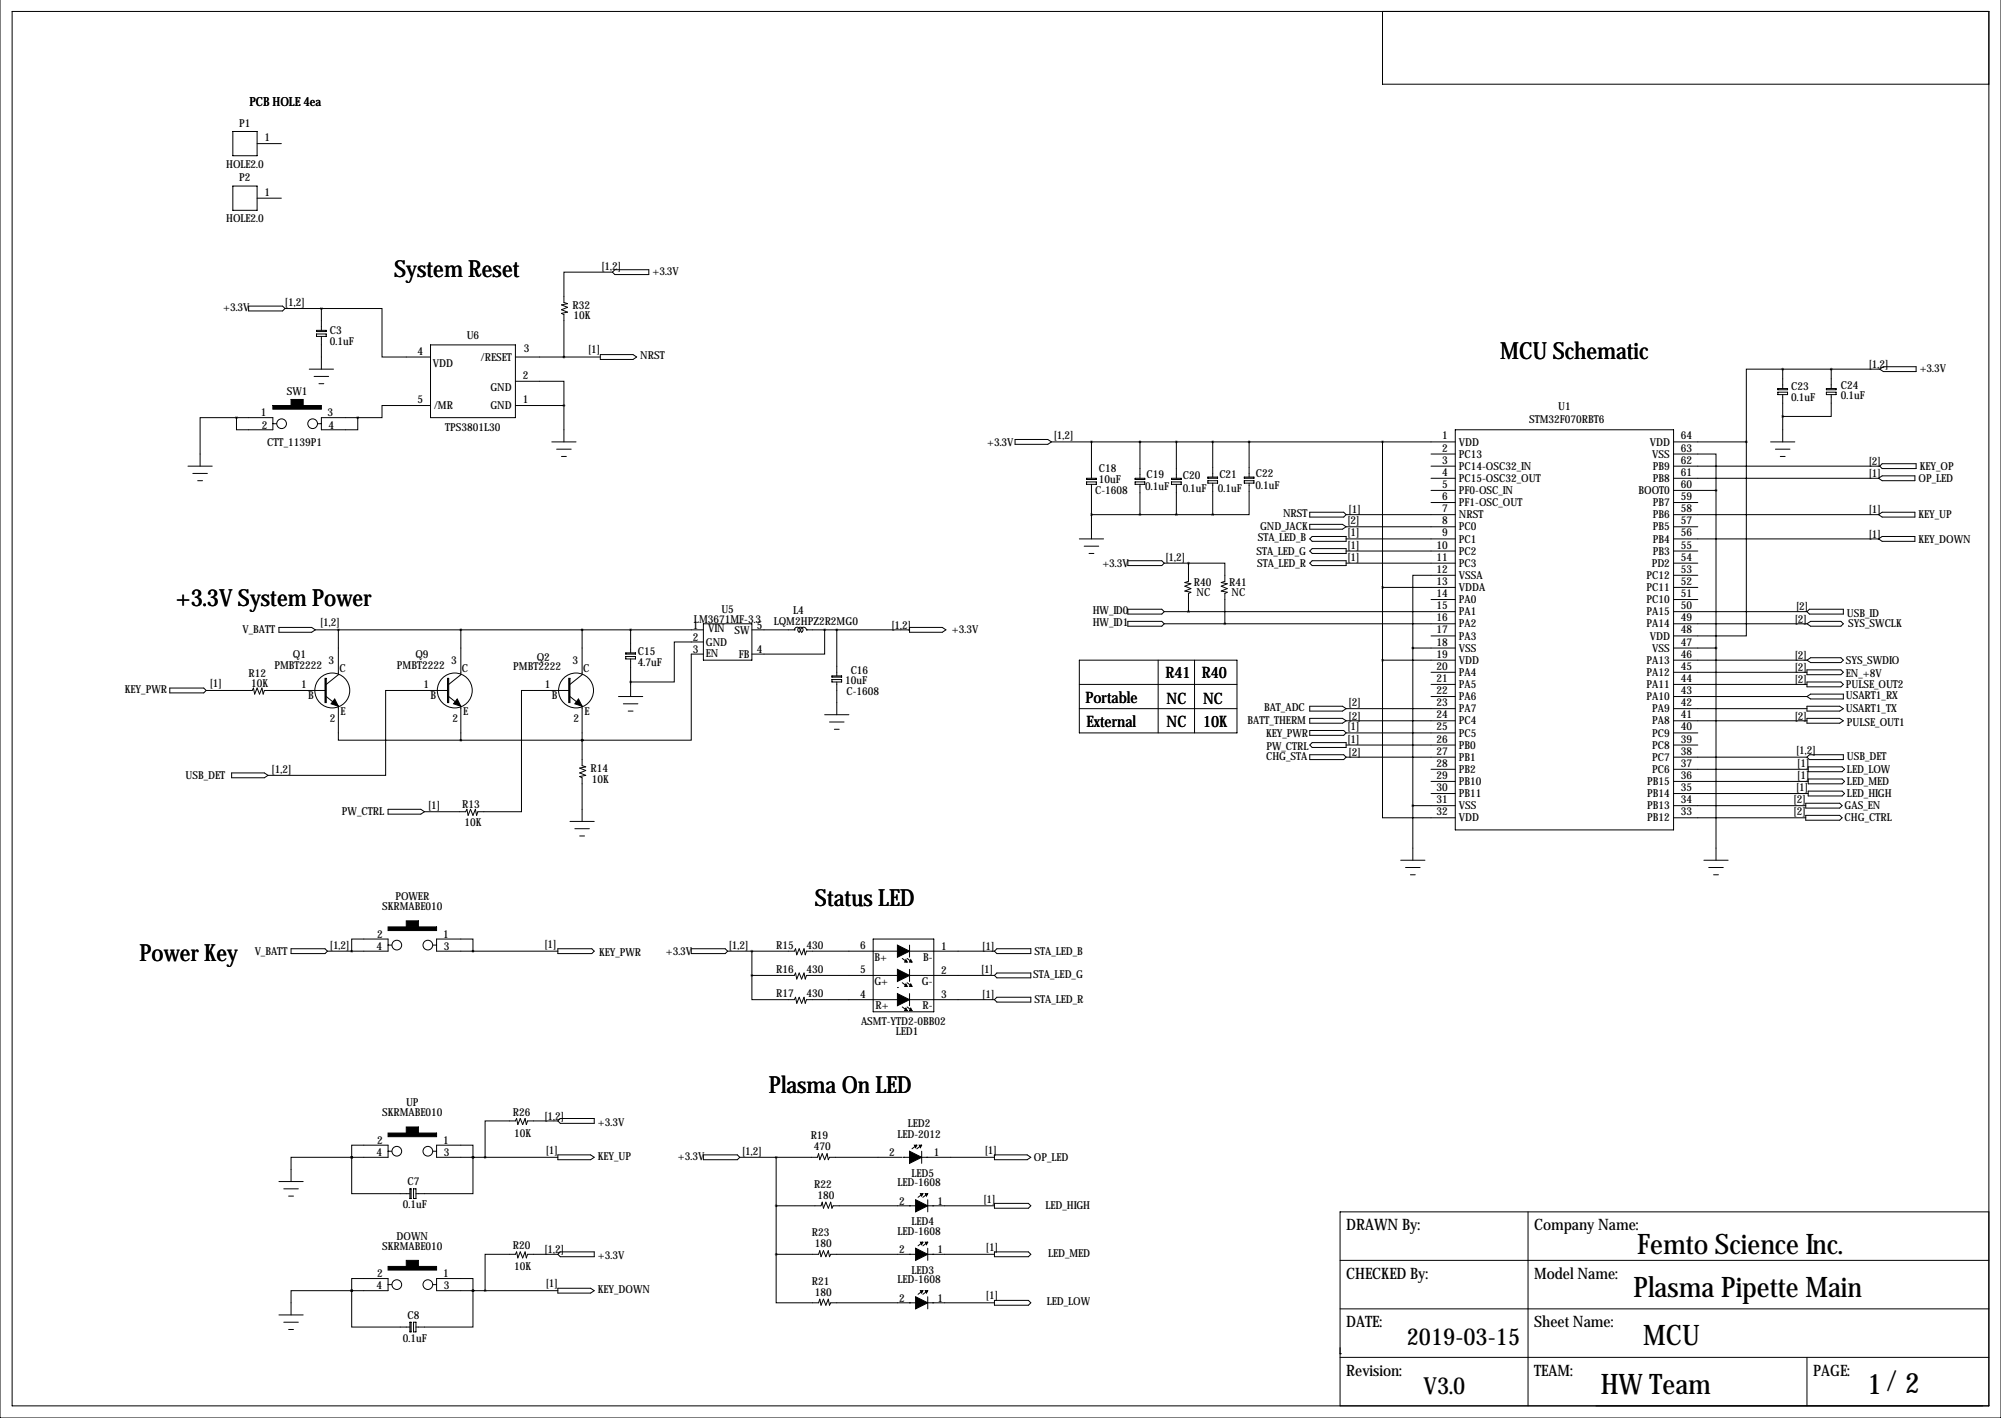
[picture p127: page 1]

Battery Connector | Transformer Connector

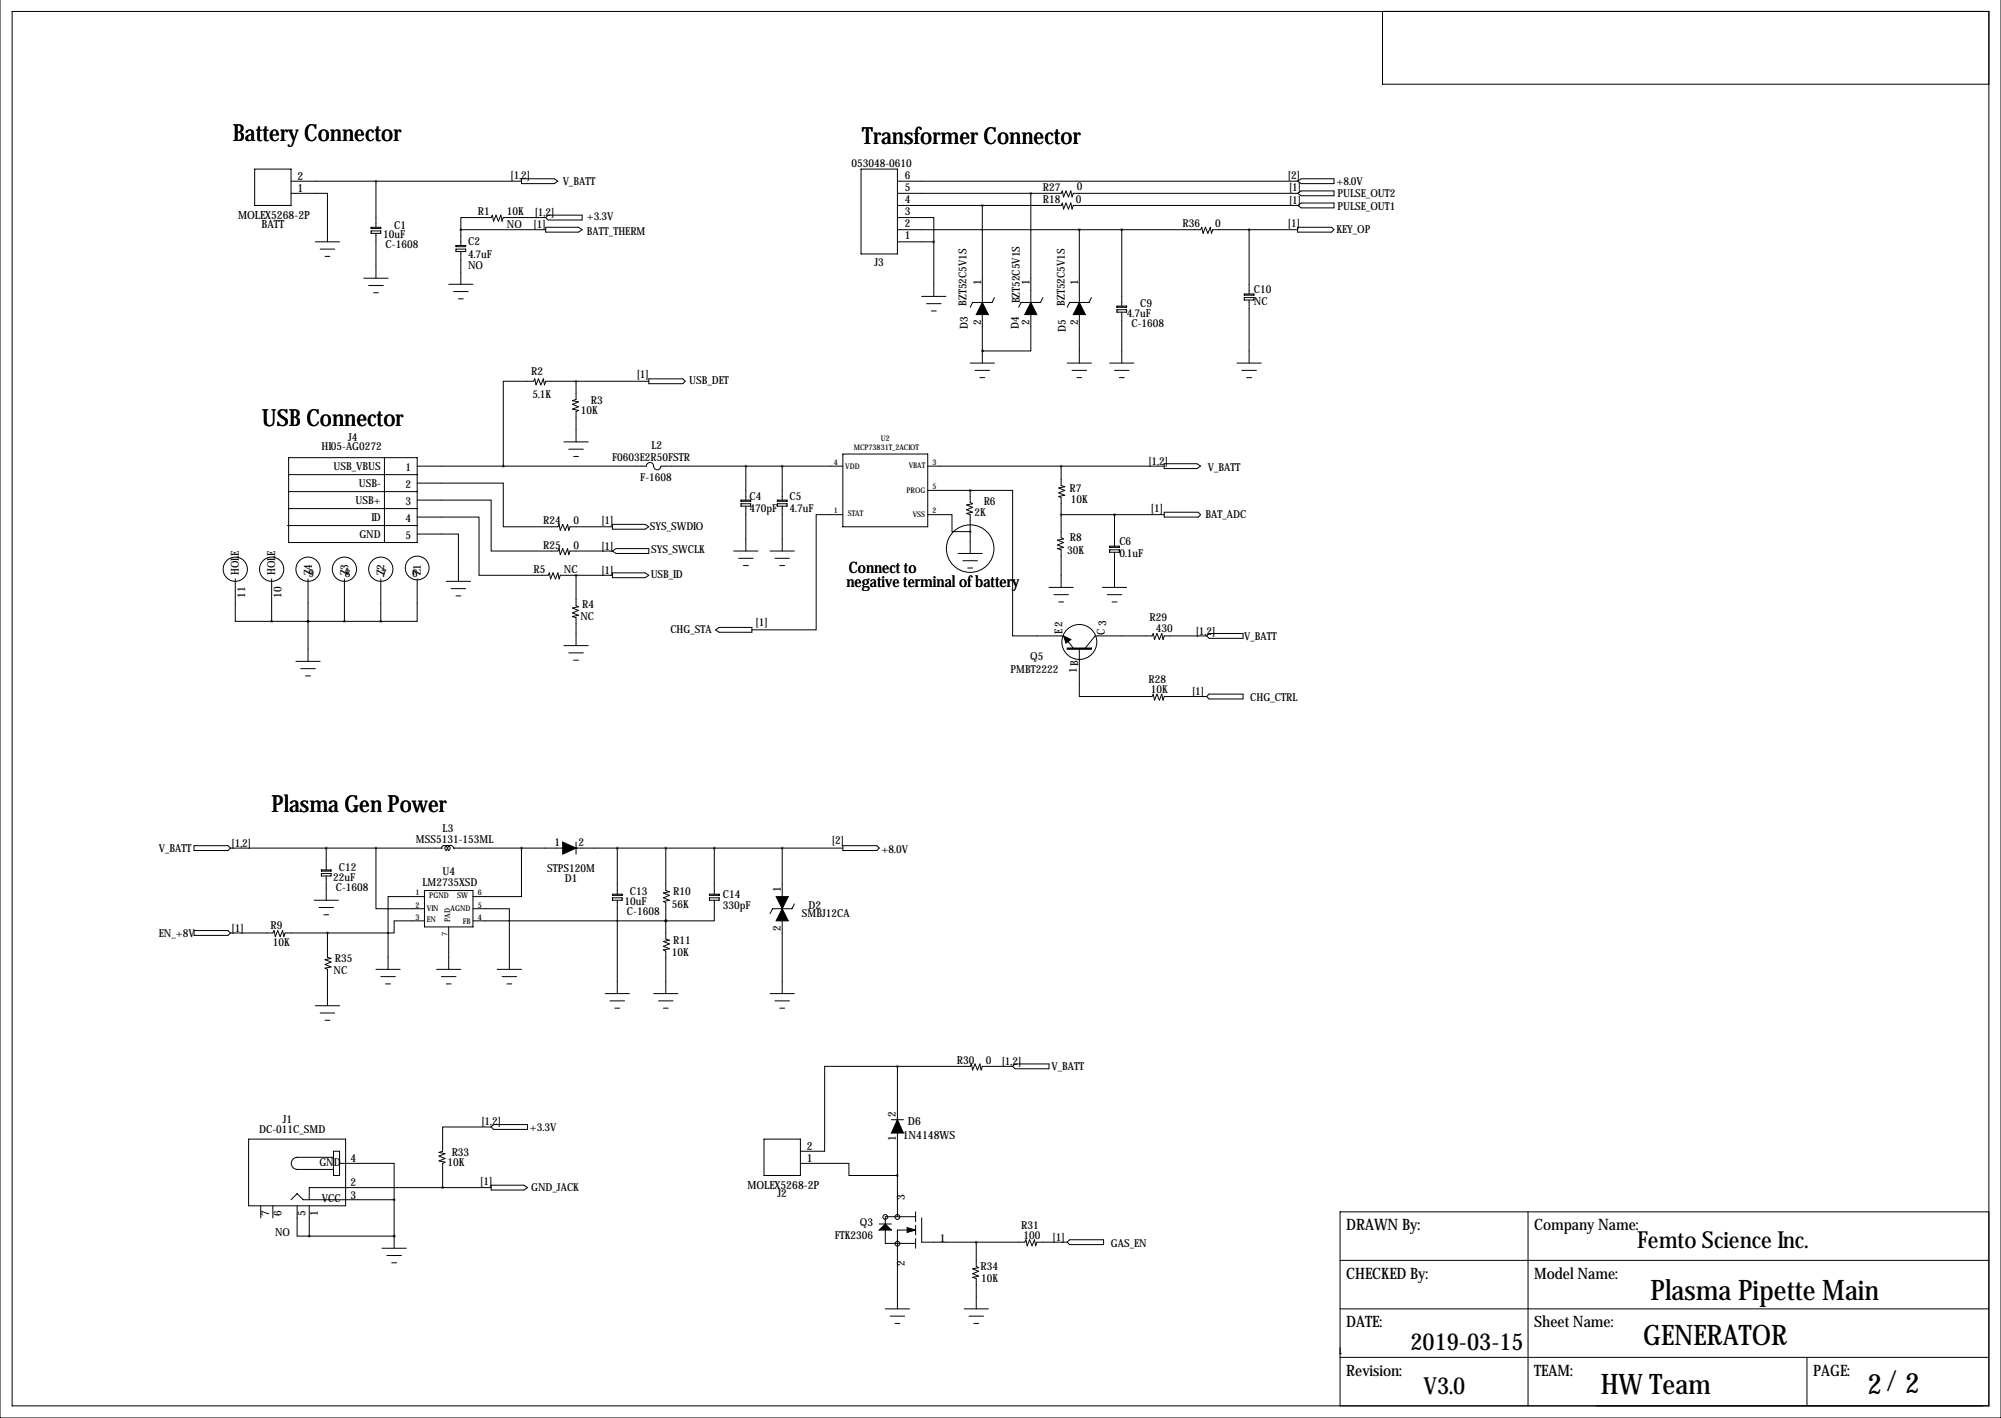
[picture p128: page 2]

USB- | 2
USB+ | 3
ID | 4
GND | 5

Connect to
negative terminal of battery
