ArvidJoung/Plasma_Generator/0_MP2 Data/0_Data/20190302_Trans_PCB/Plasma_Pipette_Transformer_SCH_V4.0_20190306.pdf

# FIVE FINGER

# Main PCB CON

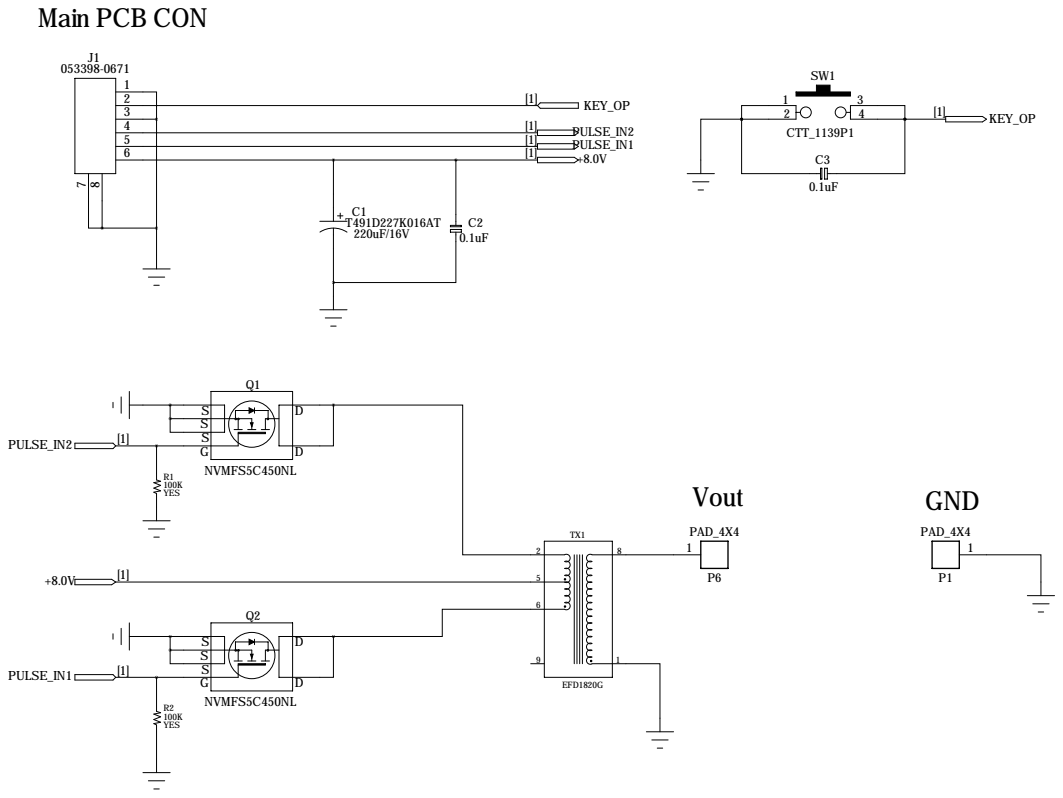
[picture p129: page 1]
