ArvidJoung/Plasma_Generator/0_MP2 Data/0_Data/20190302_Main_PCB/Plasma_Pipette_V3.0_Main_SCH_20190302_V9.5.pdf

# MCU Schematic

# System Reset

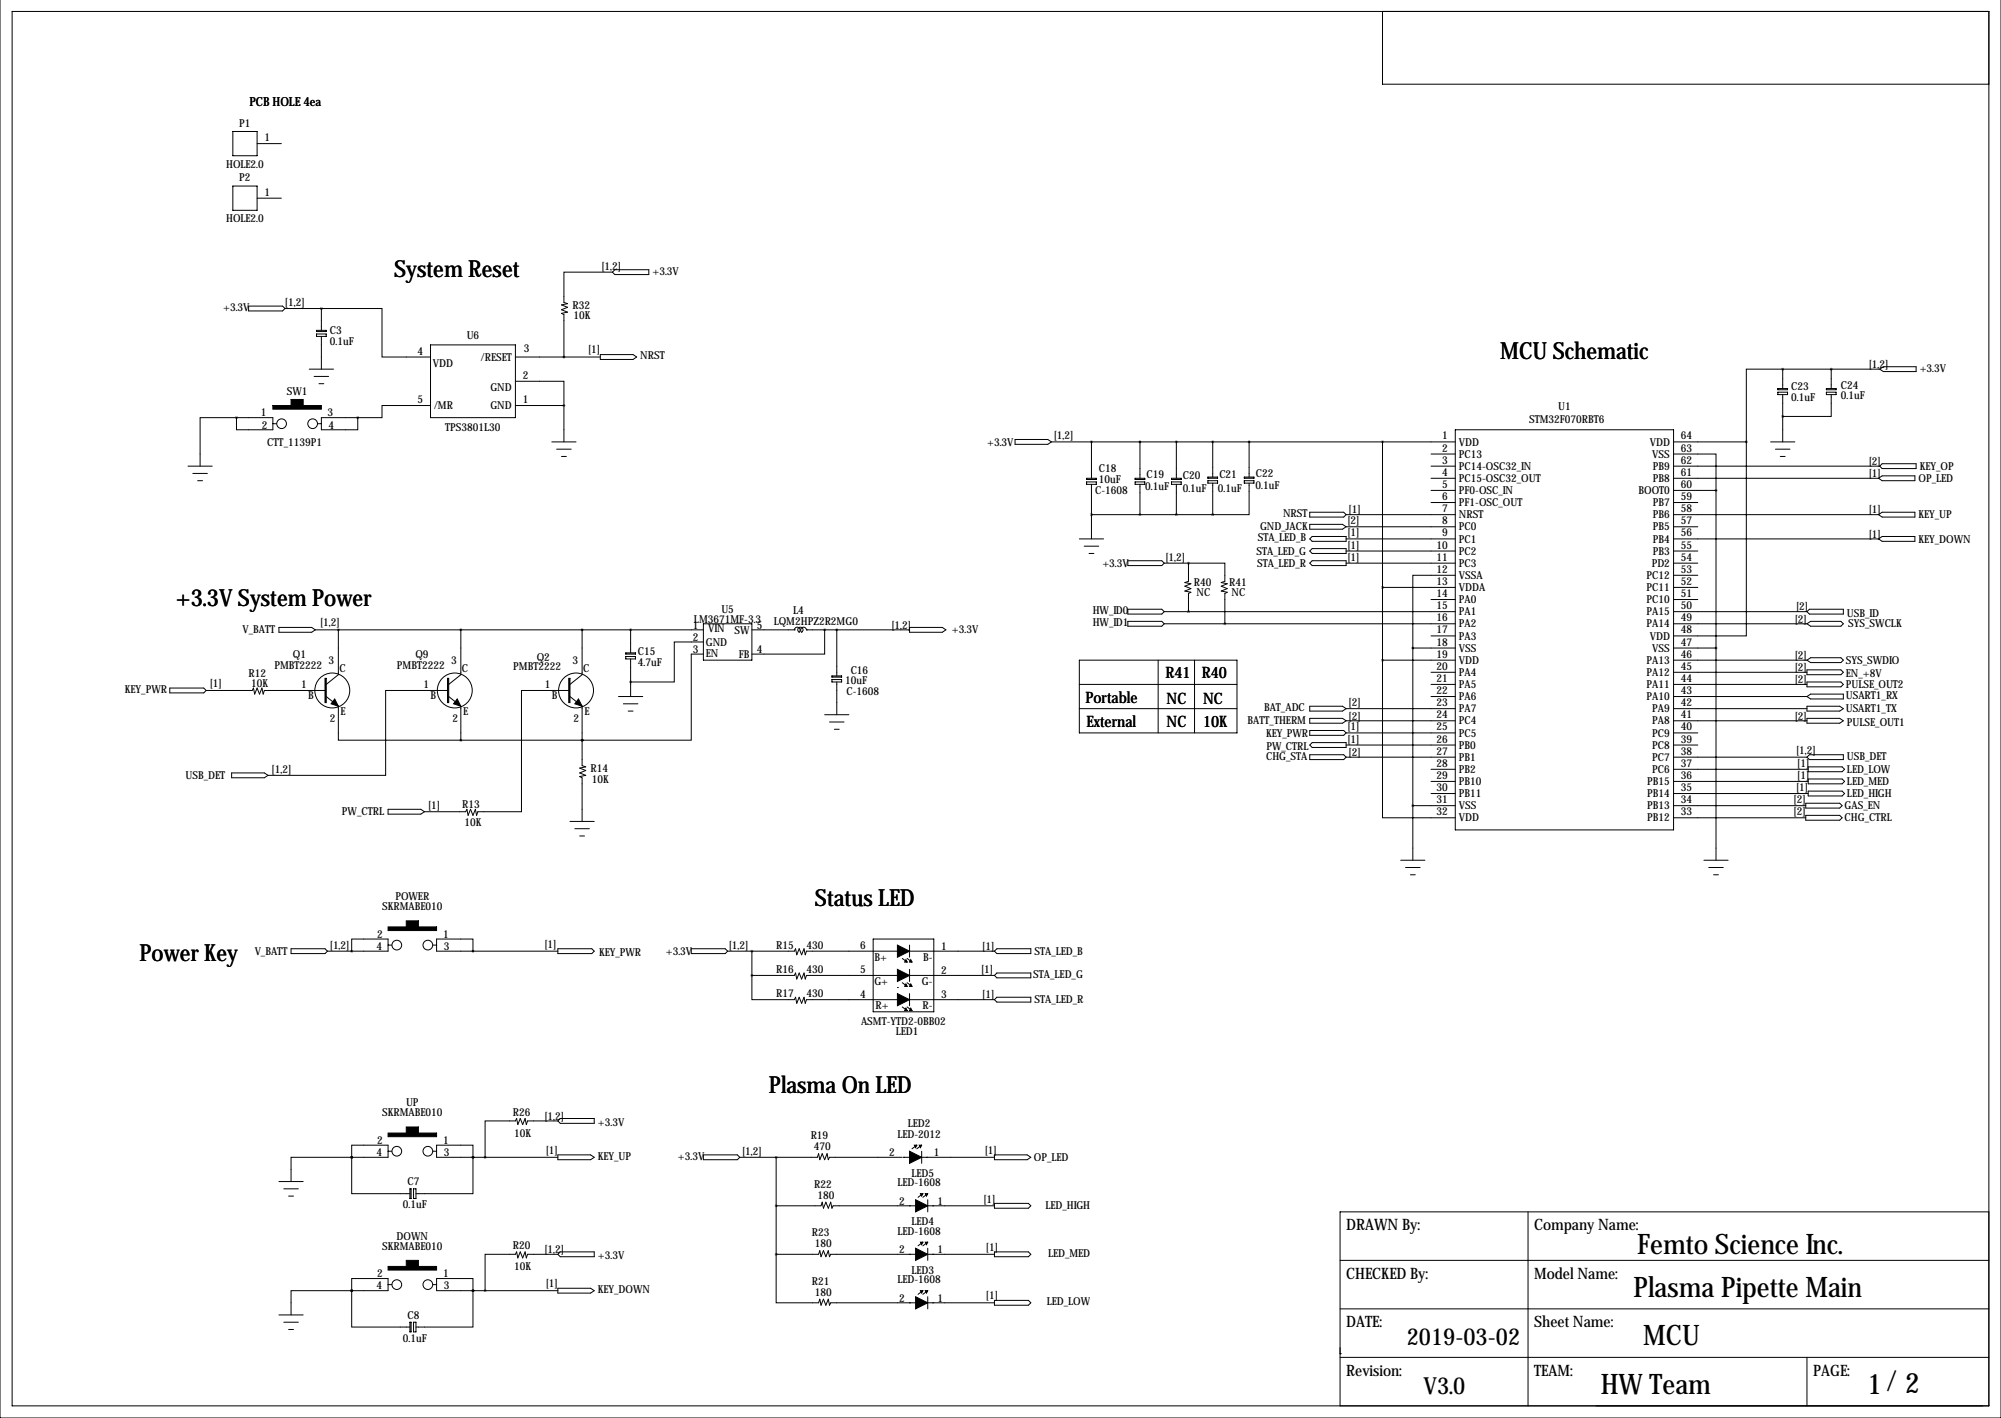
[picture p130: page 1]

Battery Connector | Transformer Connector

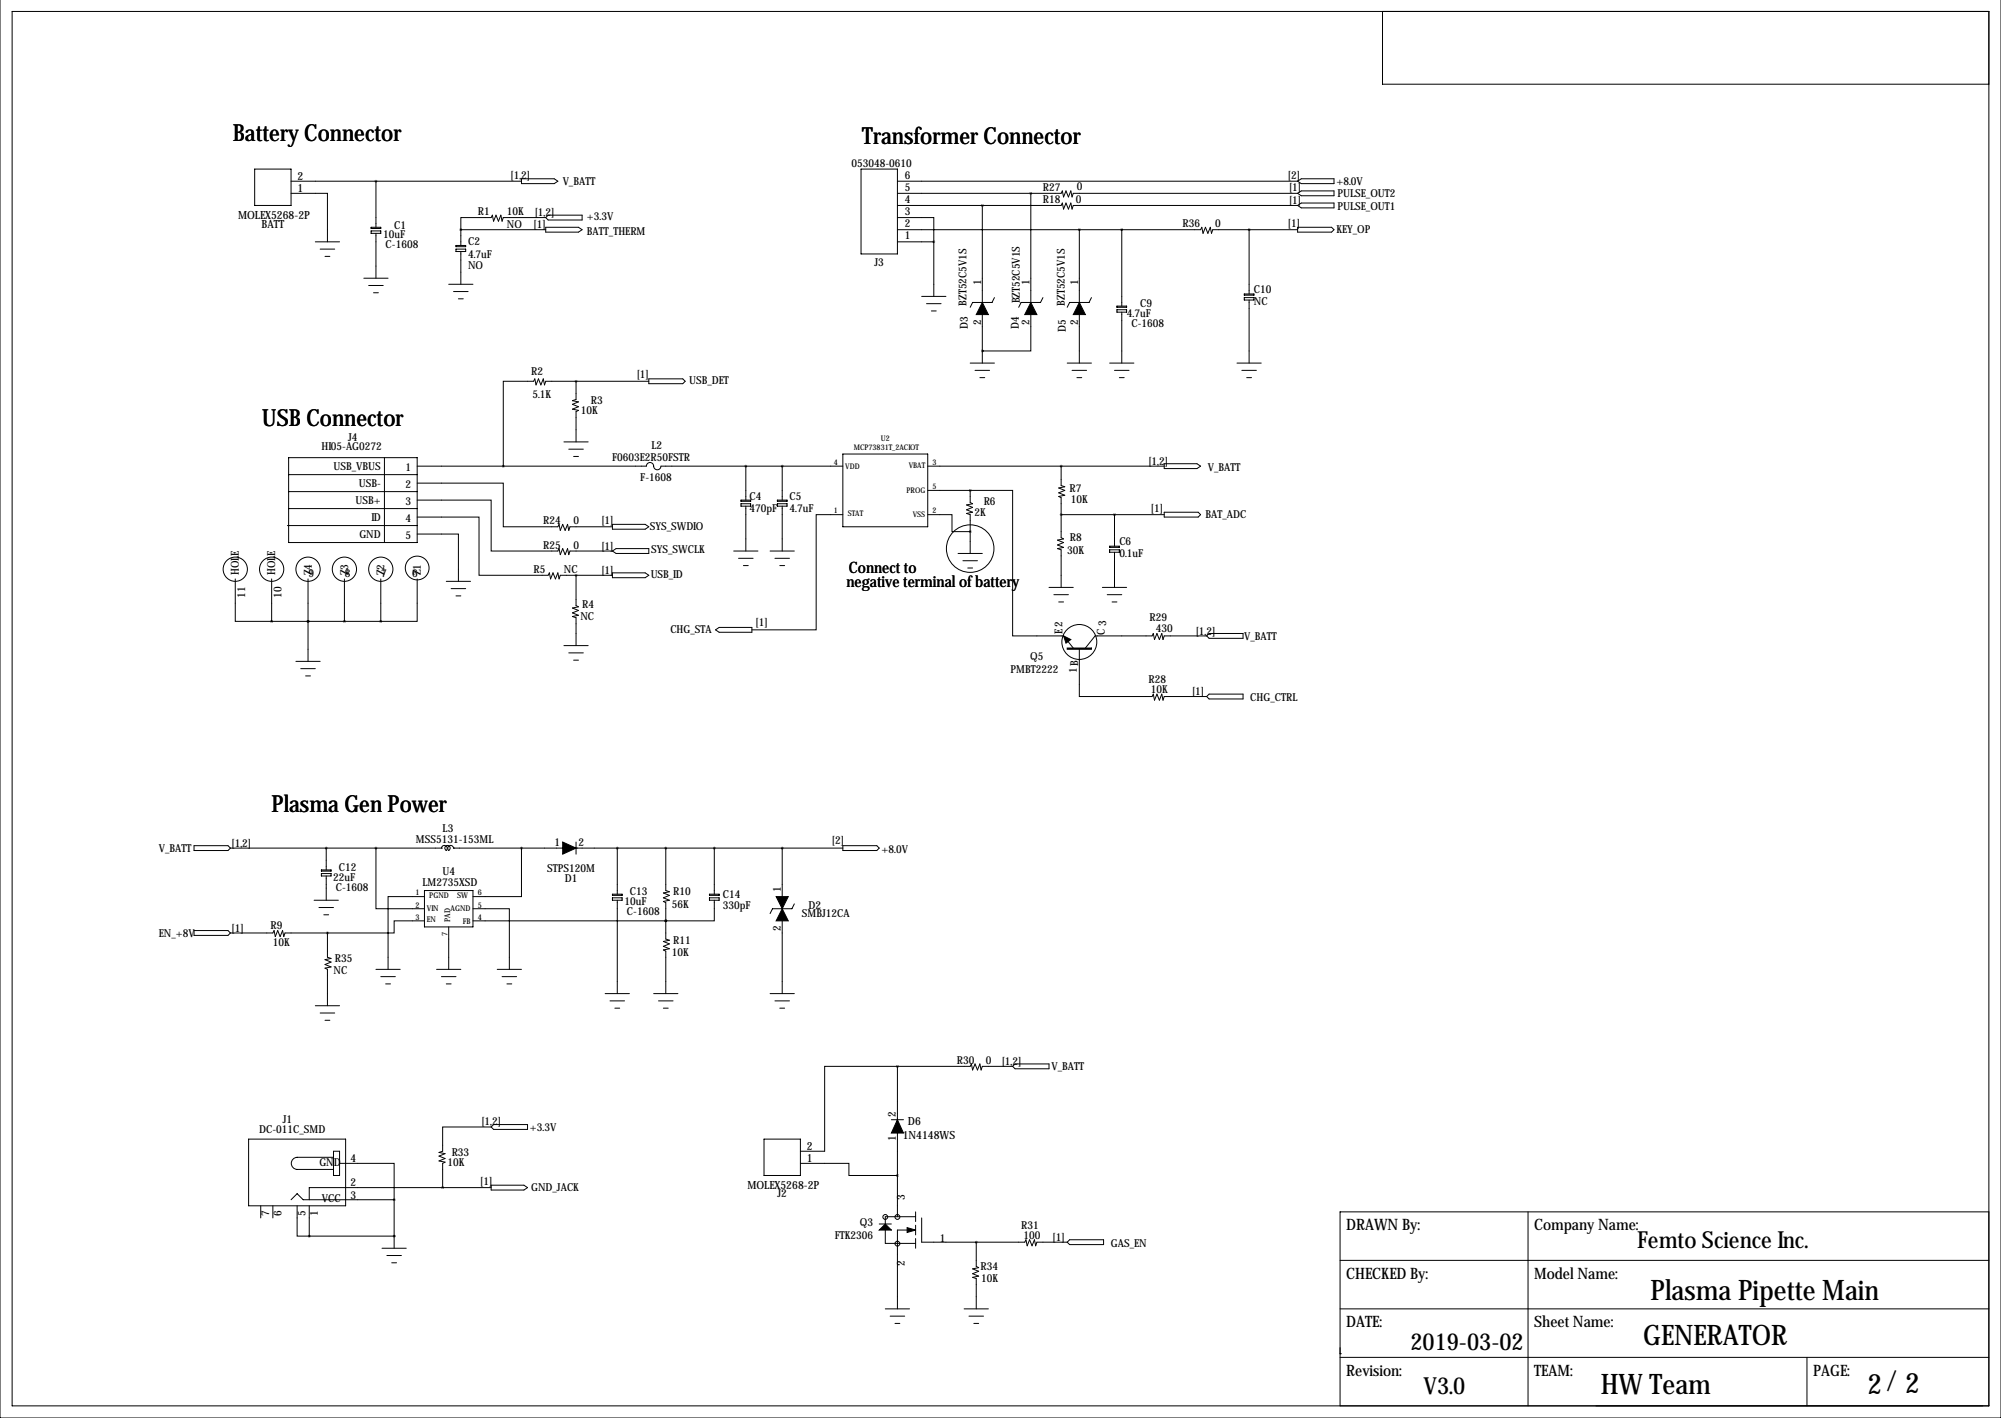
[picture p131: page 2]

USB- | 2
USB+ | 3
ID | 4
GND | 5

Connect to
negative terminal of battery
