ArvidJoung/Plasma_Generator/0_MP1 Data/1_Sch & PCB/Main/Plasma_Pipette_V2.0_Main_SCH_20181104_VX2.3.pdf

# MCU Schematic

# System Reset

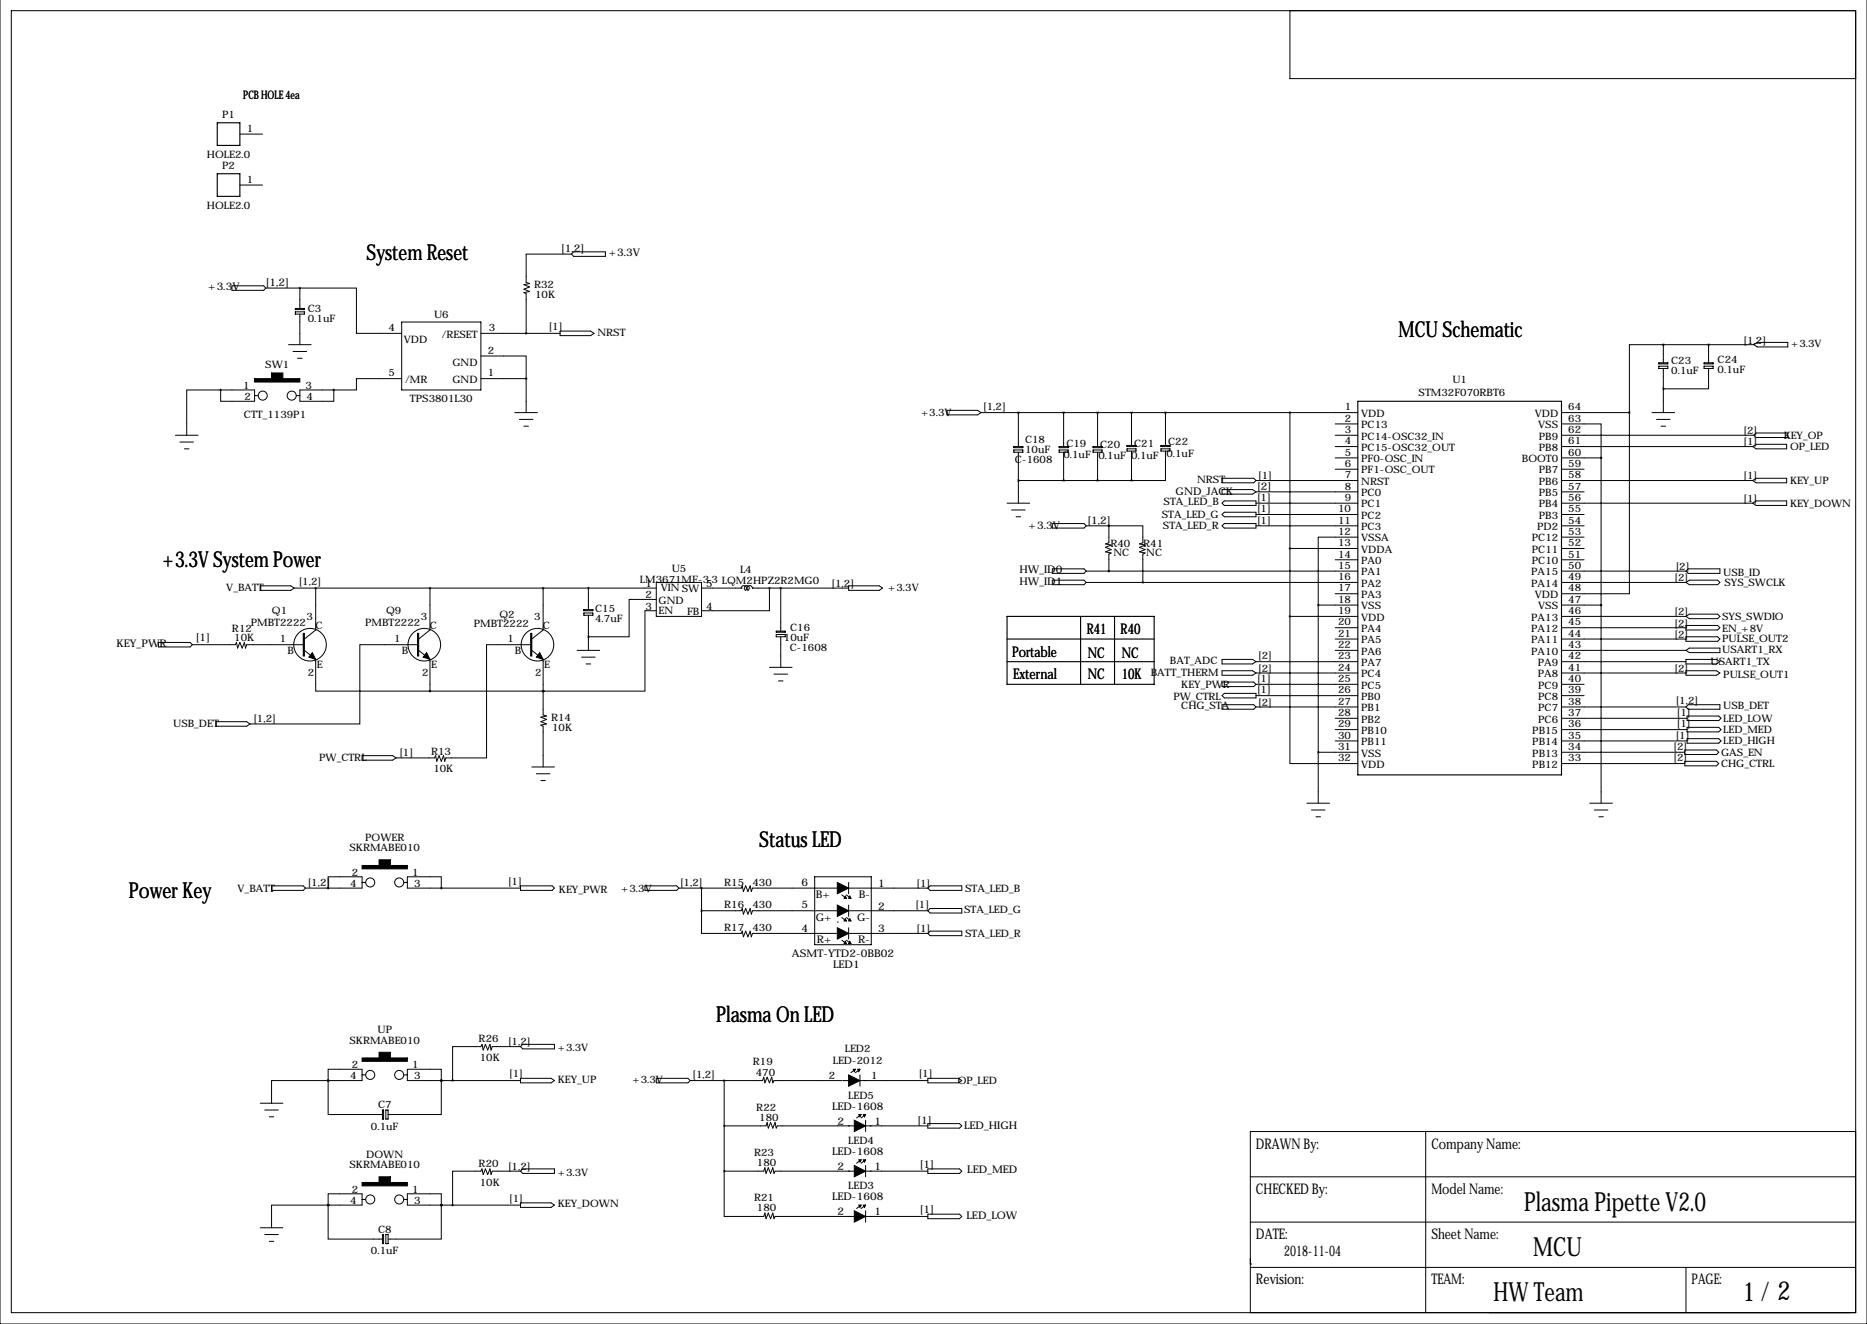
[picture p132: page 1]

Battery Connector | Transformer Connector

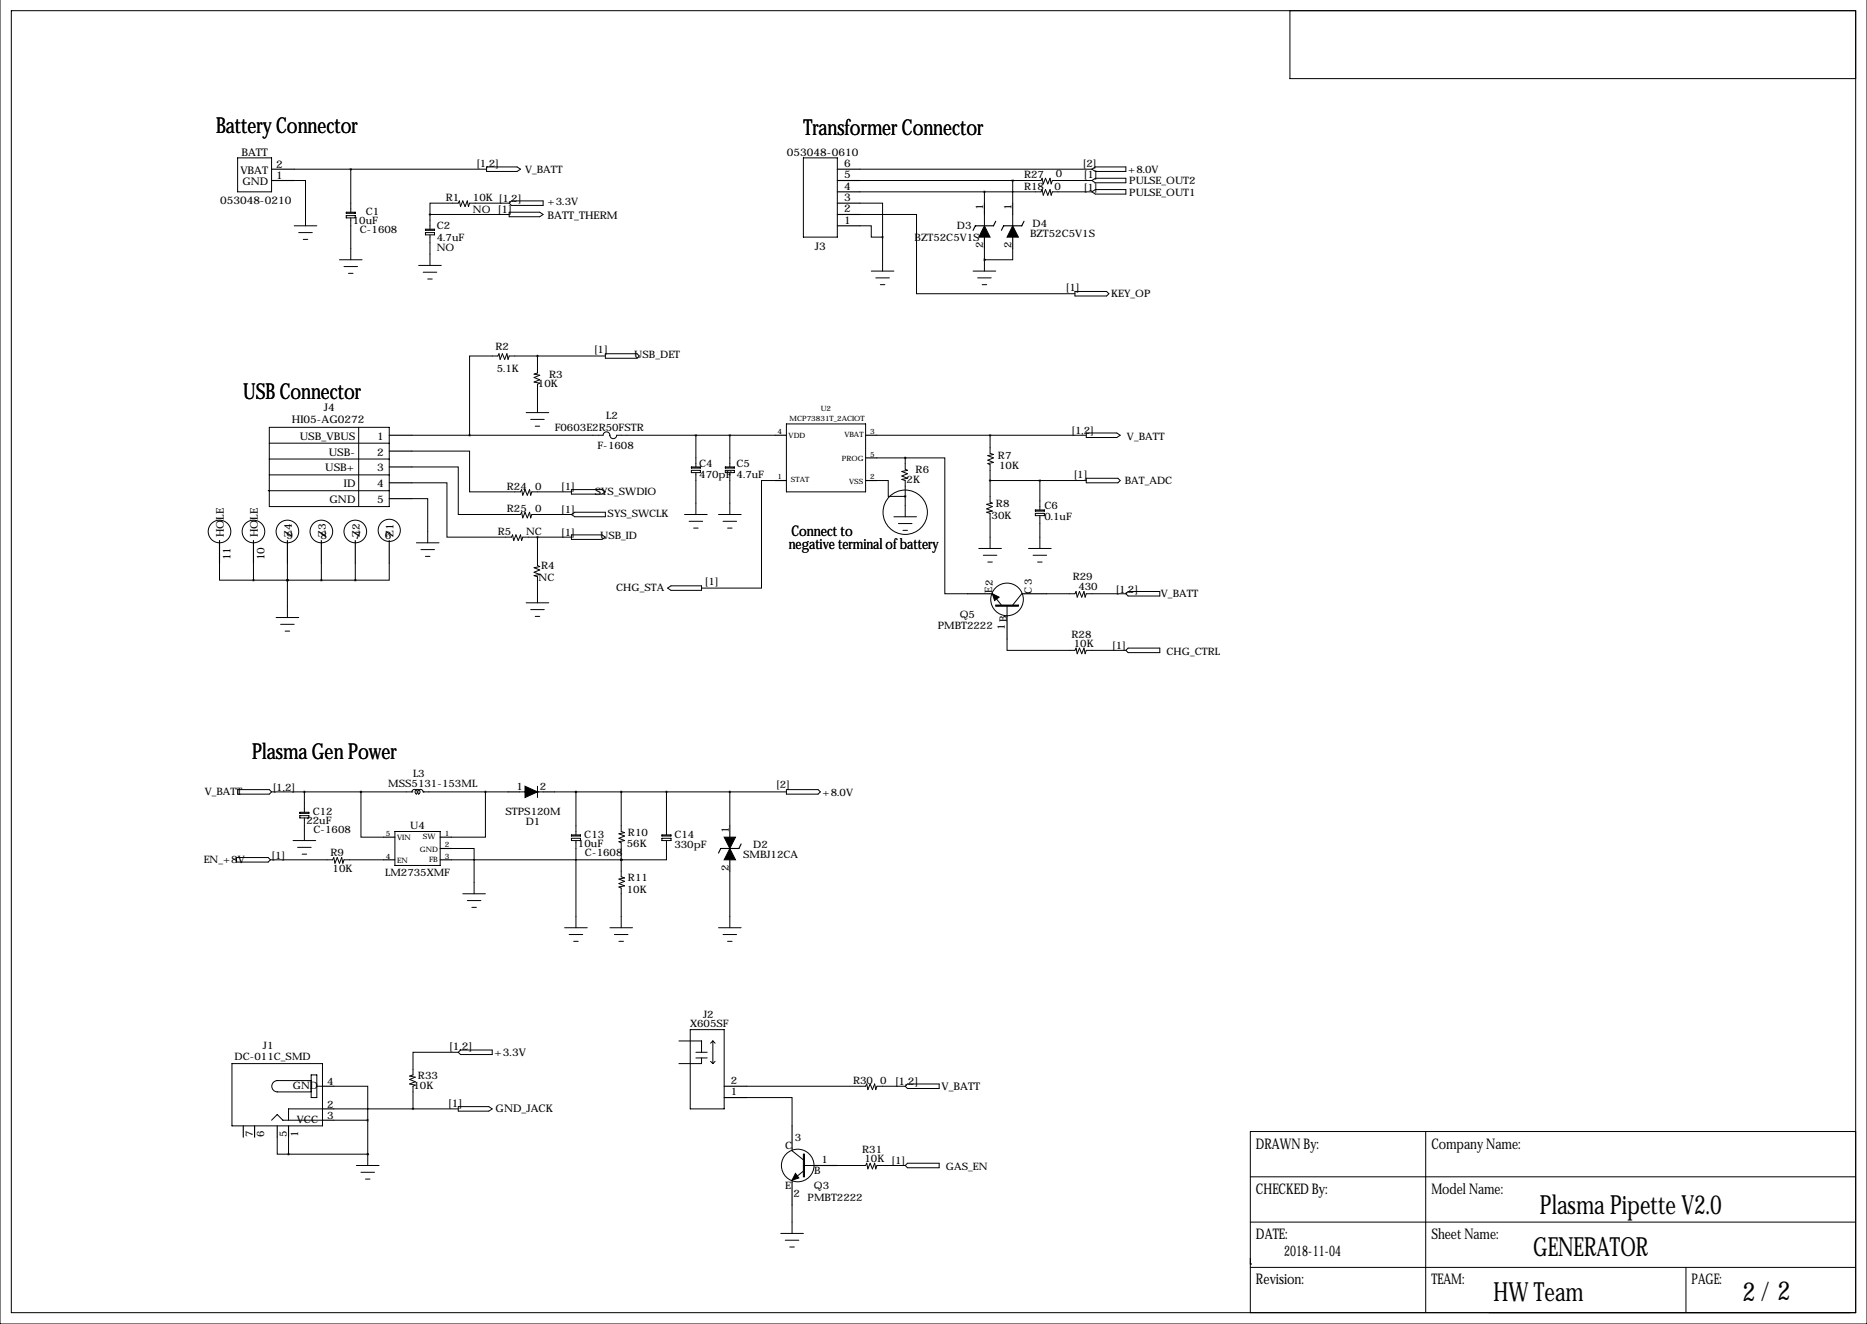
[picture p133: page 2]

USB- | 2
USB+ | 3
ID | 4
GND | 5

Connect to
negative terminal of battery
