ArvidJoung/Plasma_Generator/0_MP1 Data/1_Sch & PCB/Transformer/Plasma_Pipette_Transformer_SCH_V3.0_20180805.pdf

# FIVE FINGER

# Main PCB CON

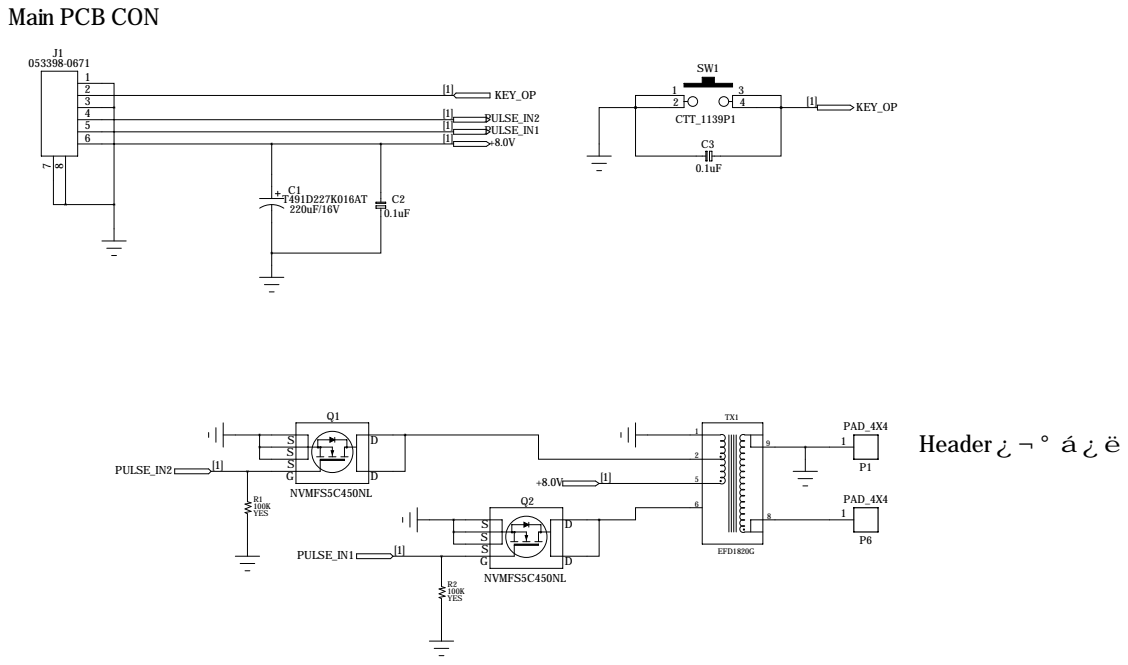
[picture p134: page 1]
