ArvidJoung/Plasma_Generator/1_Plasma_Pipette/4_Review data/ME Data/20180430/Plasma_Gen_Block Diagram_20180430.pdf

# 부품 형상

S/V block | GND Jack | Plasma Key | Battery Pack

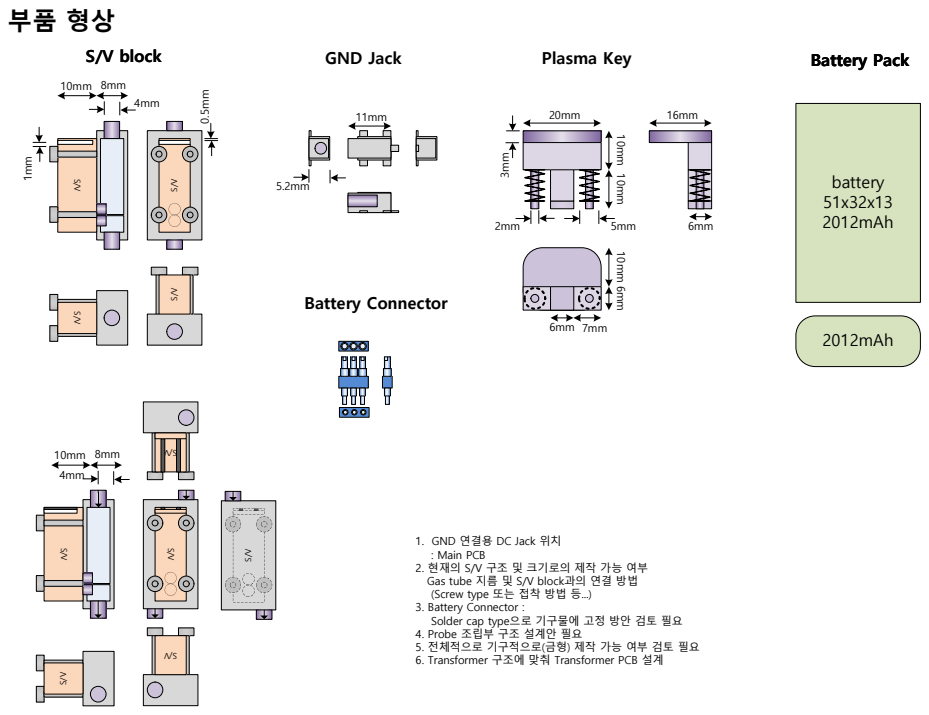
[picture p135: page 1]
battery 51x32x13 2012mAh; 2012mAh; Battery Connector

1. GND 연결용 DC Jack 위치
: Main PCB
2. 현재의 S/V 구조 및 크기로의 제작 가능 여부
Gas tube 지름 및 S/V block과의 연결 방법
(Screw type 또는 접착 방법 등...)
3. Battery Connector : Solder cap type으로 기구물에 고정 방안 검토 필요

4. Probe 조립부 구조 설계안 필요
5. 전체적으로 기구적으로(금형) 제작 가능 여부 검토 필요
6. Transformer 구조에 맞춰 Transformer PCB 설계

전원

## Femto Science

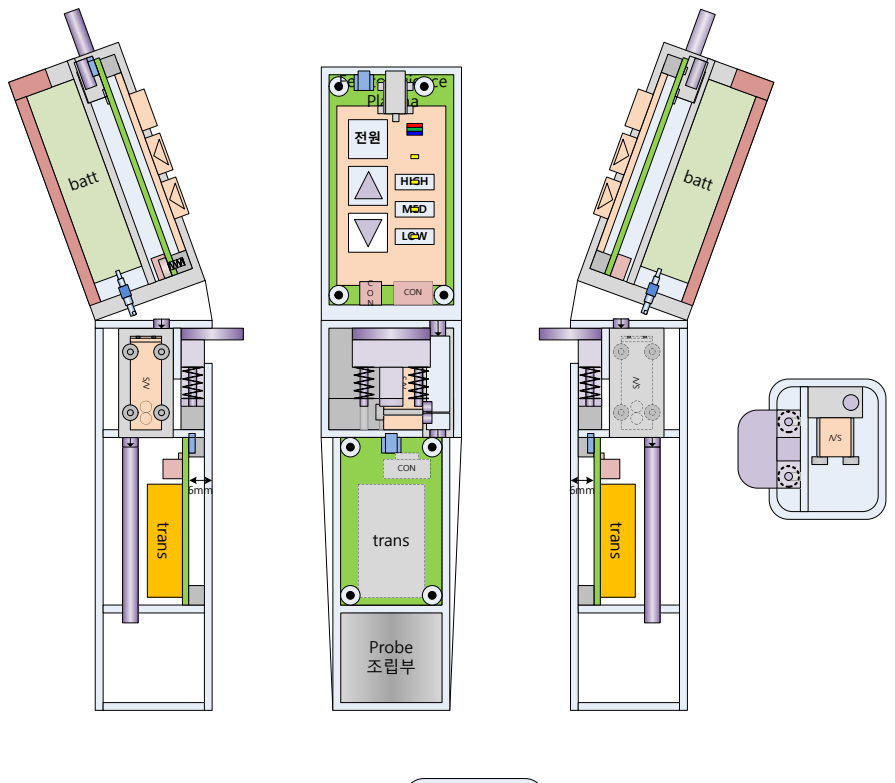
[picture p136: page 2]
S/V Probe; 조립부; PCB trans; CON; S/V tra; tra; batt; PCB; LOW; MED; HIGH; Plasma

32mm

36mm

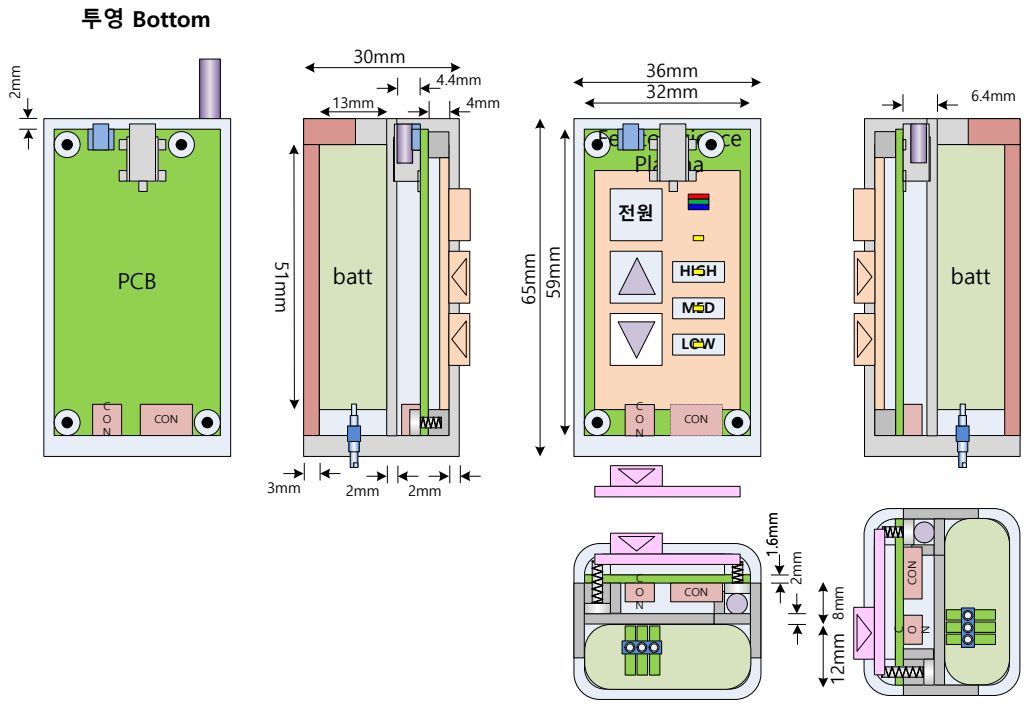
[picture p137: page 3]
투영 Bottom; PCB; CON; batt; LOW; MED; HIGH; Femto Science Plasma

# 36mm 30mm 45mm 25mm

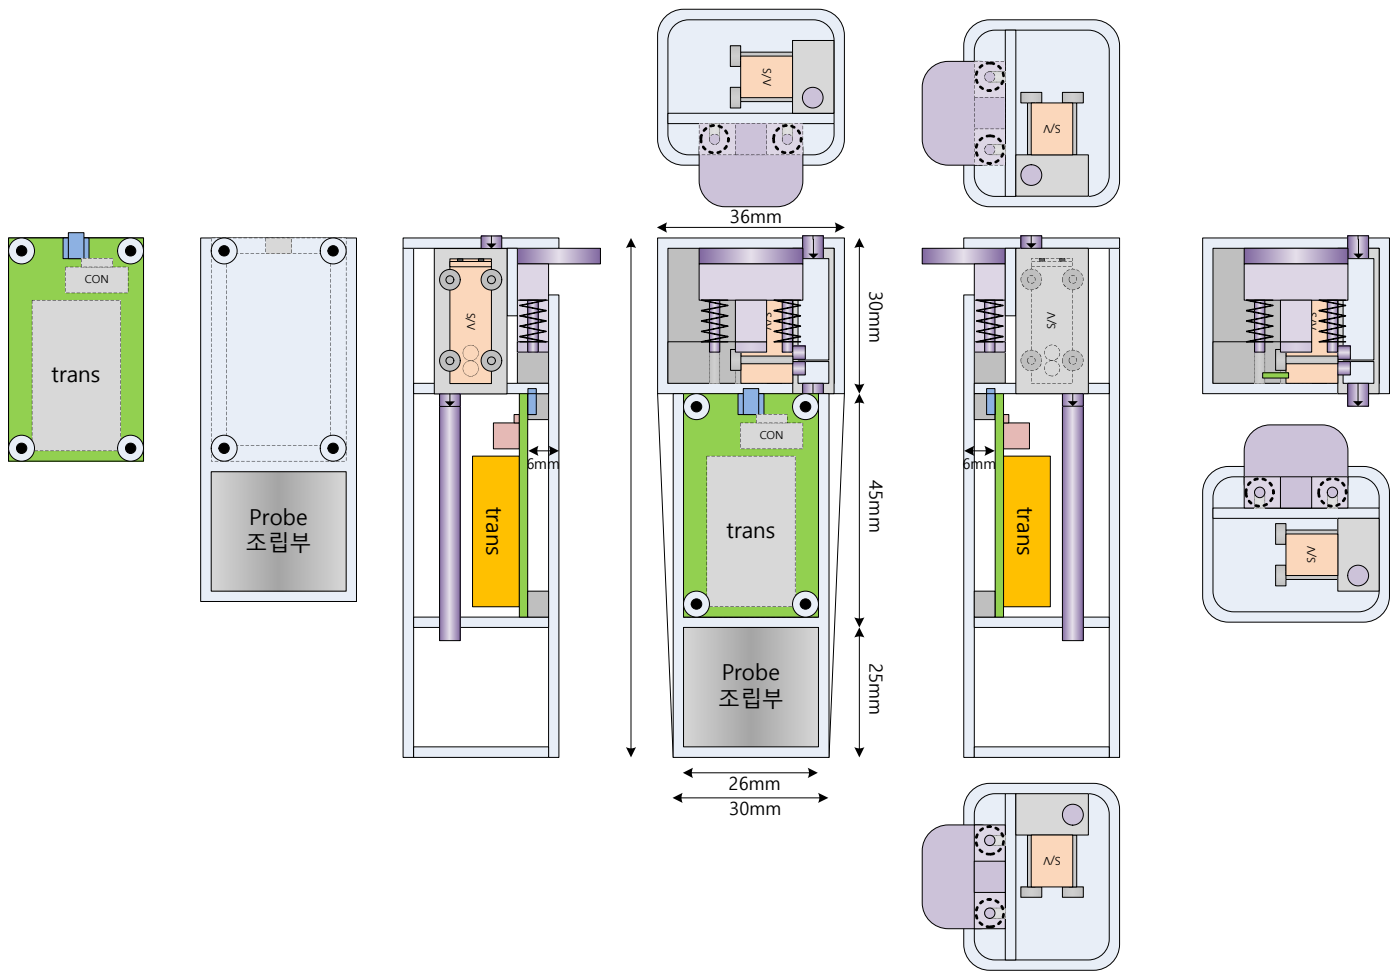
[picture p138: page 4]
Probe; 조립부; PCB trans; CON; S/V Probe; S/V 6mm trans 6mm S/V trans

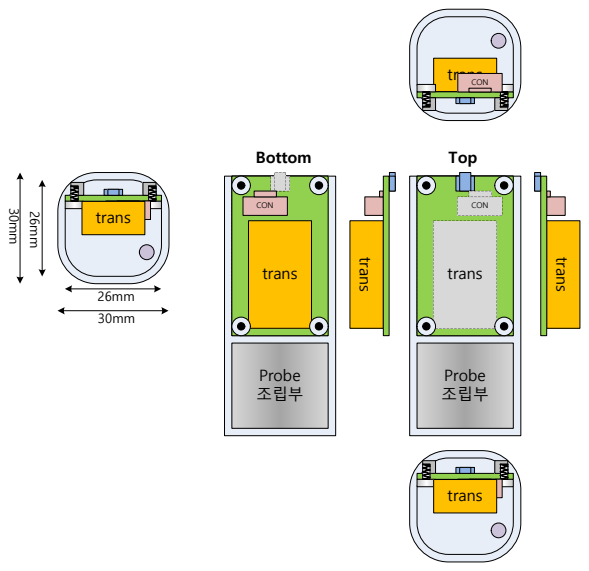
[picture p139: page 6]
Probe 조립부; PCB trans; CON; CON trans; trans; transCON; 30mm ²⁶mm ³⁰mm; Bottom; Top
