ArvidJoung/Plasma_Generator/0_Proto_type/4_Firmware/Source/doc/Plasma_Gen_Main Board_SCH_V1.0_20171211.pdf

# FIVE FINGER

# MCU Schematic

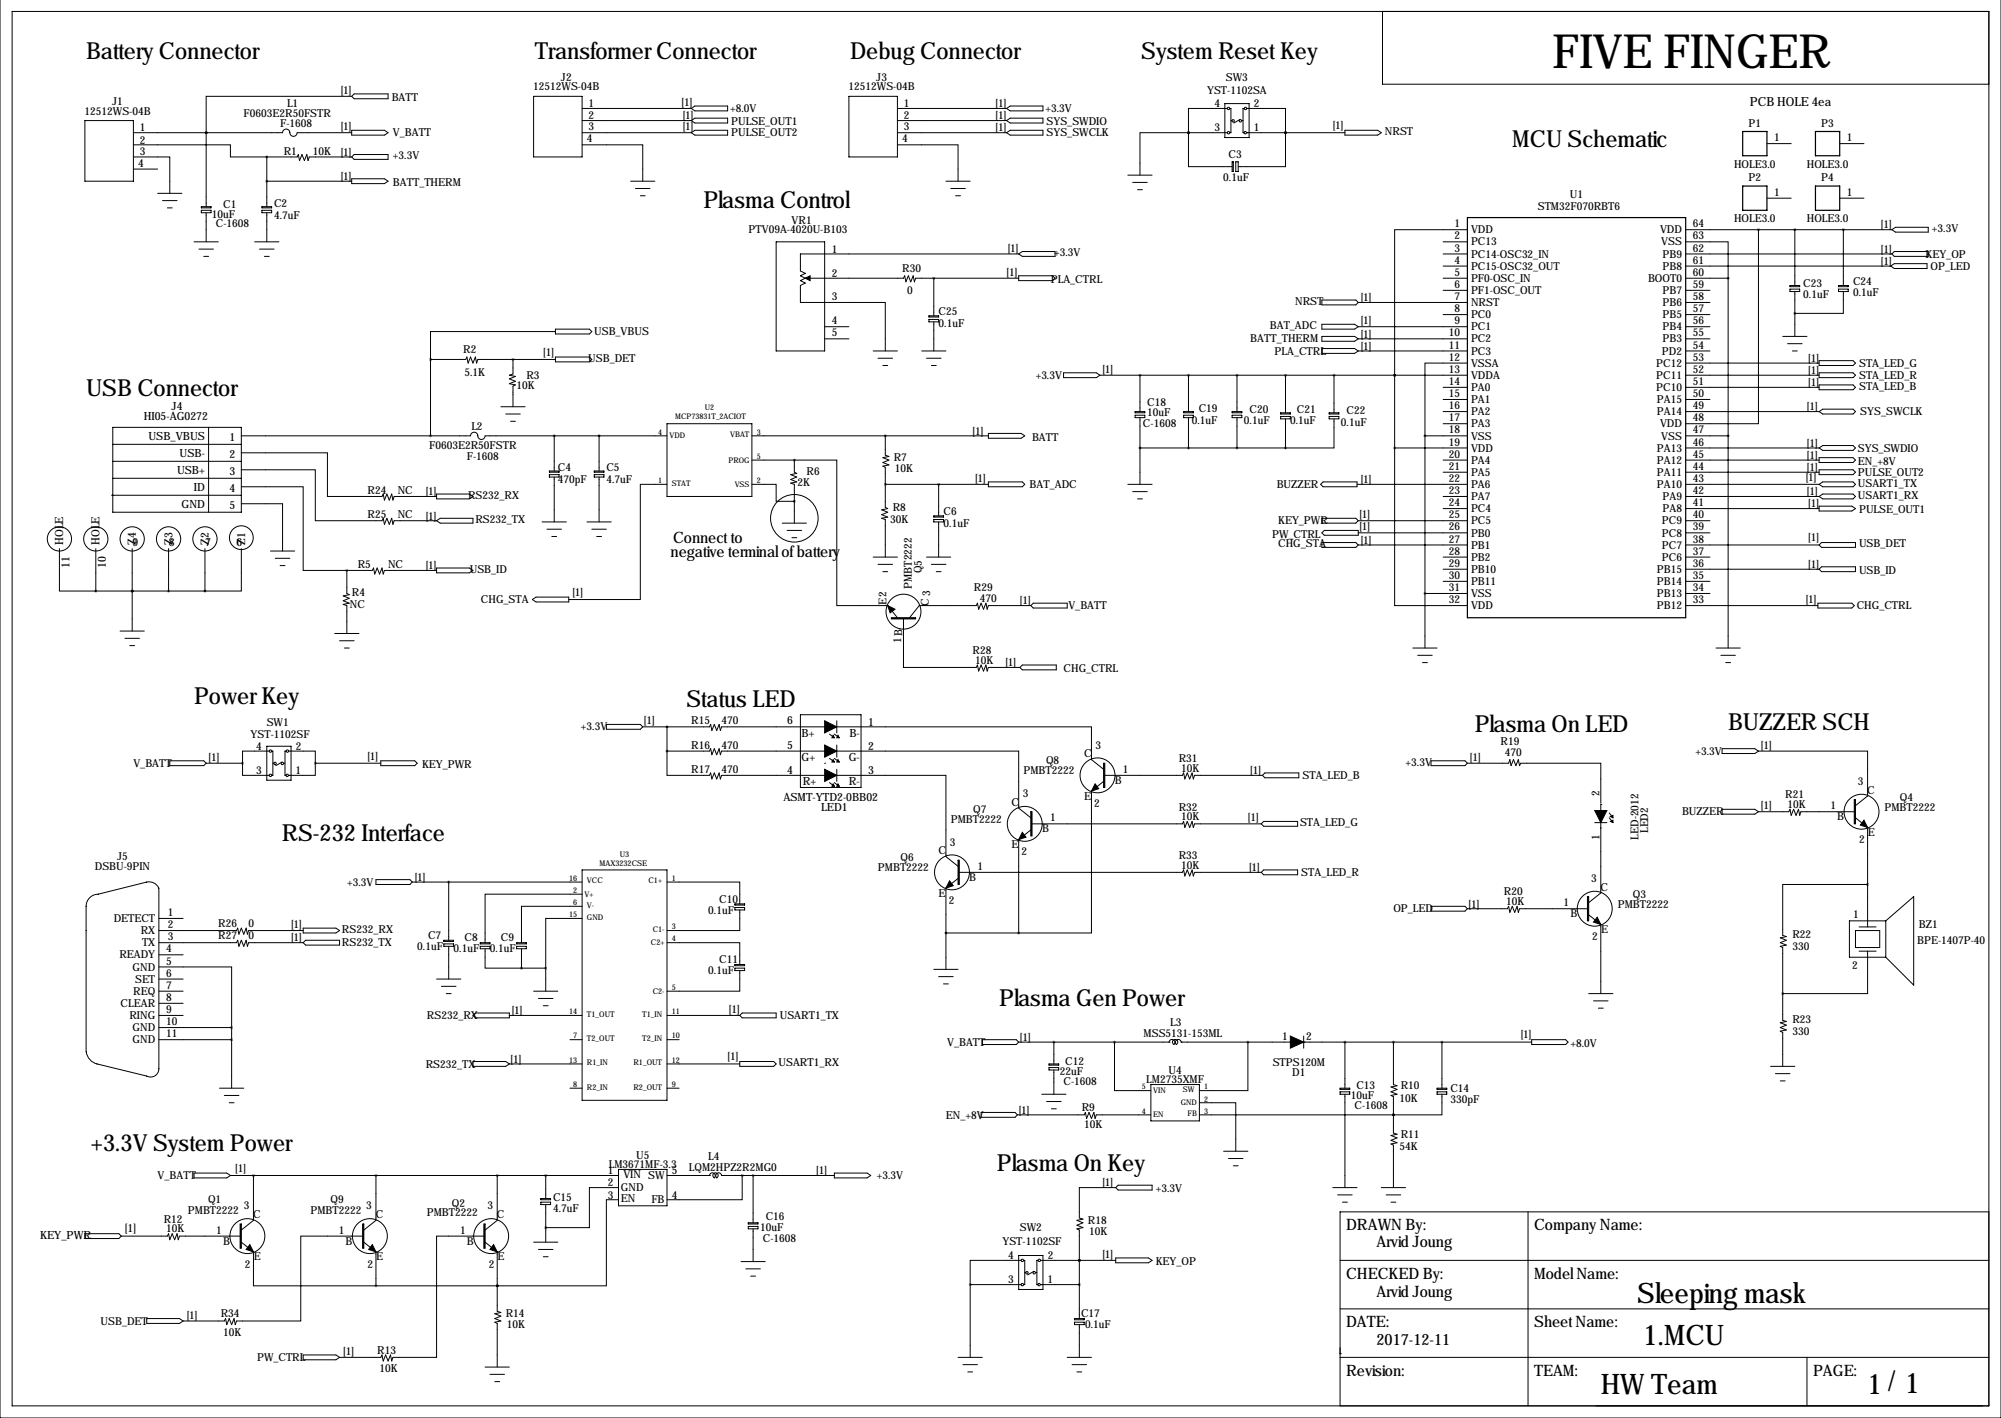
[picture p140: page 1]

USB- | 2
USB+ | 3
ID | 4
GND | 5

Connect to
negative terminal of battery
