ArvidJoung/Plasma_Generator/1_Plasma_Pipette/1_Schematic/V2.0/ME/20180730_Battery 2D/batt-plasma-180730.pdf

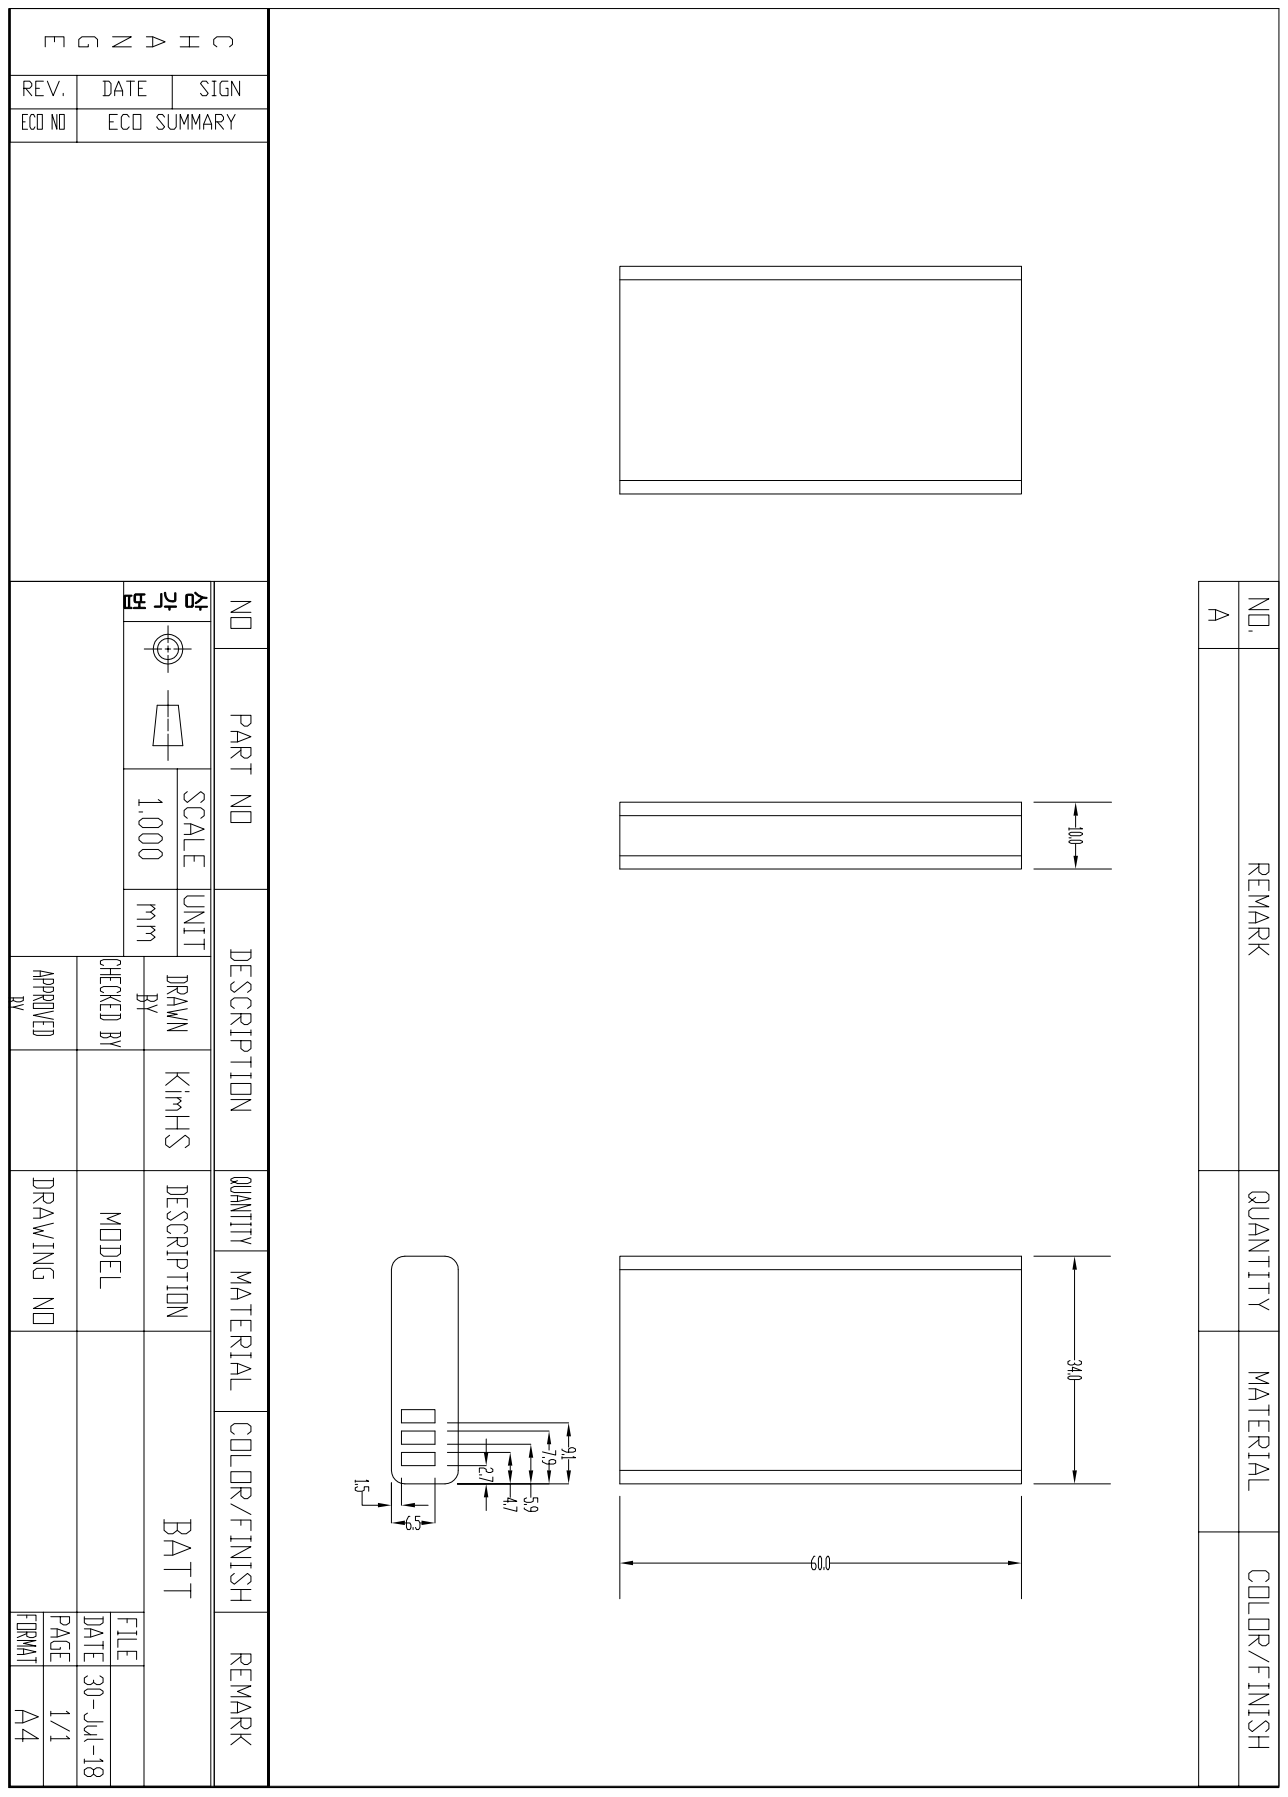
[picture p141: page 1]
