ArvidJoung/Plasma_Generator/0_MP4 Data/Plasma_Pipette_V5.0_Main_PCB_TOP.pdf

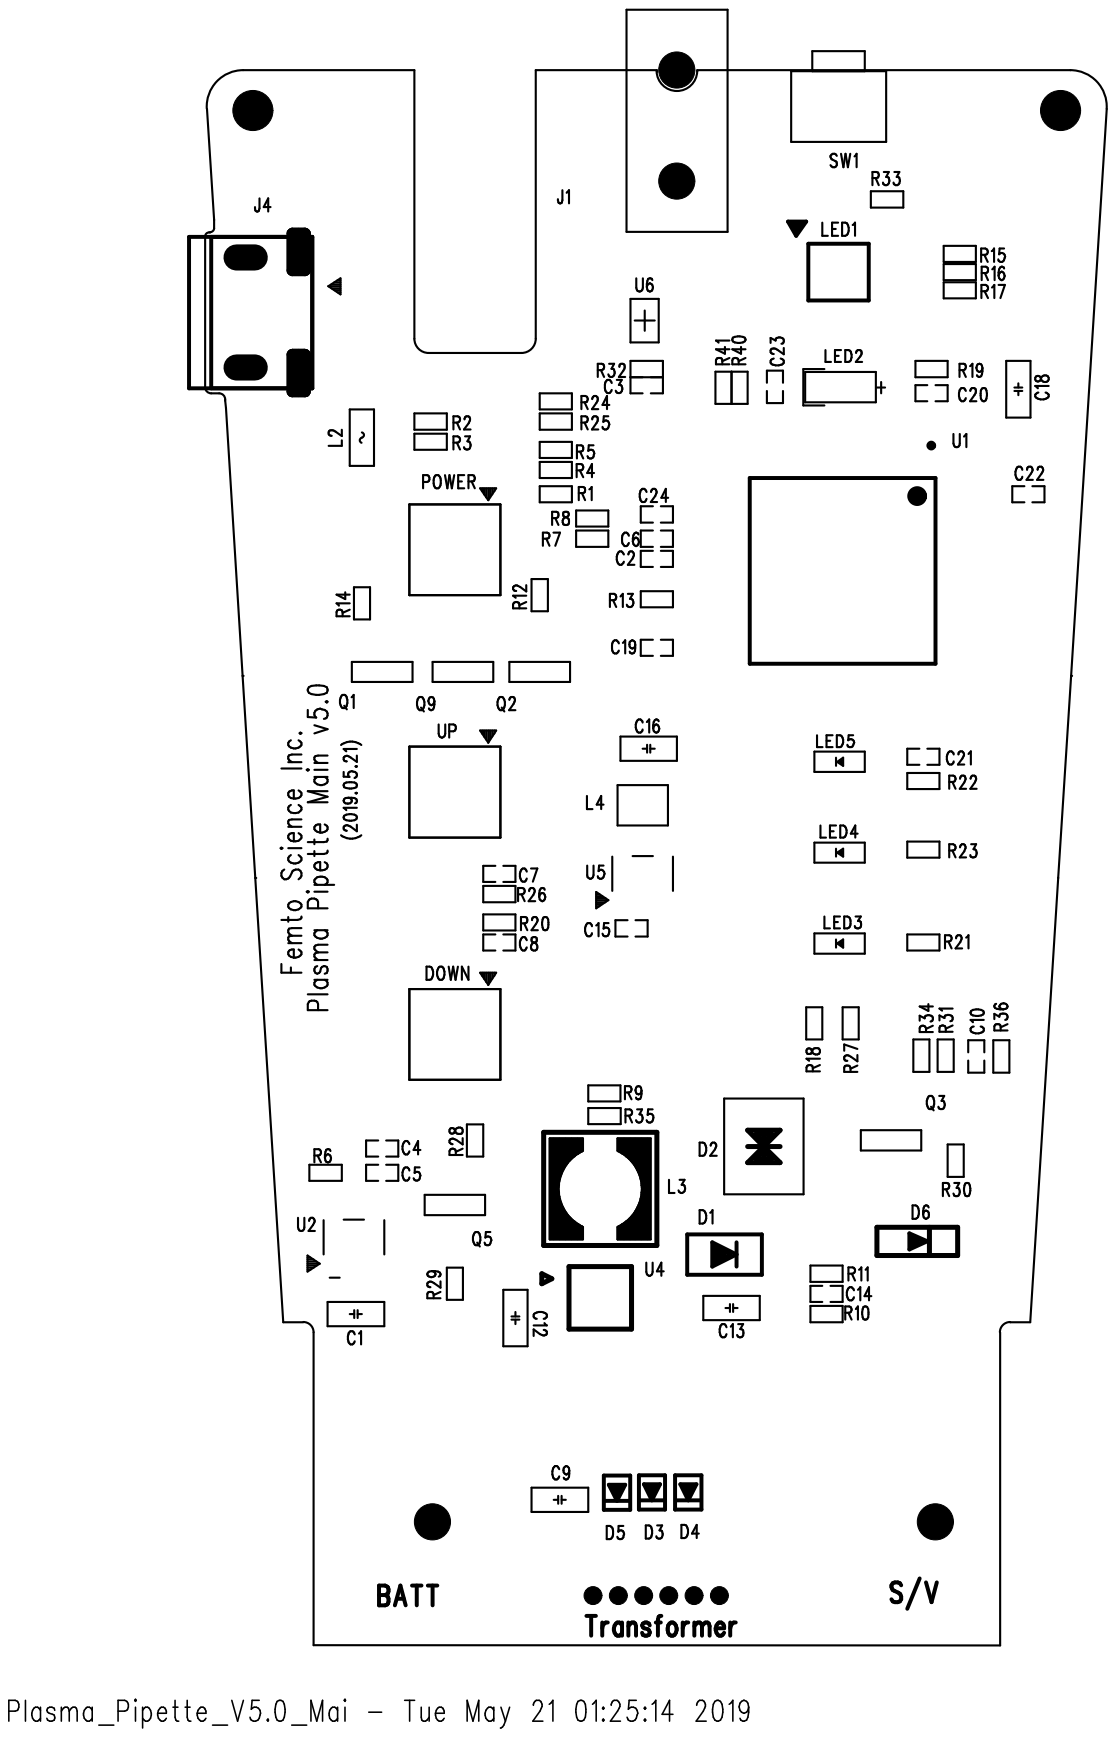
[picture p143: page 1]
