ArvidJoung/Plasma_Generator/퇴사자/급여입금내역_2016.05.30~2017.05.29.pdf

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

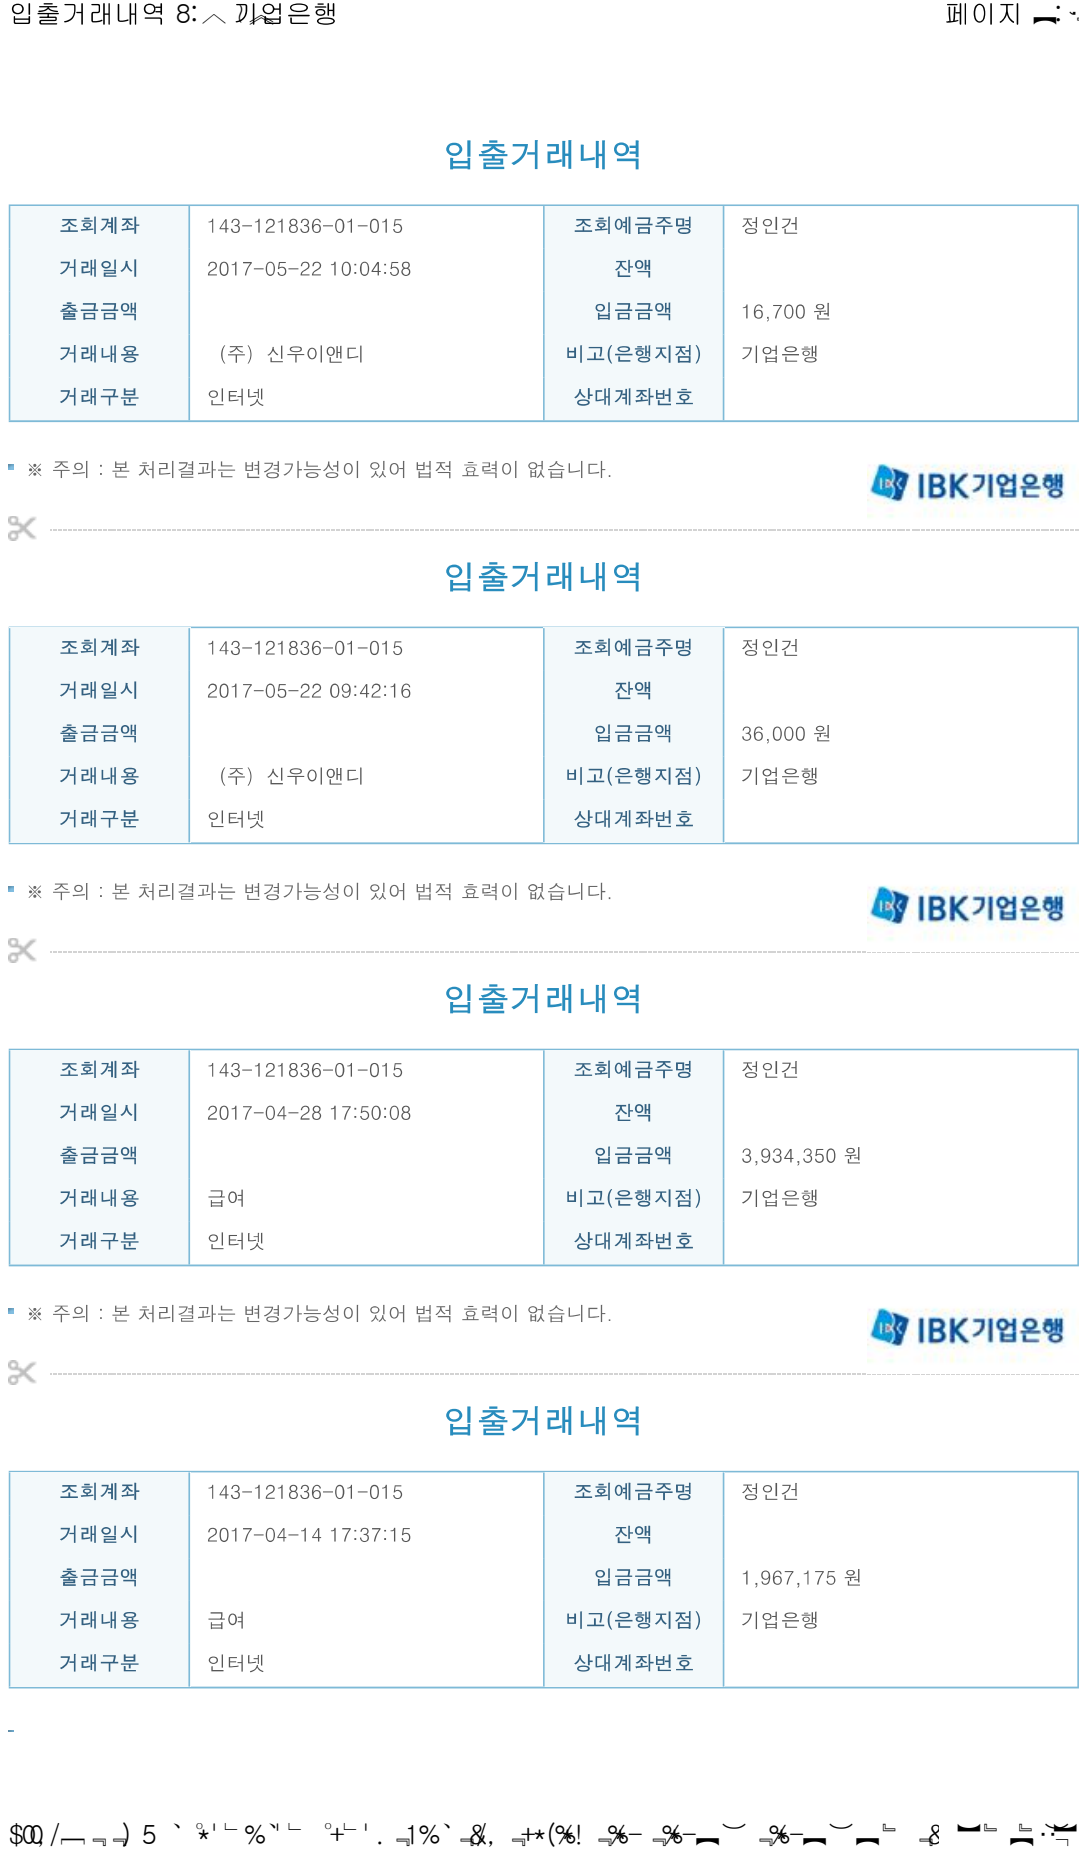
[picture p144: page 1]

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

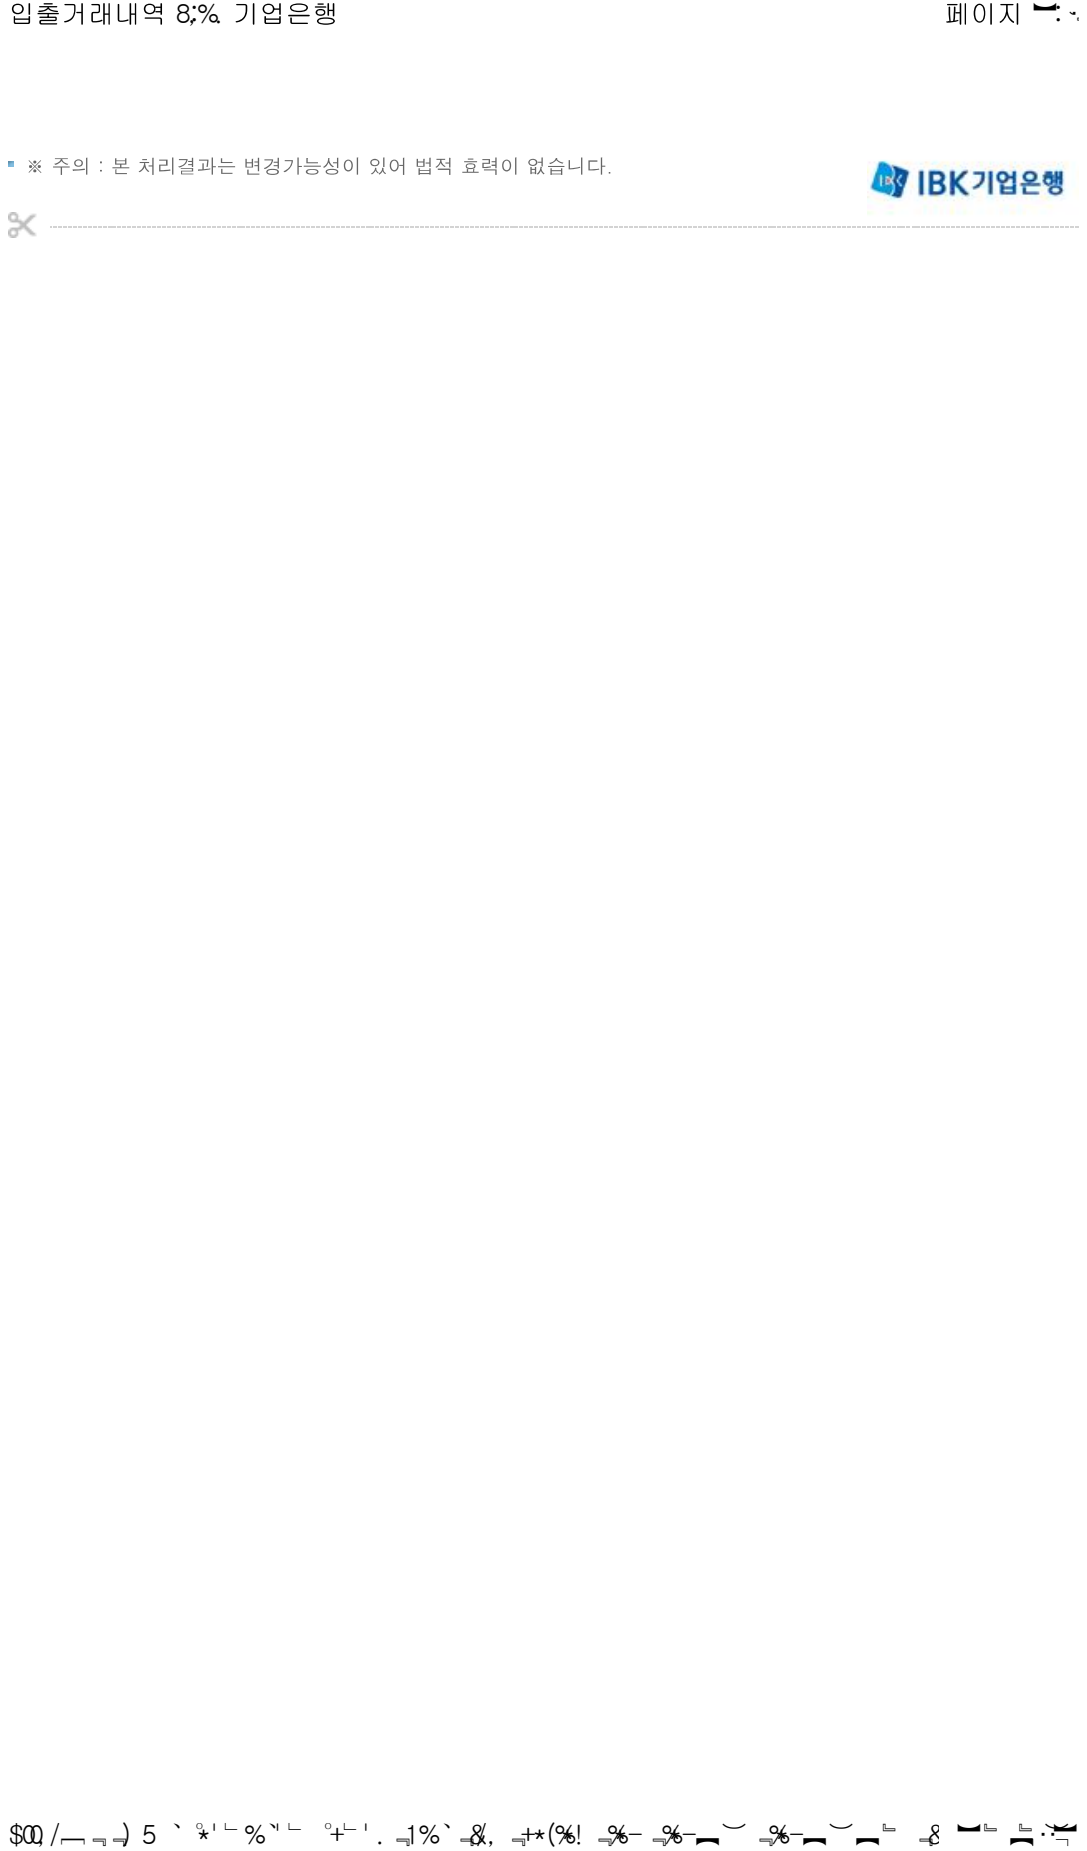
[picture p145: page 2]

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

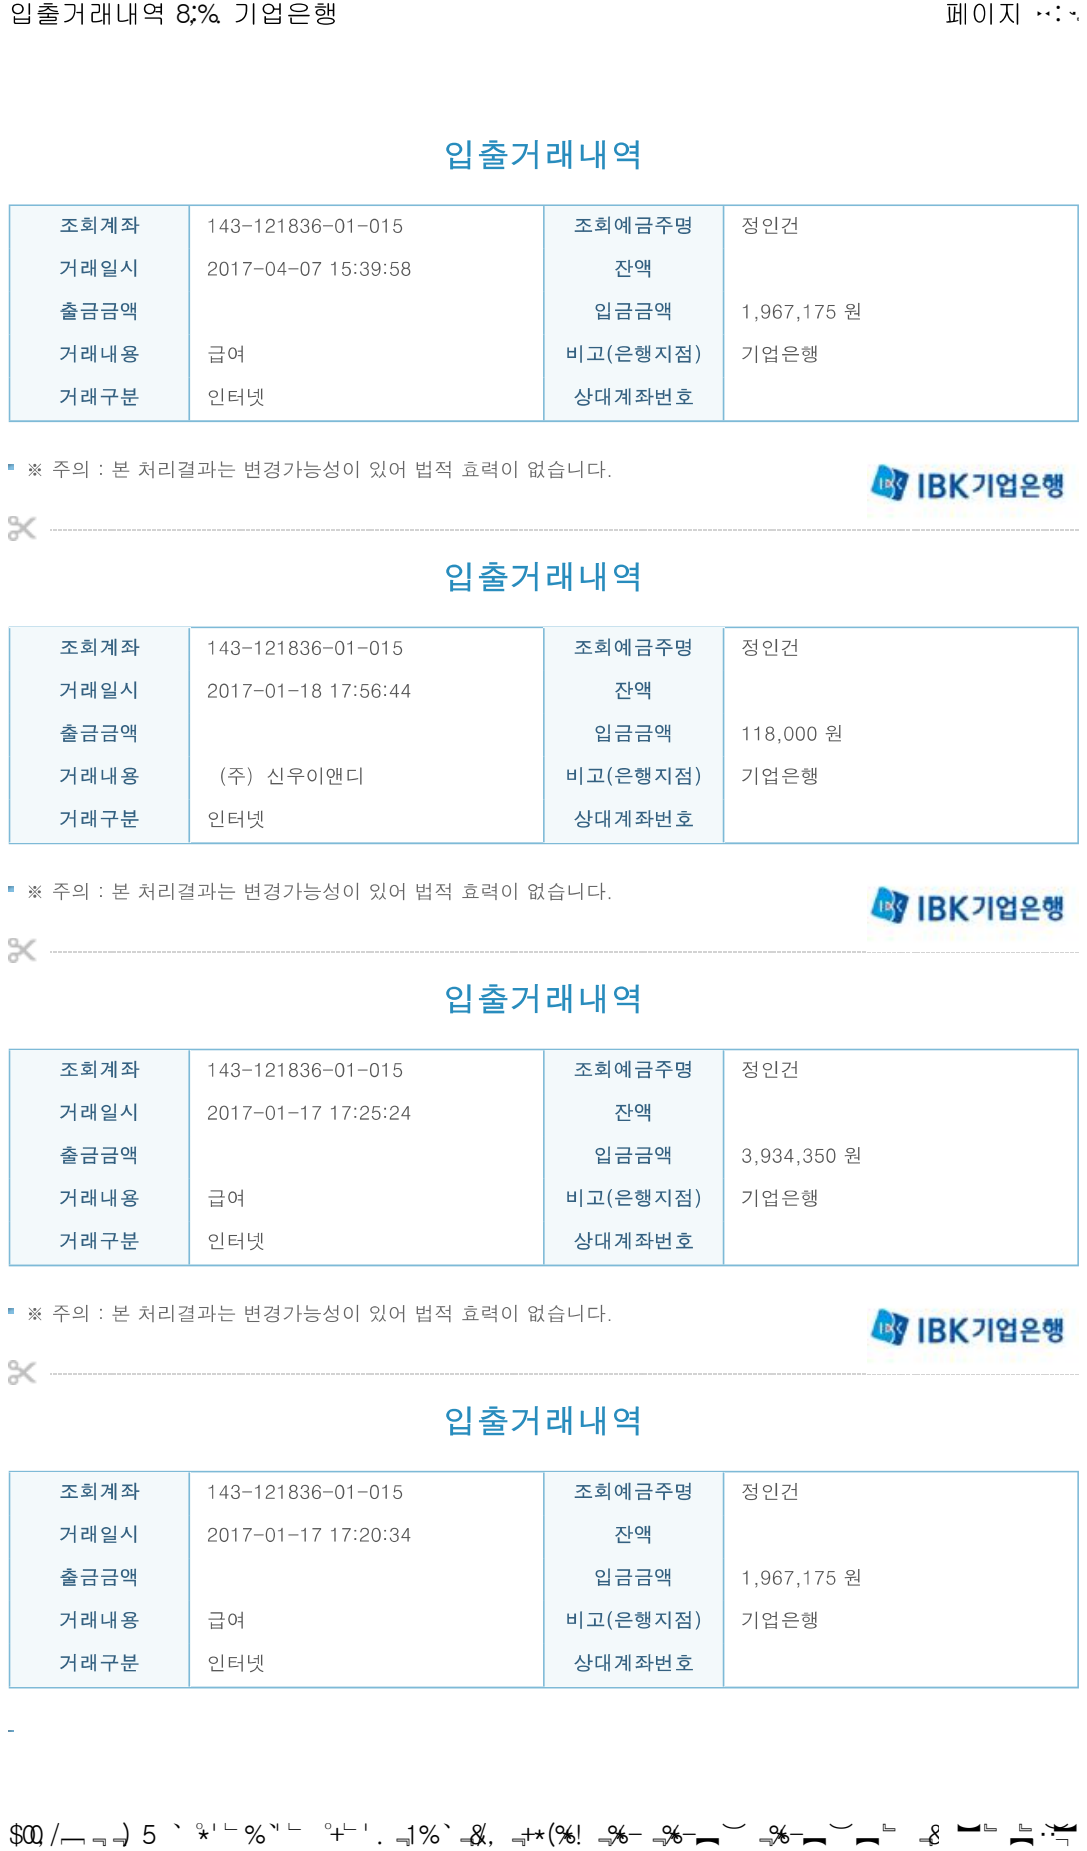
[picture p146: page 3]

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

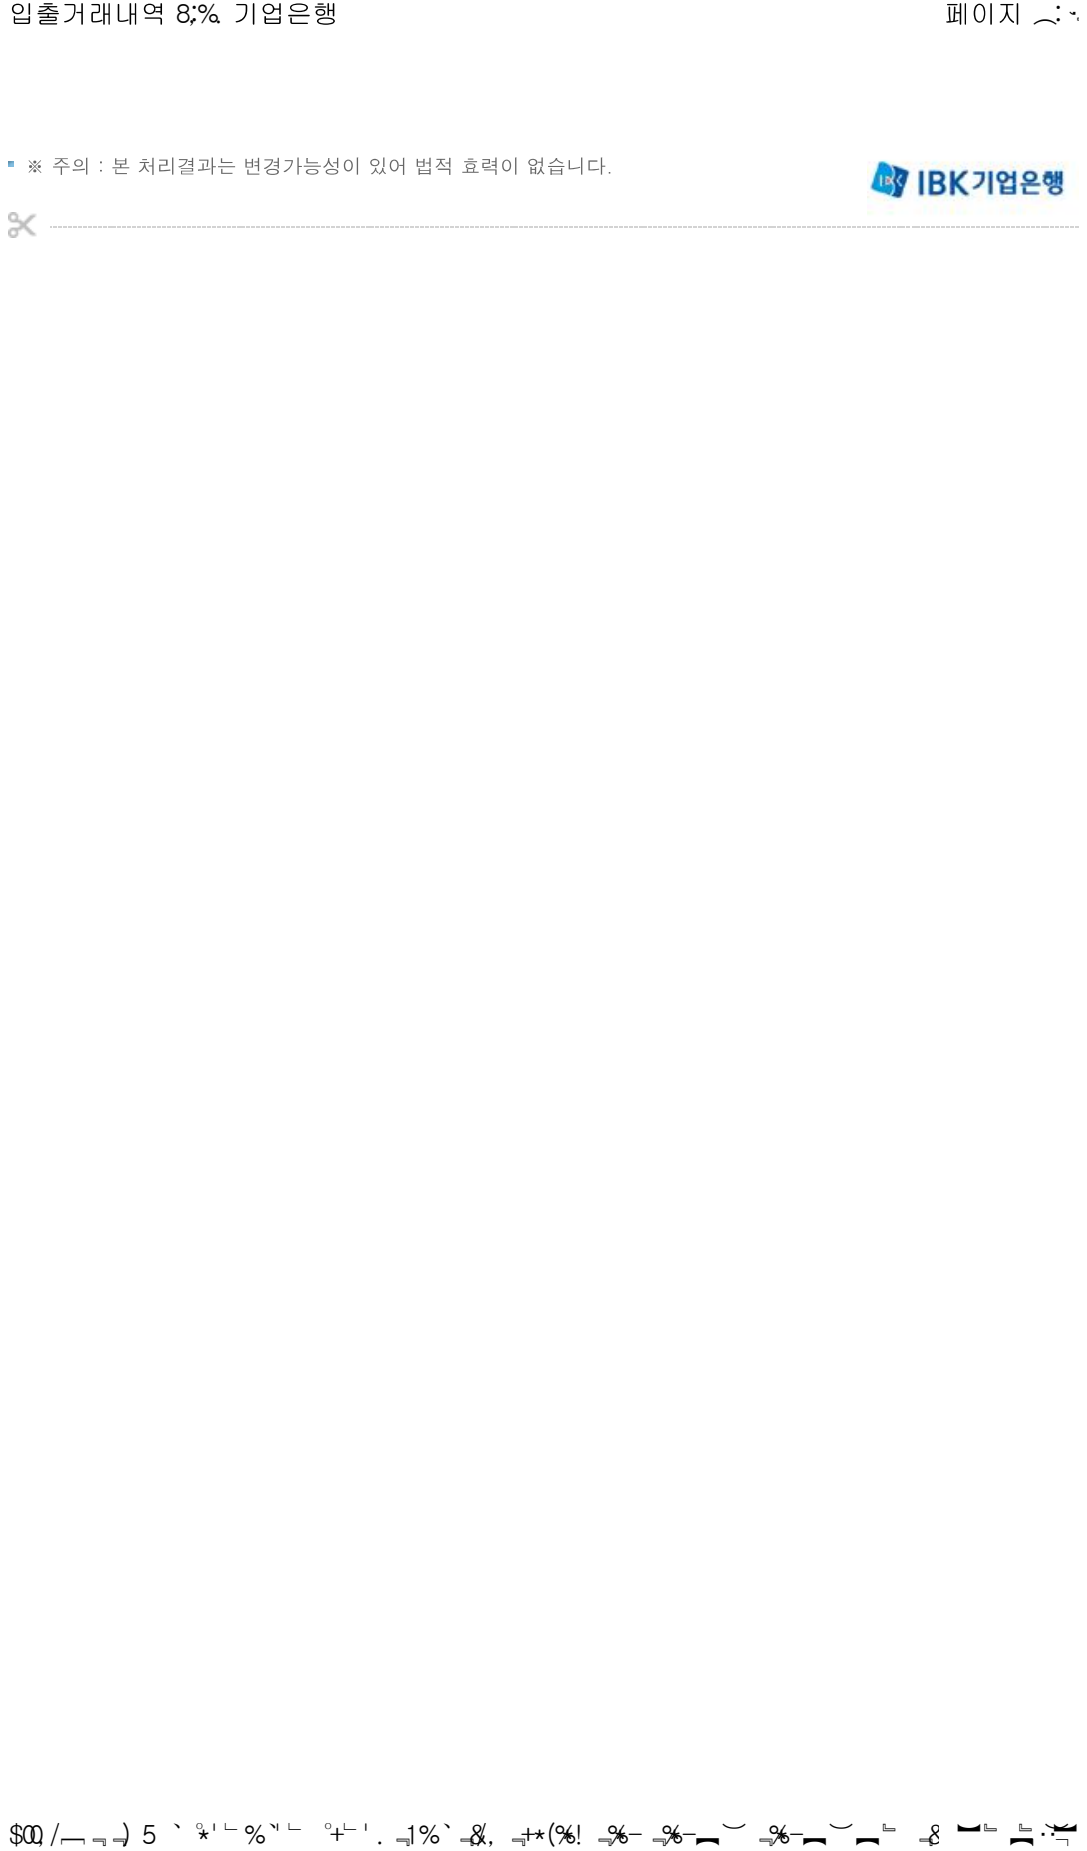
[picture p147: page 4]

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

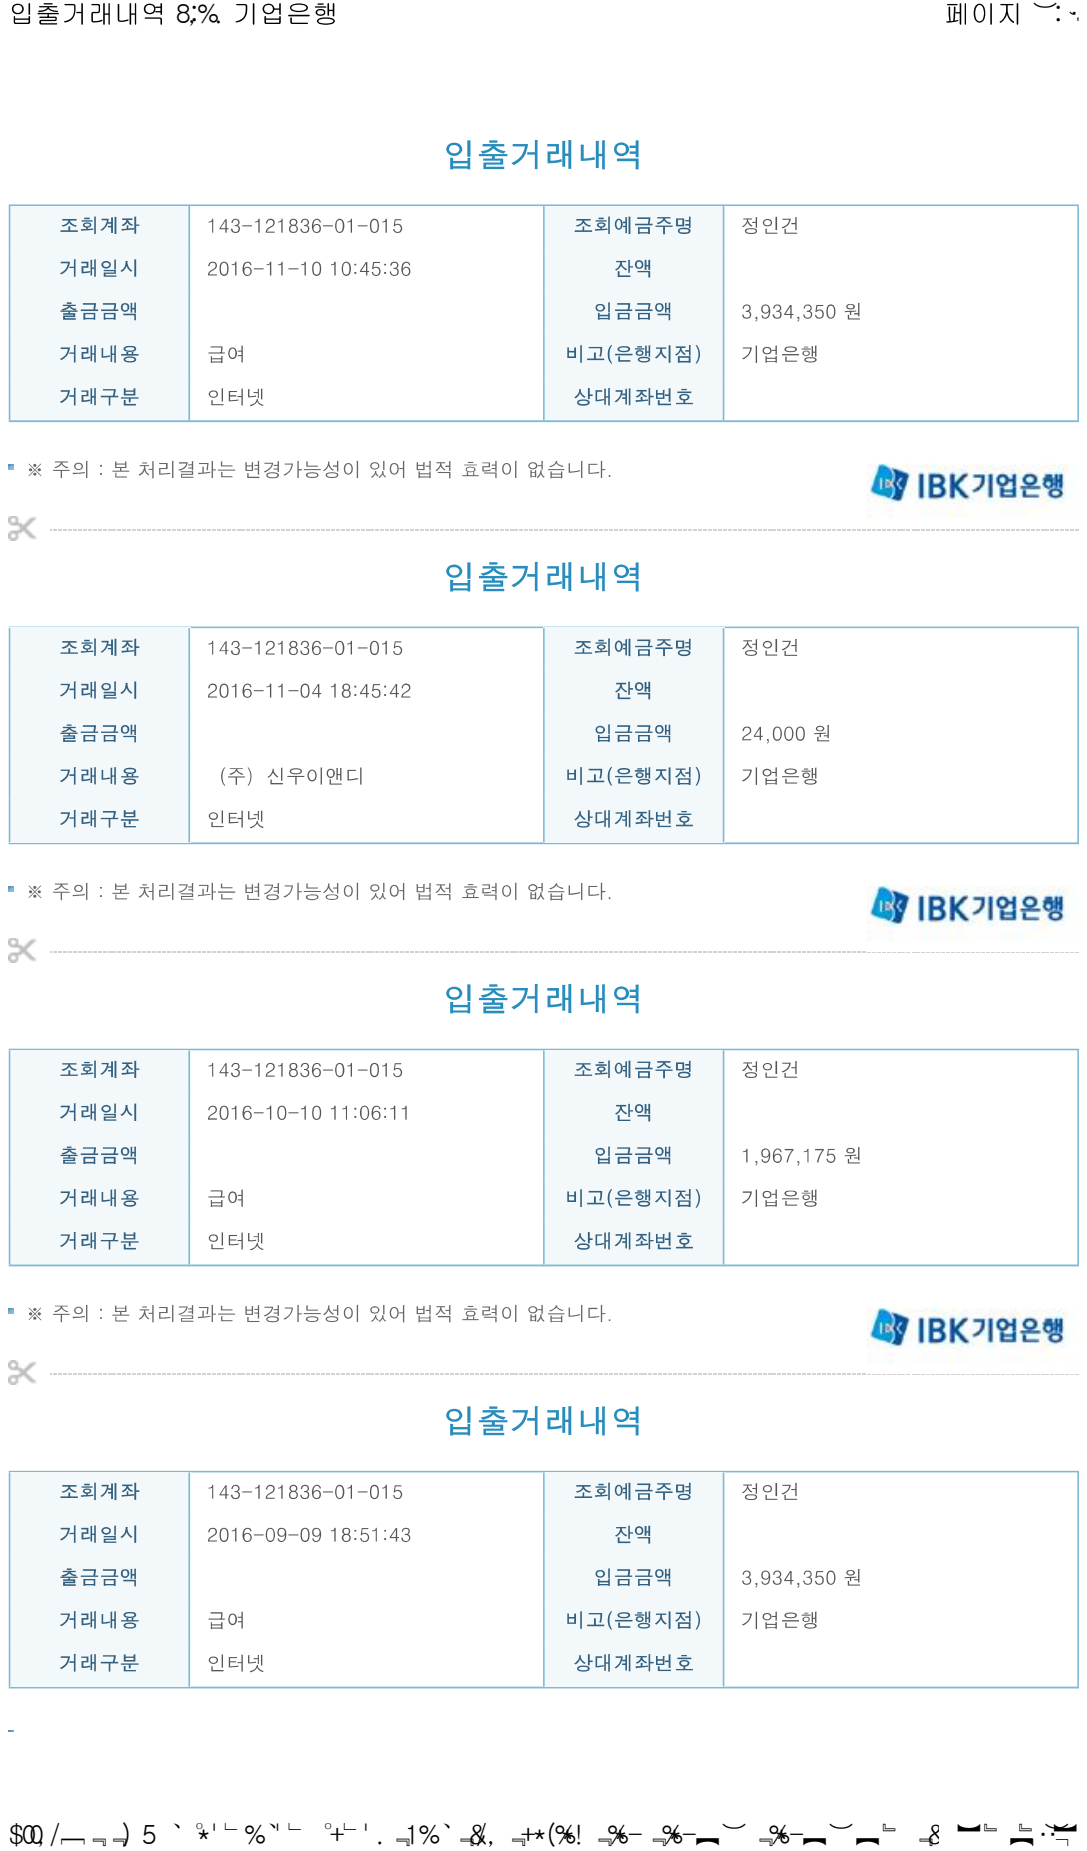
[picture p148: page 5]

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

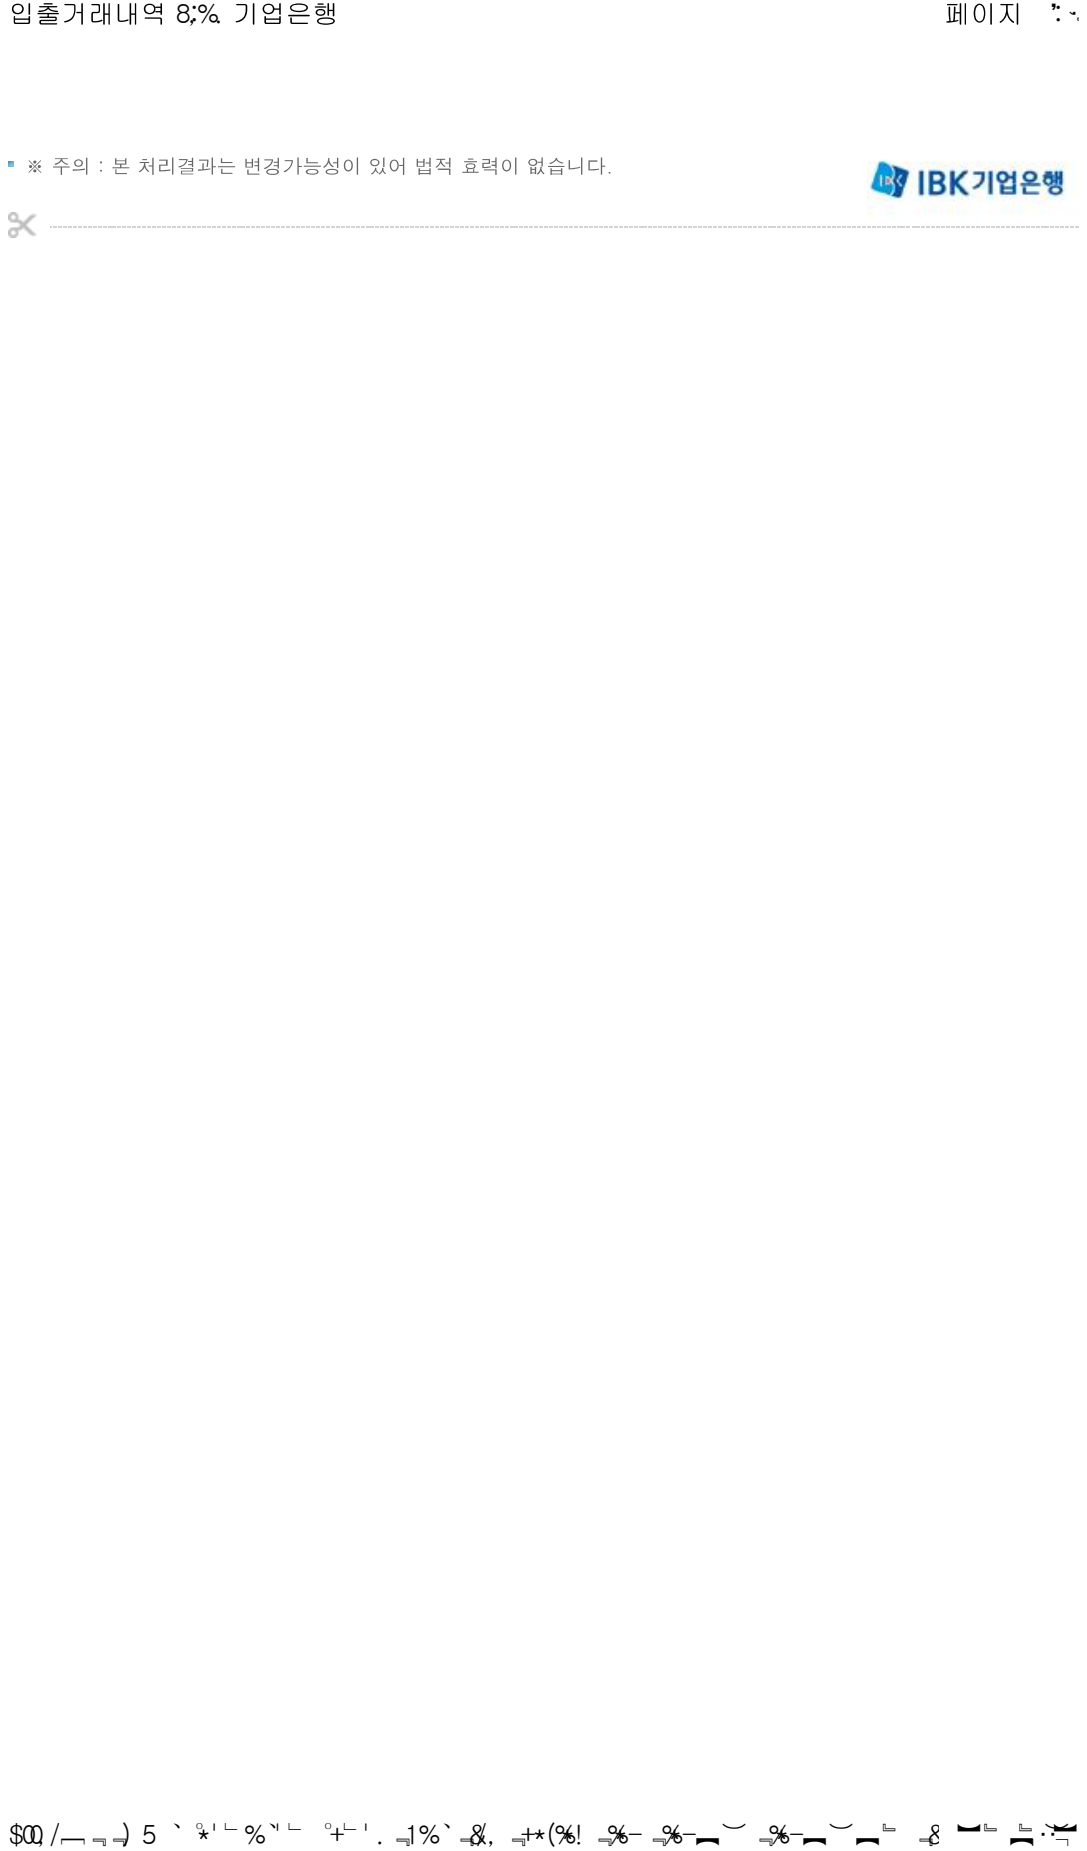
[picture p149: page 6]

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

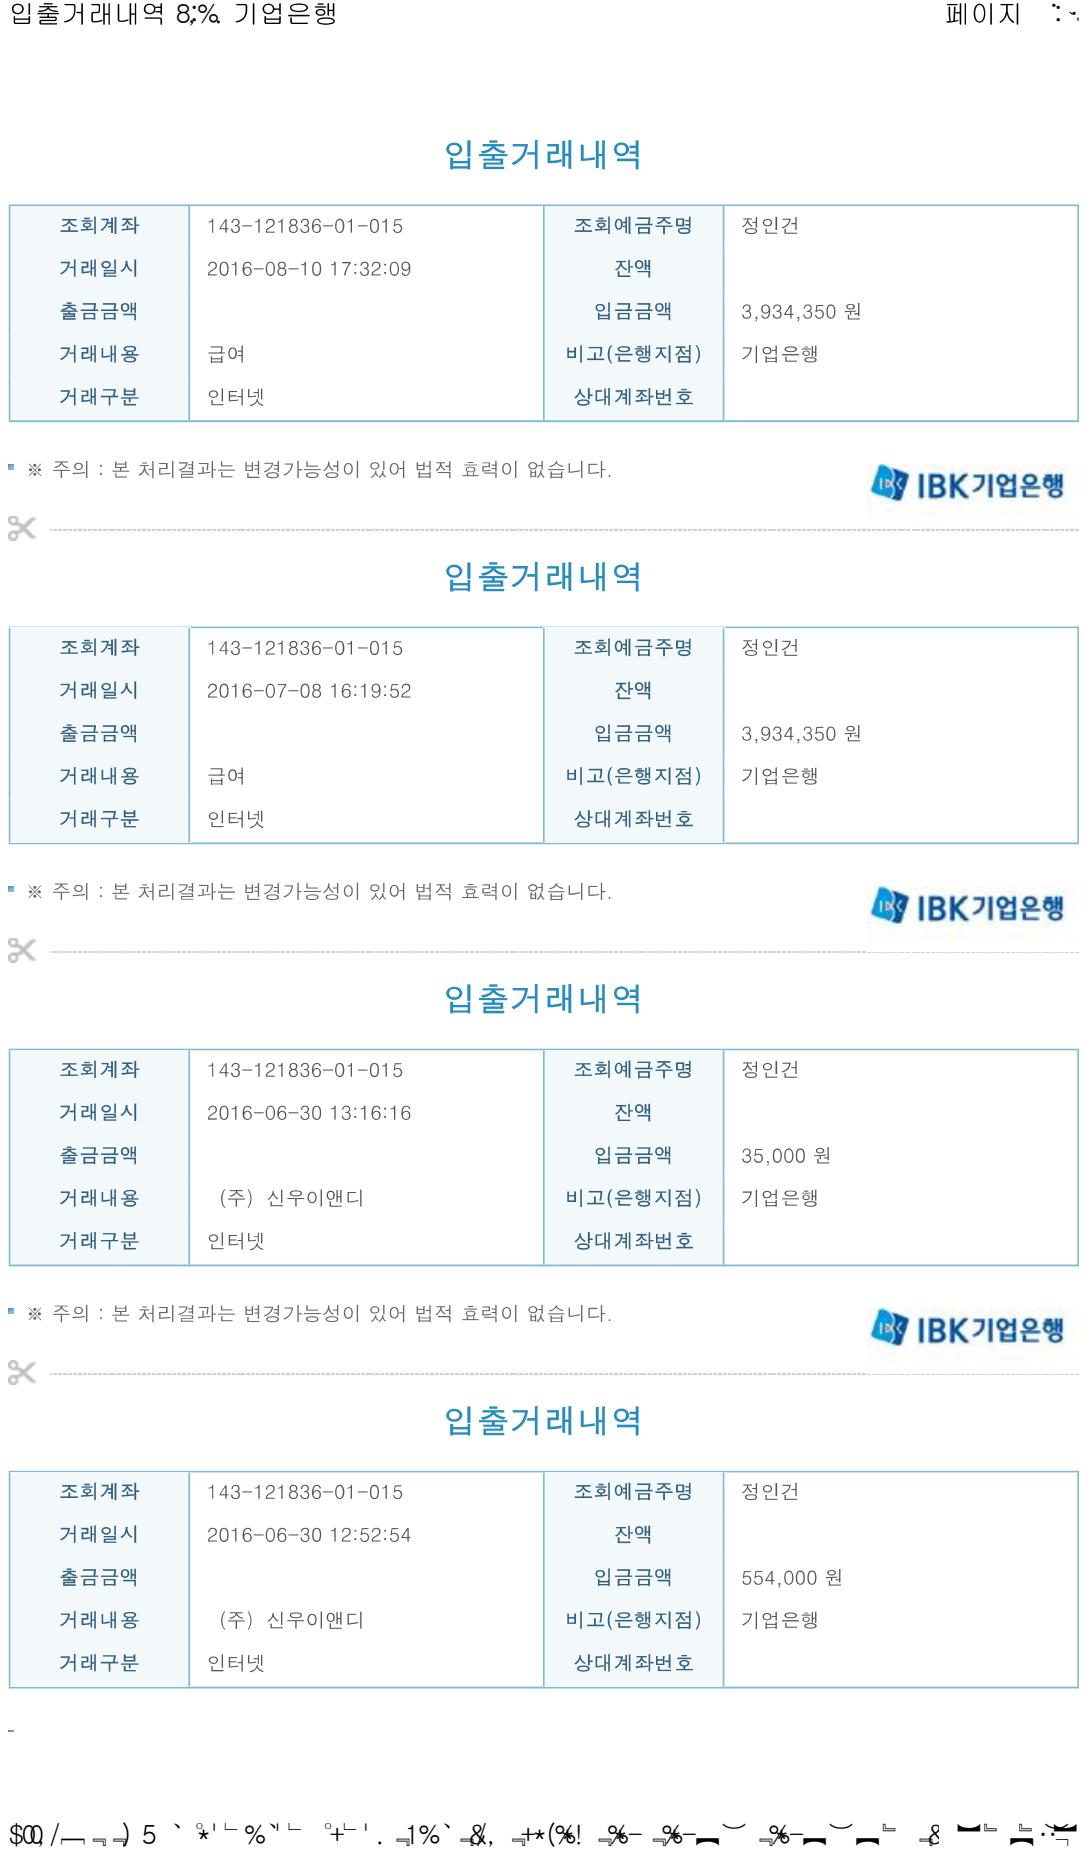
[picture p150: page 7]

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

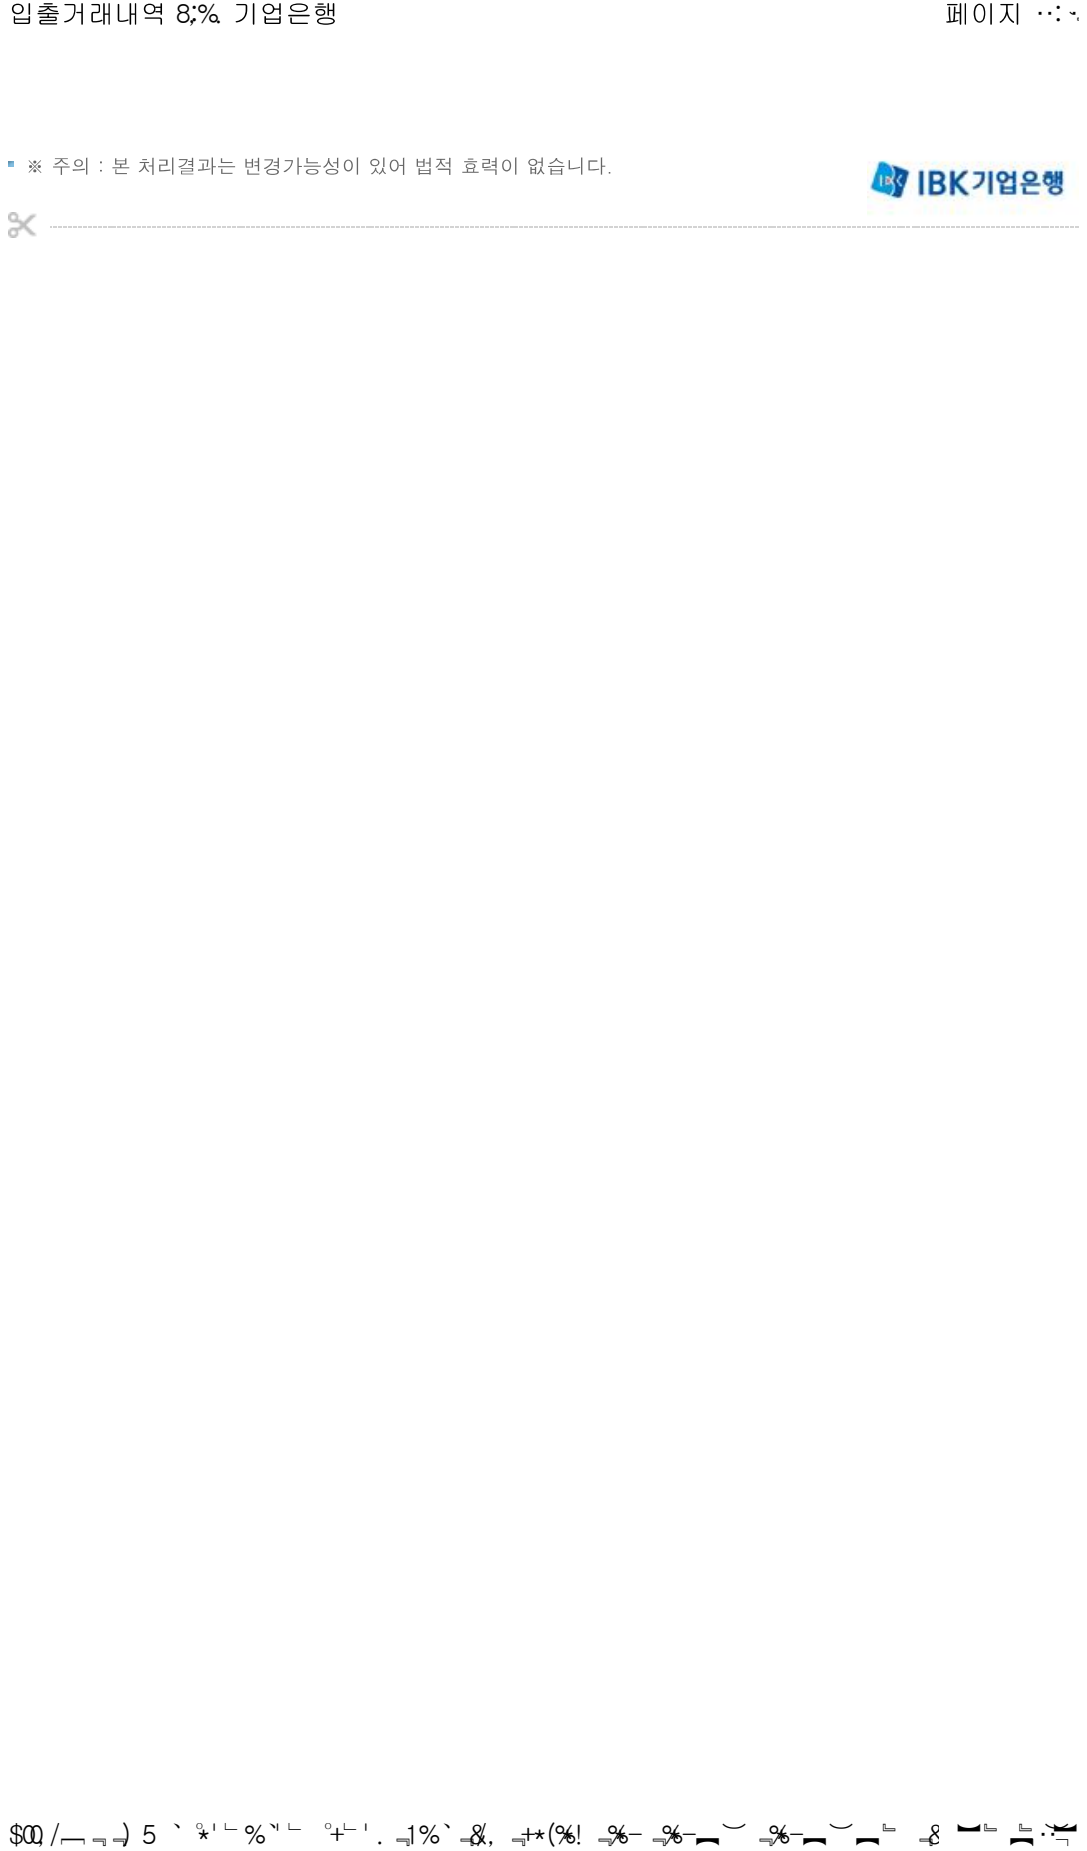
[picture p151: page 8]

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

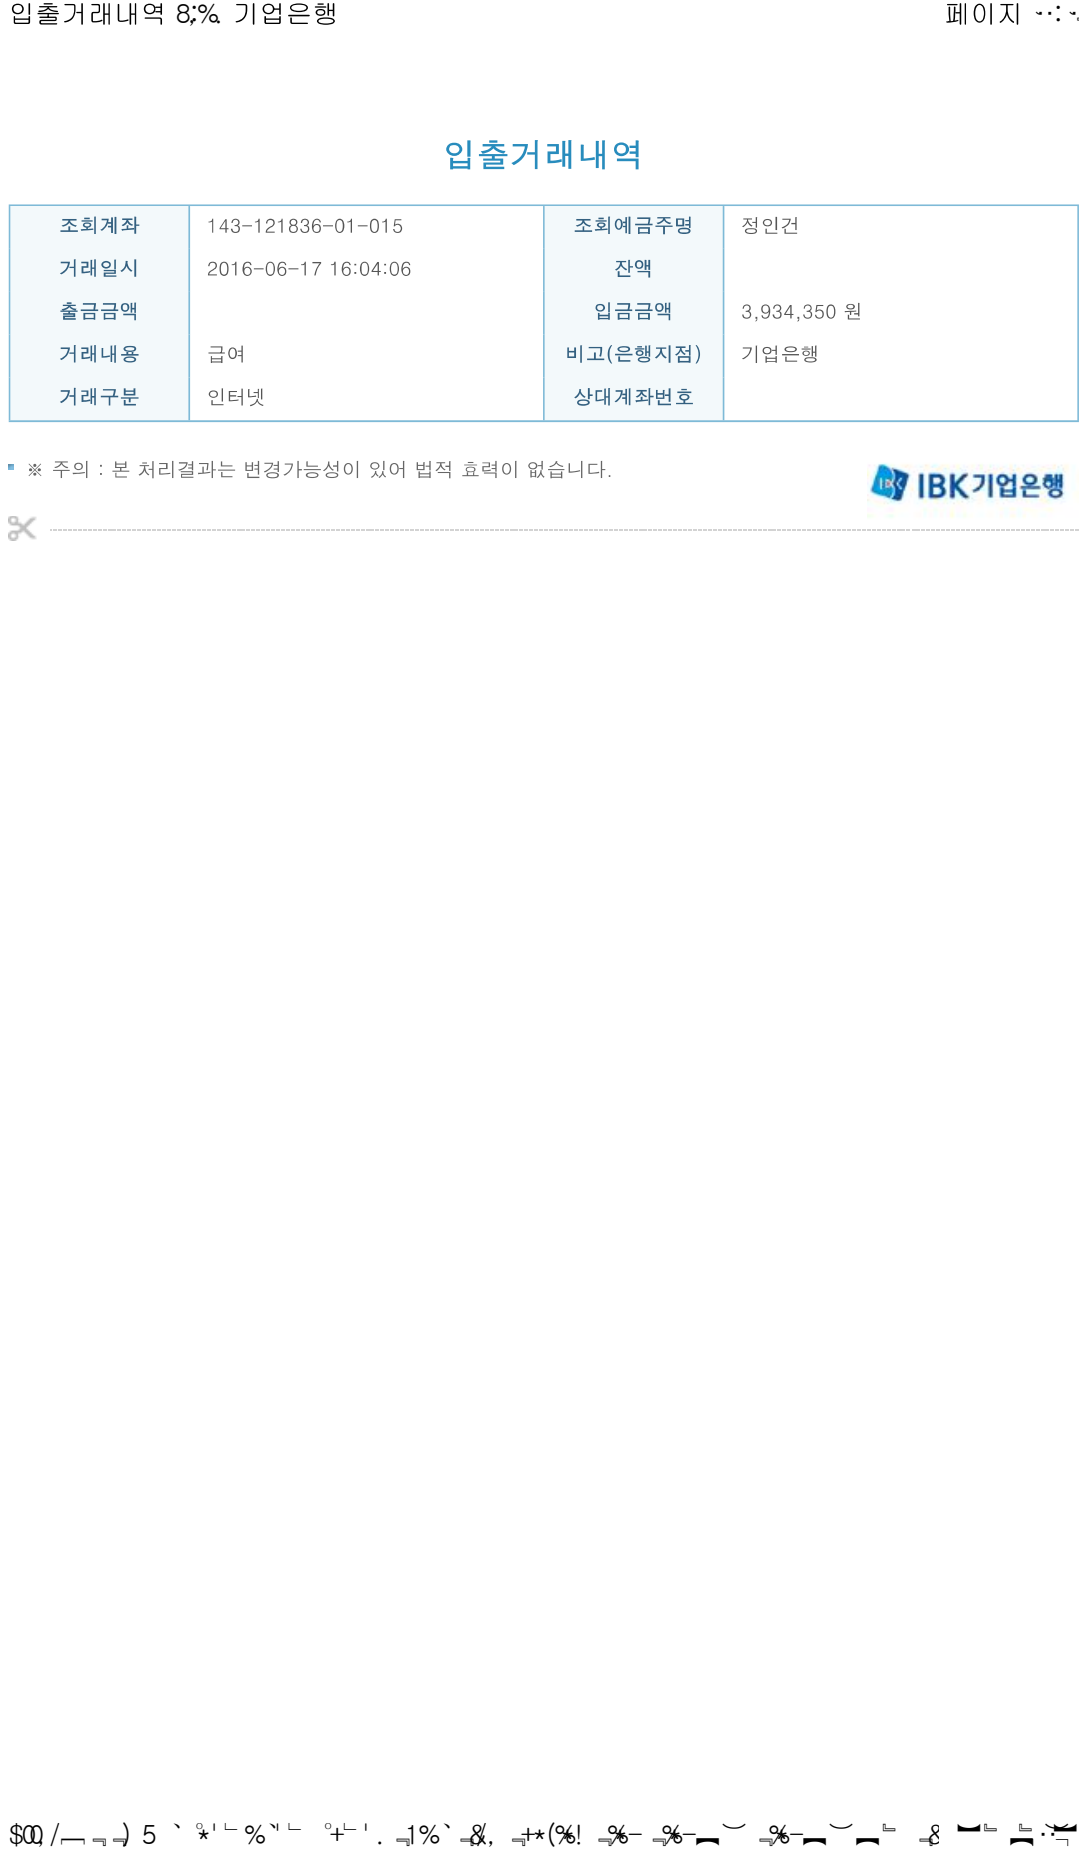
[picture p152: page 9]
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
