ArvidJoung/Plasma_Generator/퇴사자/급여입금내역_2017.05.30~2018.05.29.pdf

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

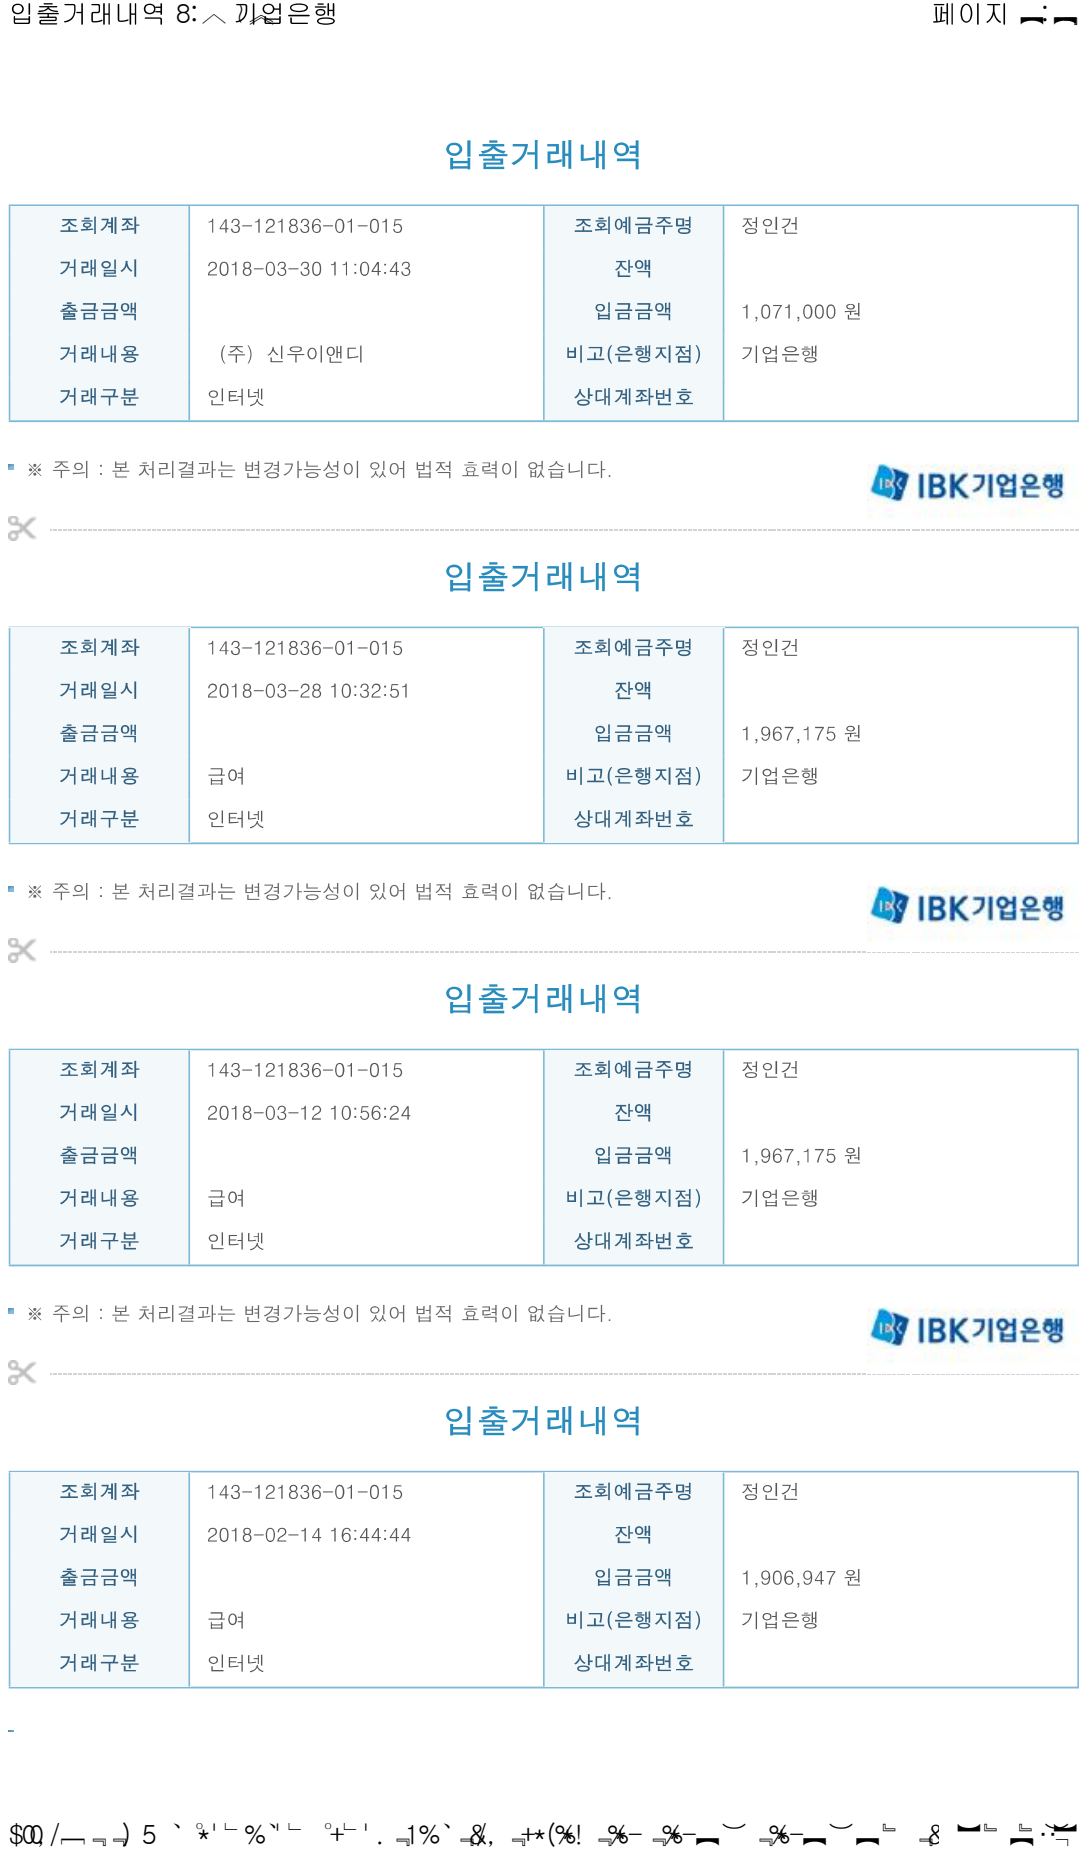
[picture p153: page 1]

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

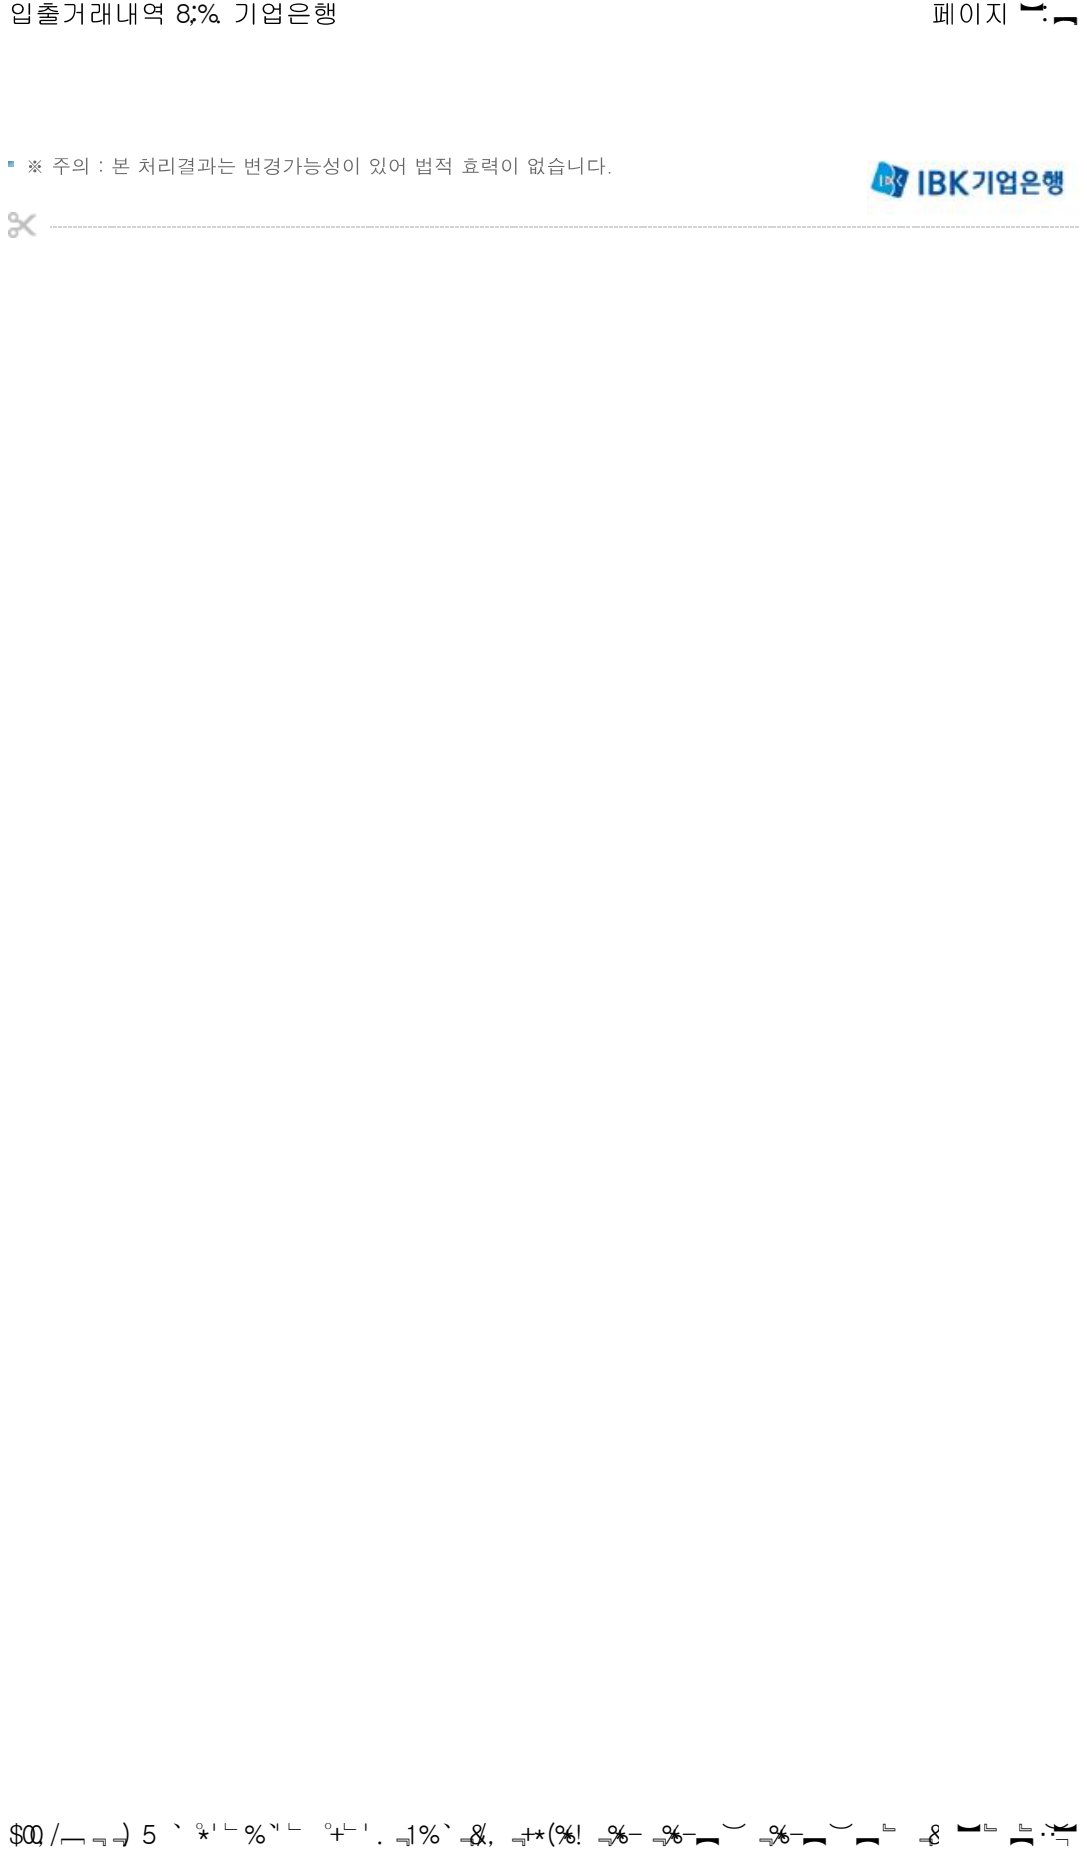
[picture p154: page 2]

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

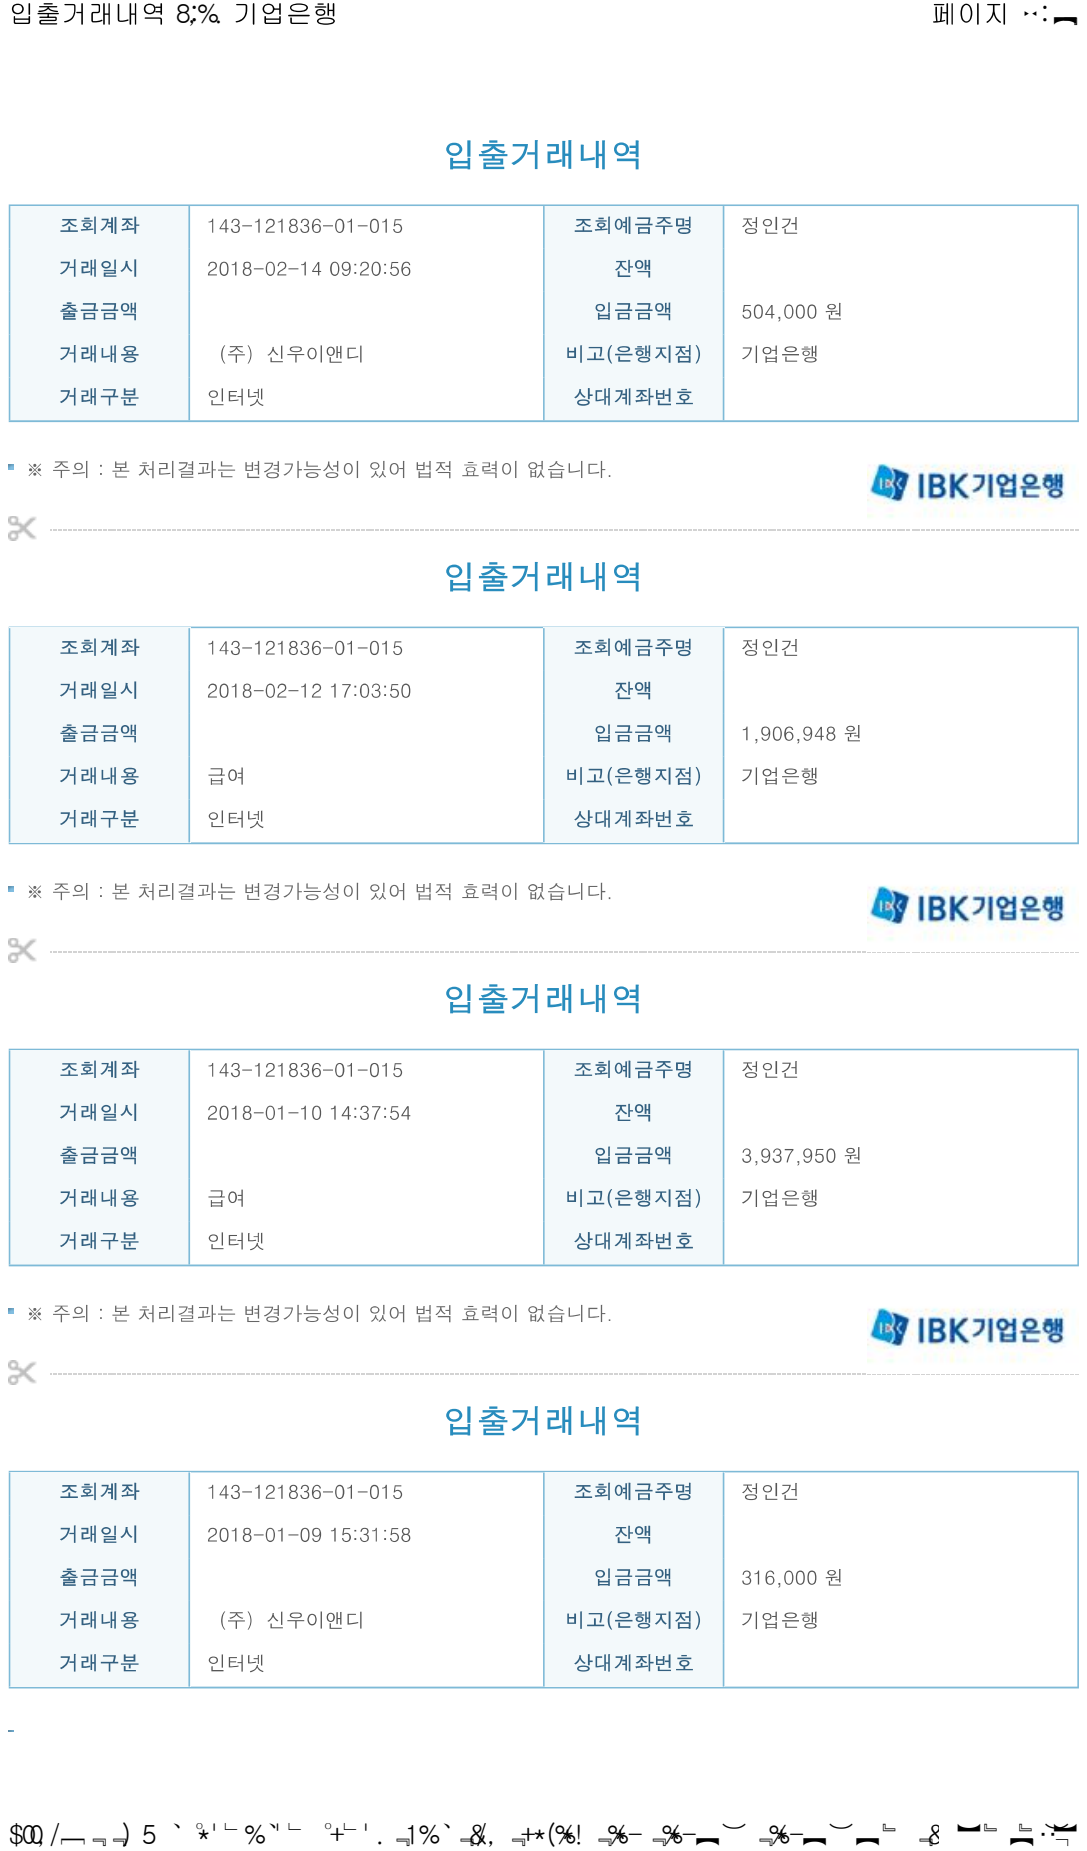
[picture p155: page 3]

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

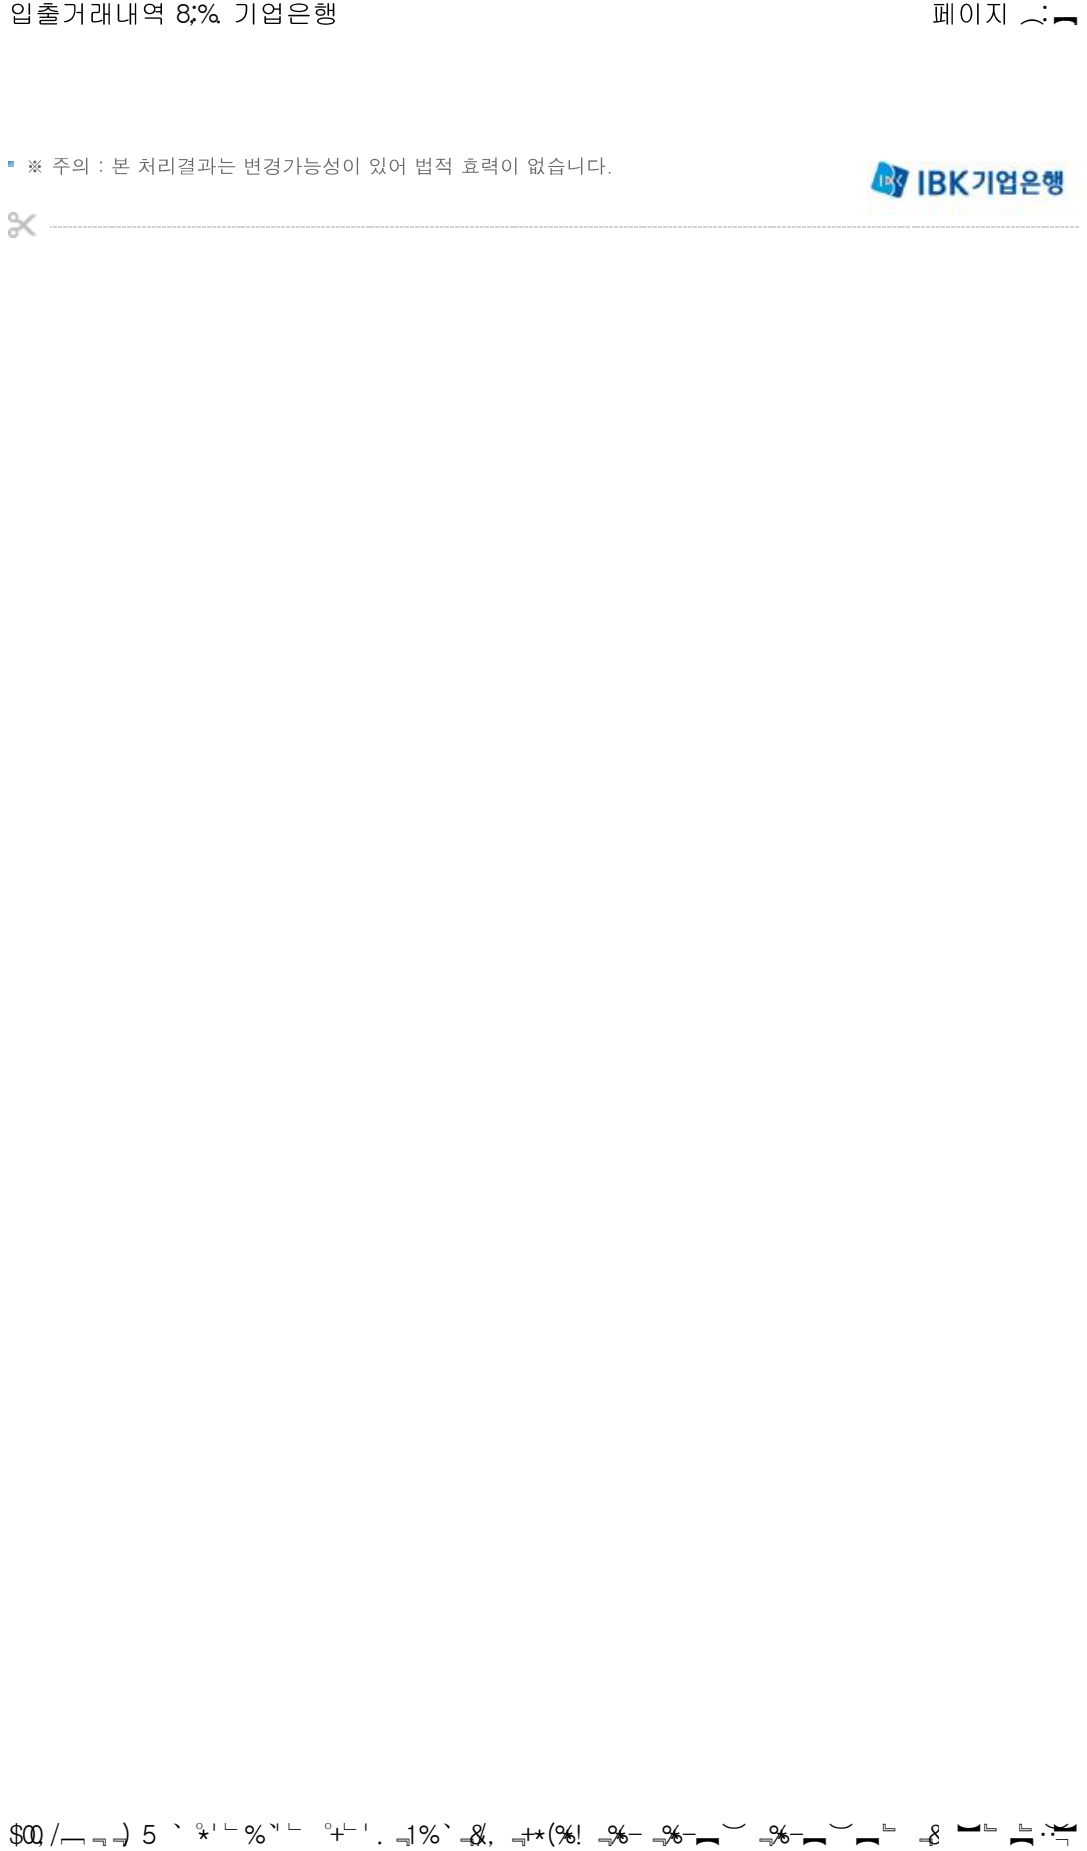
[picture p156: page 4]

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

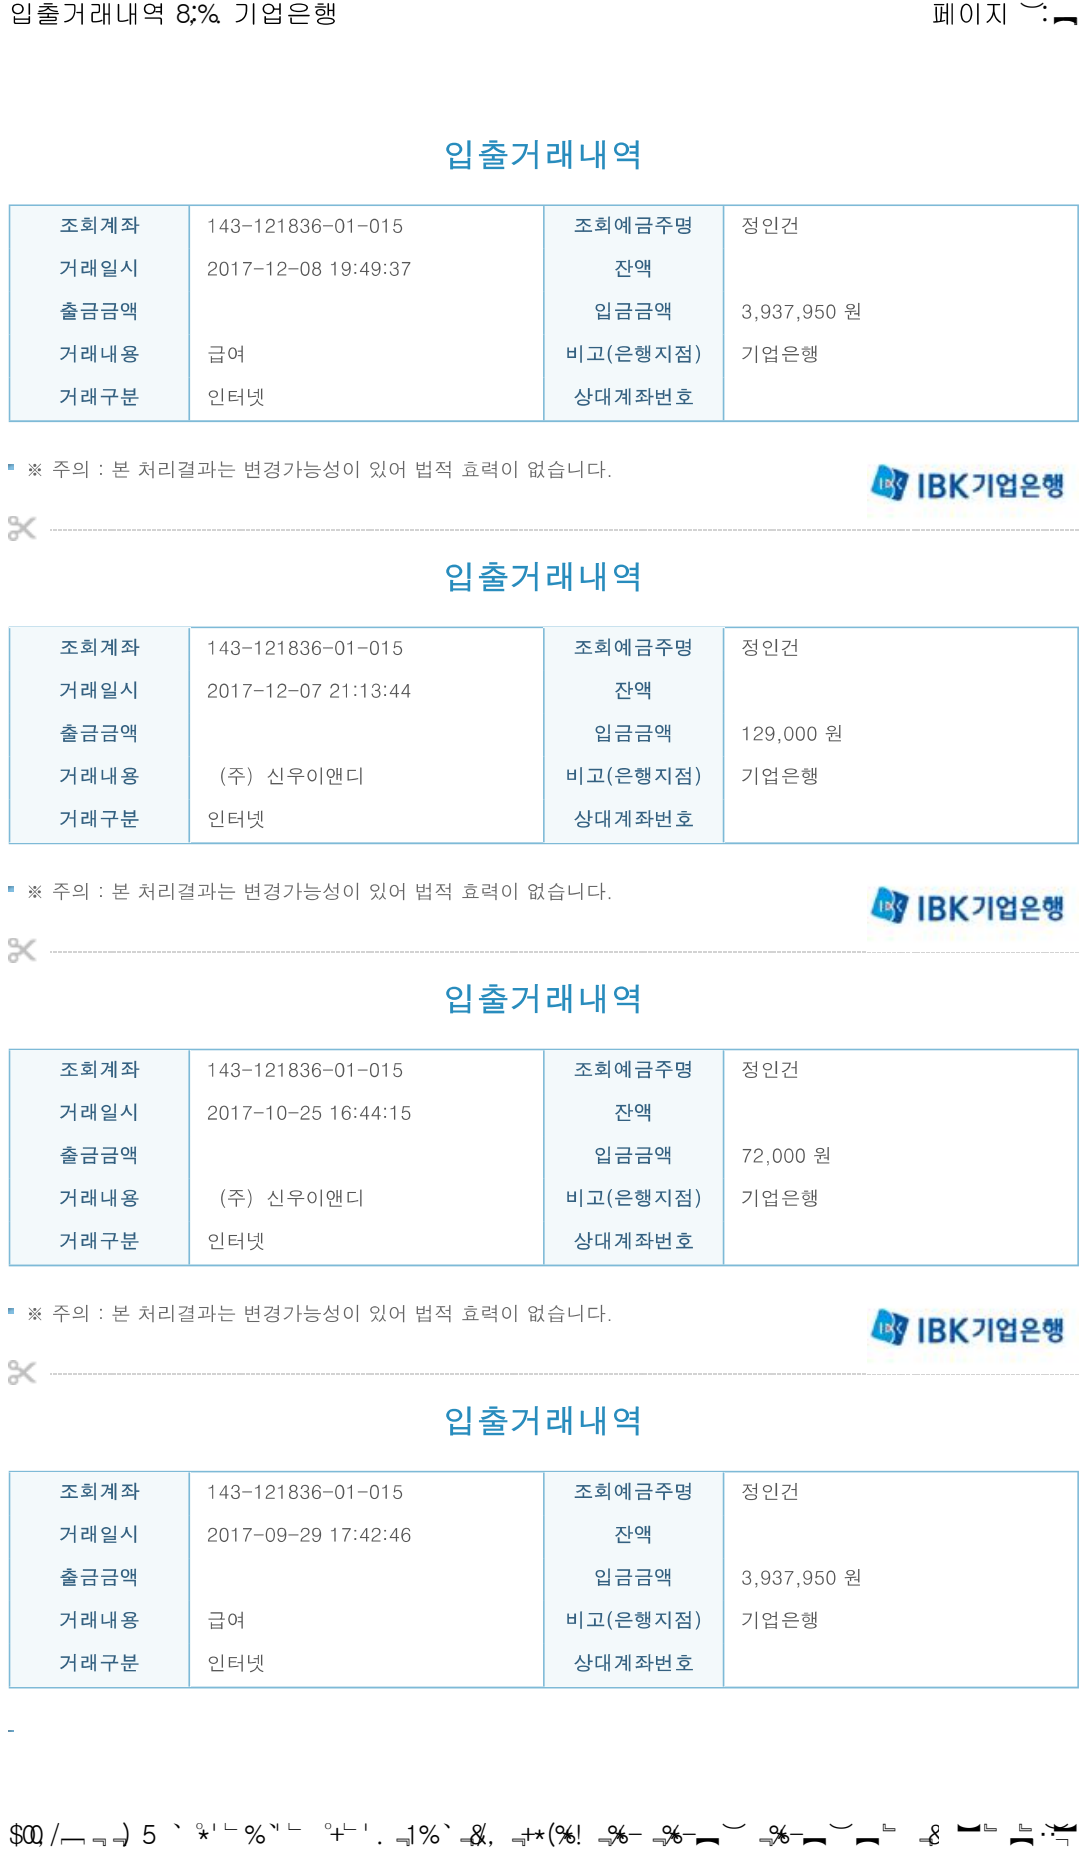
[picture p157: page 5]

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

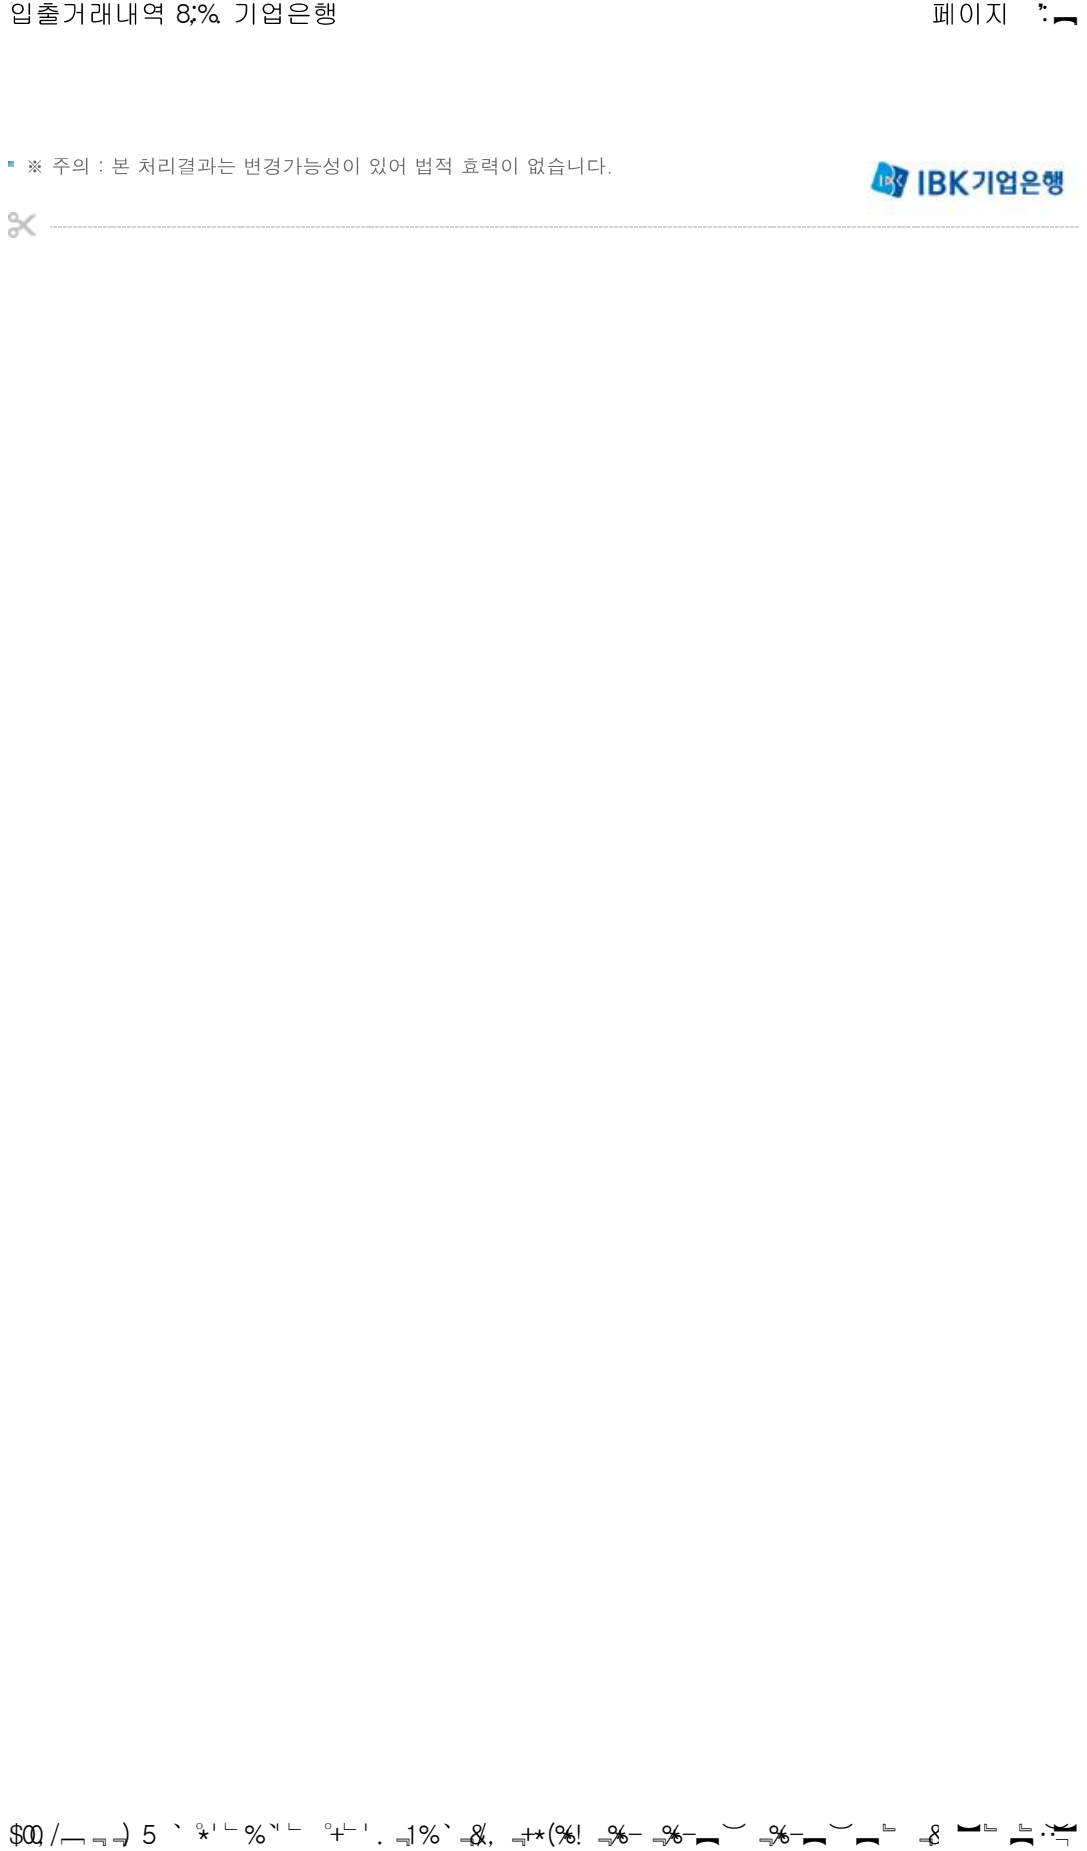
[picture p158: page 6]

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

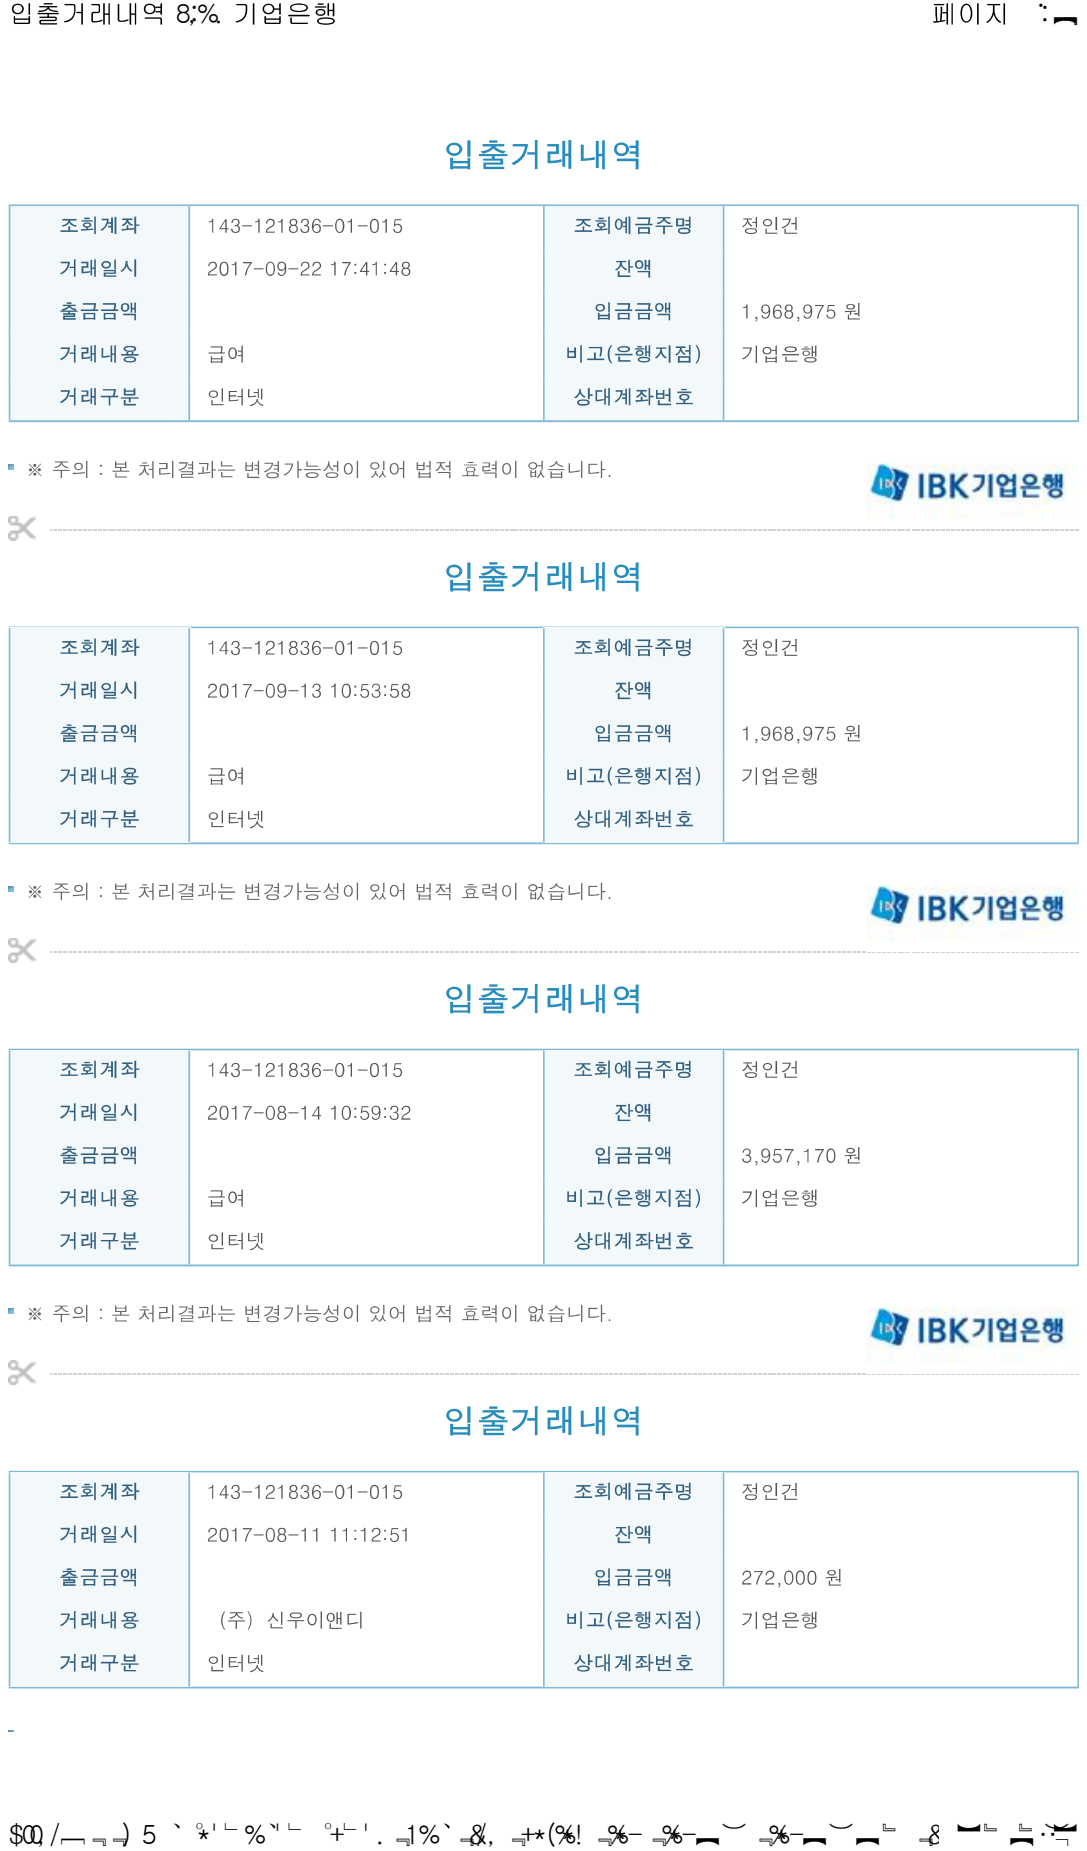
[picture p159: page 7]

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

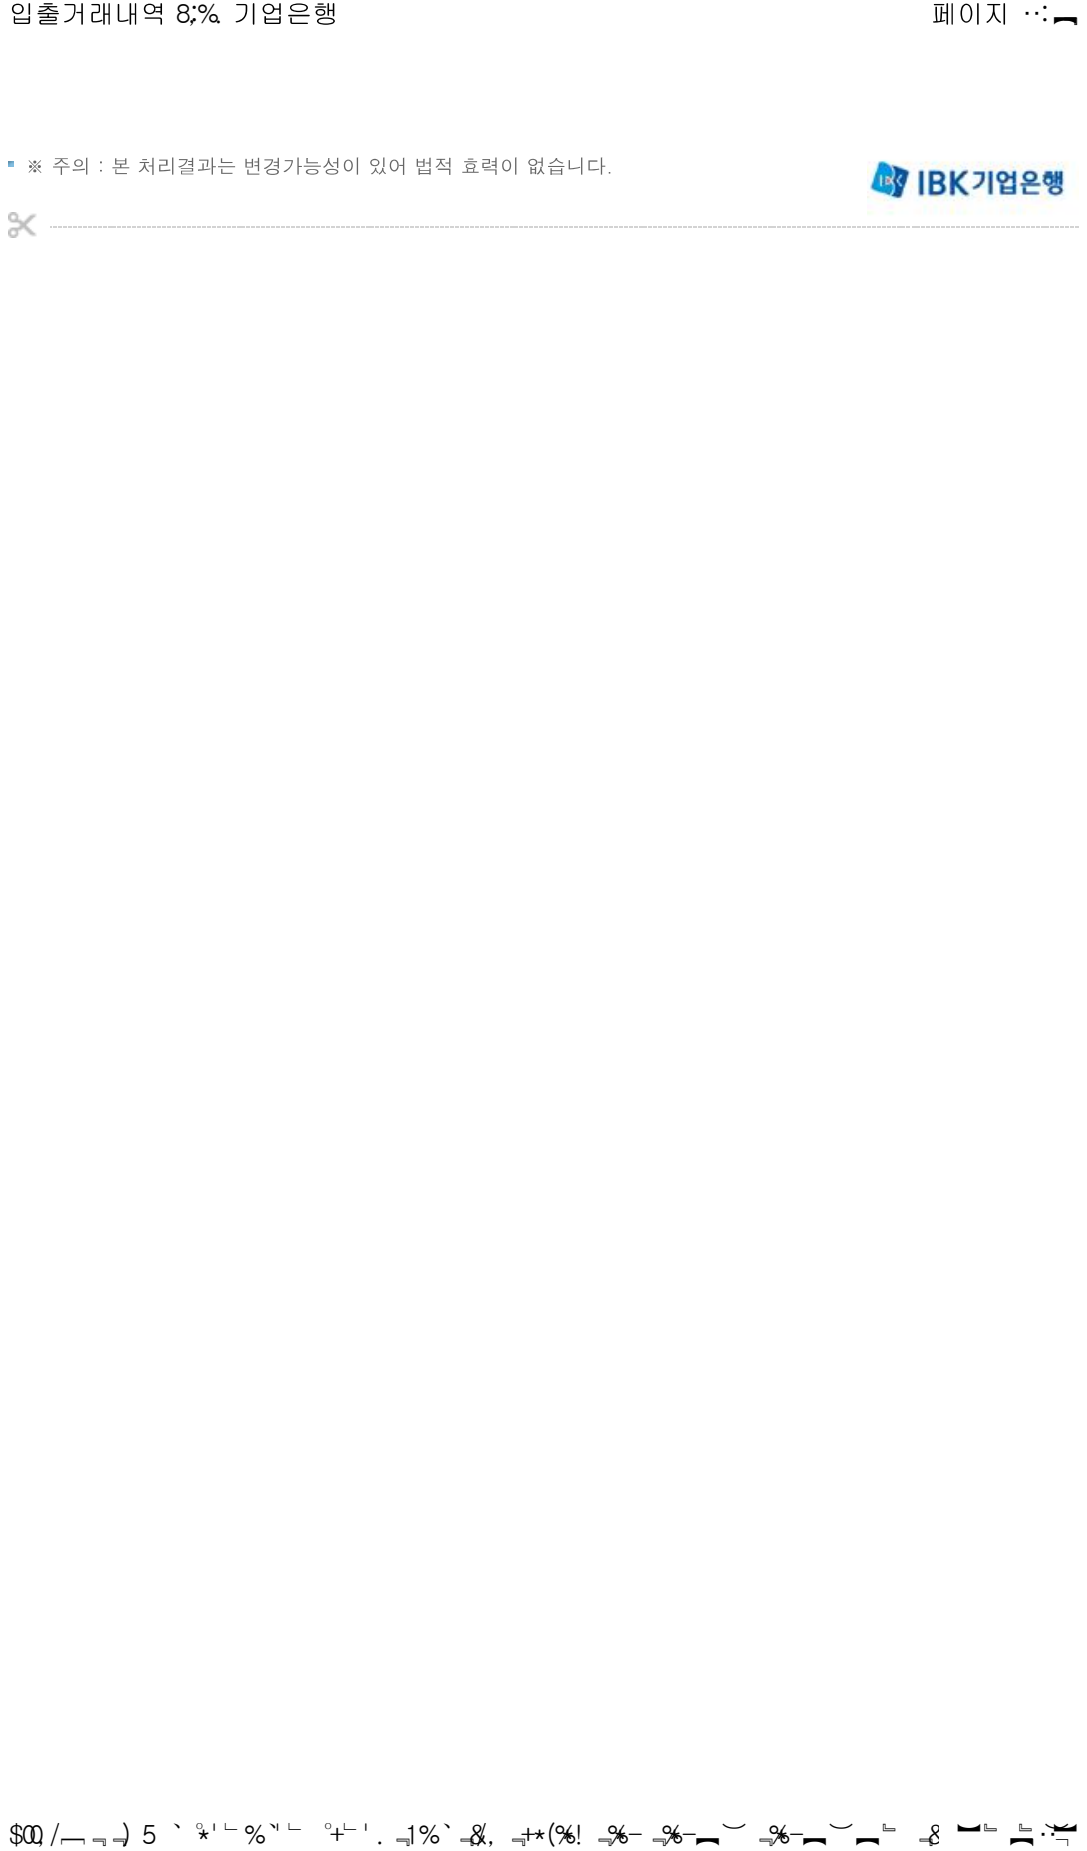
[picture p160: page 8]

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

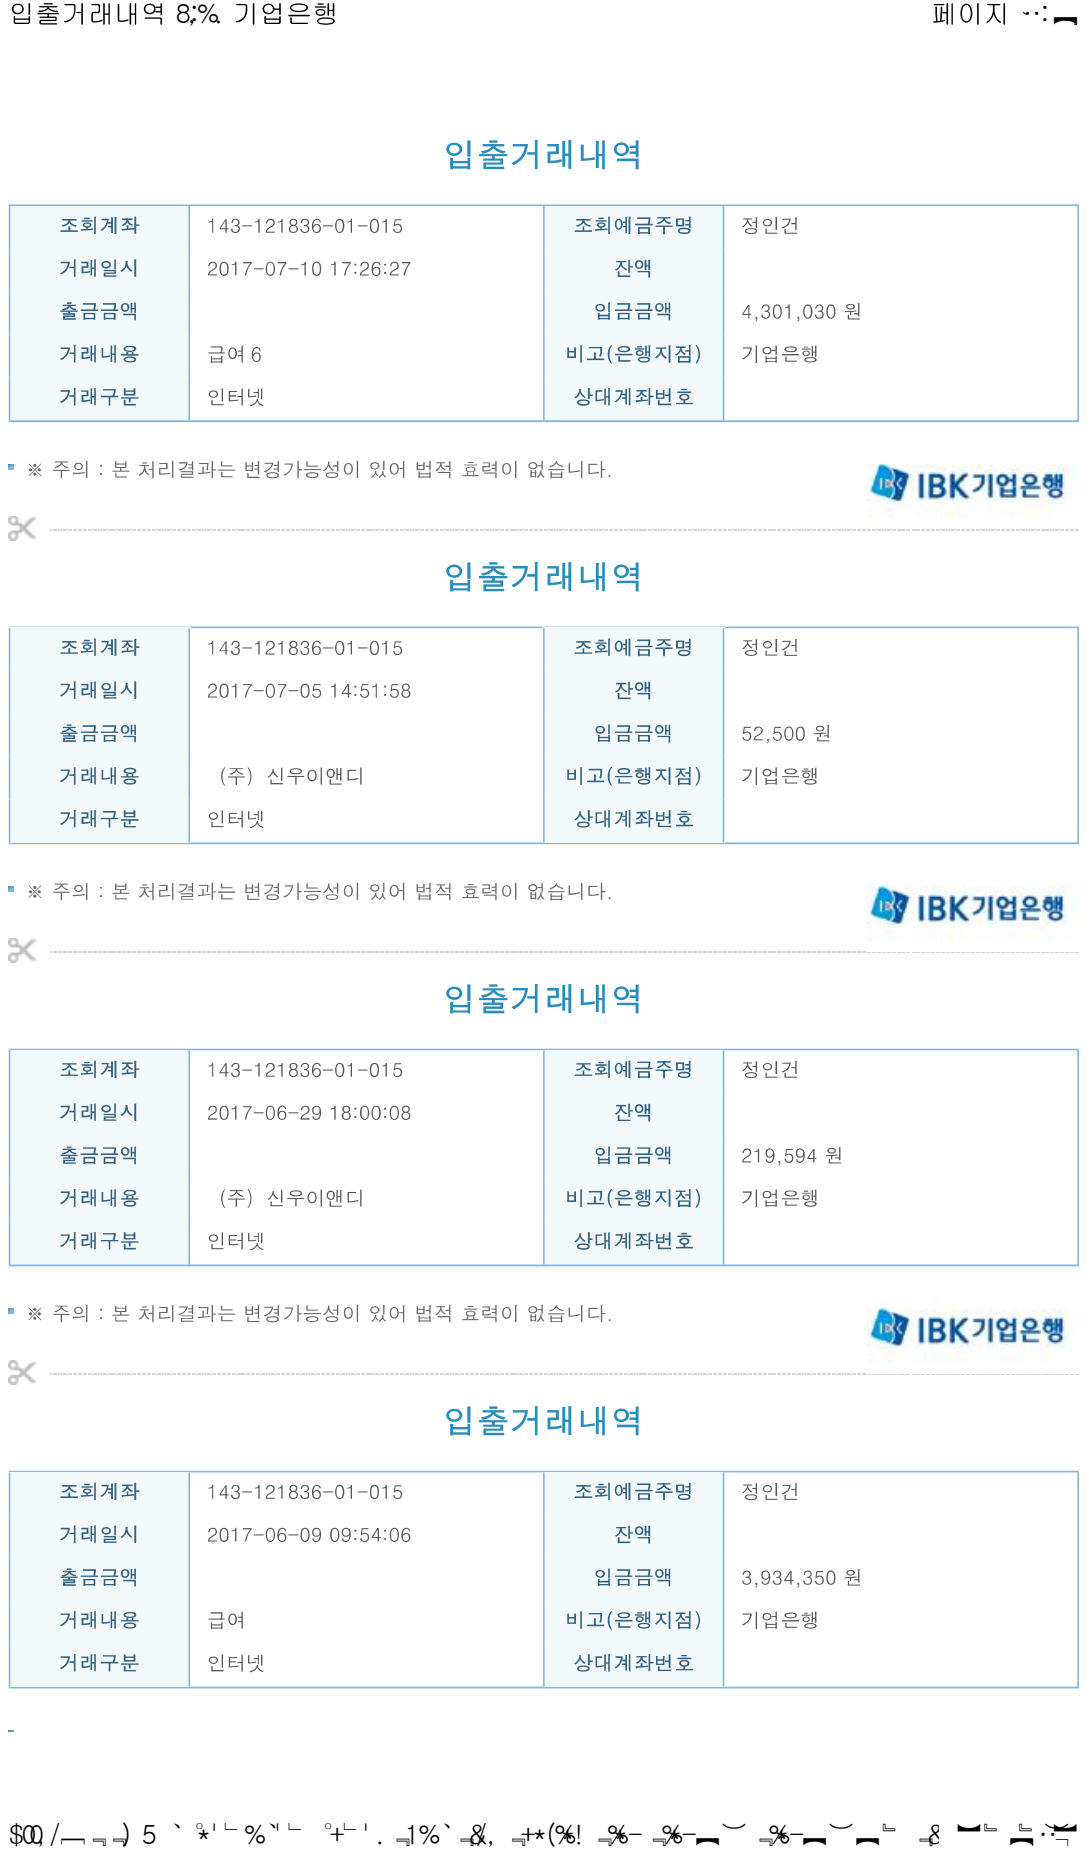
[picture p161: page 9]

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

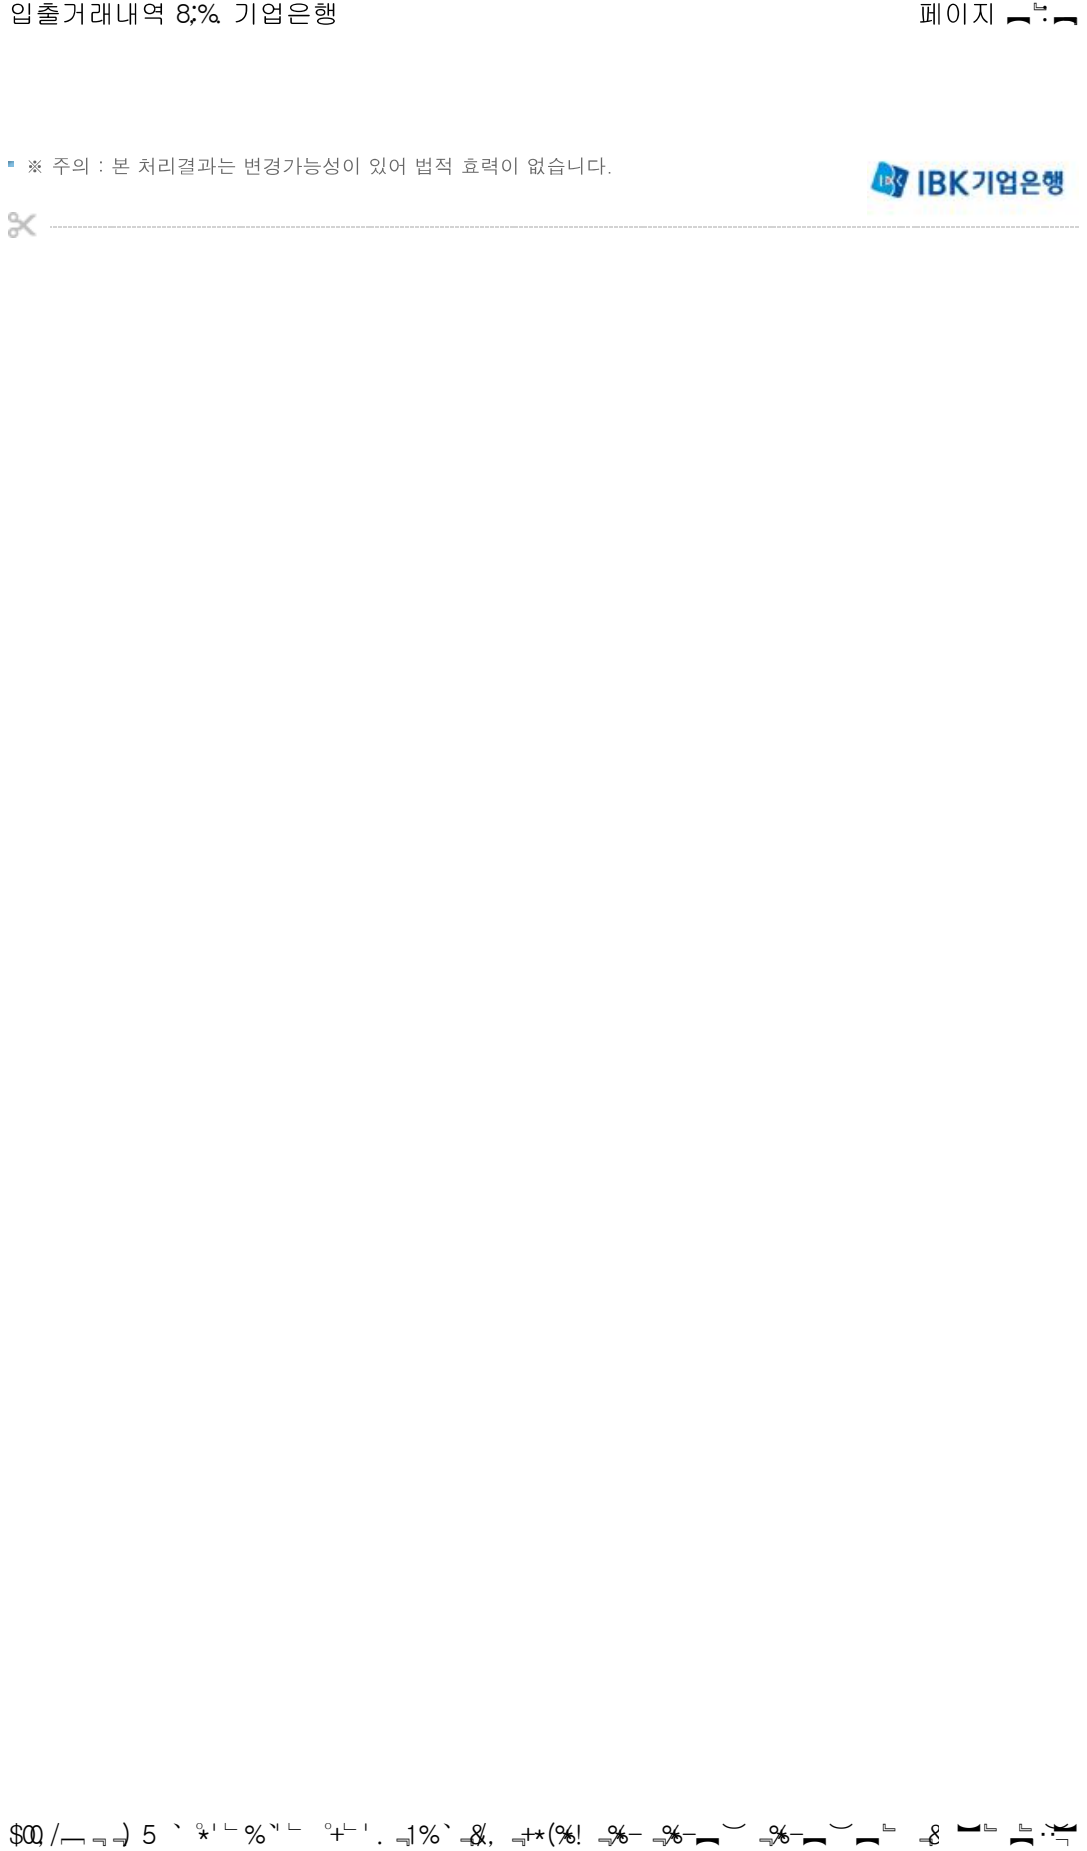
[picture p162: page 10]
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
