ArvidJoung/Plasma_Generator/퇴사자/대전노동청 임금체불 접수증.pdf

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

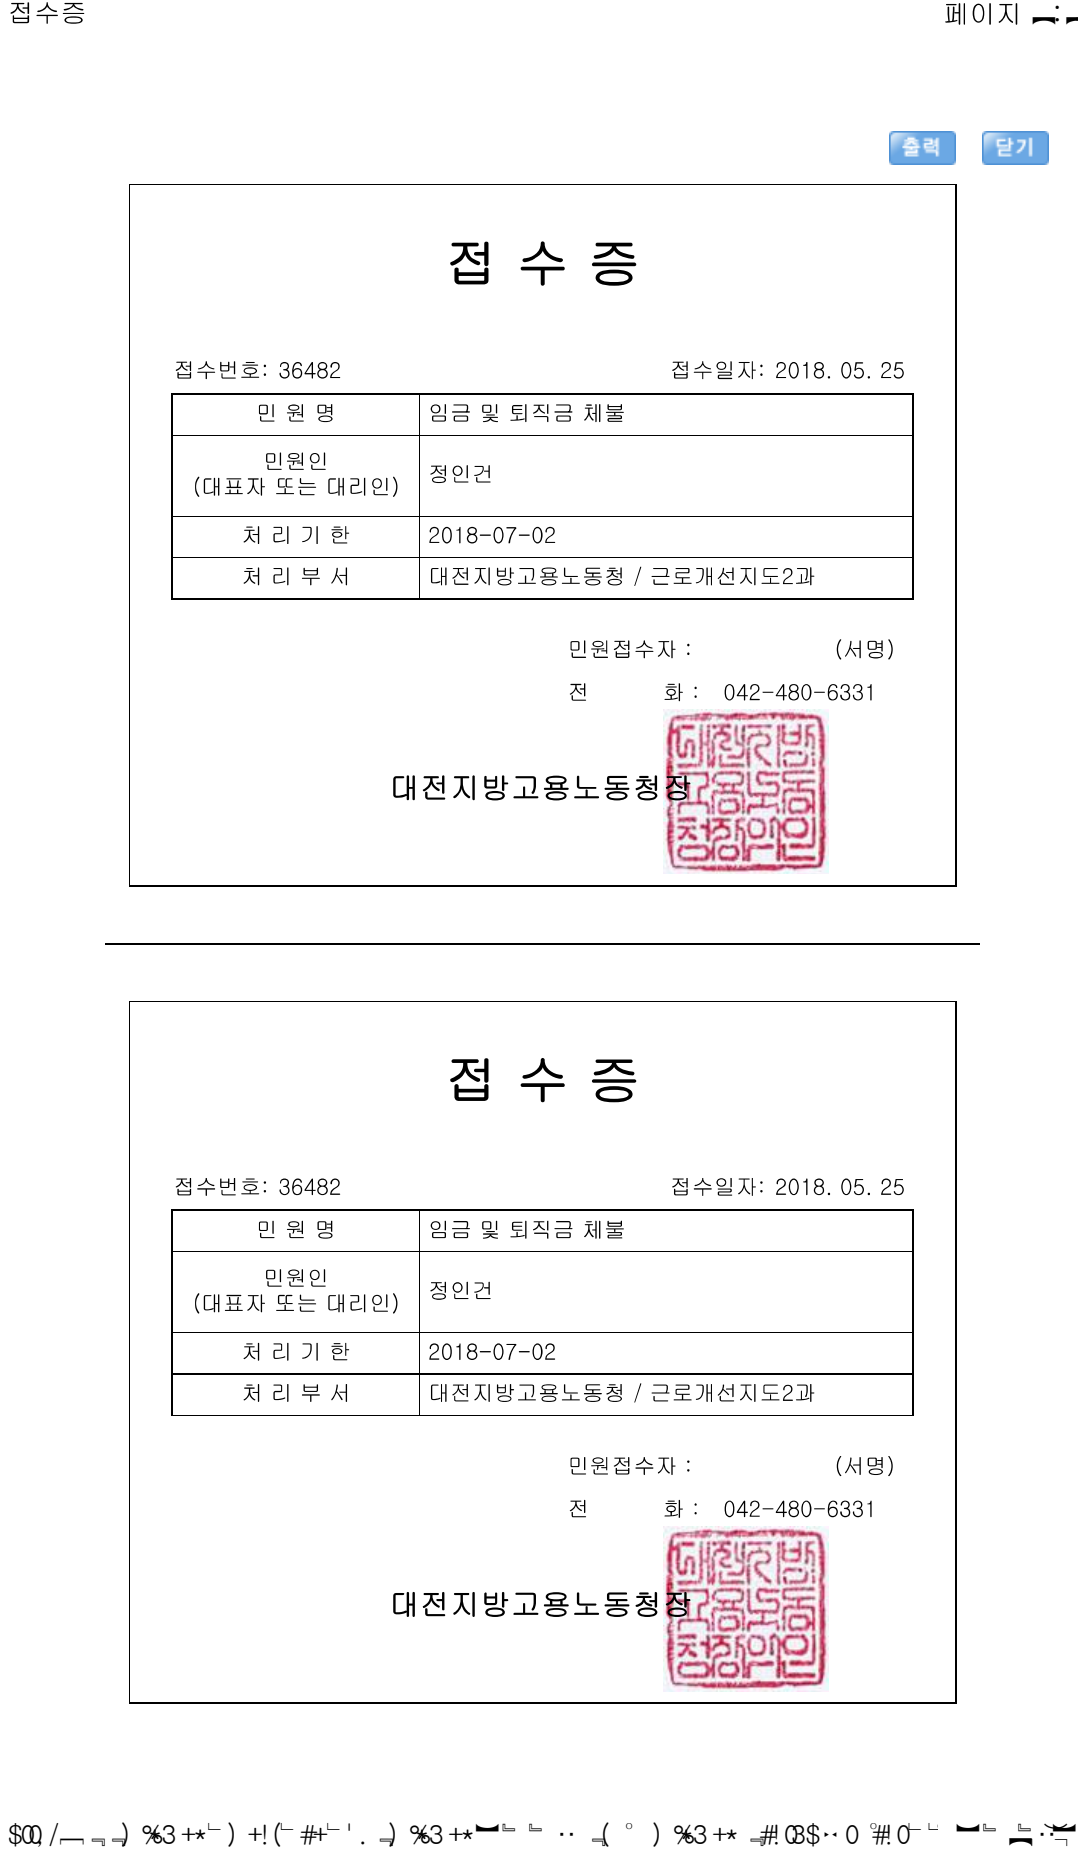
[picture p163: page 1]
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
