ArvidJoung/Plasma_Generator/0_MP2 Data/0_Data/CAM output.pdf

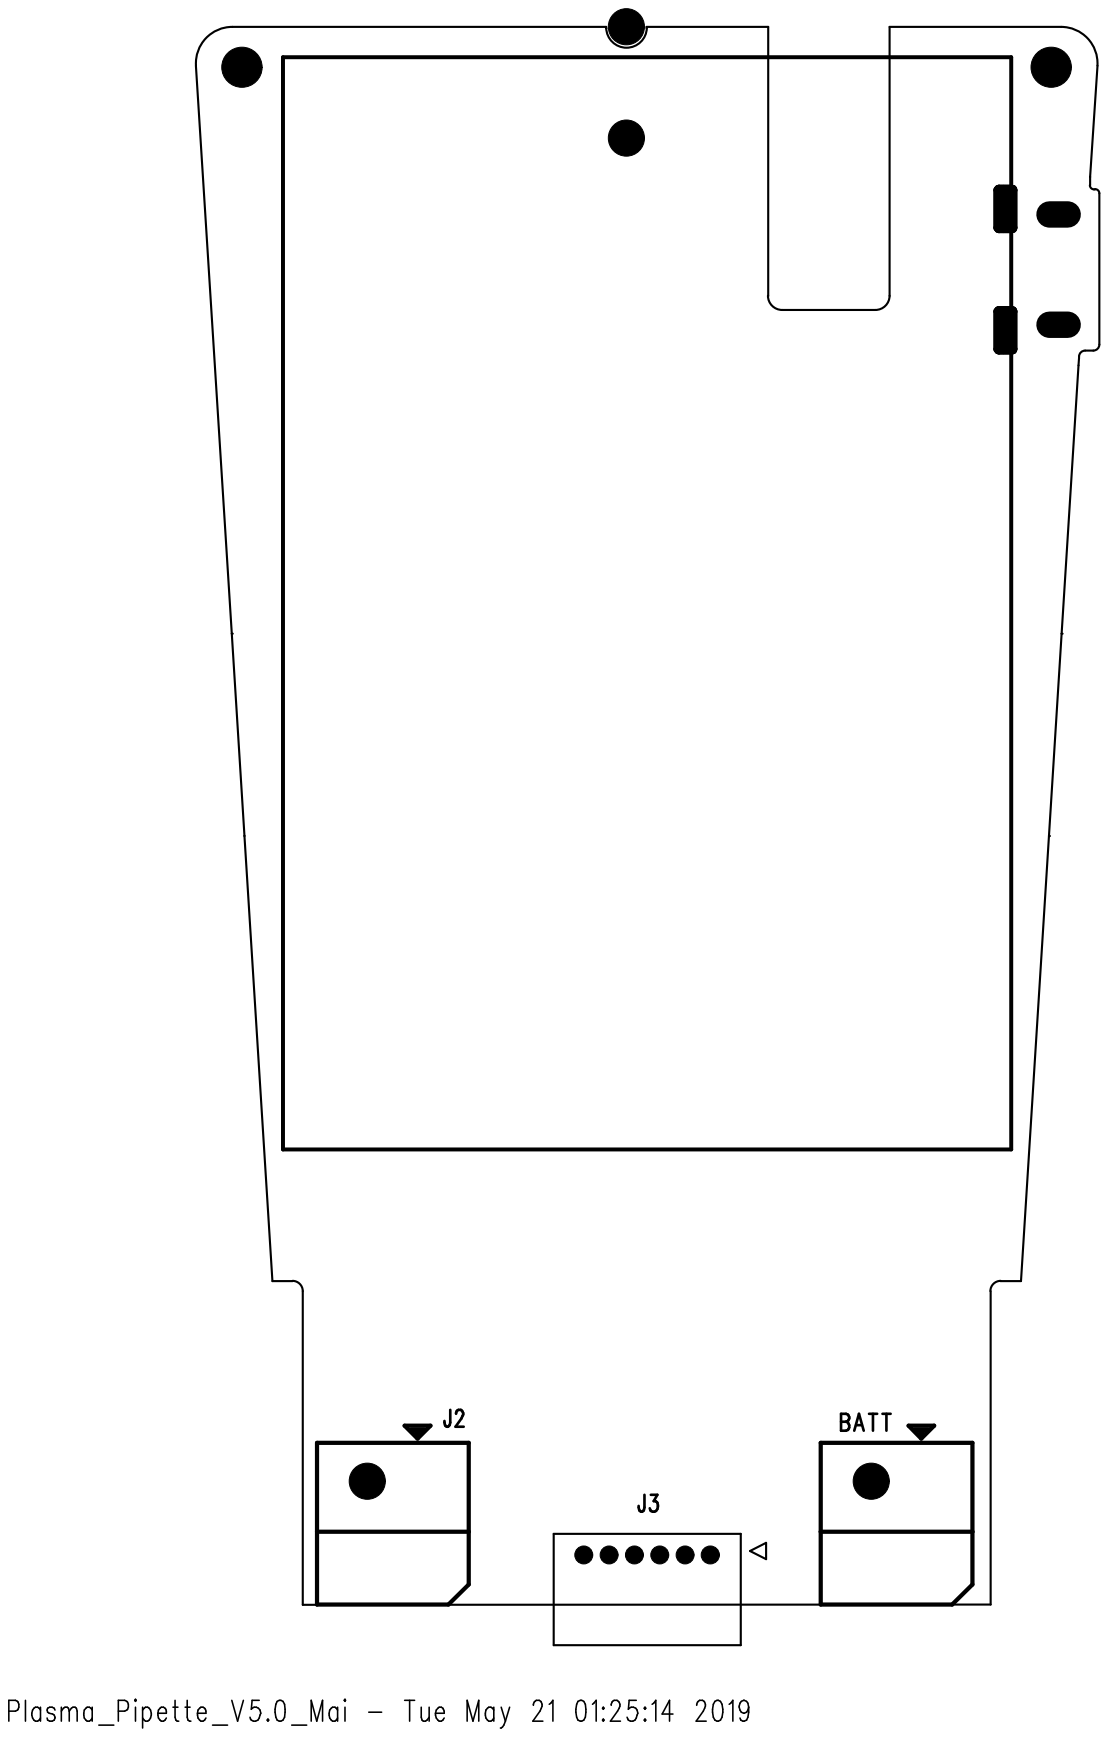
[picture p164: page 1]
