ArvidJoung/Plasma_Generator/0_DOC/20190224_Femto 과제용 자료/Plasma_Pipette_Transformer_Gerber_TOP.pdf

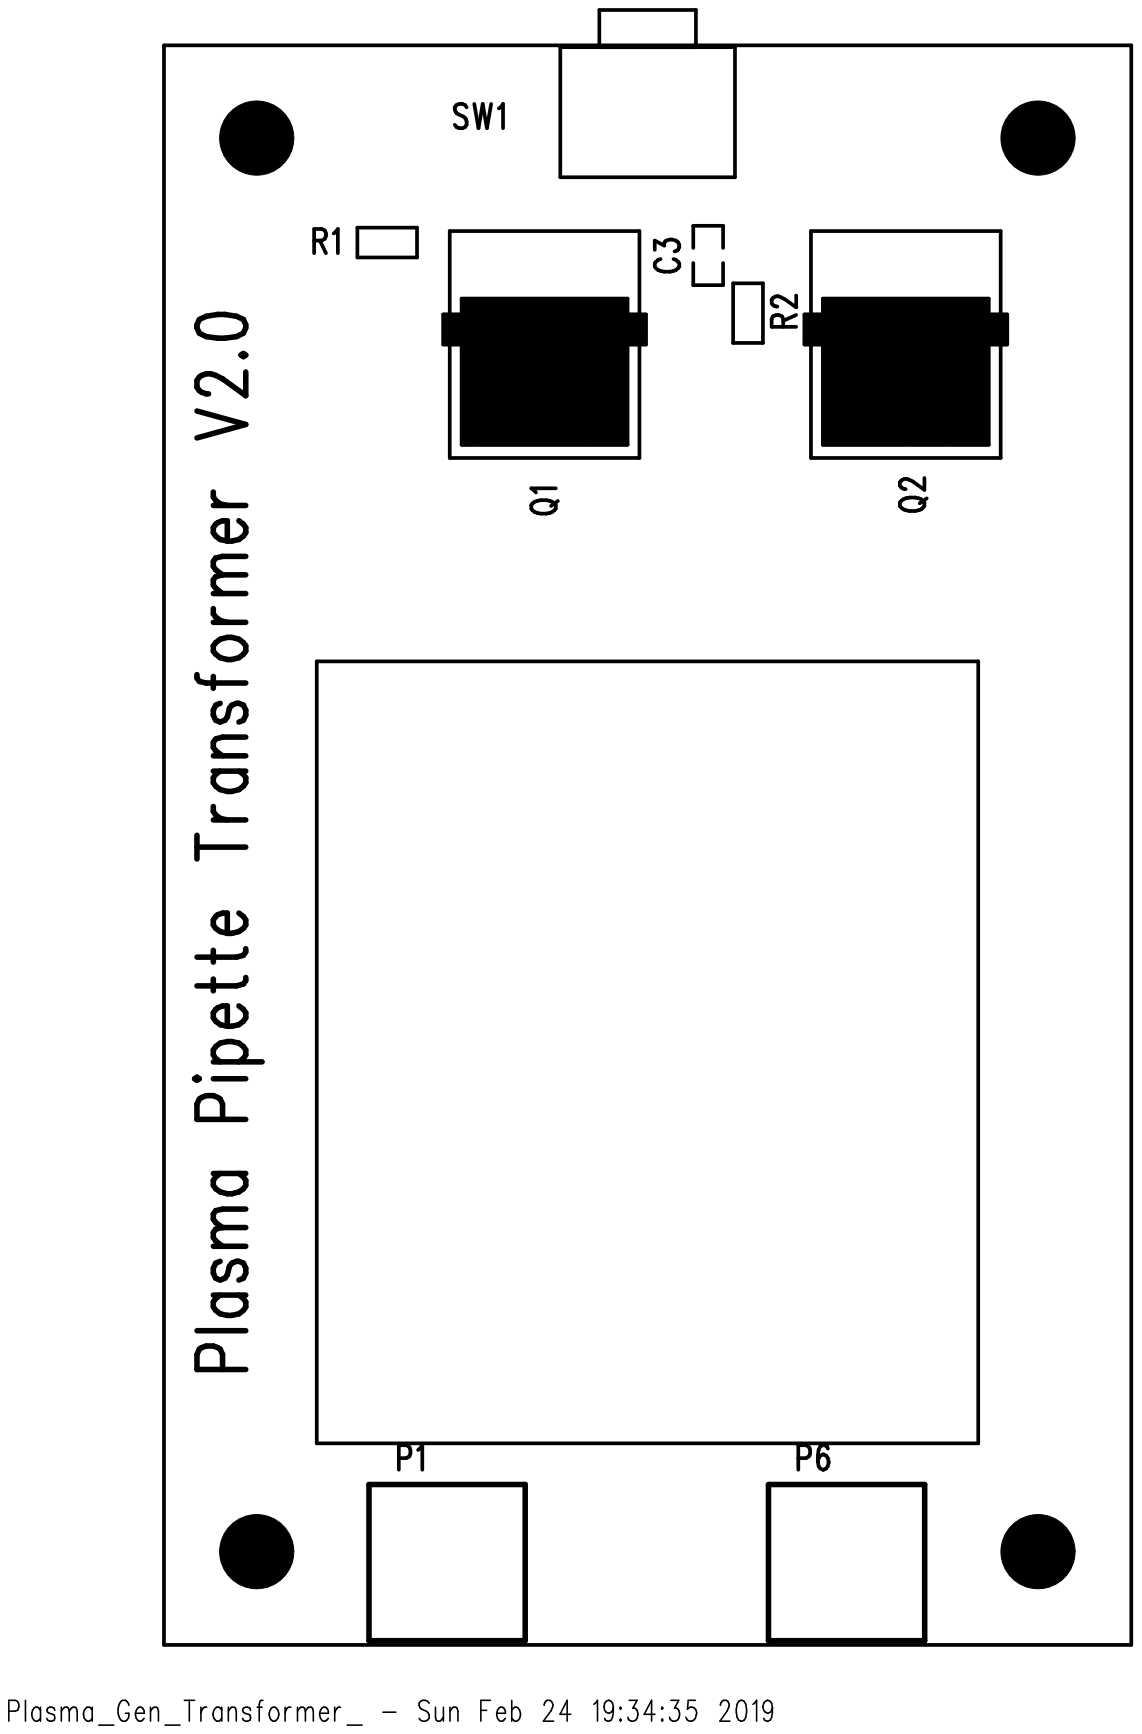
[picture p166: page 1]
