ArvidJoung/Plasma_Generator/0_DOC/20190224_Femto 과제용 자료/Plasma_Pipette_V2.0_Gerber_Bottom.pdf

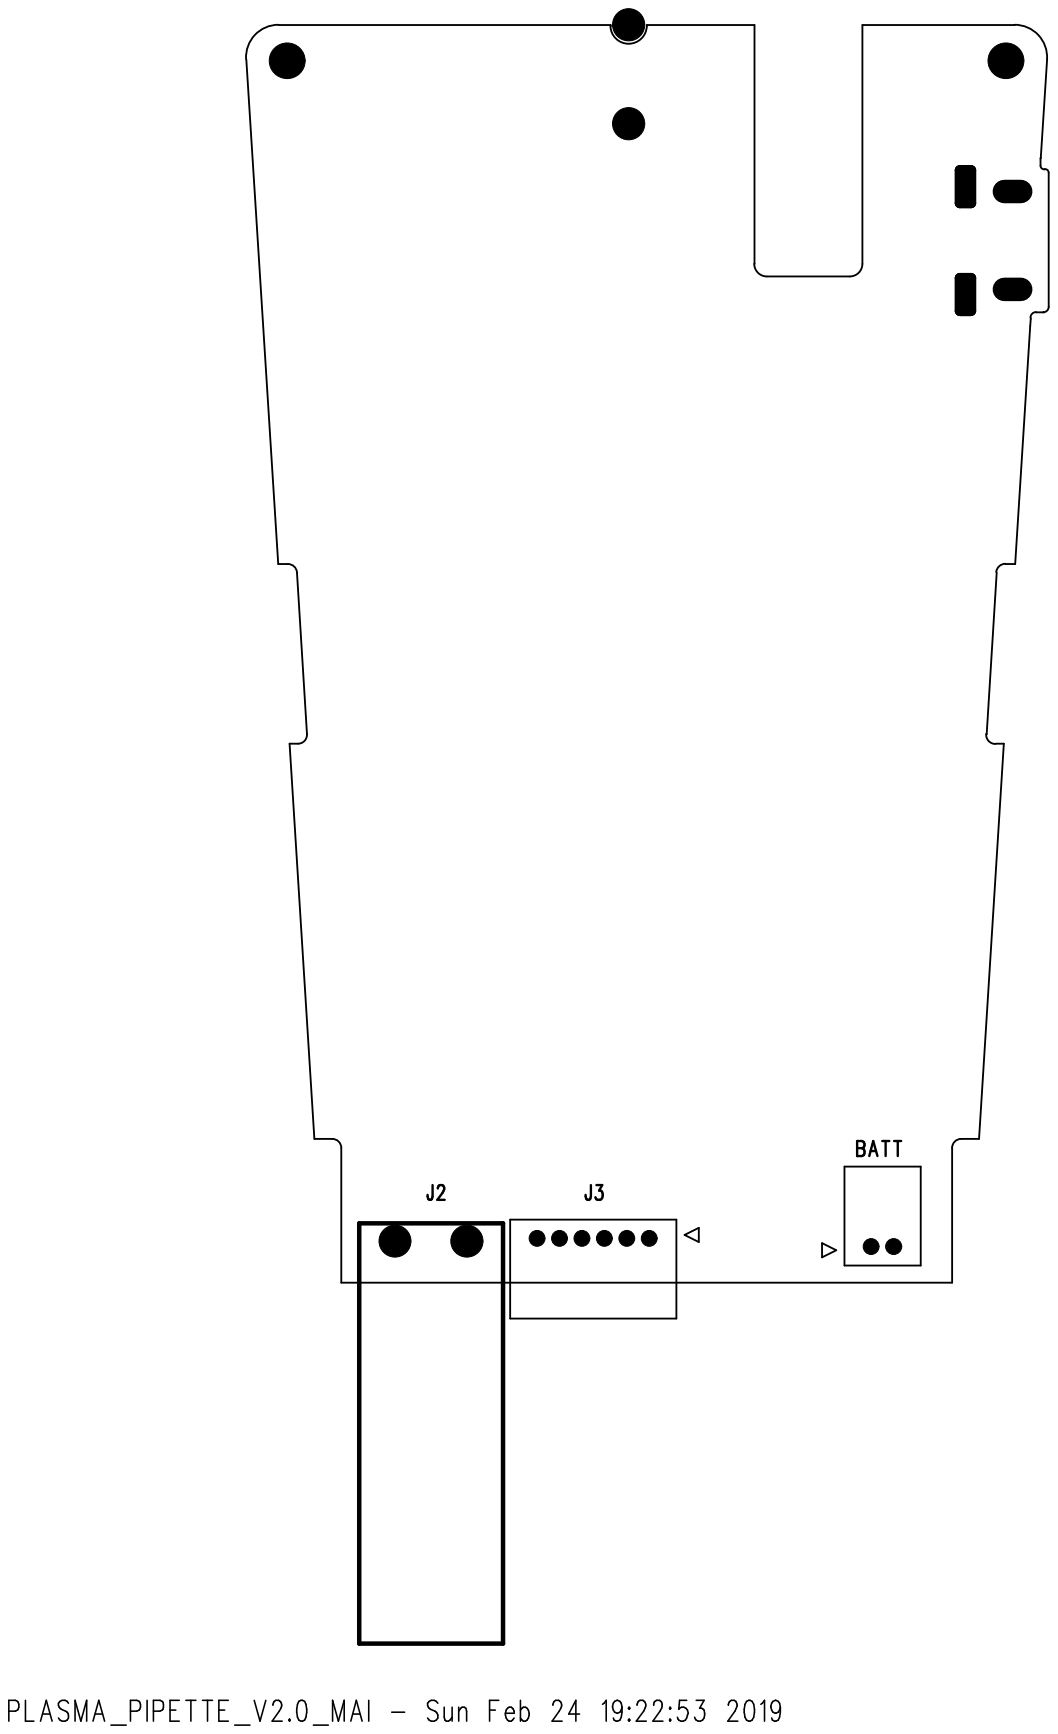
[picture p167: page 1]
