ArvidJoung/Plasma_Generator/2_Micro_Plasma_Dispenser/1_Schematic/Build V1.0/01_MPD_Main PCB V1.0/MPD-MAIN_SCH_V1.0_20190807.pdf

# MCU Schematic

# System Reset

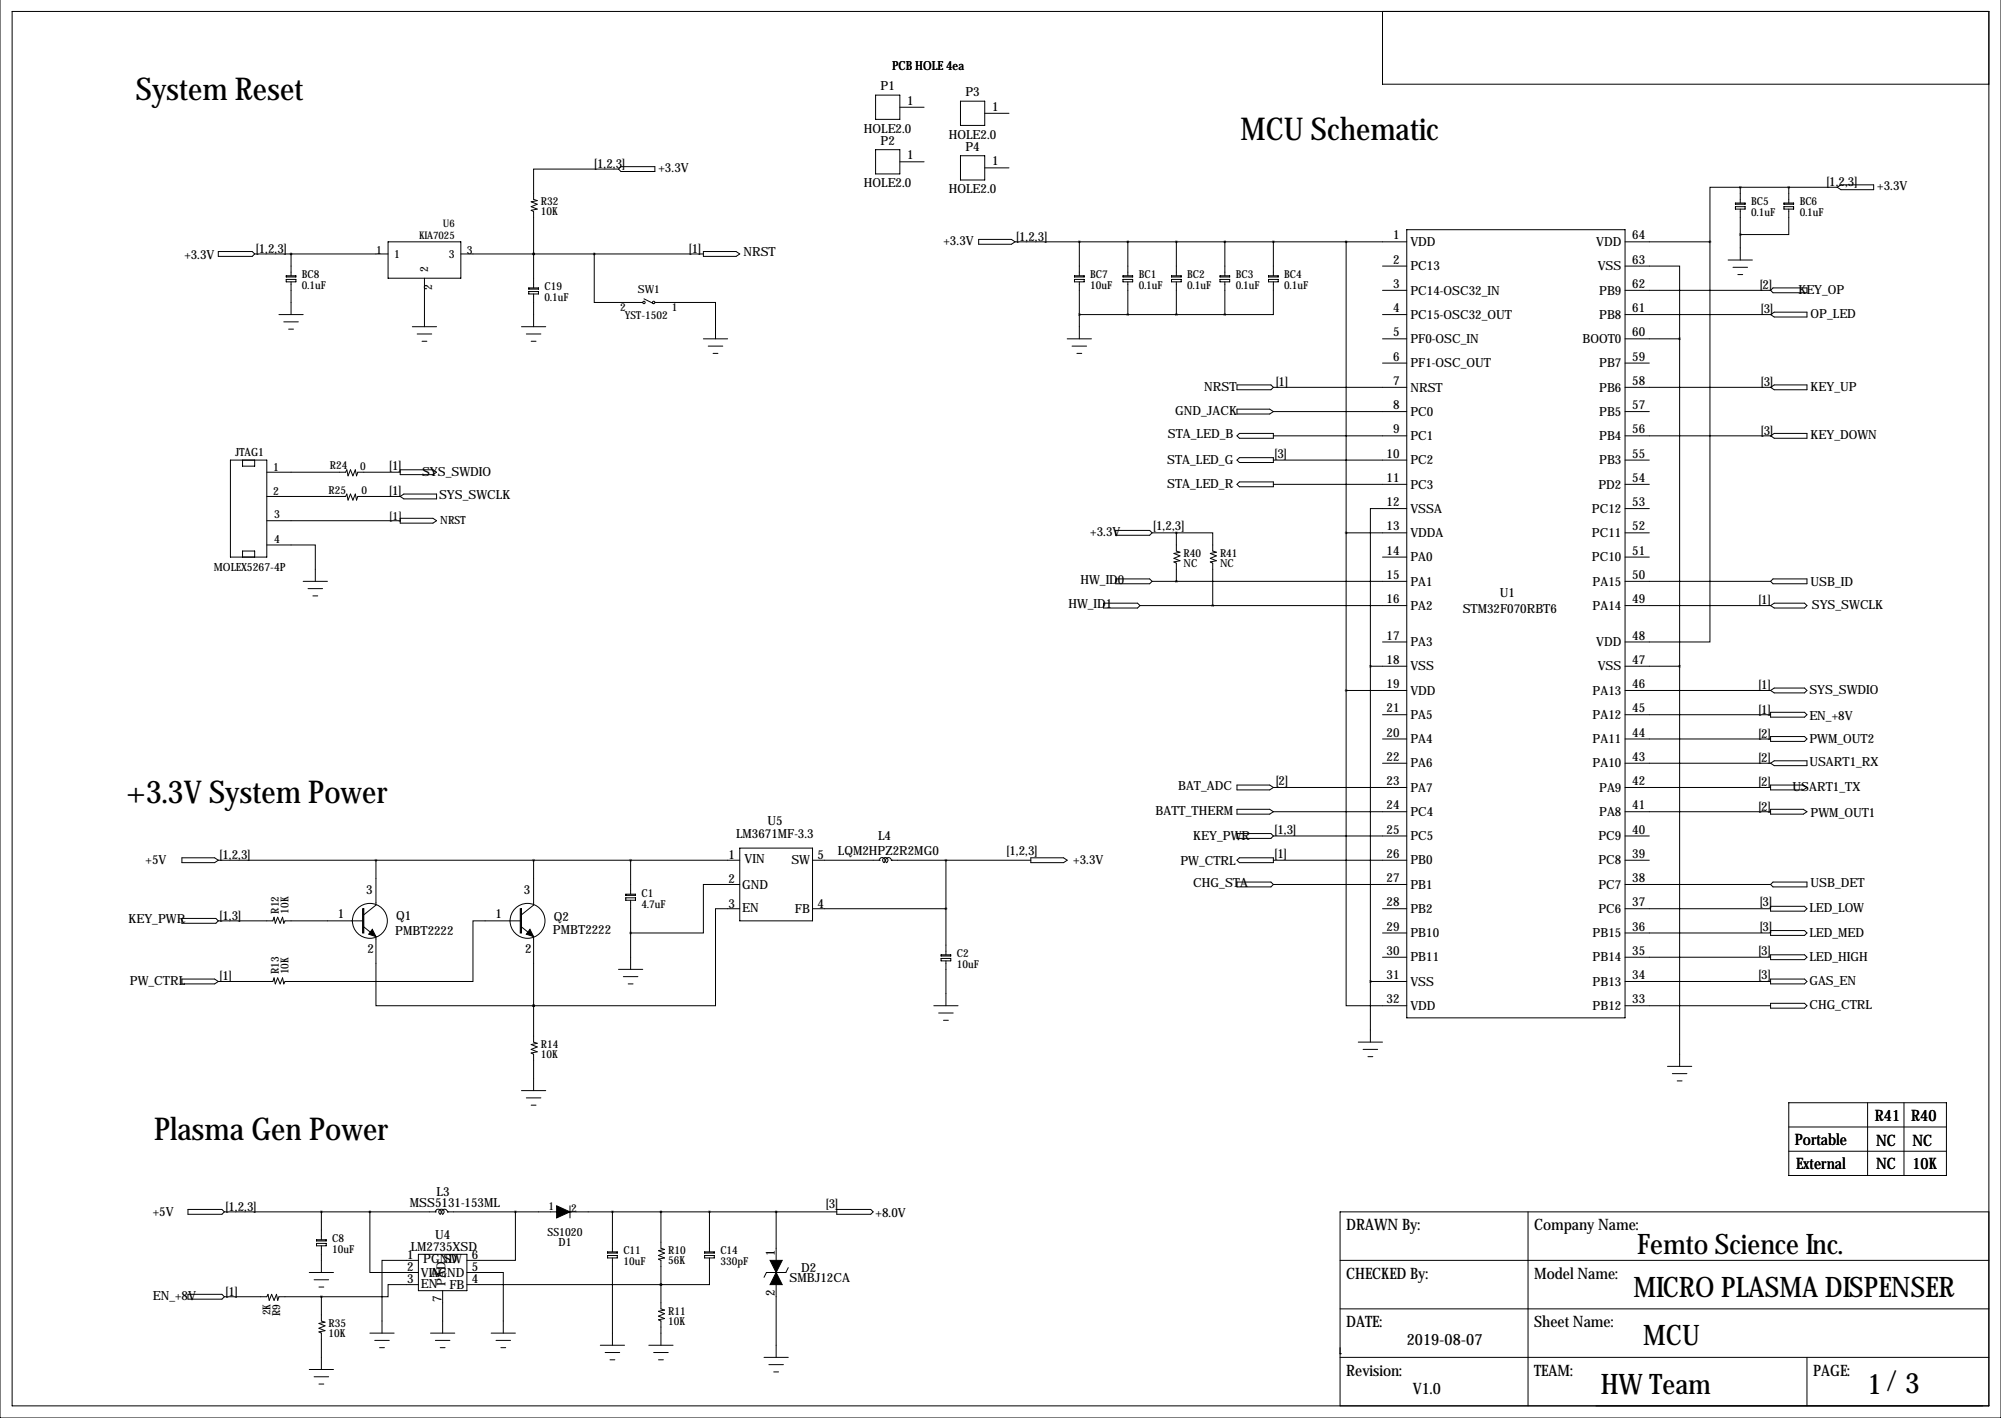
[picture p169: page 1]

Portable | NC NC | NC NC
External | NC NC | 10K

# RS-232 Interface

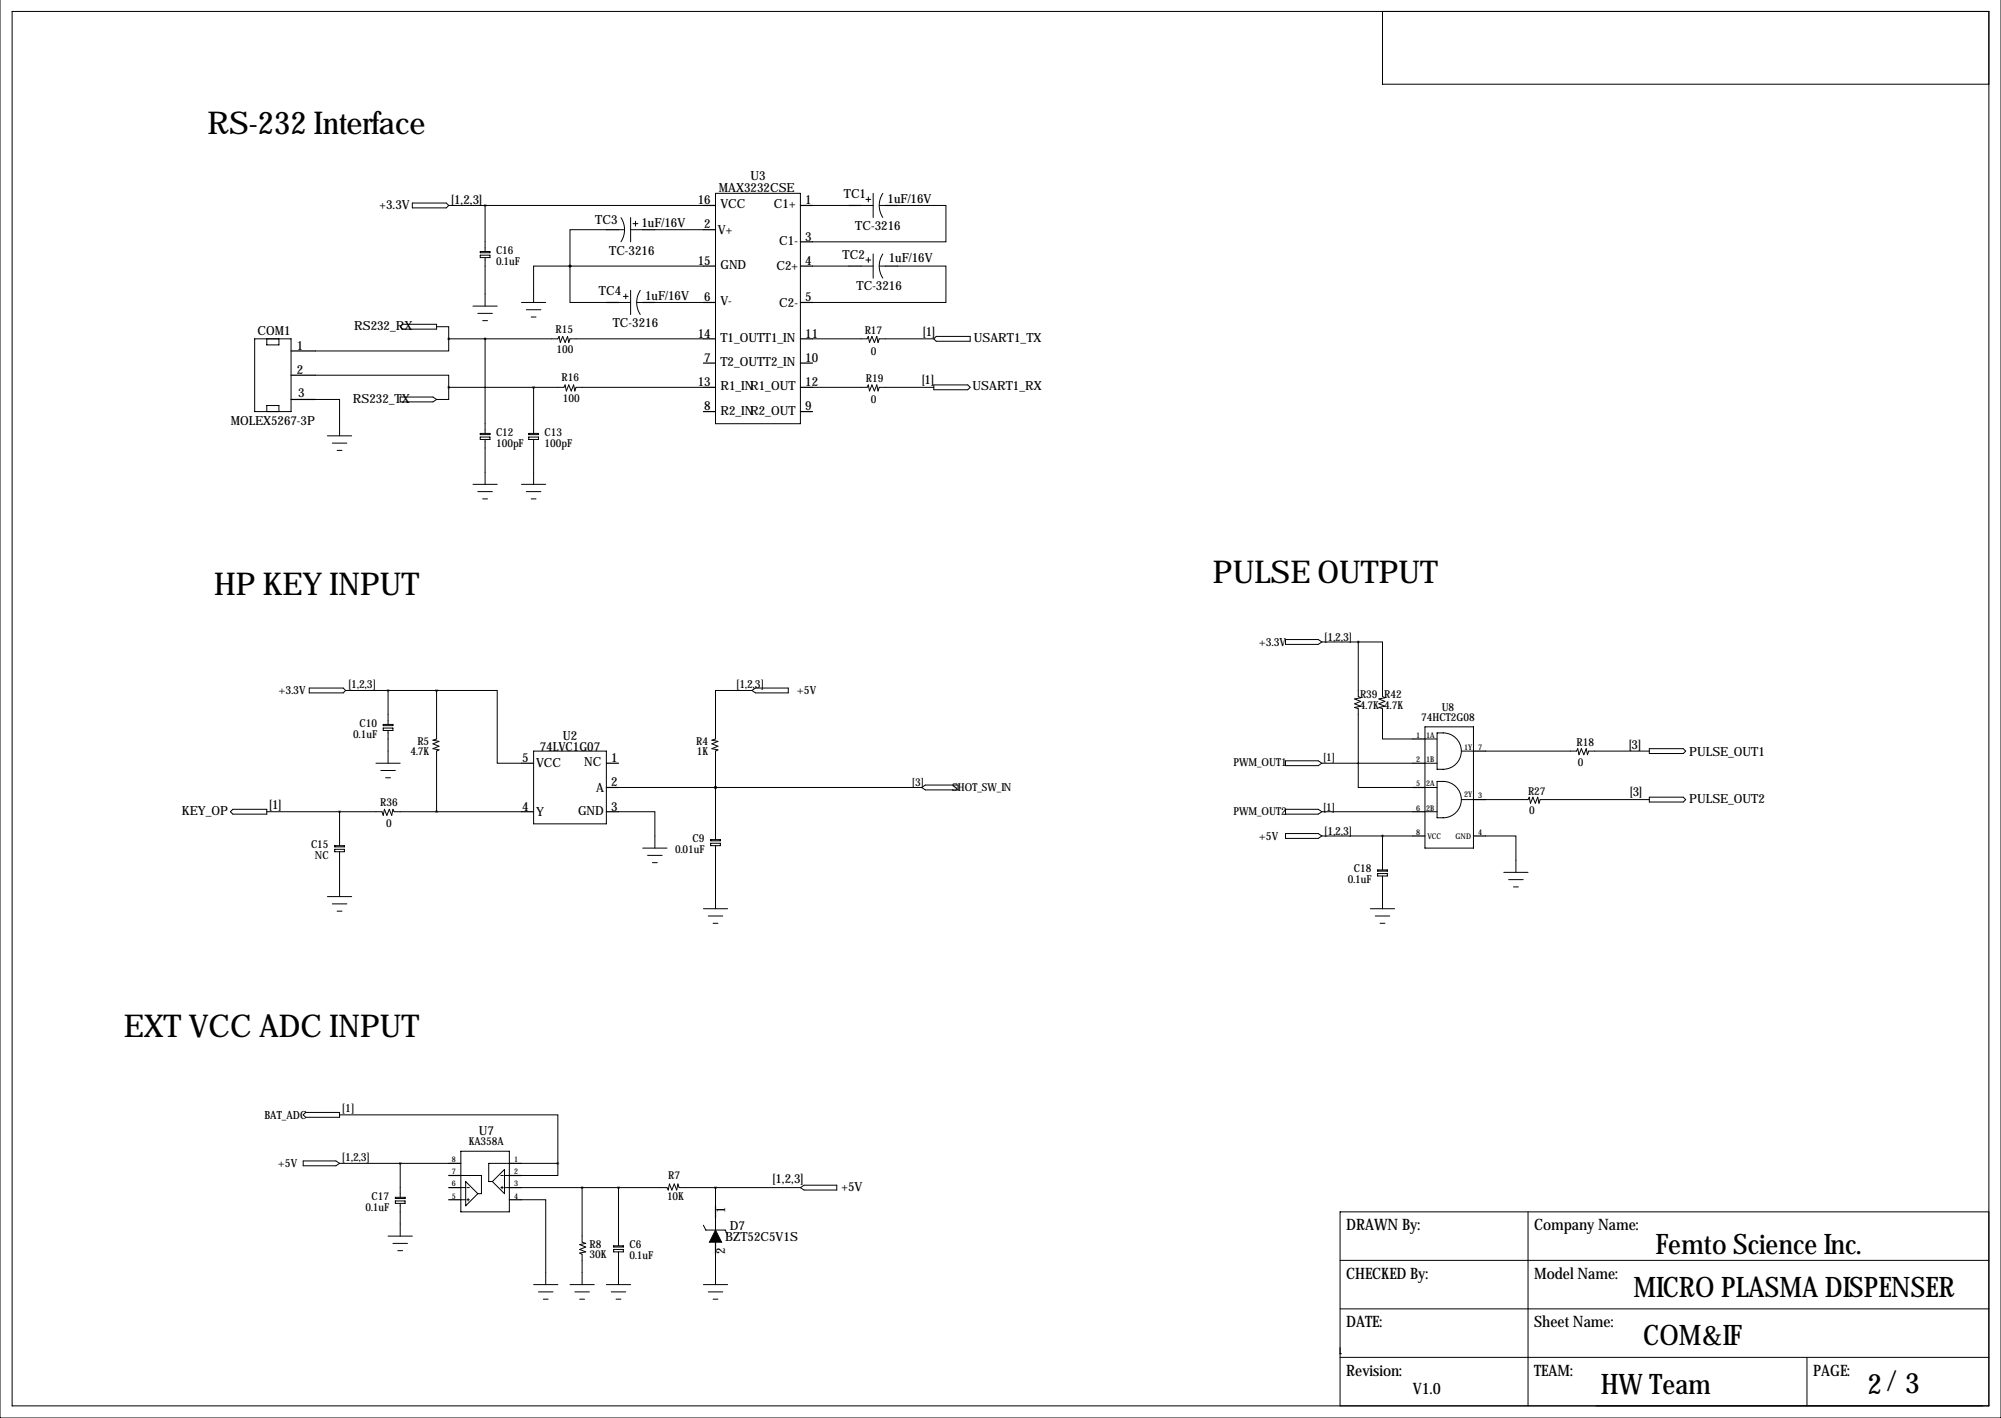
[picture p170: page 2]

EXT VCC ADC INPUT

+5V DC Adaptor | Transformer CON

# FOOT S/W CON

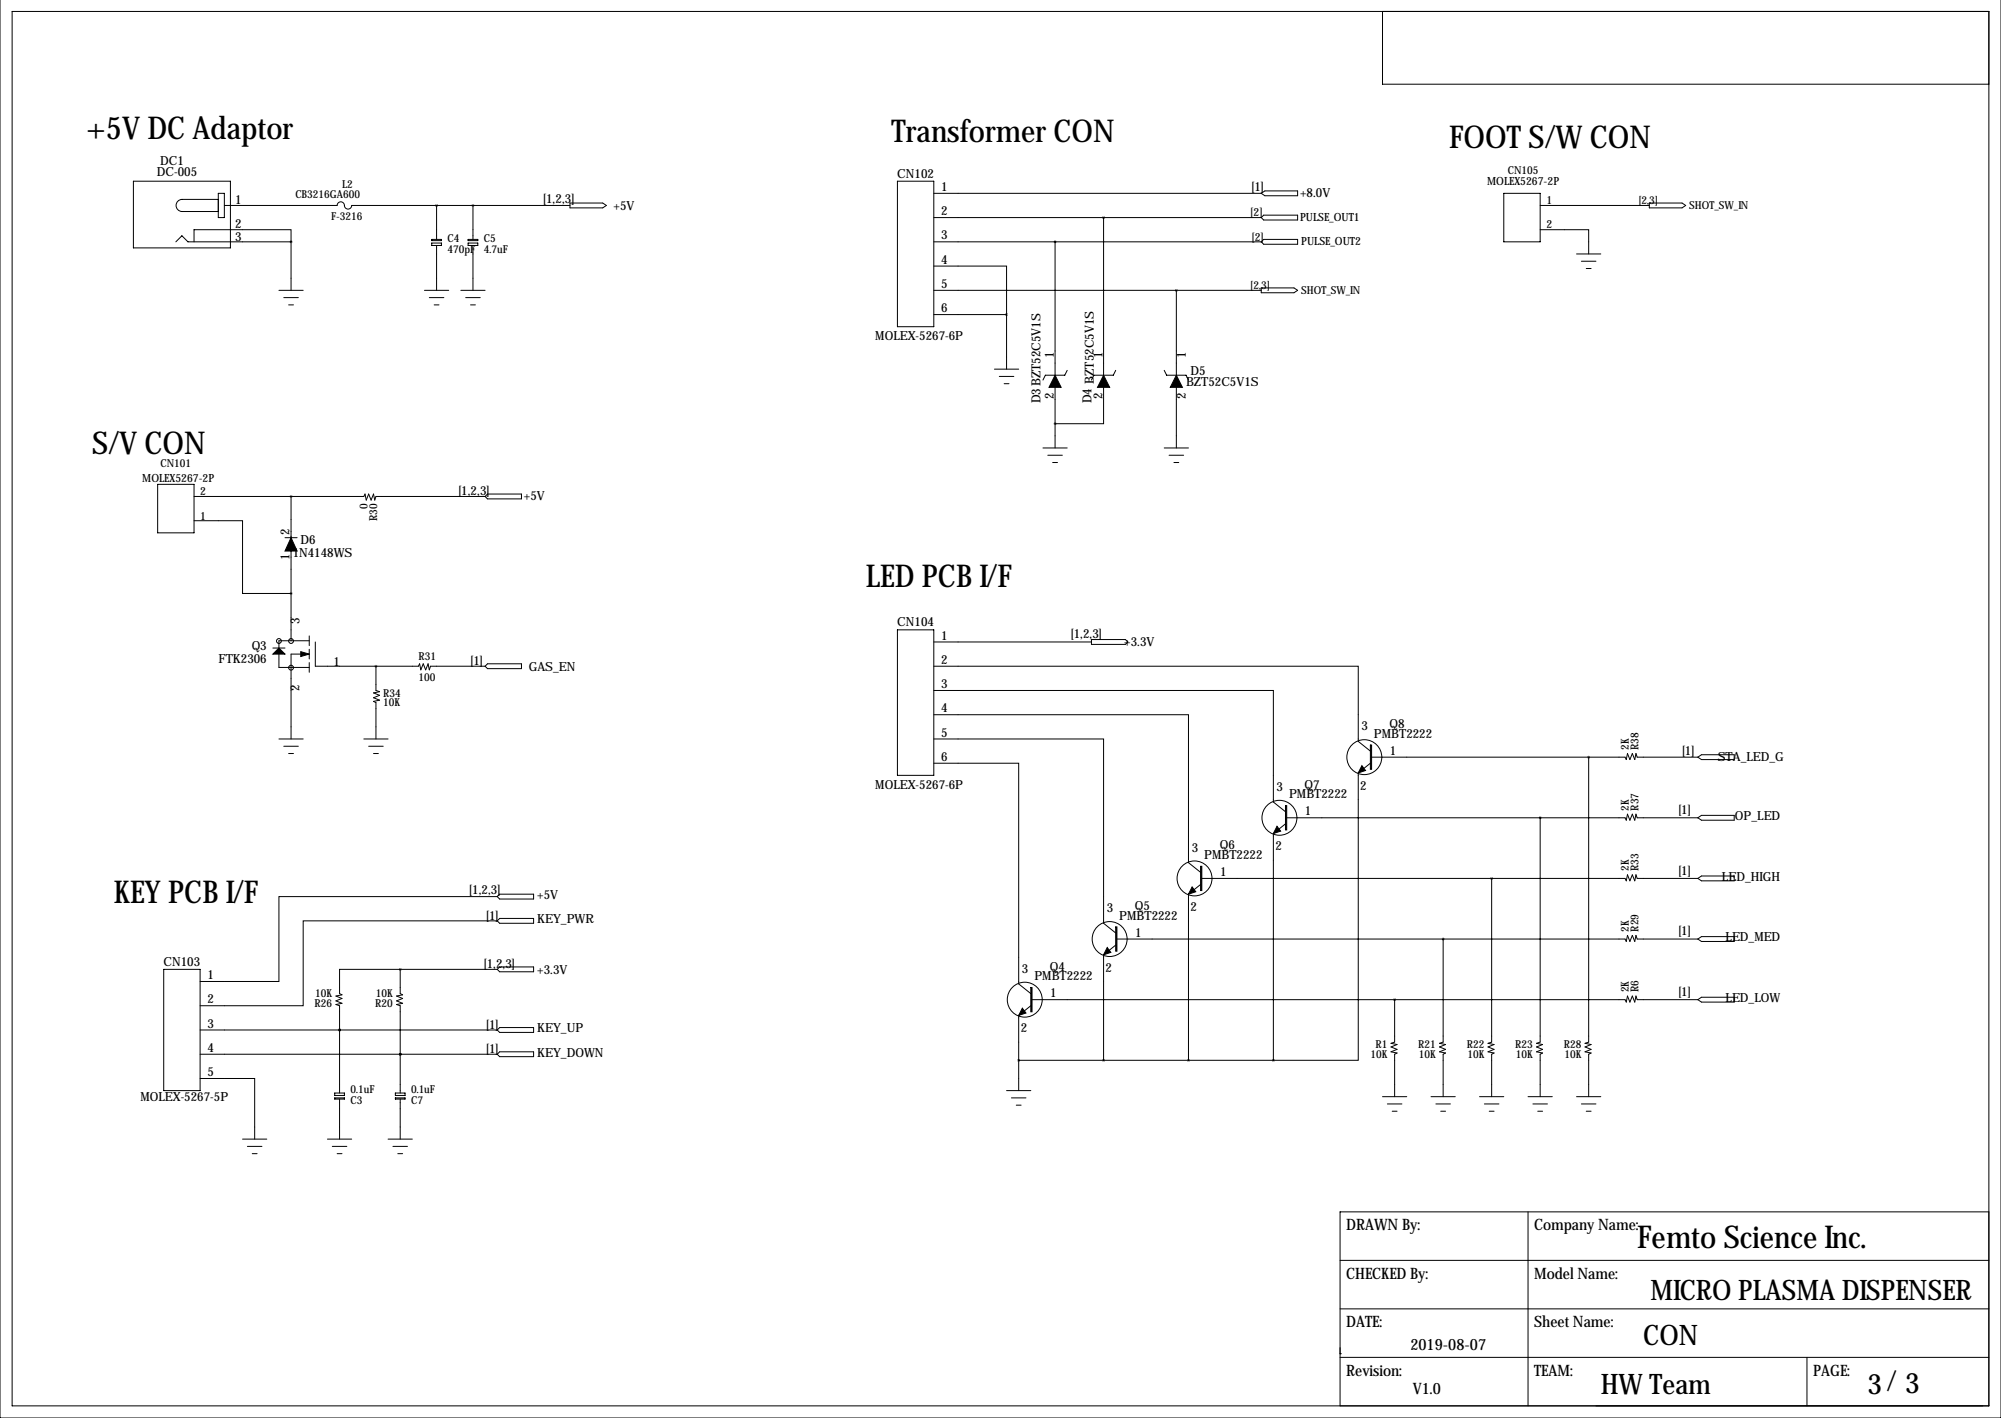
[picture p171: page 3]
