ArvidJoung/Plasma_Generator/2_Micro_Plasma_Dispenser/1_Schematic/Build V1.0/03_MPD_KEY PCB V1.0/MPD-KEY_SCH_V1.0_20190807.pdf

# Power Key

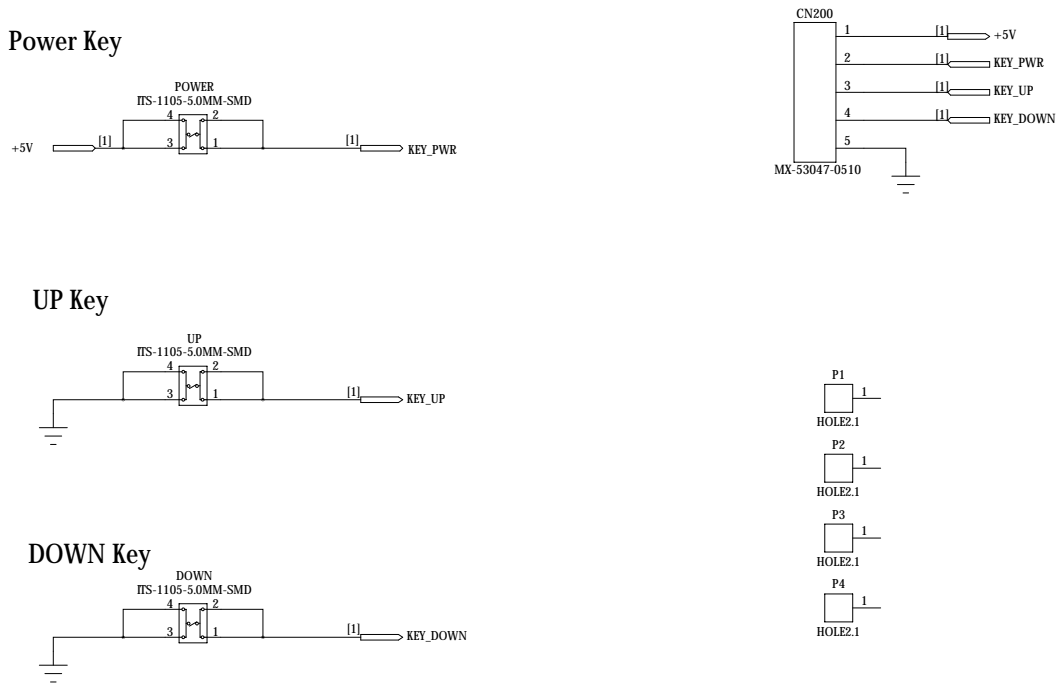
[picture p172: page 1]
Revision:; DATE:; CHECKED By:; TEAM:; PAGE:; Sheet Name:; Model Name:; DRAWN By:; Company Name:; KEY; HW Team; UP Key; DOWN Key; HOLE2.1; POWER ITS-1105-5.0MM-SMD; UP ITS-1105-5.0MM-SMD; DOWN ITS-1105-5.0MM-SMD; KEY_PWR; KEY_UP [1]; KEY_DOWN [1]; KEY_PWR [1]; KEY_DOWN

Femto Science Inc.
MICRO PLASMA DISPENSER
