ArvidJoung/Plasma_Generator/2_Micro_Plasma_Dispenser/1_Schematic/Build V1.0/02_MPD_LED PCB V1.0/MPD-LED_SCH_V1.0_20190807.pdf

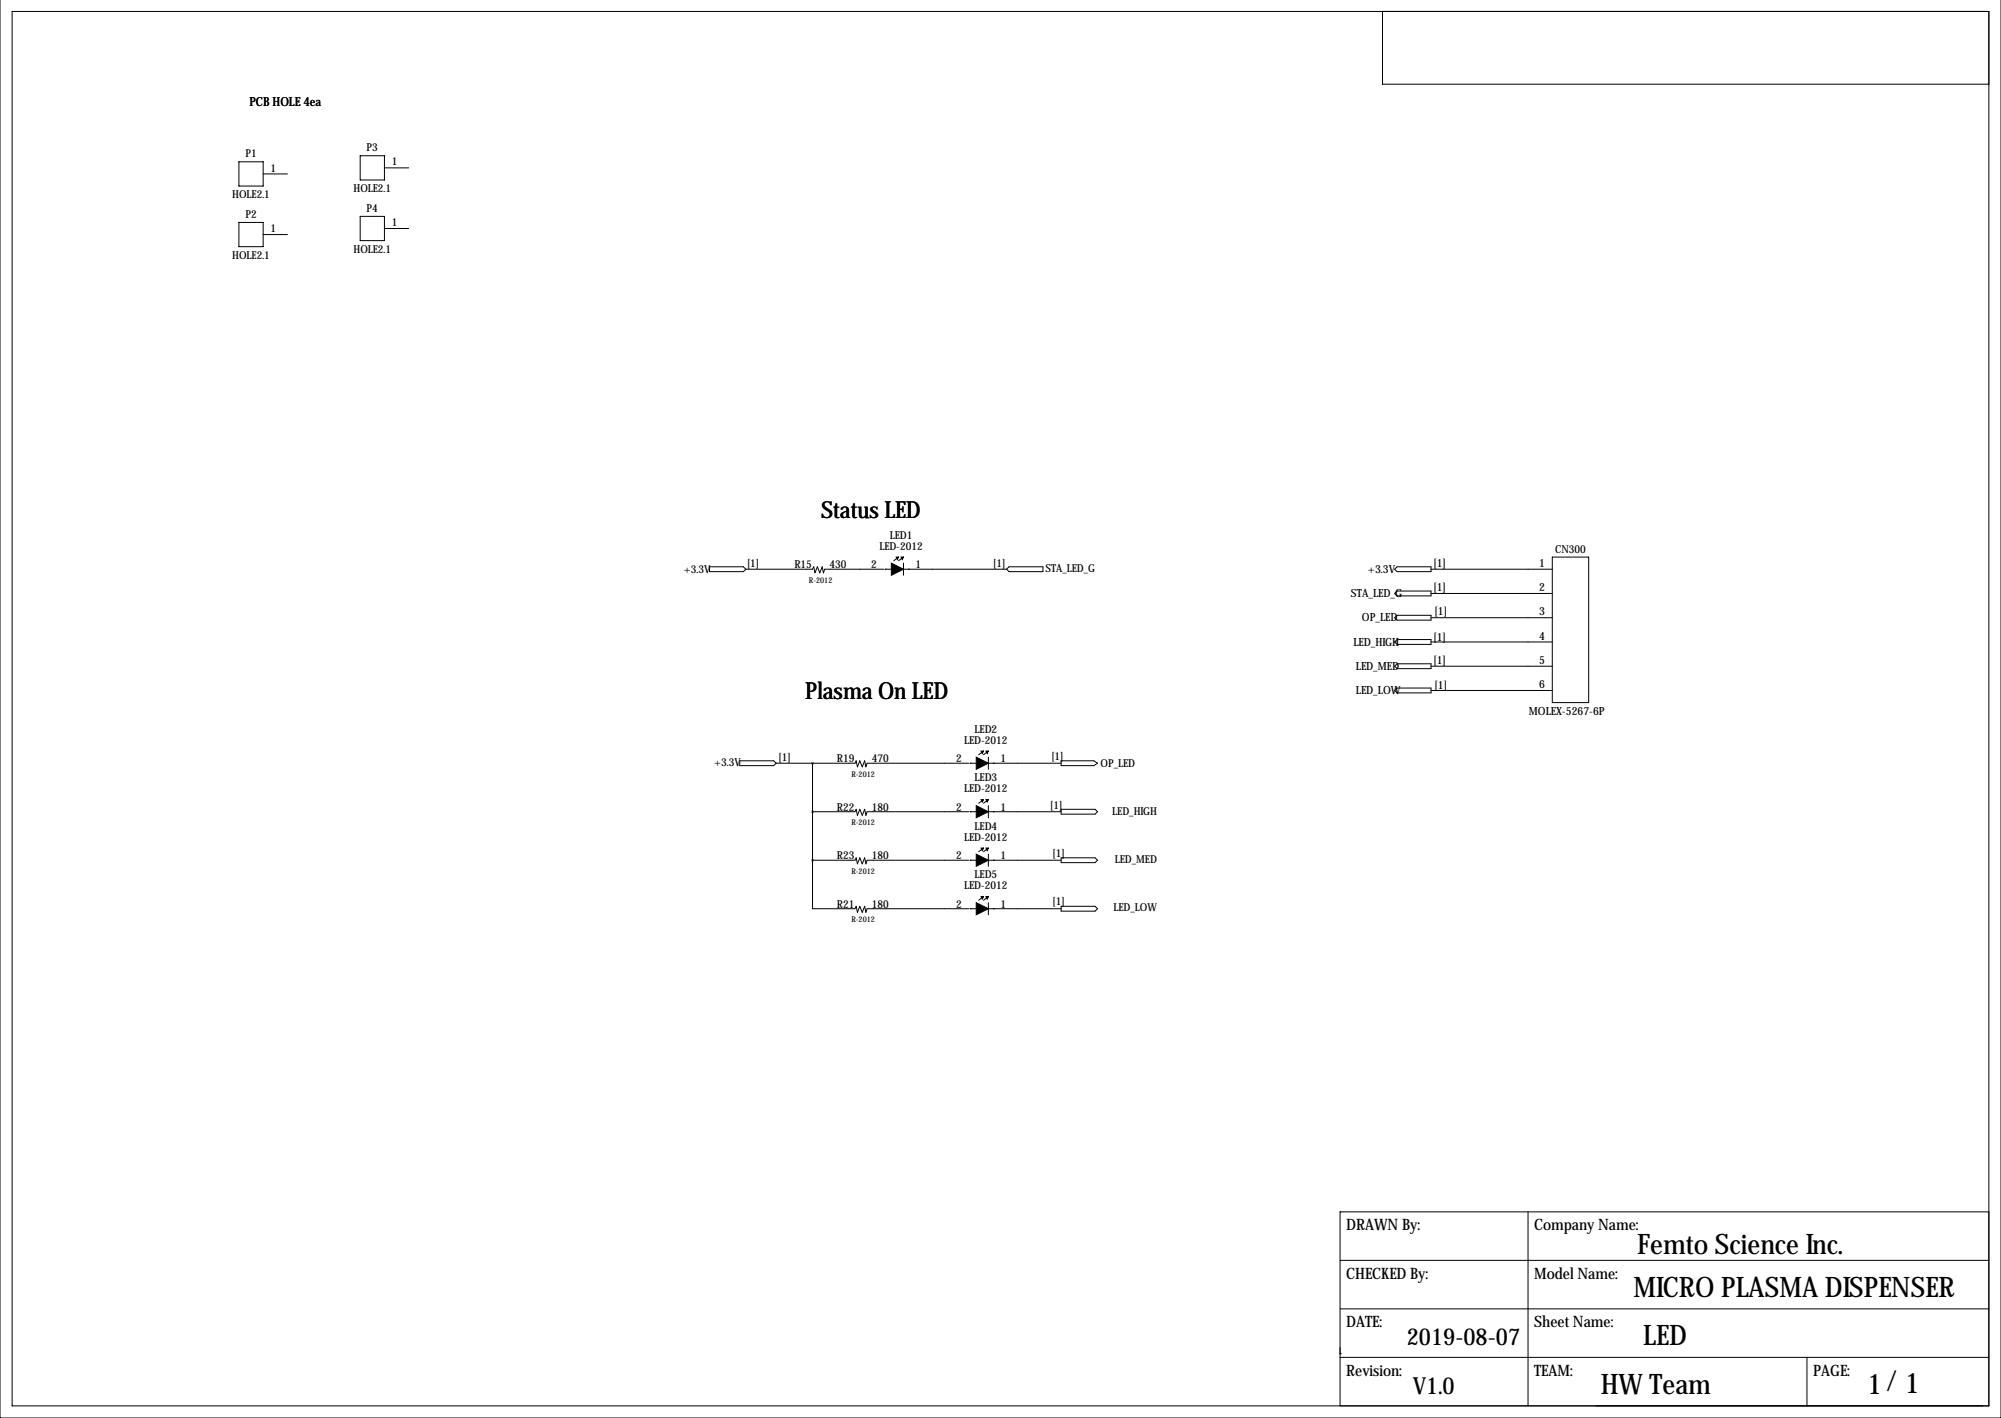
[picture p173: page 1]
