ArvidJoung/Plasma_Generator/(list of files, drawings)

Other design files:
0_MP1 Data/1_Sch & PCB/Main/Plasma_Pipette_V2.0_Main_PCB_20181009_VX2.3.pcb
0_MP1 Data/1_Sch & PCB/Transformer/Plasma_Pipette_Transformer_PCB_V3.0_20180724.pcb
0_MP2 Data/1_Sch & PCB/Main/Backup/Plasma_Pipette_V3.0_Main_PCB_20181226_VX2.3.pcb
0_MP2 Data/1_Sch & PCB/Main/Backup/Plasma_Pipette_V3.0_Main_PCB_20190113_V9.5.pcb
0_MP2 Data/1_Sch & PCB/Main/Backup/Plasma_Pipette_V3.0_Main_PCB_20190113_VX2.3.pcb
0_MP2 Data/1_Sch & PCB/Main/Backup/Plasma_Pipette_V3.0_Main_PCB_20190228_V9.5.pcb
0_MP2 Data/1_Sch & PCB/Main/Backup/Plasma_Pipette_V3.0_Main_PCB_20190302_V9.5.pcb
0_MP2 Data/1_Sch & PCB/Main/Plasma_Pipette_V3.0_Main_PCB_20181226_VX2.3.pcb
0_MP2 Data/1_Sch & PCB/Main/Plasma_Pipette_V3.0_Main_PCB_20190113_V9.5.pcb
0_MP2 Data/1_Sch & PCB/Main/Plasma_Pipette_V3.0_Main_PCB_20190113_VX2.3.pcb
0_MP2 Data/1_Sch & PCB/Main/Plasma_Pipette_V3.0_Main_PCB_20190302_V9.5.pcb
0_MP2 Data/1_Sch & PCB/Main/Plasma_Pipette_V3.0_Main_PCB_20190315_V9.5.pcb
0_MP2 Data/1_Sch & PCB/Transformer/Backup/Plasma_Pipette_Transformer_PCB_V4.0_20181226.pcb
0_MP2 Data/1_Sch & PCB/Transformer/Plasma_Pipette_Transformer_PCB_V4.0_20190306.pcb
0_MP2 Data/4_ME/ay_pcb_plasma-20190314.pcb
0_MP3 Data/Plasma_Pipette_V4.0_Main_PCB_20190411_V9.5.pcb
0_Proto_type/1_Schematic/1_V1.0/Plasma_Gen_Main Board_V1.0_20171206_TypeB.pcb
0_Proto_type/1_Schematic/2_V2.0/Plasma_Gen_Main Board_PCB_V2.0_20180114.pcb
1_Plasma_Pipette/1_Schematic/Backup/Plasma_Gen_Pipette_Main_PCB_V1.0_B_20180223.pcb
1_Plasma_Pipette/1_Schematic/Plasma_Gen_Pipette_Main_PCB_V1.0_B_20180223.pcb
1_Plasma_Pipette/1_Schematic/V2.0/20180717_ME Data/Plasma Pipette Main PCB_2D_ME.pcb
1_Plasma_Pipette/1_Schematic/V2.0/Backup/Plasma_Pipette_V2.0_Main_PCB.pcb
1_Plasma_Pipette/1_Schematic/V2.0/Backup/Plasma_Pipette_V2.0_Main_PCB_2.pcb
1_Plasma_Pipette/1_Schematic/V2.0/Backup/Plasma_Pipette_V2.0_Main_PCB_3.pcb
1_Plasma_Pipette/1_Schematic/V2.0/Backup/Plasma_Pipette_V2.0_Main_PCB_20180721_회사.pcb
1_Plasma_Pipette/1_Schematic/V2.0/Backup/Plasma_Pipette_V2.0_Main_PCB_회사.pcb
1_Plasma_Pipette/1_Schematic/V2.0/ME/20180725_1_Main PCB 후크추가/2d_pcb_plasma-180725-1_PCB.pcb
1_Plasma_Pipette/1_Schematic/V2.0/ME/20180725_Trans PCB 확장/2d_pcb_plasma-180725_trans PCB.pcb
1_Plasma_Pipette/1_Schematic/V2.0/ME/20180730_Main PCB 외곽 수정/2D_PCB_PLASMA-180730_PCB.pcb
1_Plasma_Pipette/1_Schematic/V2.0/Plasma_Pipette_V2.0_Main_PCB.pcb
1_Plasma_Pipette/1_Schematic/V2.0/Plasma_Pipette_V2.0_Main_PCB_2.pcb
1_Plasma_Pipette/1_Schematic/V2.0/Plasma_Pipette_V2.0_Main_PCB_20180731_Company.pcb
1_Plasma_Pipette/1_Schematic/V2.0/Plasma_Pipette_V2.0_Main_PCB_회사.pcb
1_Plasma_Pipette/1_Schematic/V2.0_Type2/Backup/Plasma_Pipette_V2.0_Main_PCB_20180731_Company.pcb
1_Plasma_Pipette/1_Schematic/V2.0_Type2/Plasma_Pipette_V2.0_Main_PCB_20181009_Company_과제.pcb
1_Plasma_Pipette/1_Schematic/V2.0_Type2/Plasma_Pipette_V2.0_Main_PCB_20181009_VX2.3.pcb
2_Micro_Plasma_Dispenser/0_DOC/20190706_ME 2D Data/2D_PCB_MPD_KEY-190705.pcb
2_Micro_Plasma_Dispenser/0_DOC/20190706_ME 2D Data/2D_PCB_MPD_LED-190705.pcb
2_Micro_Plasma_Dispenser/0_DOC/20190706_ME 2D Data/2D_PCB_MPD_MAIN-190705.pcb
2_Micro_Plasma_Dispenser/0_DOC/20190708_ME 2D Data/2D_PCB_MPD-190708_KEY.pcb
2_Micro_Plasma_Dispenser/0_DOC/20190708_ME 2D Data/2D_PCB_MPD-190708_LED.pcb
2_Micro_Plasma_Dispenser/0_DOC/20190708_ME 2D Data/2D_PCB_MPD-190708_MAIN.pcb
2_Micro_Plasma_Dispenser/0_DOC/20190724_ME Data/2D_PCB_MPD-190724_KEY.pcb
2_Micro_Plasma_Dispenser/1_Schematic/00_Ref/Plasma_Pipette_V5.0_Main_PCB_20190521_Export.pcb
2_Micro_Plasma_Dispenser/1_Schematic/01_MPD_Main PCB V1.0/MPD_V1.0_Main_PCB_20190714B.pcb
2_Micro_Plasma_Dispenser/1_Schematic/01_MPD_Main PCB V1.0/MPD_V1.0_Main_PCB_20190717.pcb
2_Micro_Plasma_Dispenser/1_Schematic/01_MPD_Main PCB V1.0/MPD_V1.0_Main_PCB_20190724.pcb
2_Micro_Plasma_Dispenser/1_Schematic/03_MPD_KEY PCB V1.0/MPD_V1.0_KEY_PCB_20190708.pcb
2_Micro_Plasma_Dispenser/1_Schematic/Build V1.0/01_MPD_Main PCB V1.0/Backup/MPD_V1.0_Main_PCB_20190708.pcb
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
