ArvidJoung/Plasma_Generator/3_Plasma_Pipette_C/3_Firmware/Source_20191024/plasma_pt/Inc/main.h

#define GND_JACK_Pin GPIO_PIN_0
#define GND_JACK_GPIO_Port GPIOC
#define STA_LED_B_Pin GPIO_PIN_1
#define STA_LED_B_GPIO_Port GPIOC
#define STA_LED_G_Pin GPIO_PIN_2
#define STA_LED_G_GPIO_Port GPIOC
#define STA_LED_R_Pin GPIO_PIN_3
#define STA_LED_R_GPIO_Port GPIOC
#define HW_ID0_Pin GPIO_PIN_1
#define HW_ID0_GPIO_Port GPIOA
#define HW_ID1_Pin GPIO_PIN_2
#define HW_ID1_GPIO_Port GPIOA
#define BAT_ADC_Pin GPIO_PIN_7
#define BAT_ADC_GPIO_Port GPIOA
#define BATT_THERM_Pin GPIO_PIN_4
#define BATT_THERM_GPIO_Port GPIOC
#define KEY_PWR_Pin GPIO_PIN_5
#define KEY_PWR_GPIO_Port GPIOC
#define KEY_PWR_EXTI_IRQn EXTI4_15_IRQn
#define PW_CTRL_Pin GPIO_PIN_0
#define PW_CTRL_GPIO_Port GPIOB
#define CHG_STA_Pin GPIO_PIN_1
#define CHG_STA_GPIO_Port GPIOB
#define CHG_CTRL_Pin GPIO_PIN_12
#define CHG_CTRL_GPIO_Port GPIOB
#define GAS_EN_Pin GPIO_PIN_13
#define GAS_EN_GPIO_Port GPIOB
#define LED_HIGH_Pin GPIO_PIN_14
#define LED_HIGH_GPIO_Port GPIOB
#define LED_MED_Pin GPIO_PIN_15
#define LED_MED_GPIO_Port GPIOB
#define LED_LOW_Pin GPIO_PIN_6
#define LED_LOW_GPIO_Port GPIOC
#define USB_DET_Pin GPIO_PIN_7
#define USB_DET_GPIO_Port GPIOC
#define USB_DET_EXTI_IRQn EXTI4_15_IRQn
#define PULSE_OUT1_Pin GPIO_PIN_8
#define PULSE_OUT1_GPIO_Port GPIOA
#define PULSE_OUT2_Pin GPIO_PIN_11
#define PULSE_OUT2_GPIO_Port GPIOA
#define EN__8V_Pin GPIO_PIN_12
#define EN__8V_GPIO_Port GPIOA
#define KEY_DOWN_Pin GPIO_PIN_4
#define KEY_DOWN_GPIO_Port GPIOB
#define KEY_DOWN_EXTI_IRQn EXTI4_15_IRQn
#define KEY_UP_Pin GPIO_PIN_6
#define KEY_UP_GPIO_Port GPIOB
#define KEY_UP_EXTI_IRQn EXTI4_15_IRQn
#define OP_LED_Pin GPIO_PIN_8
#define OP_LED_GPIO_Port GPIOB
#define KEY_OP_Pin GPIO_PIN_9
#define KEY_OP_GPIO_Port GPIOB
#define KEY_OP_EXTI_IRQn EXTI4_15_IRQn
