ArvidJoung/Plasma_Generator/3_Plasma_Pipette_C/3_Firmware/Source_20191024/plasma_pt/Src/gpio.c

/**
  ******************************************************************************
  * File Name          : gpio.c
  * Description        : This file provides code for the configuration
  *                      of all used GPIO pins.
  ******************************************************************************
  * This notice applies to any and all portions of this file
  * that are not between comment pairs USER CODE BEGIN and
  * USER CODE END. Other portions of this file, whether 
  * inserted by the user or by software development tools
  * are owned by their respective copyright owners.
  *
  * Copyright (c) 2018 STMicroelectronics International N.V. 
  * All rights reserved.
  *
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
  ******************************************************************************
  */

/* Includes ------------------------------------------------------------------*/
#include "gpio.h"
#include "interrupt_conf.h"
#include "command.h"
#include "task_cfg.h"
#include "signals.h"

/*----------------------------------------------------------------------------*/
/* Configure GPIO                                                             */
/*----------------------------------------------------------------------------*/
/** Configure pins as 
        * Analog 
        * Input 
        * Output
        * EVENT_OUT
        * EXTI
        * Free pins are configured automatically as Analog (this feature is enabled through 
        * the Code Generation settings)
*/
void MX_GPIO_Init(void)
{

  GPIO_InitTypeDef GPIO_InitStruct;

  /* GPIO Ports Clock Enable */
  __HAL_RCC_GPIOC_CLK_ENABLE();
  __HAL_RCC_GPIOF_CLK_ENABLE();
  __HAL_RCC_GPIOA_CLK_ENABLE();
  __HAL_RCC_GPIOB_CLK_ENABLE();
  __HAL_RCC_GPIOD_CLK_ENABLE();

  /*Configure GPIO pin Output Level */
  HAL_GPIO_WritePin(GPIOC, STA_LED_B_Pin|STA_LED_G_Pin|STA_LED_R_Pin, GPIO_PIN_SET);  // 5/26 Arvid - initial LED OFF Status Setting
  HAL_GPIO_WritePin(GPIOC, LED_LOW_Pin, GPIO_PIN_SET);  // 5/26 Arvid - initial LED OFF Status Setting
  /*Configure GPIO pin Output Level */
  HAL_GPIO_WritePin(GPIOB, PW_CTRL_Pin|CHG_CTRL_Pin|GAS_EN_Pin, GPIO_PIN_RESET);
  HAL_GPIO_WritePin(GPIOB, LED_HIGH_Pin|LED_MED_Pin|OP_LED_Pin, GPIO_PIN_SET);    // 5/26 Arvid - initial LED OFF Status Setting
  /*Configure GPIO pin Output Level */
  HAL_GPIO_WritePin(EN__8V_GPIO_Port, EN__8V_Pin, GPIO_PIN_RESET);

  /*Configure GPIO pins : PC13 PC14 PC15 PC8 
                           PC9 PC10 PC11 PC12 */
  GPIO_InitStruct.Pin = GPIO_PIN_13|GPIO_PIN_14|GPIO_PIN_15|GPIO_PIN_8 
                          |GPIO_PIN_9|GPIO_PIN_10|GPIO_PIN_11|GPIO_PIN_12;
  GPIO_InitStruct.Mode = GPIO_MODE_ANALOG;
  GPIO_InitStruct.Pull = GPIO_NOPULL;
  HAL_GPIO_Init(GPIOC, &GPIO_InitStruct);

  /*Configure GPIO pins : PF0 PF1 */
  GPIO_InitStruct.Pin = GPIO_PIN_0|GPIO_PIN_1;
  GPIO_InitStruct.Mode = GPIO_MODE_ANALOG;
  GPIO_InitStruct.Pull = GPIO_NOPULL;
  HAL_GPIO_Init(GPIOF, &GPIO_InitStruct);

  /*Configure GPIO pin : PtPin */
  GPIO_InitStruct.Pin = GND_JACK_Pin;
  GPIO_InitStruct.Mode = GPIO_MODE_IT_RISING_FALLING;
  GPIO_InitStruct.Pull = GPIO_PULLUP;
  HAL_GPIO_Init(GND_JACK_GPIO_Port, &GPIO_InitStruct);

  /*Configure GPIO pins : PCPin PCPin PCPin PCPin */
  GPIO_InitStruct.Pin = STA_LED_B_Pin|STA_LED_G_Pin|STA_LED_R_Pin|LED_LOW_Pin;
  GPIO_InitStruct.Mode = GPIO_MODE_OUTPUT_PP;
  GPIO_InitStruct.Pull = GPIO_NOPULL;
  GPIO_InitStruct.Speed = GPIO_SPEED_FREQ_LOW;
  HAL_GPIO_Init(GPIOC, &GPIO_InitStruct);

  /*Configure GPIO pins : PA0 PA3 PA4 PA5 
                           PA6 PA9 PA10 PA15 */
  GPIO_InitStruct.Pin = GPIO_PIN_0|GPIO_PIN_3|GPIO_PIN_4|GPIO_PIN_5 
                          |GPIO_PIN_6|GPIO_PIN_9|GPIO_PIN_10|GPIO_PIN_15;
  GPIO_InitStruct.Mode = GPIO_MODE_ANALOG;
  GPIO_InitStruct.Pull = GPIO_NOPULL;
  HAL_GPIO_Init(GPIOA, &GPIO_InitStruct);

  /*Configure GPIO pins : PAPin PAPin */
  GPIO_InitStruct.Pin = HW_ID0_Pin|HW_ID1_Pin;
  GPIO_InitStruct.Mode = GPIO_MODE_INPUT;
  GPIO_InitStruct.Pull = GPIO_NOPULL;
  HAL_GPIO_Init(GPIOA, &GPIO_InitStruct);

  /*Configure GPIO pin : PtPin */
  GPIO_InitStruct.Pin = KEY_PWR_Pin;
  GPIO_InitStruct.Mode = GPIO_MODE_IT_RISING;
  GPIO_InitStruct.Pull = GPIO_PULLDOWN;
  HAL_GPIO_Init(KEY_PWR_GPIO_Port, &GPIO_InitStruct);

  /*Configure GPIO pins : PBPin PBPin PBPin */
  GPIO_InitStruct.Pin = PW_CTRL_Pin|LED_HIGH_Pin|LED_MED_Pin;
  GPIO_InitStruct.Mode = GPIO_MODE_OUTPUT_PP;
  GPIO_InitStruct.Pull = GPIO_NOPULL;
  GPIO_InitStruct.Speed = GPIO_SPEED_FREQ_LOW;
  HAL_GPIO_Init(GPIOB, &GPIO_InitStruct);

  /*Configure GPIO pins : PB2 PB10 PB11 PB3 
                           PB5 PB7 */
  GPIO_InitStruct.Pin = GPIO_PIN_2|GPIO_PIN_10|GPIO_PIN_11|GPIO_PIN_3 
                          |GPIO_PIN_5|GPIO_PIN_7;
  GPIO_InitStruct.Mode = GPIO_MODE_ANALOG;
  GPIO_InitStruct.Pull = GPIO_NOPULL;
  HAL_GPIO_Init(GPIOB, &GPIO_InitStruct);

  /*Configure GPIO pins : PBPin PBPin PBPin */
  GPIO_InitStruct.Pin = CHG_CTRL_Pin|GAS_EN_Pin|OP_LED_Pin;
  GPIO_InitStruct.Mode = GPIO_MODE_OUTPUT_PP;
  GPIO_InitStruct.Pull = GPIO_PULLDOWN;
  GPIO_InitStruct.Speed = GPIO_SPEED_FREQ_LOW;
  HAL_GPIO_Init(GPIOB, &GPIO_InitStruct);

  /*Configure GPIO pin : PtPin */
  GPIO_InitStruct.Pin = USB_DET_Pin;
  GPIO_InitStruct.Mode = GPIO_MODE_IT_RISING_FALLING;
  GPIO_InitStruct.Pull = GPIO_PULLDOWN;
  HAL_GPIO_Init(USB_DET_GPIO_Port, &GPIO_InitStruct);

  /*Configure GPIO pin : PtPin */
  GPIO_InitStruct.Pin = EN__8V_Pin;
  GPIO_InitStruct.Mode = GPIO_MODE_OUTPUT_PP;
  GPIO_InitStruct.Pull = GPIO_PULLDOWN;
  GPIO_InitStruct.Speed = GPIO_SPEED_FREQ_LOW;
  HAL_GPIO_Init(EN__8V_GPIO_Port, &GPIO_InitStruct);

  /*Configure GPIO pin : PD2 */
  GPIO_InitStruct.Pin = GPIO_PIN_2;
  GPIO_InitStruct.Mode = GPIO_MODE_ANALOG;
  GPIO_InitStruct.Pull = GPIO_NOPULL;
  HAL_GPIO_Init(GPIOD, &GPIO_InitStruct);

  /*Configure GPIO pins : PBPin PBPin PBPin */
  GPIO_InitStruct.Pin = KEY_DOWN_Pin|KEY_UP_Pin|KEY_OP_Pin;
  GPIO_InitStruct.Mode = GPIO_MODE_IT_FALLING;
  GPIO_InitStruct.Pull = GPIO_PULLUP;
  HAL_GPIO_Init(GPIOB, &GPIO_InitStruct);

  /* EXTI interrupt init*/
  HAL_NVIC_SetPriority(EXTI4_15_IRQn, RTOS_API_INTERRUPT_GROUP, 0);
  HAL_NVIC_EnableIRQ(EXTI4_15_IRQn);

  HAL_NVIC_SetPriority(EXTI0_1_IRQn, RTOS_API_INTERRUPT_GROUP, 0);
  HAL_NVIC_EnableIRQ(EXTI0_1_IRQn);

}

/* USER CODE BEGIN 2 */
void HAL_GPIO_EXTI_Callback(uint16_t GPIO_Pin, portBASE_TYPE *xHigherPriorityTaskWoken)
{
	command_type	cmd;

	cmd.len = 0;
	cmd.msg = NULL;

	switch(GPIO_Pin)
	{
		case KEY_PWR_Pin:
    		cmd.cmd = PWR_KEY_PRESSED_EVT;
    		xQueueSendFromISR(xMcTaskQueue,&cmd,xHigherPriorityTaskWoken);
    		break;

		case KEY_OP_Pin:
      if( HAL_GPIO_ReadPin(USB_DET_GPIO_Port,USB_DET_Pin) == GPIO_PIN_RESET)
      {
			  cmd.cmd = INEVENT_OPERATE_SW_EVT;
			  xQueueSendFromISR(xInEventTaskQueue,&cmd,xHigherPriorityTaskWoken);
      }
			break;

		case KEY_DOWN_Pin:
      if(HAL_GPIO_ReadPin(KEY_OP_GPIO_Port,KEY_OP_Pin) == GPIO_PIN_SET)
      {
			  cmd.cmd = INEVENT_KEY_DOWN_KEY_PRESSED_EVT;
			  xQueueSendFromISR(xInEventTaskQueue,&cmd,xHigherPriorityTaskWoken);
      }
			break;

		case KEY_UP_Pin:
      if(HAL_GPIO_ReadPin(KEY_OP_GPIO_Port,KEY_OP_Pin) == GPIO_PIN_SET)
      {    
			  cmd.cmd = INEVENT_KEY_UP_KEY_PRESSED_EVT;
			  xQueueSendFromISR(xInEventTaskQueue,&cmd,xHigherPriorityTaskWoken);
      }
			break;

		case GND_JACK_Pin:
            if( HAL_GPIO_ReadPin(GND_JACK_GPIO_Port,GND_JACK_Pin) == GPIO_PIN_SET)
            {
			    cmd.cmd = INEVENT_GND_JACK_IN_EVT;
            }
            else
            {
			    cmd.cmd = INEVENT_GND_JACK_OUT_EVT;
            }                
			xQueueSendFromISR(xInEventTaskQueue,&cmd,xHigherPriorityTaskWoken);
			break;

		case USB_DET_Pin:
            if( HAL_GPIO_ReadPin(USB_DET_GPIO_Port,USB_DET_Pin) == GPIO_PIN_SET)
            {
			    cmd.cmd = INEVENT_EXTPWR_IN_EVT;
            }
            else
            {
			    cmd.cmd = INEVENT_EXTPWR_OUT_EVT;
            }                
			xQueueSendFromISR(xInEventTaskQueue,&cmd,xHigherPriorityTaskWoken);
			break;

		default: 
            break;
	}
}

/* USER CODE END 2 */

/**
  * @}
  */

/**
  * @}
  */

/************************ (C) COPYRIGHT STMicroelectronics *****END OF FILE****/
