ArvidJoung/Plasma_Generator/(commit log)

2018-02-03 [Pipette] V2.0 START
    [MPD 협의자료 (정 책임과 up-date하면서 정리).xlsx, Plasma Generator_Part List_V2.0_20171222.xlsx, Plasma_Gen_FW_flow chart.xlsx, Plasma_Gen_Functioin List_20180104.xlsx, Plasma_Gen_Issue and ECO list_20171218.xlsx, Plasma_Gen_MCU_PinMap_20171227.xlsx, Plasma_Gen_Main Board_Portable_PCB_V2.0_20180120.pcb, Plasma_Gen_Main Board_Portable_SCH_V2.0_20180120.sch]
2018-02-03 [Pipette]BD / Review data 추가
    [Plasma_Gen_Review Data_20180203.xlsx]
2018-02-03 [Pipette] Transformer review data add
    [Plasma_Gen_Review Data_20180203.xlsx]
2018-02-03 [Pipette] Transformer 회로 추가
    [Plasma_Gen_Transformer_SCH_V1.0_20180203.sch]
2018-02-04 [Pipette]Transformer PCB file 추가, PL 추가
    [Plasma_Gen_Transformer_Part List_V1.0.xlsx, Plasma_Gen_Transformer_SCH_V1.0_20180203.pcb, Plasma_Gen_Transformer_SCH_V1.0_20180203.sch]
2018-02-04 [Pipette] Main PCB 검토용 부품 datasheet 추가
2018-02-04 [Pipette] Transformer datasheet 추가
2018-02-04 [Pipette] Transformer 부품 검토 - 가격 및 agency
    [Plasma_Gen_Device cost.xlsx, Plasma_Gen_Review Data_20180203.xlsx, Plasma_Gen_Transformer_예상소모비용_20180203.xlsx]
2018-02-04 [Pipette] 전류 측정
    [Plasma_Gen_Review Data_20180203.xlsx]
2018-02-04 [Pipette] Power MOSFET small size 검토
2018-02-04 [Pipette] 3개 type의 PCB 검토
    [Plasma_Gen_Device cost.xlsx, Plasma_Gen_Transformer_Part List_V1.0.xlsx, Plasma_Gen_Transformer_SCH_V1.0_20180203.pcb, Plasma_Gen_Transformer_SCH_V1.0_20180203.sch, Plasma_Gen_Transformer_예상소모비용_20180203.xlsx]
2018-02-05 [Pipette] Trans current 측정 결과 update
    [Plasma_Gen_Review Data_20180203.xlsx]
2018-02-05 [Pipette] Trans 부품 구매
    [Plasma_Gen_Device cost.xlsx, Plasma_Gen_Transformer_예상소모비용_20180203.xlsx]
2018-02-05 [Pipette] Trans size minimize version 추가
    [Plasma_Gen_Transformer_SCH_V1.0_20180203.pcb, Plasma_Gen_Transformer_SCH_V1.0_20180203.sch]
2018-02-05 [Pipette] Transformer PCB 1차 Gerber
    [Plasma_Gen_Transformer_SCH_V1.0_20180205.pcb, Plasma_Gen_Transformer_SCH_V1.0_20180205.sch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]
2018-02-05 [Pipette] Transformer PCB 1차 Gerber 완료 Version
    [Plasma_Gen_Transformer_SCH_V1.0_20180203.pcb, Plasma_Gen_Transformer_SCH_V1.0_20180203.sch, Plasma_Gen_Transformer_SCH_V1.0_20180205.pcb, Plasma_Gen_Transformer_SCH_V1.0_20180205.sch]
2018-02-05 [Pipette] Main PCB 수정 - Slide SW 결정 필요
    [Plasma_Gen_Device cost.xlsx, Plasma_Gen_Pipette_Main_PCB_V2.0_20180120.pcb, Plasma_Gen_Pipette_Main_SCH_V2.0_20180120.sch]
2018-02-06 [Pipette] Transformer Gerber 발송 - SM co.
    [drl001.drl]
2018-02-06 [MPD] Sch, PCB file 추가
    [Plasma Generator_Part List_V2.0_20171222.xlsx, Plasma_Gen_Issue and ECO list_20171218.xlsx, Plasma_Gen_Main Board_Portable_PCB_V2.0_20180120.pcb, Plasma_Gen_Main Board_Portable_SCH_V2.0_20180120.sch]
2018-02-06 [Femto] Pipette 디자인 sample 자료 수신
2018-02-06 [Pipette] SCH, PCB 작업 update
    [Plasma_Gen_Device cost.xlsx, Plasma_Gen_Pipette_Main_PCB_V2.0_20180120.pcb, Plasma_Gen_Pipette_Main_SCH_V2.0_20180120.sch]
2018-02-06 [Femto] 요청 자료 전달
    [Plasma Generator_Part List_V2.0_20180107.xlsx, Plasma_Gen_Functioin List_20180104.xlsx]
2018-02-07 [Femto] 사진 요청자료 전달
2018-02-07 [Femto] Project 및 상품 설명 및 개발 정보 - 부품업체용
2018-02-07 [Block Diagram] Pipette, MPD update
2018-02-07 [Schedule] 전체 일정 update
    [Femto Project schedule V1.0.xlsx, Plasma_Gen_Project schedule_20180104.xlsx]
2018-02-07 [교수님] Transformer 설계자료 전달
    [Plasma_Gen_Transformer_SCH_V1.0_20180205.sch]
2018-02-07 [Pipette] Transformer PCB 견적 입수
2018-02-07 [Pipette] Transformer PL 정리
    [Plasma_Gen_Device cost.xlsx, Plasma_Gen_Transformer_Part List_V1.0.xlsx, Plasma_Gen_Transformer_SCH_V1.0_20180205.sch]
2018-02-08 [Pipette] Transformer PCB 견적 진행
2018-02-10 [Pipette] Transformer PCB metal data 추가
    [CK-NE.gbr, CK.gbr, CM.gbr, CO-NE.gbr, CO.gbr, OUT.gbr, SM.gbr, SO-NE.gbr]
2018-02-10 [Femto] 사업자등록증 입수
2018-02-10 [Pipette] Transformer Power 검토
    [Plasma_Gen_Review Data_20180203.xlsx]
2018-02-10 [DOC]Schedule 수정
    [Femto Project schedule V1.0.xlsx]
2018-02-12 [Pipette] Transformer 비용 요청 - 2/12 email 발송
    [Plasma_Gen_Device cost.xlsx, Plasma_Gen_Transformer_비용_20180212.xlsx, Plasma_Gen_Transformer_예상소모비용_20180203.xlsx]
2018-02-19 [DOC] Schedule update - Trans PCB 입고
    [Femto Project schedule V1.0.xlsx]
2018-02-21 [Pipette] Transformer 부품 입고 update
    [Femto Project schedule V1.0.xlsx, Plasma_Gen_Device cost.xlsx]
2018-02-22 [Proto] Proto-type 추가 제작을 위한 SCH,PCB data 추가
    [Plasma Generator_Part List_20171201.xlsx, Plasma_Gen_Issue Note.xlsx, Plasma_Gen_Issue and ECO list_20171218.xlsx, Plasma_Gen_Main Board_PCB_V2.0_20180114.pcb, Plasma_Gen_Main Board_SCH_V2.0_20180114.sch, Plasma_Gen_Main Board_V1.0_20171206.sch, Plasma_Gen_Main Board_V1.0_20171206_TypeB.pcb]
2018-02-23 [Transformer] Folder 분리
    [Plasma Generator_Part List_V2.0_20171222.xlsx, Plasma_Gen_Issue Note.xlsx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]
2018-02-23 [Pipette] V1.0 Start Sch&PCB - Oxford design 기준
    [Plasma_Gen_Pipette_Main_PCB_V1.0_20180223.pcb, Plasma_Gen_Pipette_Main_SCH_V1.0_20180223.sch]
2018-02-24 [Transformer] 부품 재고 Update
    [Plasma_Gen_Device cost.xlsx]
2018-02-24 [Transformer] Datasheet 정리
2018-02-24 [Pipette] SCH,PCB 수정
    [Plasma_Gen_Pipette_Main_PCB_V1.0_20180223.pcb, Plasma_Gen_Pipette_Main_SCH_V1.0_20180223.sch, Plsma Pipette Review Data.xlsx]
2018-02-24 [Pipette] SCH 수정
    [Plasma_Gen_Pipette_Main_SCH_V1.0_20180223.sch]
2018-02-26 [Pipette] Issue note format 수정
    [Plasma_Gen_Issue Note.xlsx]
2018-02-26 [Pipette] Oxford design 기준으로 block diagram 수정
2018-02-28 [DOC]Issue update - Transformer
    [Plasma_Gen_Issue Note.xlsx]
2018-03-10 [DOC] Transformer Test 결과 update
2018-03-10 [DOC] Schedule update
    [Femto Project schedule V1.0.xlsx]
2018-03-10 [DOC] 구매 list 작성
    [Femto 구매 list.xlsx]
2018-03-10 [DOC] Issue update
    [Plasma_Gen_Issue Note.xlsx]
2018-03-11 [Pipette] S/V update
2018-03-15 [Pipette] SCH & PCB update
    [Plasma_Gen_Pipette_Main_BOM_V1.0_20180313.xlsx, Plasma_Gen_Pipette_Main_BOM_V1.0_20180313A.xlsx, Plasma_Gen_Pipette_하네스_BOM_V1.0_20180313A.xlsx]
2018-03-18 [Pipette] Type-B file 생성
    [Plasma_Gen_Pipette_Main_PCB_V1.0_B_20180223.pcb]
2018-03-18 [Pipette] Type-B 형상 설계
    [Plasma_Gen_Block Diagram_20171207.dwg]
2018-03-21 [Pipette] Type-A(femto 결정)로 PCB 설계 진행
    [Plasma_Gen_Block Diagram_20171207.dxf, Plasma_Gen_Pipette_Main_PCB_V1.0_20180223.pcb, Plasma_Gen_Pipette_Main_SCH_V1.0_20180223.sch, 새 PADS Layout Design.pcb]
2018-03-23 [Pipette] 사용하지 않는 B-type의 file backup
    [Plasma_Gen_Pipette_Main_PCB_V1.0_B_20180223.pcb]
2018-03-23 [Pipette] SCH & PCB update - 1차 완료분
    [Plasma_Gen_MCU_PinMap_20171227.xlsx, Plasma_Gen_Pipette_Main_PCB_V1.0_20180223.pcb, Plasma_Gen_Pipette_Main_SCH_V1.0_20180223.sch]
2018-03-25 [Pipette] Sch update
    [Plasma_Gen_Pipette_Main_PCB_V1.0_20180223.pcb, Plasma_Gen_Pipette_Main_SCH_V1.0_20180223.sch, Plasma_Gen_Transformer_SCH_V1.0_20180205.pcb, Plasma_Gen_Transformer_SCH_V1.0_20180205.sch]
2018-03-25 [Transformer] Sch & PCB Update
    [Plasma_Gen_Transformer_Part List_V2.0.xlsx, Plasma_Gen_Transformer_SCH_V2.0_20180324.pcb, Plasma_Gen_Transformer_SCH_V2.0_20180324.sch]
2018-03-26 [Pipette] Battery CON review - 한신단자공업 contact 필요
2018-03-26 [Pipette] Design review
    [Plasma_Gen_Pipette_Main_PCB_V1.0_20180223.pcb]
2018-03-27 [Femto] Pipette ME 형상 release - 4/1 meeting 자료
2018-03-27 [Pipette] DC Jack 추가
    [Plasma_Gen_Pipette_Main_PCB_V1.0_20180223.pcb, Plasma_Gen_Pipette_Main_SCH_V1.0_20180223.sch]
2018-03-28 [Pipette] SCH, PCB V1.0 완료 - Gerber 작업 필요
    [Plasma_Gen_Pipette_Main_PCB_V1.0_20180223.pcb, Plasma_Gen_Pipette_Main_SCH_V1.0_20180223.sch]
2018-03-29 [Pipett] 하네스 BOM 및 Datasheet update
    [Femto Project schedule V1.0.xlsx, Plasma_Gen_Issue Note.xlsx, Plasma_Gen_Pipette_Main_PCB_V1.0_20180223.pcb, Plasma_Gen_Pipette_Main_SCH_V1.0_20180223.sch, Plasma_Gen_Pipette_하네스_BOM_V1.0_20180313A.xlsx]
2018-03-29 [Pipette] SCH v1.0 BOM update
    [Plasma_Gen_Pipette_Main_BOM_V1.0_20180329.xlsx]
2018-03-29 [Pipette] SCH & PCB 수정 - DC Jack Top 방향 배치
    [Plasma_Gen_Pipette PCB 형상_top.dxf, Plasma_Gen_Pipette_Main_PCB_V1.0_20180223.pcb, Plasma_Gen_Pipette_Main_SCH_V1.0_20180223.sch]
2018-03-29 [Pipette] Transformer 구조 Update - DC Jack 삭제
    [Plasma_Gen_Transformer_SCH_V2.0_20180324.sch]
2018-03-30 [Pipette] Transformer 구조 update
    [Plasma_Gen_Issue Note.xlsx, Plasma_Gen_Transformer_Part List_V2.0.xlsx, Plasma_Gen_Transformer_SCH_V2.0_20180324.pcb, Plasma_Gen_Transformer_SCH_V2.0_20180324.sch]
2018-03-31 [DOC] cost update
    [Plasma_Gen_Device cost.xlsx]
2018-04-01 [Pipette] Block diagram update
2018-04-01 [Pipette] Battery CON 검토 Part 추가
    [Femto Project schedule V1.0.xlsx, Plasma_Gen_Device cost.xlsx, Plasma_Gen_Pipette_Main_BOM_V1.0_20180329.xlsx]
2018-04-02 [DOC] 일정 및 비용 release 4/2
    [Femto Project schedule V1.0_20180402.xlsx]
2018-04-02 [DOC] 일정 및 S/W 개발 비용 update
    [Femto Project schedule V1.0.xlsx, Plasma_Gen_Device cost.xlsx]
2018-04-02 [Pipette] Transformer V2.0 1차 완료
    [Plasma_Gen_Transformer_Part List_V1.0.xlsx, Plasma_Gen_Transformer_Part List_V2.0.xlsx, Plasma_Gen_Transformer_Part List_V2.0_Old.xlsx, Plasma_Gen_Transformer_SCH_V2.0_20180324.pcb, Plasma_Gen_Transformer_SCH_V2.0_20180324.sch]
2018-04-02 [DOC] Project 비용 list 작성
    [Femto Project 비용 List.xlsx]
2018-04-02 [Pipette] Main V1.0 Datasheet 정리
2018-04-02 [Pipette] Main V1.0 하네스 datasheet 정리
2018-04-02 [Pipette] review Part의 datasheet를 Review folder에 정리
2018-04-02 [Pipette] Transformer V2.0 Datasheet 정리
2018-04-02 [Pipette] Battery Connector 추가 - solder cap type
    [Femto Project 비용 List.xlsx, Plsma Pipette Review Data.xlsx]
2018-04-03 [Pipette] DC Jack 추가, file name 통일
    [Femto Project schedule V1.0.xlsx, Plasma_Gen_Issue Note.xlsx, Plasma_Gen_MCU_PinMap_20171227.xlsx, Plasma_Gen_Pipette PCB 형상_top.dxf, Plasma_Gen_Pipette_Main_BOM_V1.0_20180313.xlsx, Plasma_Gen_Pipette_Main_BOM_V1.0_20180313A.xlsx, Plasma_Gen_Pipette_Main_BOM_V1.0_20180329.xlsx, Plasma_Gen_Pipette_Main_PCB_V1.0_20180223.pcb]
2018-04-03 [DOC] 4/3일 부품 및 장비 구매 목록 update
    [Femto Project 비용 List.xlsx, Plasma_Gen_Device cost.xlsx]
2018-04-03 [DOC] 일정 update
    [Femto Project schedule V1.0.xlsx]
2018-04-03 [Pipette] BD에 GND Jack 추가
2018-04-03 [DOC] Femto 진행 item 추가
    [Plasma_Gen_Issue Note.xlsx]
2018-04-06 [DOC] 수삽 비용 table 추가
    [Femto Project 비용 List.xlsx]
2018-04-08 [DOC] 실험실 비품 구매 목록 update
    [Femto Project 비용 List.xlsx]
2018-04-09 [DOC] LF GEN 일정 및 비용 update
    [Femto Project schedule V1.0.xlsx, Femto Project 비용 List.xlsx]
2018-04-09 [DOC] GEN MCU PCB 견적 update
2018-04-18 [DOC] 4/3,4/10 구매 목록 입고 상태 update
    [Femto Project 비용 List.xlsx]
2018-04-18 [Pipette] Transformer SCH update
    [Plasma_Gen_Transformer_Part List_V2.0.xlsx, Plasma_Gen_Transformer_SCH_V2.0_20180324.sch]
2018-04-20 [DOC] LF GEN MCU 제작비용 update
    [Femto Project 비용 List.xlsx]
2018-04-22 [Pipette] Booster 9.8V 설정치 update
2018-04-22 [DOC] 구매 부품 list update and Sample 대장 update
    [Femto Project sample management.xlsx, Femto Project 비용 List.xlsx]
2018-04-23 [DOC] 기구 일정 update
    [Femto Project schedule V1.0.xlsx]
2018-04-23 [DOC] GEN MCU sample update
    [Femto Project sample management.xlsx, Femto Project 비용 List.xlsx]
2018-04-23 [DOC] 기구 일정에 맞춰 다른 Project 일정 조정
    [Femto Project schedule V1.0.xlsx]
2018-04-24 [개인] 퇴사관련 자료 update
    [퇴직 준비.xlsx]
2018-04-24 [개인] 퇴사 관련 자료
    [퇴직 준비.xlsx]
2018-04-24 [DOC] Pipette schedule update
    [Femto Project schedule V1.0.xlsx]
2018-04-25 [개인]
    [사내연락망_20180312.xlsx, 퇴직 준비.xlsx]
2018-04-26 [개인] 체당금 서식 추가
    [퇴직 준비.xlsx]
2018-04-26 [DOC] LF GEN Main 일정 조정
    [Femto Project schedule V1.0.xlsx]
2018-04-27 [Proto] F/W source update
    [Plasma_Gen_Functioin List_20171207.xlsx, Plasma_Gen_MCU_PinMap_20171211.xlsx, Plasma_Gen_MCU_PinMap_20171227.xlsx]
2018-04-29 [DOC] Pipette Proto type PCB 견적서 추가
2018-04-29 [Pipette] 기구업체에 data 전달
    [Plasma_Pipette_V1.0_Main_BOM_ME용.xlsx, Plasma_Pipette_V1.0_Main_PCB_bottom.dwg, Plasma_Pipette_V1.0_Main_PCB_bottom_2007.dwg, Plasma_Pipette_V1.0_Main_PCB_top.dwg, Plasma_Pipette_V1.0_Main_PCB_top_2007.dwg]
2018-04-29 [Pipette] Main PCB V1.0 Gerber release
2018-04-29 [Pipette] Main PCB V1.0 완료
    [Plasma_Pipette_V1.0_Main_BOM.xlsx, Plasma_Pipette_V1.0_Main_PCB.dxf, Plasma_Pipette_V1.0_Main_PCB.pcb, Plasma_Pipette_V1.0_Main_PCB_bottom.dxf, Plasma_Pipette_V1.0_Main_SCH.sch, Plasma_Pipette_V1.0_하네스_BOM.xlsx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]
2018-04-29 [DOC] 견적 추가
2018-04-29 [Transformer] SCH & PCB V1.0 Done
    [Plasma_Gen_Transformer_SCH_V2.0_20180324.pcb, Plasma_Gen_Transformer_SCH_V2.0_20180324.sch]
2018-04-29 [Pipette] 자료 정리
    [Femto Project 비용 List.xlsx, Plasma_Gen_Issue Note.xlsx, Plasma_Pipette Review Data.xlsx, Plsma Pipette Review Data.xlsx]
2018-04-30 [개인] E-mail data added
2018-04-30 [Pipette] V1.0 Gerber 재송부 - bottom error 수정
    [Femto Project 비용 List.xlsx, Plasma_Pipette_V1.0_Main_PCB.pcb]
2018-04-30 [Data] ME업체에 전달한 ME 형상
2018-04-30 [Pipette] Block diagram update 및 파일 정리
    [Plasma_Gen_Block Diagram_20171207.dwg, Plasma_Gen_Block Diagram_20171207.dxf, 새 PADS Layout Design.pcb]
2018-04-30 [Pipette] 사용시간 계산 추가
    [Plasma_Pipette Review Data.xlsx]
2018-05-01 [Pipette]JTAG SCH & PCB 작성
    [Plasma_Pipette_JTAG_PCB_V1.0.pcb, Plasma_Pipette_JTAG_SCH_V1.0.sch]
2018-05-01 [Pipette] JTAG PCB 설계
    [Femto Project schedule V1.0.xlsx, Plasma_Pipette_JTAG_PCB_V1.0.pcb, Plasma_Pipette_JTAG_SCH_V1.0.sch]
2018-05-02 [Pipette] ** JTAG PCB 완료 **
    [Plasma_Pipette_JTAG_BOM_V1.0.xlsx, Plasma_Pipette_JTAG_PCB_V1.0.pcb, Plasma_Pipette_JTAG_SCH_V1.0.sch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]
2018-05-03 [Pipette] File name modify
    [Plasma_Pipette_Transformer_Part List_V2.0.xlsx, Plasma_Pipette_Transformer_SCH_V1.0_20180205.pcb, Plasma_Pipette_Transformer_SCH_V1.0_20180205.sch, Plasma_Pipette_Transformer_SCH_V2.0_20180324.pcb, Plasma_Pipette_Transformer_SCH_V2.0_20180324.sch]
2018-05-03 [Pipette] Transformer V2.0 완료
    [Femto Project schedule V1.0.xlsx, Plasma_Pipette_Transformer_PCB_V1.0_20180205.pcb, Plasma_Pipette_Transformer_PCB_V2.0_20180324.pcb, Plasma_Pipette_Transformer_SCH_V2.0_20180324.pcb, Plasma_Pipette_Transformer_SCH_V2.0_20180324.sch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]
2018-05-03 [Pipette] Transformer ME data -업체 전달
    [Plasma_Pipette_Transformer_PCB_V2.0_20180324_ME.pcb, Plasma_Pipette_Transformer_PCB_V2.0_20180324_Top.dwg, Plasma_Pipette_Transformer_PCB_V2.0_20180324_bottom.dwg]
2018-05-03 [Pipette] Transformer 관련 기구업체 전달 자료
    [Plasma_Pipette_Transformer_Part List_V2.0_ME.xlsx]
2018-05-03 [Quote] Pipette Transformer PCB V2.0 견적
2018-05-03 [Pipette] metal mask data added
2018-05-03 [Quote] Pipette Layout 및 manual solder 견적 (femto 5/3 전달 file)
    [20180503_Pipette_Main_V1.0_Layout and manual Solder 비용.xlsx]
2018-05-06 [Pipette] JTAG PCB : 5ea, Transformer PCB : 5ea 제작
    [20180503_Pipette_Main_V1.0_Layout and manual Solder 비용.xlsx, Femto Project schedule V1.0.xlsx, Femto Project 비용 List.xlsx]
2018-05-06 [DOC]LF Gen work update
    [Femto Project schedule V1.0.xlsx]
2018-05-08 [GEN MAIN] working time update
    [Femto Project schedule V1.0.xlsx, Femto Project 비용 List.xlsx]
2018-05-12 [DOC] Schedule 및 Cost update
    [20180503_Pipette_Main_V1.0_Layout and manual Solder 비용_cancel.xlsx, 20180512_Pipette_Main_V1.0_Layout and manual Solder 비용.xlsx, Femto Project schedule V1.0.xlsx, Femto Project 비용 List.xlsx]
2018-05-12 [DOC] 구매 목록 update
    [Femto Project 비용 List.xlsx]
2018-05-13 [DOC] sample management update - Pipette v1.0/JTAG/Trans v2.0
    [Femto Project sample management.xlsx]
2018-05-15 [5/15] 6:00~11:40
    [Femto Project sample management.xlsx, Femto Project schedule V1.0.xlsx, Femto Project 비용 List.xlsx, Plasma_Pipette Review Data.xlsx, Plasma_Pipette_V1.0_FirmWare_manual.xlsx]
2018-05-16 [DOC] Common file 이동
    [Femto Project sample management.xlsx, Femto Project schedule V1.0.xlsx, Femto Project 비용 List.xlsx, Plasma_Pipette_Issue Note.xlsx]
2018-05-16 [Review] 하네스 current, 사용시간
    [Plasma_Pipette Review Data.xlsx, Plasma_Pipette_Issue Note.xlsx, Plasma_Pipette_Issue and ECO list.xlsx, Plasma_Pipette_V1.0_MCU_PinMap.xlsx]
2018-05-29 퇴직관련 문서 update
2018-05-30 체불금 계산 확정
    [체불관련 자료.xlsx]
2018-05-30 한부장과 통화 후 fix - 5/31 e-mail로 파일 입수 예정
    [체불관련 자료.xlsx]
2018-05-30 [Pipette] S/V 압력 Test update
    [Plasma_Pipette Review Data.xlsx]
2018-06-07 [F/W] Issue and Cube update
    [Plasma Pipette FW Issue list.xlsx]
2018-07-11 Battery CON datasheet
2018-07-13 [SCH&PCB] Down version file
2018-07-14 [Pipette] V2.0 Top 배치 완료
    [Plasma_Pipette_V2.0_Main_PCB_2.pcb, Plasma_Pipette_V2.0_Main_PCB_Bottom.dxf, Plasma_Pipette_V2.0_Main_PCB_Top.dxf, Plasma_Pipette_V2.0_Main_SCH.sch]
2018-07-21 [Pipette]20180717 ME data에 맞춰 Sch&PCB 작업 완료
    [2d_pcb_plasma.dxf, Logic0.sch, Logic1.sch, Plasma Pipette Main PCB_2D_ME.dxf, Plasma Pipette Main PCB_2D_ME.pcb, Plasma_Pipette_V2.0_Main_PCB.pcb, Plasma_Pipette_V2.0_Main_PCB_2.pcb, Plasma_Pipette_V2.0_Main_PCB_20180721.pcb]
2018-07-21 [MPD] 디지안 질문 사항
2018-07-24 [Pipette] Main V2.0 Gerber data
    [2d_pcb_plasma.dxf, Plasma Generator_Part List_V2.0_20171222.xlsx, Plasma_Gen_Issue and ECO list_20171218.xlsx, Plasma_Gen_Main Board_Portable_PCB_V2.0_20180120.pcb, Plasma_Gen_Main Board_Portable_SCH_V2.0_20180120.sch, Plasma_Pipette_Transformer_PCB_V3.0_20180724.pcb, Plasma_Pipette_Transformer_SCH_V3.0_20180724.sch, Plasma_Pipette_V2.0_Main_PCB_20180721.pcb]
2018-07-25 [Pipette] Main Sch 속성 수정 및 하네스 Pin table 작성
    [2d_pcb_plasma-180725-1.dxf, 2d_pcb_plasma-180725.dxf, 2d_pcb_plasma.dxf, Plasma Pipette V2.0 하네스_20180724.xlsx, Plasma_Pipette_V2.0_Main_SCH_20180721_회사.sch]
2018-07-25 [Pipette] Transformer PCB V3.0 설계 - 외곽라인 수정 필요
    [Plasma_Pipette_Transformer_PCB_V3.0_20180724.pcb, Plasma_Pipette_Transformer_SCH_V3.0_20180724.sch]
2018-07-25 [MPD]Initial Sch&PCB file 생성
    [MPD_V1.0_MCU_PinMap.xlsx, MPD_V1.0_Main_PCB_20180721_회사.pcb, MPD_V1.0_Main_SCH_20180721_회사.sch, MPD_V1.0_Main_SCH_20180725_company.sch]
2018-07-29 [Pipette]Main PCB 2D DATA
    [2d_pcb_plasma-180725-1_PCB.dxf, 2d_pcb_plasma-180725-1_PCB.pcb]
2018-07-29 [Pipette]Transformer PCB 2D Data
    [2d_pcb_plasma-180725_2D.dxf, 2d_pcb_plasma-180725_trans PCB.pcb]
2018-07-30 [Pipette]Main PCB ME 수정 자료 입수
    [2d_pcb_plasma-180730.dxf]
2018-07-30 [Pipette] Battery 2D Data
    [batt-180730.dxf]
2018-07-30 [Pipette] Battery reference data
2018-07-31 [Pipette] Main PCB ME 수정 사항 update
    [2D_PCB_PLASMA-180730_PCB.dxf, 2D_PCB_PLASMA-180730_PCB.pcb, 2d_pcb_plasma-180730.dxf]
2018-07-31 [Pipette] Main PCB V2.0 Gerber 작성
    [Plasma_Pipette_V2.0_Main_PCB_20180731_Company.pcb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]
2018-07-31 [Pipette] Transformer PCB ME 수정 사항 반영 및 Gerber 작성
    [Plasma_Pipette_Transformer_PCB_V3.0_20180724.pcb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]
2018-07-31 [Pipette] Main,Transformer PCB 2D data release
    [Logic0.sch, Logic1.sch, Plasma Pipette V2.0 하네스_20180724.xlsx, Plasma_Pipette_Transformer_PCB_V3.0_2D_Bottom.dxf, Plasma_Pipette_Transformer_PCB_V3.0_2D_Top.dxf, Plasma_Pipette_V2.0_Main_PCB_20180721_Bottom.dxf, Plasma_Pipette_V2.0_Main_PCB_20180721_Top.dxf, Plasma_Pipette_V2.0_Main_PCB_20180721_회사.pcb]
2018-08-05 [Pipette] MP Data 정리
    [Plasma_Pipette_Transformer_BOM_V3.0.xlsx, Plasma_Pipette_Transformer_SCH_V3.0_20180724.sch, Plasma_Pipette_Transformer_SCH_V3.0_20180805.sch, Plasma_Pipette_V2.0_Main_BOM.xlsx, Plasma_Pipette_V2.0_Main_BOM_20180805.xlsx, Plasma_Pipette_V2.0_Main_SCH_20180721_Company.sch, Plasma_Pipette_V2.0_Main_SCH_20180805.sch]
2018-09-17 [Pipette] Femto Battery data update
    [Battery review data.xlsx]
2018-10-09 [V2.0 Type2] Battery 변경에 따른 설계 변경 file - PADS VX2.3 file
    [Plasma_Pipette_V2.0_Main_PCB_20180731_Company.pcb, Plasma_Pipette_V2.0_Main_PCB_20181009_Bottom.dxf, Plasma_Pipette_V2.0_Main_PCB_20181009_Company.pcb, Plasma_Pipette_V2.0_Main_PCB_20181009_TOP.dxf, Plasma_Pipette_V2.0_Main_SCH_20180721_Company.sch, Plasma_Pipette_V2.0_Main_SCH_20181009_Company.sch]
2018-11-04 [MP] Pipette Main MP data update
    [Plasma Pipette V2.0 Main Part list_20181104.xlsx, Plasma_Pipette_V2.0_Main_PCB_20180731_Company.pcb, Plasma_Pipette_V2.0_Main_PCB_20181009_Bottom.dxf, Plasma_Pipette_V2.0_Main_PCB_20181009_Company.pcb, Plasma_Pipette_V2.0_Main_PCB_20181009_TOP.dxf, Plasma_Pipette_V2.0_Main_SCH_20180721_Company.sch, Plasma_Pipette_V2.0_Main_SCH_20181009_Company.sch, Plasma_Pipette_V2.0_Main_SCH_20181104_VX2.3.sch]
2018-11-04 [MP1]Pipette Transformer MP1 Data update
    [Plasma Pipette V2.0 Main Part list_20181104.xlsx, Plasma_Pipette_Transformer_BOM_V3.0.xlsx, Plasma_Pipette_Transformer_PCB_V3.0_20180724.pcb, Plasma_Pipette_Transformer_PCB_V3.0_2D_Bottom.dxf, Plasma_Pipette_Transformer_PCB_V3.0_2D_Top.dxf, Plasma_Pipette_Transformer_SCH_V3.0_20180805.sch, Plasma_Pipette_Transformer_V3.0_Part list_20181104.xlsx, Plasma_Pipette_V2.0_Main_PCB_20181009_Bottom.dxf]
2018-11-04 [Femto] MP1 data 전달 - w/o datasheet
2018-12-22 [Pipette] 12/21 femto meeting data 및 source
    [Plasma_Pipette_PP Issue list.xlsx]
2018-12-25 [Pipette] F/W debugging, Manual 작성
    [Pipette Download manual_20181225.xlsx, Plasma_Gen_debug manual.xlsx, Plasma_Pipette_PP Issue list.xlsx]
2019-01-01 [Pipette] 검토 data update
    [Pipette Change list MP2.xlsx, Plasma Pipette V2.0 Main Part list_20181104.xlsx, Plasma Project schedule V1.0.xlsx, Plasma_Pipette_PP Issue list.xlsx, Plasma_Pipette_Transformer_PCB_V4.0_20181226.pcb, Plasma_Pipette_Transformer_SCH_V4.0_20181226.sch, Plasma_Pipette_Transformer_V3.0_Part list_20181104.xlsx, Plasma_Pipette_V3.0_Main_PCB_20181226_VX2.3.pcb]
2019-01-03 [Pipette] F/W update
2019-01-05 [Pipette]Issue 및 ECO Update - SCH & PCB update 필요함.
    [Plasma_Pipette_PP Issue list.xlsx]
2019-01-05 [Pipette] 1/5 work update
    [Plasma Project schedule V1.0.xlsx]
2019-01-05 [Pipette] Issue update
    [Plasma_Pipette_PP Issue list.xlsx]
2019-01-18 [Pipette] MP2 data update
    [Pipette Change list MP2.xlsx, Plasma_Pipette_Transformer_PCB_V4.0_20181226.pcb, Plasma_Pipette_V3.0_Main_PCB_20181226_VX2.3.pcb, Plasma_Pipette_V3.0_Main_PCB_20190113_VX2.3.pcb, Plasma_Pipette_V3.0_Main_SCH_20181226_VX2.3.sch, Plasma_Pipette_V3.0_Main_SCH_20190113_VX2.3.sch, Plasma_Pipette_V3.0_Main_SCH_20190115_VX2.3.sch]
2019-01-18 [Pipette] F/W 작업분 update
    [Plasma Pipette FW Issue list.xlsx]
2019-01-18 [MPD] Design Data update
    [MPD_Review Data_20190117.xlsx]
2019-02-12 [DOC] Pipette, RF Gen work update
    [Plasma Project schedule V1.0.xlsx]
2019-02-26 [Pipette] V3.0 SCH,PCB,BOM 수정
    [Pipette Change list MP2.xlsx, Plasma Pipette V3.0 Main Part list_20190226.xlsx, Plasma Project schedule V1.0.xlsx, Plasma_Pipette_PP Issue list.xlsx, Plasma_Pipette_V3.0_Main_PCB_20190113_V9.5.pcb, Plasma_Pipette_V3.0_Main_PCB_20190226_V9.5.pcb, Plasma_Pipette_V3.0_Main_SCH_20190115_V9.5.sch, Plasma_Pipette_V3.0_Main_SCH_20190226_V9.5.sch]
2019-03-06 [MP2] MP2 Trans data 작업 및 Release
    [Logic0.sch, Pipette Change list MP2.xlsx, Pipette Transformer 사양서_20190302.xlsx, Plasma Project schedule V1.0.xlsx, Plasma_Pipette_Transformer_PCB_V4.0_20181226.pcb, Plasma_Pipette_Transformer_PCB_V4.0_20190306.pcb, Plasma_Pipette_Transformer_SCH_V4.0_20181226.sch, Plasma_Pipette_Transformer_SCH_V4.0_20190306.sch]
2019-03-15 [MP2]Main PCB 수정 - 기구 사항 반영
    [Logic0.sch, Pipette Change list MP2.xlsx, Plasma Pipette V3.0 Main Part list_20190316.xlsx, Plasma Project schedule V1.0.xlsx, Plasma_Pipette_Transformer_SCH_V4.0_20190306.sch, Plasma_Pipette_V3.0_Main_PCB_20190302_V9.5.pcb, Plasma_Pipette_V3.0_Main_PCB_20190315_V9.5.pcb, Plasma_Pipette_V3.0_Main_SCH_20190302_V9.5.sch]
2019-04-03 Company Data upload
    [Plasma Project schedule V1.0_C.xlsx, Plasma_Pipette_PP Issue list_C.xlsx]
2019-04-03 F/W 작업
    [Pipette SW Revision history.xlsx]
2019-04-11 [MP2] Test
    [Pipette MP2 Test Resutls.xlsx, Plasma_Pipette_V3.0_Main_SCH_20190316_V9.5.sch]
2019-04-11 [MP3] 1차 수정 완료 - 4/12 confirm후 gerber 진행
    [Pipette Change list MP3.xlsx, Plasma_Pipette_V4.0_Main_PCB_20190411_V9.5.pcb, Plasma_Pipette_V4.0_Main_SCH_20190411_V9.5.sch, ay_pcb_plasma-20190411.dxf]
2019-04-11 [F/W] LEVEL LED - Power off시 같이 커지도록 수정
    [Pipette SW Revision history.xlsx]
2019-04-15 [MP data] V4.0 update
    [Plasma Project schedule V1.0.xlsx, Plasma_Pipette_V4.0_Main_PCB_20190411_V9.5.pcb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]
2019-05-08 [V4.0]SMT issue update
    [Plasma Pipette V4.0 SMT issue_20190508.xlsx]
2019-05-08 [Pipette] V4.0 SMT issue
    [Plasma Project schedule V1.0.xlsx]
2019-05-20 MP4 Data update
    [Pipette Change list MP4.xlsx, Plasma Pipette V5.0 Main Part list_20190521.xlsx, Plasma_Pipette_V5.0_Main_PCB_20190521.pcb, Plasma_Pipette_V5.0_Main_SCH_20190521.sch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]
2019-05-20 4.1V Full charge 수정
    [Pipette SW Revision history.xlsx, Plasma_Pipette Review Data.xlsx]
2019-06-16 MP4 V5.1 Data update - Key 인식 오류 개선
    [Pipette Change list MP4.xlsx]
2019-07-04 [MPD] data update
    [MPD_V1.1_Main_SCH_20190617.sch, Plasma Project schedule V1.0.xlsx, Plasma_Pipette_V5.0_Main_PCB_20190521.pcb, Plasma_Pipette_V5.1_Main_SCH_20190610.sch]
2019-07-07 [MPD]PCB 2D update
    [2D_PCB_MPD_KEY-190705.pcb, 2D_PCB_MPD_LED-190705.pcb, 2D_PCB_MPD_MAIN-190705.pcb, Plasma Project schedule V1.0_C.xlsx]
2019-07-08 [MPD]회로 및 PCB 작업
    [2D_PCB_MPD-190705.dxf, 2D_PCB_MPD-190708.dxf, 2D_PCB_MPD-190708_KEY.dxf, 2D_PCB_MPD-190708_KEY.pcb, 2D_PCB_MPD-190708_LED.dxf, 2D_PCB_MPD-190708_LED.pcb, 2D_PCB_MPD-190708_MAIN.dwg, 2D_PCB_MPD-190708_MAIN.dxf]
2019-07-14 [MPD] Sch and PCB update - company work
    [MPD_Review Data_20190117.xlsx, MPD_V1.0_KEY_SCH_20190708.sch, MPD_V1.0_Main_PCB_20190708.pcb, MPD_V1.0_Main_PCB_20190714.pcb, MPD_V1.0_Main_SCH_20190714A.sch]
2019-07-17 [MPD]Main Artwork
    [MPD_V1.0_KEY_PCB_20190708.pcb, MPD_V1.0_LED_PCB_20190708.pcb, MPD_V1.0_Main_PCB_20190708.pcb, MPD_V1.0_Main_PCB_20190714.pcb, MPD_V1.0_Main_SCH_20190714.sch, MPD_V1.0_Main_SCH_20190714A.sch, Plasma Project schedule V1.0.xlsx]
2019-07-18 [MPD]Main PCB update
    [MPD_V1.0_Main_PCB_20190708.pcb, MPD_V1.0_Main_PCB_20190714.pcb, MPD_V1.0_Main_PCB_20190714B.pcb, MPD_V1.0_Main_PCB_20190714B_TOP.dxf, MPD_V1.0_Main_PCB_20190717.pcb, MPD_V1.0_Main_SCH_20190714.sch, MPD_V1.0_Main_SCH_20190714A.sch, MPD_V1.0_Main_SCH_20190714B.sch]
2019-07-24 [MPD]3D Data update - ME
    [2D_PCB_MPD-190724.dxf]
2019-07-24 [MPD]PCB 배치 재검토 - ME 요청
    [MPD_V1.0_KEY_PCB_20190708.pcb, MPD_V1.0_KEY_PCB_20190708_Bottom_투영뷰.dxf, MPD_V1.0_KEY_PCB_20190708_TOP.dxf, MPD_V1.0_KEY_SCH_20190714.sch, MPD_V1.0_LED_PCB_20190708.pcb, MPD_V1.0_LED_PCB_20190708_Bottom_투영뷰.dxf, MPD_V1.0_LED_PCB_20190708_TOP.dxf, MPD_V1.0_Main_PCB_20190724.pcb]
2019-07-27 [MPD]Replacement Done - ref 정리 필요
    [MPD_V1.0_Main_PCB_20190727.pcb]
2019-08-07 [MPD] V1.0 완료
    [2D_PCB_MPD-190724_KEY.dwg, 2D_PCB_MPD-190724_KEY.dxf, 2D_PCB_MPD-190724_KEY.pcb, MPD Block Diagram.xlsx, MPD LED_PCB PL_V1.0_20190807.xlsx, MPD MAIN PCB PL V1.0_20190807.xlsx, MPD-KEY_PCB PL V1.0_20190807.xlsx, MPD-KEY_PCB_V1.0_20190807.pcb]
2019-09-08 [MPD V1.0] Release
    [2D_PCB_MPD_KEY-190705.pcb, 2D_PCB_MPD_LED-190705.pcb, 2D_PCB_MPD_MAIN-190705.pcb, MPD LED_PCB PL_V1.0_20190807.xlsx, MPD MAIN PCB PL V1.0_20190807.xlsx, MPD-KEY_PCB PL V1.0_20190807.xlsx, MPD-KEY_PCB_V1.0_20190807.pcb, MPD-KEY_SCH_V1.0_20190807.sch]
2019-09-08 [MPD] V1.0 debugging Start
    [MPD Block Diagram.xlsx, MPD_Review Data_20190117.xlsx, MPD_V1.0_KEY_PCB_20190708.pcb, MPD_V1.0_KEY_PCB_20190708_Bottom_투영뷰.dxf, MPD_V1.0_KEY_PCB_20190708_TOP.dxf, MPD_V1.0_KEY_SCH_20190708.sch, MPD_V1.0_KEY_SCH_20190714.sch, MPD_V1.0_LED_PCB_20190708.pcb]
2019-09-09 [F/W] V0.2 LED High active로 수정
    [Plasma_state.c, gpio.c]
2019-09-09 [F/W] V3.0 Level Power OFF시 Level LED OFF로 Setting
2019-09-15 [F/W] V4.0 Vext level 조정 : 4V ~ 5.5V
2019-09-16 [MAIN] VBAT ADC tune
    [MPD Issue and Change list_V1.0.xlsx, MPD MAIN PCB PL V1.0_20190807.xlsx, MPD MAIN PCB PL V2.0_20190915.xlsx, MPD-MAIN_SCH_V2.0_20190915.sch]
2019-09-16 [F/W] V1.0 fixed : VBAT ADC debugging 필요
    [gpio.c]
2019-09-22 [MPD]H/W V1.0 마무리
    [MPD Block Diagram.xlsx, MPD Issue and Change list_V1.0.xlsx, MPD V1.0 수정 사항_20190922.xlsx, MPD-MAIN_PCB_V1.0_20190807.pcb, MPD-MAIN_PCB_V1.0_20190922.pcb, MPD-MAIN_SCH_V1.0_20190807.sch, MPD-MAIN_SCH_V2.0_20190915.sch, MPD-MAIN_SCH_V2.0_20190922.sch]
2019-10-24 [F/W release] 2019.10.24 Femto 전달 Source
2019-10-24 [F/W release] File name 수정
    [Buzzer_state.c, Buzzer_state.h, Chargecli.c, Chargetask_charge.c, Chargetask_full.c, Chargetask_init.c]
2019-10-24 [Pipette] F/W final version backup
2019-11-21 [MPD]PL and SCH miss check - 수정 필요
    [MPD MAIN PCB PL V2.0_20190915_수정필요.xlsx]
2019-11-21 [MPD]PL and SCH miss update
    [MPD Issue and Change list_V1.0.xlsx, MPD MAIN PCB PL V2.0_20190915_수정필요.xlsx, MPD MAIN PCB PL V2.0_20191121.xlsx, MPD-MAIN_PCB_V1.0_20190922.pcb, MPD-MAIN_PCB_V2.0_20190922.pcb, MPD-MAIN_SCH_V2.0_20190922.sch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]
2019-11-24 [MPD]11/24 Main PL miss 수정
    [MPD MAIN PCB PL V2.0_20190915_수정필요.xlsx, MPD MAIN PCB PL V2.0_20191121.xlsx, MPD MAIN PCB PL V2.1_20191124.xlsx, MPD-MAIN_PCB_V1.0_20190807.pcb, MPD-MAIN_PCB_V2.0_20190922.pcb, MPD-MAIN_SCH_V2.0_20190922.sch]
2020-03-04 [Pipette]Modify Version folder 생성
    [Plasma Pipette V5.1 Main Part list_20190610.xlsx, Plasma Pipette_C-Change list_20200304.xlsx, Plasma_Pipette_C_Main-001_PCB_20200304.pcb, Plasma_Pipette_C_Main-001_SCH_20200304.sch, Plasma_Pipette_V5.0_Main_PCB_20190521.pcb, Plasma_Pipette_V5.1_Main_SCH_20190610.sch]
2020-03-05 F/W update
    [Plasma Pipette_C-Change list_20200304.xlsx, Plasma_Pipette_C_Main-001_PCB_20200304.pcb, Plasma_Pipette_C_Main-001_PCB_20200305.pcb, Plasma_Pipette_C_Main-001_SCH_20200304.sch, Plasma_Pipette_C_Main-001_SCH_20200305.sch]
2020-04-06 Binary 정리하여 Femto에 release
    [Pipette SW Revision history.xlsx]
2020-04-06 Femto release list 정리
    [MPD V1.0 수정 사항_20190922.xlsx]
2020-04-06 Femto release data update - MPD
    [Femto_자료 전달 List.xlsx]
2020-04-06 Femto release Data 정리 및 MAIN PCB 수정
    [MPD Issue and Change list_V1.0.xlsx, MPD MAIN PCB PL V2.0_20190915.xlsx, MPD MAIN PCB PL V2.1_20191124.xlsx, MPD MAIN PCB PL V2.1_20200406.xlsx, MPD-MAIN_PCB_V2.0_20190922.pcb, MPD-MAIN_PCB_V2.0_20200406.pcb, MPD-MAIN_SCH_V2.0_20190915.sch, MPD-MAIN_SCH_V2.0_20190922.sch]
2020-04-15 [MPD]Plasma On Key 동작을 Push 상태에서만 On 되도록 수정(Pipette과 동일)
    [InEventProcess.c]
2020-04-15 [MPD]Gas On후 Plasma On delay : 1sec
2020-04-15 [Pipette/MPD]요청 Binary release
    [Femto_자료 전달 List.xlsx]
