ArvidJoung/Plasma_Generator/(notices)

Notices in the files:
3_Plasma_Pipette_C/3_Firmware/Source_20191024/plasma_pt/Src/Application/CliTask/consolcli.c:
FreeRTOS is free software; you can redistribute it and/or modify it under
the terms of the GNU General Public License (version 2) as published by the
Free Software Foundation >>!AND MODIFIED BY!<< the FreeRTOS exception.
