ArvidJoung/Plasma_Generator/0_DOC/20180207_Femto 요청자료_사진/Plsma_Gen_Transformer Top.jpg

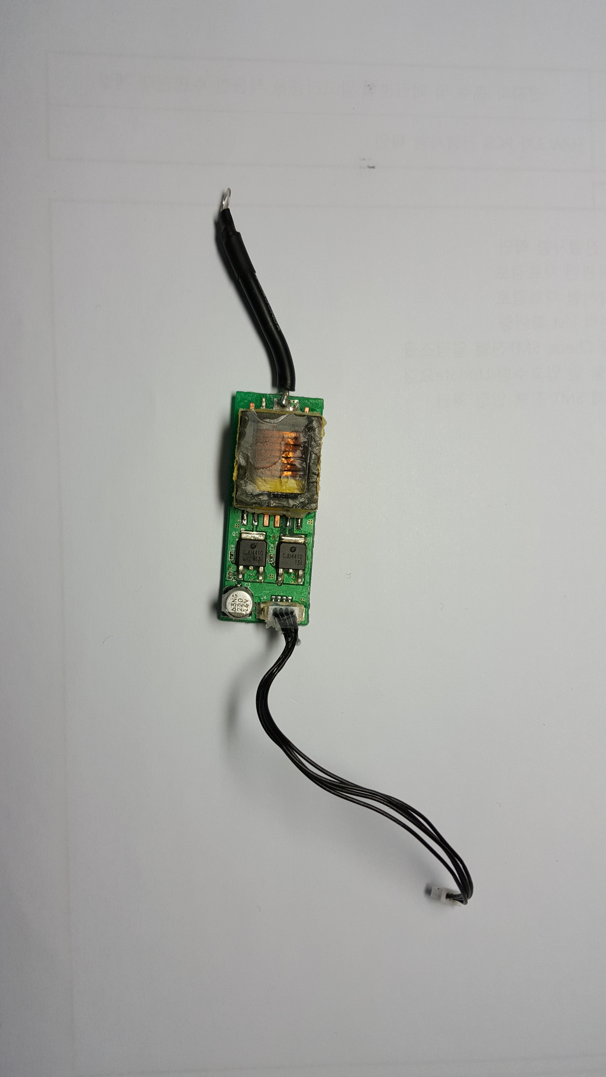
0_DOC/20180207_Femto 요청자료_사진/Plsma_Gen_Transformer Top.jpg
