ArvidJoung/Plasma_Generator/1_Plasma_Pipette/3_Firmware/20181225_135907.jpg

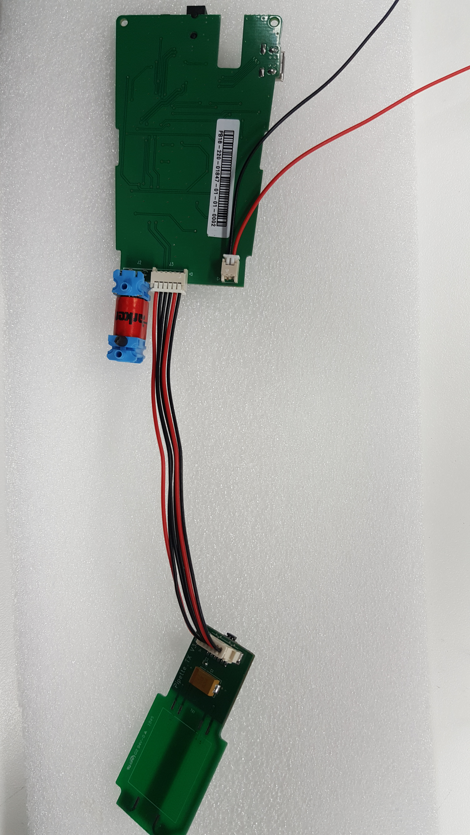
1_Plasma_Pipette/3_Firmware/20181225_135907.jpg
