ArvidJoung/Plasma_Generator/1_Plasma_Pipette/4_Review data/하네스 사진/20180516_141527.jpg

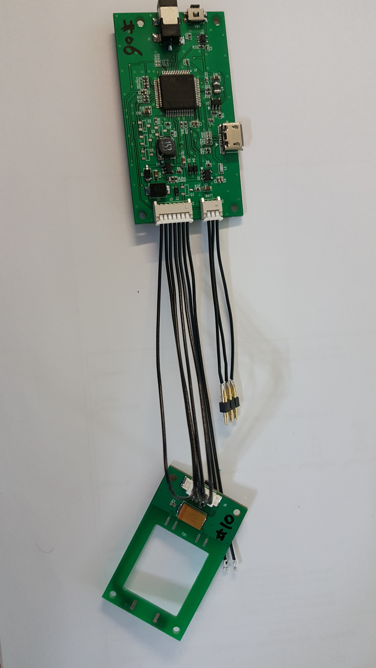
1_Plasma_Pipette/4_Review data/하네스 사진/20180516_141527.jpg
